PURPL-Purdue/Turbopump/README.md

#### Welcome to the TurboPump Repo

[TODO] Finish REAMDE.md
