PURPL-Purdue/Turbopump/MARLIN V2/MARLIN ECU/Hardware/README.md

# Summary
This folder will be used to store everything MARLIN hardware related
### Here you will find:
- PCB files
- Some light documentation
