PURPL-Purdue/Turbopump/MARLIN V2/MARLIN ECU/Software/README.md

# Summary
This folder will be used to store everything MARLIN software related
### Here you will find:
- Milestone projects to spin up the software crew
- Codebase for the actual MARLIN ECU
