PURPL-Purdue/Turbopump/Pump Assembly/Pumps/CFD/LoxPumpReports/LoxPump2.htm

ANSYS Logo

Title

Pump Report

Date

2025/01/10 03:52:40

# Contents

1. Pictures
Figure 1 Iso View of Wireframe
Chart 1 Component 2 blade loading chart
Chart 2 Component 2 chart showing circumferentially averaged flow angle at the LE
Chart 3 Component 2 chart showing circumferentially averaged flow angle at the TE
Chart 4 Component 2 chart showing circumferentially averaged Cm at the TE
Chart 5 Component 3 blade loading chart
Chart 6 Component 3 chart showing circumferentially averaged flow angle at the LE
Chart 7 Component 3 chart showing circumferentially averaged flow angle at the TE
Chart 8 Component 3 chart showing circumferentially averaged Cm at the TE
Chart 9 Chart showing streamwise, area averaged Cm versus averaged normalized M.
1.1. Blade Loading Charts
2. Component Charts
3. Component Summary Data
4. Introduction
5. Meanline 1-D Charts
5.1. Overall Performance Results
6. Performance Results
6.1. Spanwise Charts
6.2. Stage 1 Plots
6.3. Stage 2 Plots
6.4. Stage 3 Plots
6.5. Stage Performance Results
7. Stage Plots
Table 1 Component 1 Summary Data Table
Table 2 Component 2 Summary Data Table
Table 3 Component 3 Summary Data Table
Table 4 Overall Performance Results Table
Table 5 Stage 1 Performance Results
Table 6 Stage 2 Performance Results
Table 7 Stage 3 Performance Results
Figure 2 Complete meridional view of the flow passage and blades
Figure 3 Stage 1 contours of circumferentially area-averaged Cm
Figure 4 Stage 1 contours of circumferentially area-averaged P
Figure 5 Stage 1 contours of P at 50% span
Figure 6 Stage 1 contours of Ptr at 50% span
Figure 7 Stage 1 meridional view of the flow passage and blades
Figure 8 Stage 1 velocity vectors at 50% span
Figure 9 Stage 2 contours of circumferentially area-averaged Cm
Figure 10 Stage 2 contours of circumferentially area-averaged P
Figure 11 Stage 2 contours of P at 50% span
Figure 12 Stage 2 contours of Ptr at 50% span
Figure 13 Stage 2 meridional view of the flow passage and blades
Figure 14 Stage 2 velocity vectors at 50% span
Figure 15 Stage 3 contours of circumferentially area-averaged Cm
Figure 16 Stage 3 contours of circumferentially area-averaged P
Figure 17 Stage 3 contours of P at 50% span
Figure 18 Stage 3 contours of Ptr at 50% span
Figure 19 Stage 3 meridional view of the flow passage and blades
Figure 20 Stage 3 velocity vectors at 50% span
8. Tabulated Results
Table 8 Performance Results
Table 9 Summary Data
9. Streamwise Charts
Chart 10 Streamwise Plot of Pt and Ps
Chart 11 Streamwise Plot of C
Chart 12 Streamwise Plot of W
Chart 13 Streamwise Plot of Alpha and Beta
Chart 14 Spanwise Plot of Alpha and Beta at LE
Chart 15 Spanwise Plot of Alpha and Beta at TE
10. Blade Geometry Plots
Figure 21 Isometric 3D View of the Blade, Hub and Shroud
Figure 22 Meridional View of the Blade, Hub and Shroud
11. Blade Mesh Plot
Figure 23 Mesh Elements at 50% Span
12. Blade to Blade Plots
Figure 24 Contour of Pt at 50% Span
Figure 25 Contour of Ptr at 50% Span
Figure 26 Contour of Ps at 50% Span
Figure 27 Contour of W at 50% Span
Figure 28 Velocity Vectors at 20% Span
Figure 29 Velocity Vectors at 50% Span
Figure 30 Velocity Vectors at 80% Span
13. Meridional Plots
Figure 31 Contour of Mass Averaged Pt on Meridional Surface
Figure 32 Contour of Mass Averaged Ptr on Meridional Surface
Figure 33 Contour of Mass Averaged W on Meridional Surface
Figure 34 Vector of Area Averaged Cm on Meridional Surface
14. Circumferential Plots
Figure 35 Contour of Pt at Blade LE
Figure 36 Contour of Ptr at Blade LE
Figure 37 Contour of W at Blade LE
Figure 38 Contour of Pt at Blade TE
Figure 39 Contour of Ptr at Blade TE
Figure 40 Contour of W at Blade TE
15. Streamline Plot
Figure 41 Velocity Streamlines at Blade TE

# 1. Pictures

Figure 1. Iso View of Wireframe

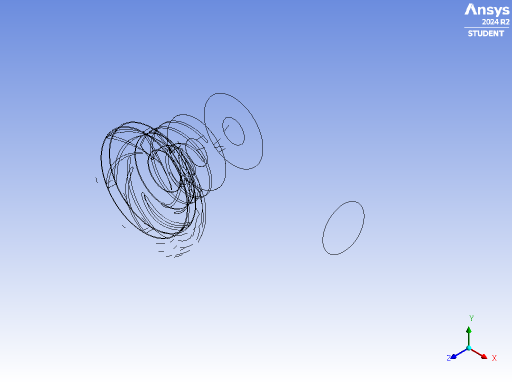
[picture p1: Pump Assembly/Pumps/CFD/LoxPumpReports/LoxPump2/Figure001.png]
Figure 1 - LoxPump2/Figure001.png


Chart 1. Component 2 blade loading chart

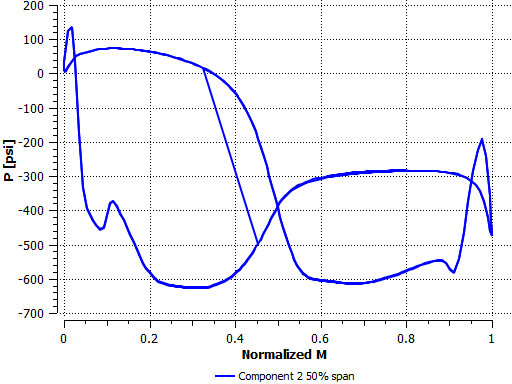
[picture p2: Pump Assembly/Pumps/CFD/LoxPumpReports/LoxPump2/Chart001.png]
Chart 1. LoxPump2/Chart001.png


Chart 2. Component 2 chart showing circumferentially averaged flow angle at the LE

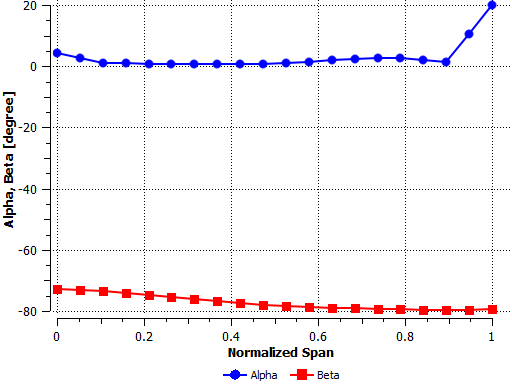
[picture p3: Pump Assembly/Pumps/CFD/LoxPumpReports/LoxPump2/Chart002.png]
Chart 2. LoxPump2/Chart002.png


Chart 3. Component 2 chart showing circumferentially averaged flow angle at the TE

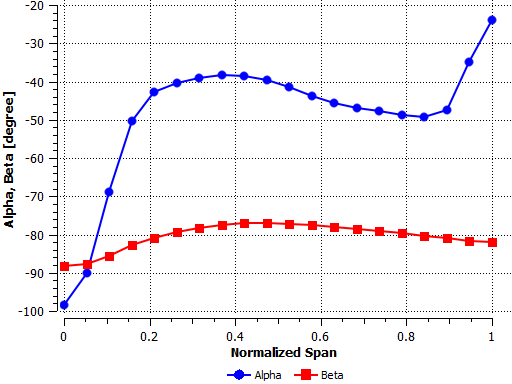
[picture p4: Pump Assembly/Pumps/CFD/LoxPumpReports/LoxPump2/Chart003.png]
Chart 3. LoxPump2/Chart003.png


Chart 4. Component 2 chart showing circumferentially averaged Cm at the TE

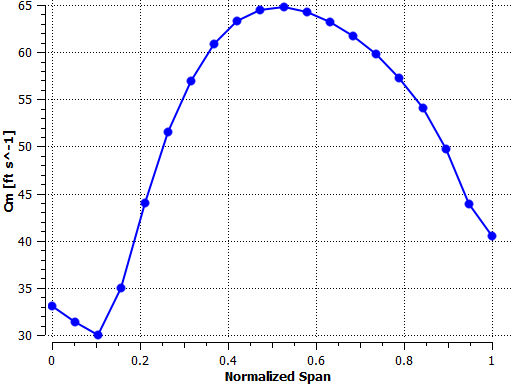
[picture p5: Pump Assembly/Pumps/CFD/LoxPumpReports/LoxPump2/Chart004.png]
Chart 4. LoxPump2/Chart004.png


Chart 5. Component 3 blade loading chart

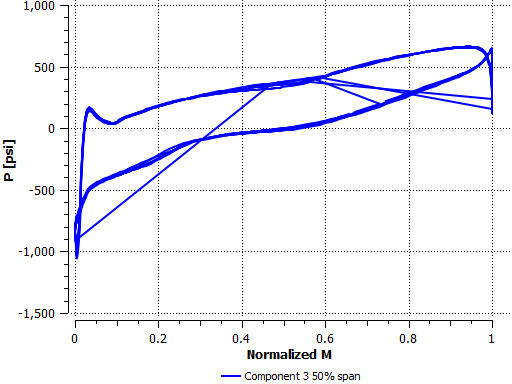
[picture p6: Pump Assembly/Pumps/CFD/LoxPumpReports/LoxPump2/Chart005.png]
Chart 5. LoxPump2/Chart005.png


Chart 6. Component 3 chart showing circumferentially averaged flow angle at the LE

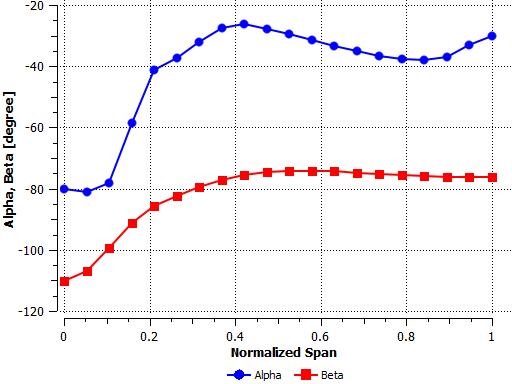
[picture p7: Pump Assembly/Pumps/CFD/LoxPumpReports/LoxPump2/Chart006.png]
Chart 6. LoxPump2/Chart006.png


Chart 7. Component 3 chart showing circumferentially averaged flow angle at the TE

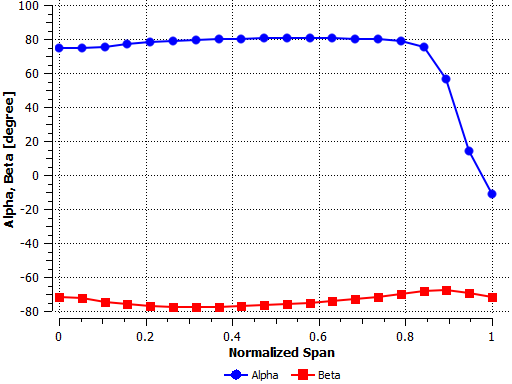
[picture p8: Pump Assembly/Pumps/CFD/LoxPumpReports/LoxPump2/Chart007.png]
Chart 7. LoxPump2/Chart007.png


Chart 8. Component 3 chart showing circumferentially averaged Cm at the TE

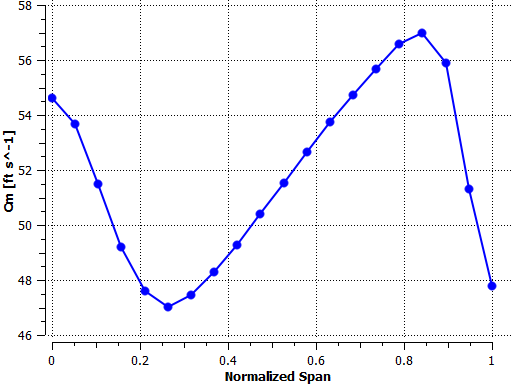
[picture p9: Pump Assembly/Pumps/CFD/LoxPumpReports/LoxPump2/Chart008.png]
Chart 8. LoxPump2/Chart008.png


Chart 9. Chart showing streamwise, area averaged Cm versus averaged normalized M.

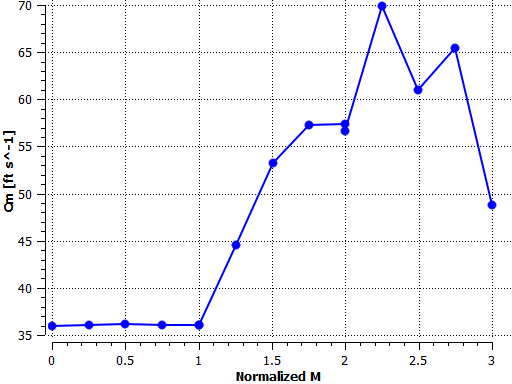
[picture p10: Pump Assembly/Pumps/CFD/LoxPumpReports/LoxPump2/Chart009.png]
Chart 9. LoxPump2/Chart009.png


## 1.1. Blade Loading Charts

The following charts show the blade loading for each component.

# 2. Component Charts

The following charts show blade loading and spanwise-averaged quantities for each component.

# 3. Component Summary Data

The table(s) below give a summary of the mass or area averaged solution variables and derived quantities computed at the inlet, leading edge (LE Cut), trailing edge (TE Cut) and outlet locations. The flow angles Alpha and Beta are relative to the meridional plane.

# 4. Introduction

This report summarizes the results of a CFD analysis performed for the pump geometry shown in Figure 1. In the following sections both quantitative and qualitative results are presented in the form of tables, charts and plots.

# 5. Meanline 1-D Charts

The following charts show streamwise mass or area averaged quantities from the inlet to the outlet of the full machine.

## 5.1. Overall Performance Results

The following table gives the overall performance for the machine.

# 6. Performance Results

The quantitative results are summarized in the following tables. The first table shows the overall performance. The next series of tables shows the performance results for each stage.

## 6.1. Spanwise Charts

The following charts show circumferentially averaged quantities along hub-to-shroud lines located at the leading and trailing edges of the blade.

## 6.2. Stage 1 Plots

## 6.3. Stage 2 Plots

## 6.4. Stage 3 Plots

## 6.5. Stage Performance Results

The following table(s) give a summary of the performance results for each stage.

# 7. Stage Plots

The following plots show, for each stage, a meridional view of the geometry, blade-to-blade contour and vector views, and circumferentially averaged meridional views.

Table 1. Component 1 Summary Data Table

Quantity | Inlet | Outlet | Out/In | Out-In | Units
Density | 71.2409 | 71.2409 | N/A | N/A | [lb ft^-3]
Pstatic | 40.0157 | 39.8570 | N/A | -0.1587 | [psi]
Ptotal | 49.9766 | 49.8830 | N/A | -0.0935 | [psi]
Head | 101.0180 | 100.8590 | N/A | -0.1586 | [foot]
Static Head | 80.8812 | 80.4489 | N/A | -0.4323 | [foot]
Cm | 35.9929 | 36.0295 | 1.0010 | 0.0366 | [ft s^-1]
Cu | -0.0033 | -0.0009 | 0.2902 | 0.0023 | [ft s^-1]
C | 35.9929 | 36.0522 | 1.0016 | 0.0593 | [ft s^-1]
Distortion Parameter | 1.0002 | 1.0099 | 1.0097 | N/A
Flow Angle | -0.0051 | -0.0036 | N/A | 0.0016 | [degree]

Table 2. Component 2 Summary Data Table

Quantity | Inlet | LE Cut | TE Cut | Outlet | TE/LE | TE-LE | Units
Density | 71.2409 | 71.2409 | 71.2409 | 71.2409 | N/A | N/A | [lb ft^-3]
Pstatic | 39.6156 | 34.3766 | -294.1310 | -305.3430 | N/A | -328.5070 | [psi]
Ptotal | 50.4130 | 50.9898 | -243.3580 | -258.1940 | N/A | -294.3480 | [psi]
Ptotal (rot) | 49.4896 | 46.0047 | -105.9780 | -147.9740 | N/A | -151.9830 | [psi]
Head | 94.5320 | 95.2258 | -471.1180 | -482.3020 | N/A | -566.3440 | [foot]
Static Head | 71.4926 | 41.7155 | -591.8800 | -612.8140 | N/A | -633.5960 | [foot]
U | 180.6370 | 181.0380 | 196.1130 | 196.3900 | 1.0833 | 15.0745 | [ft s^-1]
Cm | 36.0570 | 39.3024 | 53.2294 | 57.4638 | 1.3544 | 13.9271 | [ft s^-1]
Cu | 0.3094 | 1.5145 | -44.2286 | -32.6444 | -29.2037 | -45.7431 | [ft s^-1]
C | 37.0120 | 41.3574 | 77.1317 | 73.4371 | 1.8650 | 35.7742 | [ft s^-1]
Wu | -180.3270 | -179.5340 | -240.3460 | -229.0340 | 1.3387 | -60.8112 | [ft s^-1]
W | 184.0860 | 184.7190 | 246.5700 | 236.6010 | 1.3348 | 61.8512 | [ft s^-1]
Distortion Parameter | 1.0771 | 2.1808 | 1.2824 | 1.4076 | 0.5880 | N/A
Flow Angle: Alpha | 2.3408 | 2.9190 | -46.7442 | -55.9161 | N/A | -49.6631 | [degree]
Flow Angle: Beta | -78.1756 | -77.8463 | -80.0170 | -80.7738 | N/A | -2.1707 | [degree]

Table 3. Component 3 Summary Data Table

Quantity | Inlet | LE Cut | TE Cut | Outlet | TE/LE | TE-LE | Units
Density | 71.2409 | 71.2409 | 71.2409 | 71.2409 | N/A | N/A | [lb ft^-3]
Pstatic | -304.6510 | -318.3040 | 597.6710 | 605.9320 | N/A | 915.9740 | [psi]
Ptotal | -261.4950 | -238.3960 | 979.7860 | 944.6200 | N/A | 1218.1800 | [psi]
Ptotal (rot) | -150.0780 | -190.7110 | -192.4060 | -176.4960 | N/A | -1.6949 | [psi]
Head | -506.5990 | -533.4460 | 2014.9300 | 2012.3000 | N/A | 2548.3800 | [foot]
Static Head | -619.0860 | -644.7310 | 1234.7400 | 1257.2500 | N/A | 1879.4700 | [foot]
U | 196.3600 | 203.1260 | 357.3700 | 362.7190 | 1.7593 | 154.2440 | [ft s^-1]
Cm | 56.6264 | 71.5496 | 51.8658 | 48.0820 | 0.7249 | -19.6838 | [ft s^-1]
Cu | -32.7194 | -9.8216 | 213.3190 | 201.0110 | -21.7195 | 223.1410 | [ft s^-1]
C | 71.4008 | 93.4456 | 220.6500 | 207.1870 | 2.3613 | 127.2040 | [ft s^-1]
Wu | -229.0790 | -212.9500 | -144.0510 | -161.7080 | 0.6765 | 68.8991 | [ft s^-1]
W | 236.1440 | 228.2800 | 154.7320 | 170.0860 | 0.6778 | -73.5481 | [ft s^-1]
Distortion Parameter | 1.2857 | 1.6103 | 1.0626 | 1.0762 | 0.6599 | N/A
Flow Angle: Alpha | -54.7117 | -40.5014 | 71.6694 | 73.4349 | N/A | 112.1710 | [degree]
Flow Angle: Beta | -80.6104 | -80.7847 | -73.8555 | -75.4864 | N/A | 6.9292 | [degree]

Table 4. Overall Performance Results Table

Inlet Volume Flow Rate | 1.2896 | [foot^3 s^-1]
Reference Density | 71.2409 | [lb ft^-3]
Head Rise | 1911.2900 | [foot]
Input Power | 86.8459 | [HP]

Table 5. Stage 1 Performance Results

Inlet Volume Flow Rate | 1.2896 | [foot^3 s^-1]
Reference Density | 71.2409 | [lb ft^-3]
Head Loss | 0.1586 | [foot]
Loss Coefficient, Y1 | 0.0019
Loss Coefficient, Y2 | 0.0019
Loss Coefficient, Y3 | 0.0094
Loss Coefficient, Y4 | 0.0093
Diffuser Cp | -0.0159

Table 6. Stage 2 Performance Results

Rotation Speed | -50000.0000 | [rev min^-1]
Inlet Volume Flow Rate | 0.2149 | [foot^3 s^-1]
Reference Density | 71.2409 | [lb ft^-3]
Reference Diameter | 0.0375 | [foot]
Input Power | 9.7685 | [HP]
Capacity Coefficient | 0.7810
Head Coefficient | -0.4826
Power Coefficient | 0.2293
Total-to-Total Head | -576.8340 | [foot]
Total-to-Static Head | -707.3460 | [foot]
Total-to-Total Efficiency % | -177.7150
Total-to-Static Efficiency % | -204.8660
Diffuser Loss Coef., Y1 | -0.0610
Diffuser Loss Coef., Y2 | -0.0575
Diffuser Loss Coef., Y3 | 0.2922
Diffuser Loss Coef., Y4 | 0.3146
Diffuser Cp | -0.2208

Table 7. Stage 3 Performance Results

Rotation Speed | -50000.0000 | [rev min^-1]
Inlet Volume Flow Rate | 0.2150 | [foot^3 s^-1]
Reference Density | 71.2409 | [lb ft^-3]
Reference Diameter | 0.0683 | [foot]
Input Power | 77.0774 | [HP]
Capacity Coefficient | 0.1291
Head Coefficient | 0.6346
Power Coefficient | 0.0900
Total-to-Total Head | 2518.9000 | [foot]
Total-to-Static Head | 1763.8500 | [foot]
Total-to-Total Efficiency % | 88.0673
Total-to-Static Efficiency % | 63.3372
Diffuser Loss Coef., Y1 | 0.0359
Diffuser Loss Coef., Y2 | 0.0372
Diffuser Loss Coef., Y3 | 0.0920
Diffuser Loss Coef., Y4 | 0.1038
Diffuser Cp | 0.0216

Figure 2. Complete meridional view of the flow passage and blades

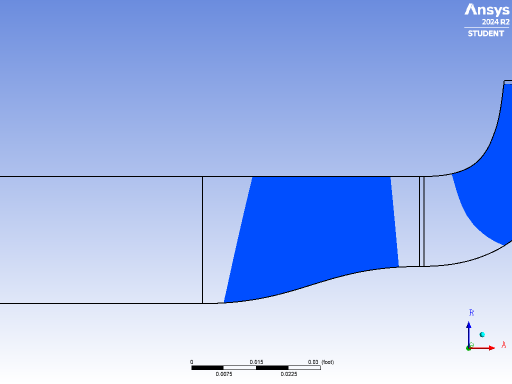
[picture p11: Pump Assembly/Pumps/CFD/LoxPumpReports/LoxPump2/Figure002.png]
Figure 2 - LoxPump2/Figure002.png


Figure 3. Stage 1 contours of circumferentially area-averaged Cm

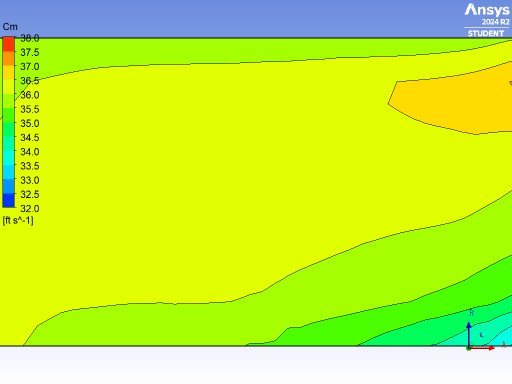
[picture p12: Pump Assembly/Pumps/CFD/LoxPumpReports/LoxPump2/Figure003.png]
Figure 3 - LoxPump2/Figure003.png


Figure 4. Stage 1 contours of circumferentially area-averaged P

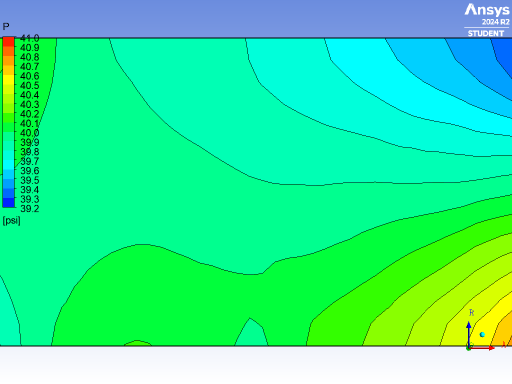
[picture p13: Pump Assembly/Pumps/CFD/LoxPumpReports/LoxPump2/Figure004.png]
Figure 4 - LoxPump2/Figure004.png


Figure 5. Stage 1 contours of P at 50% span

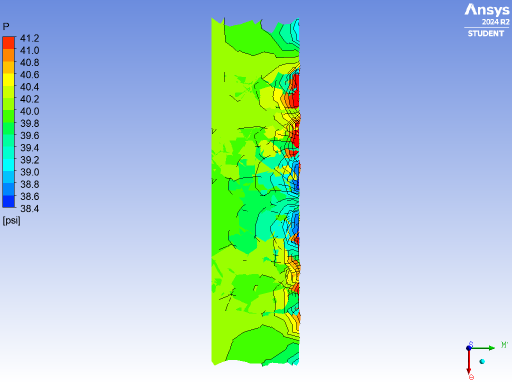
[picture p14: Pump Assembly/Pumps/CFD/LoxPumpReports/LoxPump2/Figure005.png]
Figure 5 - LoxPump2/Figure005.png


Figure 6. Stage 1 contours of Ptr at 50% span

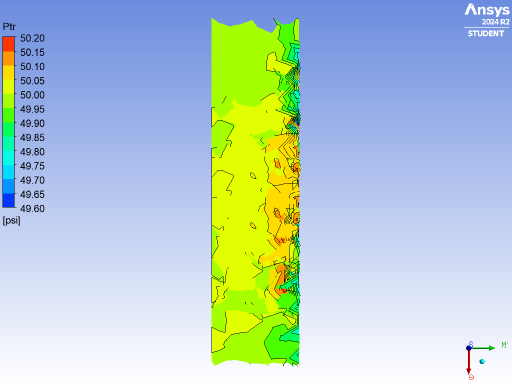
[picture p15: Pump Assembly/Pumps/CFD/LoxPumpReports/LoxPump2/Figure006.png]
Figure 6 - LoxPump2/Figure006.png


Figure 7. Stage 1 meridional view of the flow passage and blades

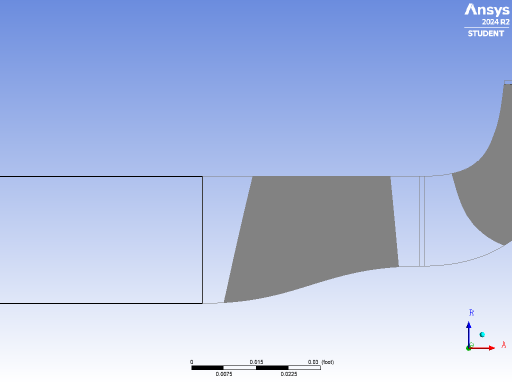
[picture p16: Pump Assembly/Pumps/CFD/LoxPumpReports/LoxPump2/Figure007.png]
Figure 7 - LoxPump2/Figure007.png


Figure 8. Stage 1 velocity vectors at 50% span

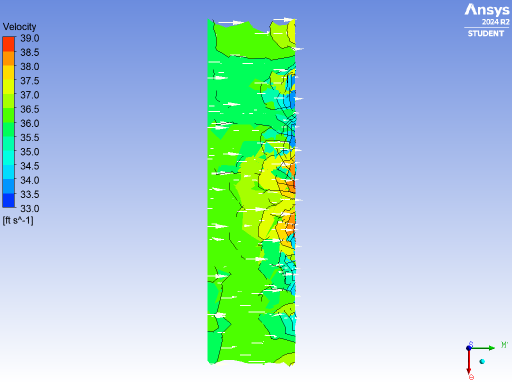
[picture p17: Pump Assembly/Pumps/CFD/LoxPumpReports/LoxPump2/Figure008.png]
Figure 8 - LoxPump2/Figure008.png


Figure 9. Stage 2 contours of circumferentially area-averaged Cm

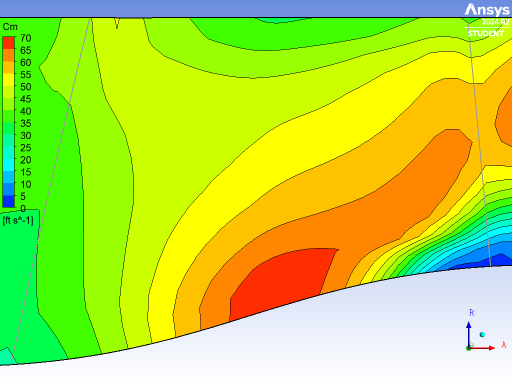
[picture p18: Pump Assembly/Pumps/CFD/LoxPumpReports/LoxPump2/Figure009.png]
Figure 9 - LoxPump2/Figure009.png


Figure 10. Stage 2 contours of circumferentially area-averaged P

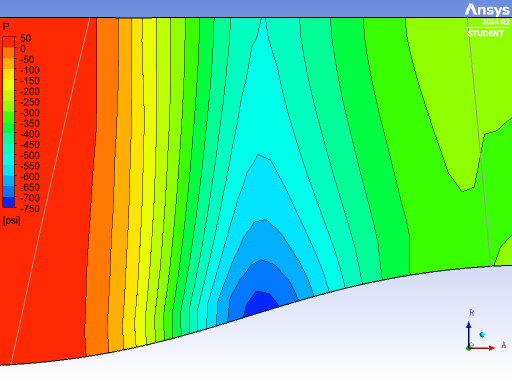
[picture p19: Pump Assembly/Pumps/CFD/LoxPumpReports/LoxPump2/Figure010.png]
Figure 10 - LoxPump2/Figure010.png


Figure 11. Stage 2 contours of P at 50% span

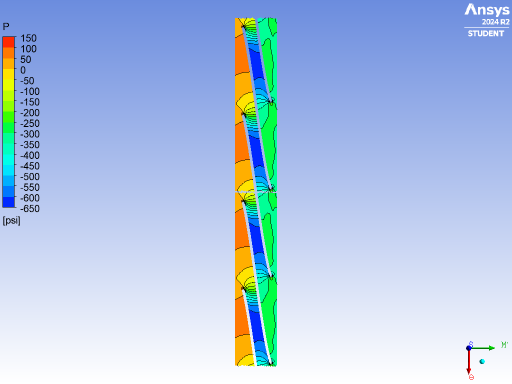
[picture p20: Pump Assembly/Pumps/CFD/LoxPumpReports/LoxPump2/Figure011.png]
Figure 11 - LoxPump2/Figure011.png


Figure 12. Stage 2 contours of Ptr at 50% span

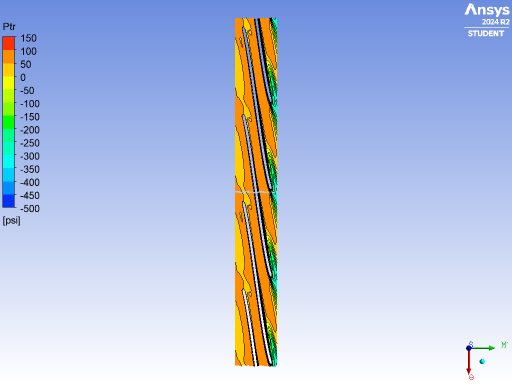
[picture p21: Pump Assembly/Pumps/CFD/LoxPumpReports/LoxPump2/Figure012.png]
Figure 12 - LoxPump2/Figure012.png


Figure 13. Stage 2 meridional view of the flow passage and blades

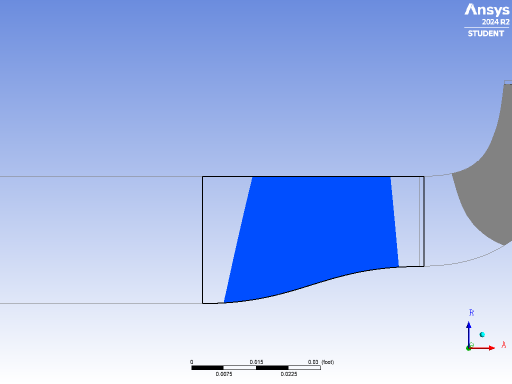
[picture p22: Pump Assembly/Pumps/CFD/LoxPumpReports/LoxPump2/Figure013.png]
Figure 13 - LoxPump2/Figure013.png


Figure 14. Stage 2 velocity vectors at 50% span

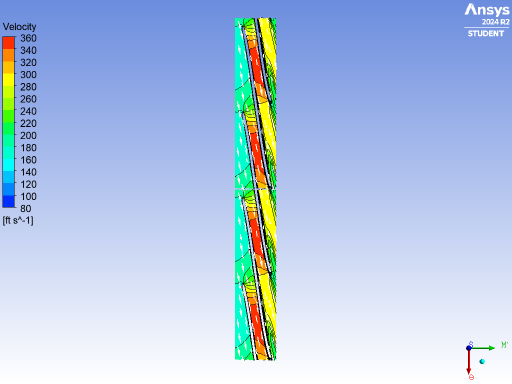
[picture p23: Pump Assembly/Pumps/CFD/LoxPumpReports/LoxPump2/Figure014.png]
Figure 14 - LoxPump2/Figure014.png


Figure 15. Stage 3 contours of circumferentially area-averaged Cm

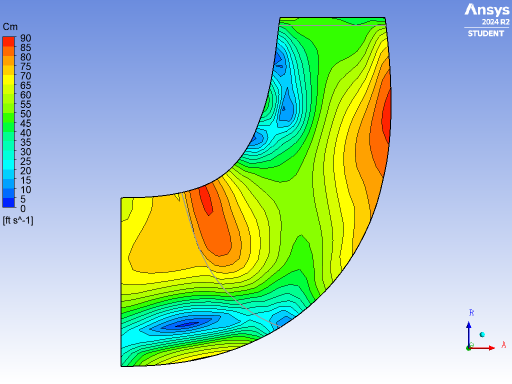
[picture p24: Pump Assembly/Pumps/CFD/LoxPumpReports/LoxPump2/Figure015.png]
Figure 15 - LoxPump2/Figure015.png


Figure 16. Stage 3 contours of circumferentially area-averaged P

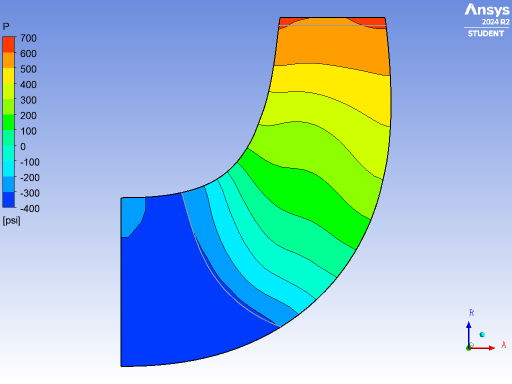
[picture p25: Pump Assembly/Pumps/CFD/LoxPumpReports/LoxPump2/Figure016.png]
Figure 16 - LoxPump2/Figure016.png


Figure 17. Stage 3 contours of P at 50% span

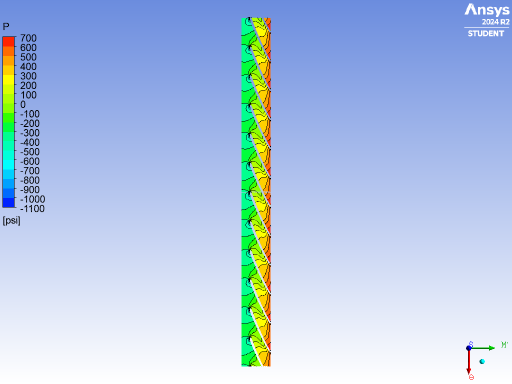
[picture p26: Pump Assembly/Pumps/CFD/LoxPumpReports/LoxPump2/Figure017.png]
Figure 17 - LoxPump2/Figure017.png


Figure 18. Stage 3 contours of Ptr at 50% span

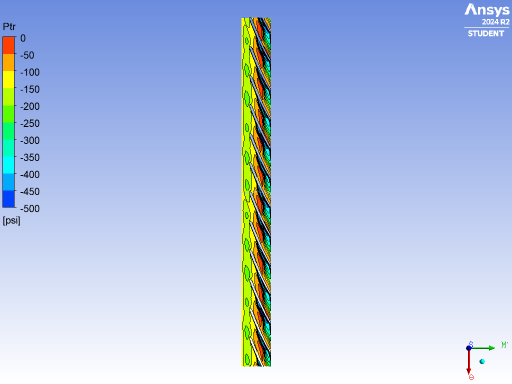
[picture p27: Pump Assembly/Pumps/CFD/LoxPumpReports/LoxPump2/Figure018.png]
Figure 18 - LoxPump2/Figure018.png


Figure 19. Stage 3 meridional view of the flow passage and blades

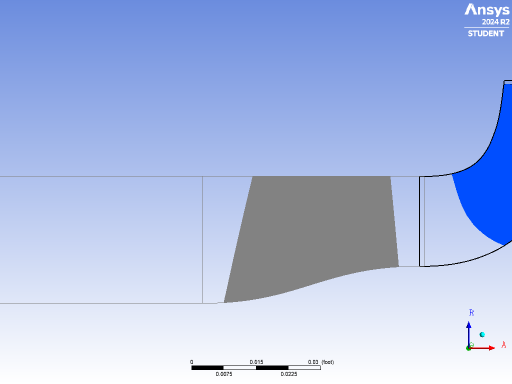
[picture p28: Pump Assembly/Pumps/CFD/LoxPumpReports/LoxPump2/Figure019.png]
Figure 19 - LoxPump2/Figure019.png


Figure 20. Stage 3 velocity vectors at 50% span

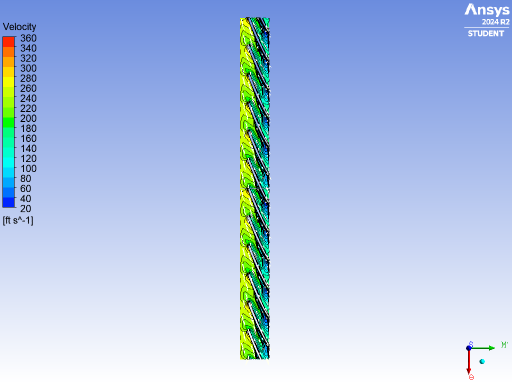
[picture p29: Pump Assembly/Pumps/CFD/LoxPumpReports/LoxPump2/Figure020.png]
Figure 20 - LoxPump2/Figure020.png


# 8. Tabulated Results

The first table below gives a summary of the performance results for the pump impeller. The second table lists the mass or area averaged solution variables and derived quantities computed at the inlet, leading edge (LE Cut), trailing edge (TE Cut) and outlet locations. The flow angles Alpha and Beta are relative to the meridional plane; a positive angle implies that the tangential velocity is the same direction as the machine rotation.

Table 8. Performance Results

Rotation Speed | -50000.0000 | [rev min^-1]
Reference Diameter | 0.0749 | [foot]
Volume Flow Rate | 0.2149 | [foot^3 s^-1]
Head (LE-TE) | -566.3440 | [foot]
Head (IN-OUT) | -576.8340 | [foot]
Flow Coefficient | 0.0976
Head Coefficient (IN-OUT) | -0.1206
Shaft Power | 9.7685 | [HP]
Power Coefficient | 0.0072
Total Efficiency (IN-OUT) % | -164.3370
Static Efficiency (IN-OUT) % | -201.5190

Table 9. Summary Data

Quantity | Inlet | LE Cut | TE Cut | Outlet | TE/LE | TE-LE | Units
Density | 71.2409 | 71.2409 | 71.2409 | 71.2409 | 1.0000 | 0.0000 | [lb ft^-3]
Pstatic | 39.6156 | 34.3766 | -294.1310 | -305.3430 | -8.5561 | -328.5070 | [psi]
Ptotal | 46.7677 | 47.1109 | -233.0750 | -238.6090 | -4.9474 | -280.1860 | [psi]
Ptotal (rot) | 49.7720 | 46.8205 | -53.0542 | -63.4897 | -1.1331 | -99.8746 | [psi]
U | 180.6370 | 181.0380 | 196.1130 | 196.3900 | 1.0833 | 15.0745 | [ft s^-1]
Cm | 36.0570 | 39.3024 | 53.2294 | 57.4638 | 1.3544 | 13.9271 | [ft s^-1]
Cu | -0.3094 | -1.5145 | 44.2286 | 32.6444 | -29.2037 | 45.7431 | [ft s^-1]
C | 37.0120 | 41.3574 | 77.1317 | 73.4371 | 1.8650 | 35.7742 | [ft s^-1]
Distortion Parameter | 1.0771 | 2.1808 | 1.2824 | 1.4076 | 0.5880 | -0.8984
Flow Angle: Alpha | 2.3408 | 2.9190 | -46.7442 | -55.9161 | -16.0139 | -49.6631 | [degree]
Wu | 180.3270 | 179.5340 | 240.3460 | 229.0340 | 1.3387 | 60.8112 | [ft s^-1]
W | 184.0860 | 184.7190 | 246.5700 | 236.6010 | 1.3348 | 61.8512 | [ft s^-1]
Flow Angle: Beta | -78.1756 | -77.8463 | -80.0170 | -80.7738 | 1.0279 | -2.1707 | [degree]

# 9. Streamwise Charts

Chart 10. Streamwise Plot of Pt and Ps

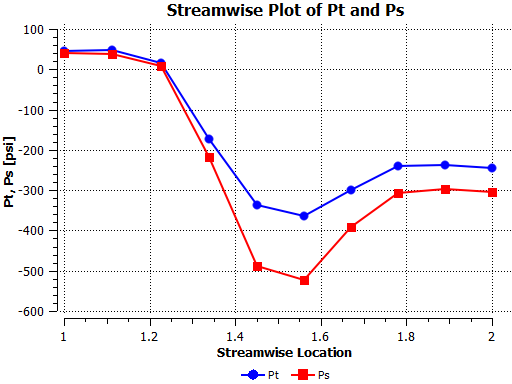
[picture p30: Pump Assembly/Pumps/CFD/LoxPumpReports/LoxPump2/Chart010.png]
Chart 10. LoxPump2/Chart010.png


Chart 11. Streamwise Plot of C

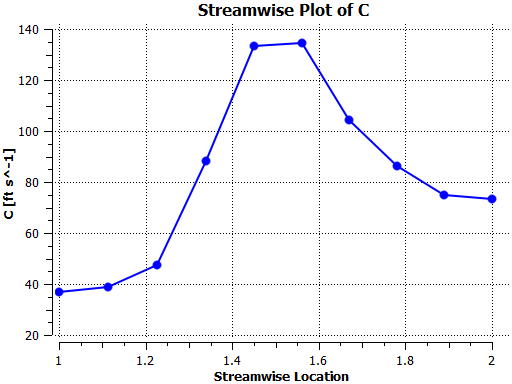
[picture p31: Pump Assembly/Pumps/CFD/LoxPumpReports/LoxPump2/Chart011.png]
Chart 11. LoxPump2/Chart011.png


Chart 12. Streamwise Plot of W

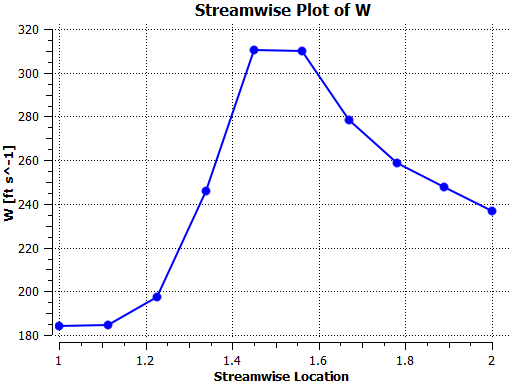
[picture p32: Pump Assembly/Pumps/CFD/LoxPumpReports/LoxPump2/Chart012.png]
Chart 12. LoxPump2/Chart012.png


Chart 13. Streamwise Plot of Alpha and Beta

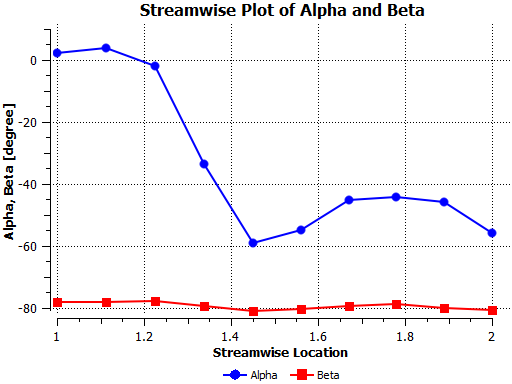
[picture p33: Pump Assembly/Pumps/CFD/LoxPumpReports/LoxPump2/Chart013.png]
Chart 13. LoxPump2/Chart013.png


Chart 14. Spanwise Plot of Alpha and Beta at LE

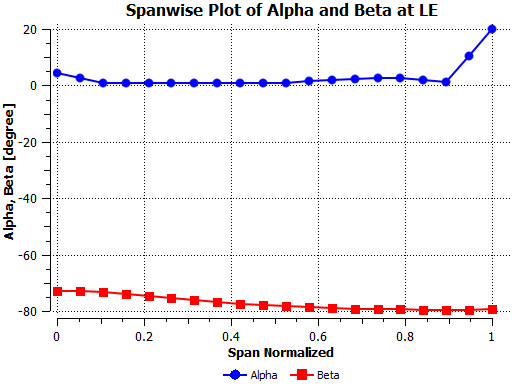
[picture p34: Pump Assembly/Pumps/CFD/LoxPumpReports/LoxPump2/Chart014.png]
Chart 14. LoxPump2/Chart014.png


Chart 15. Spanwise Plot of Alpha and Beta at TE

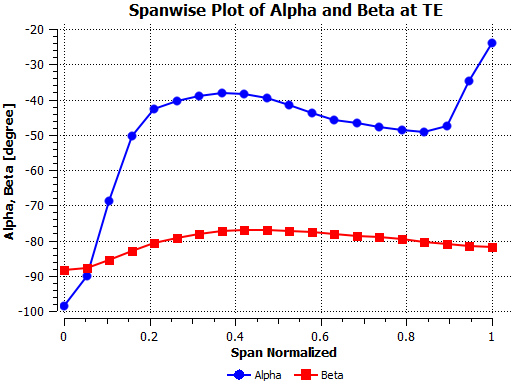
[picture p35: Pump Assembly/Pumps/CFD/LoxPumpReports/LoxPump2/Chart015.png]
Chart 15. LoxPump2/Chart015.png


# 10. Blade Geometry Plots

Figure 21. Isometric 3D View of the Blade, Hub and Shroud

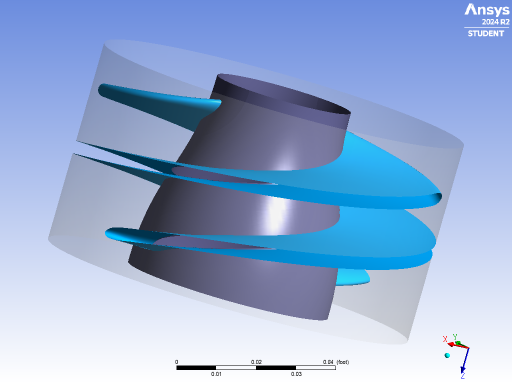
[picture p36: Pump Assembly/Pumps/CFD/LoxPumpReports/LoxPump2/Figure021.png]
Figure 21 - LoxPump2/Figure021.png


Figure 22. Meridional View of the Blade, Hub and Shroud

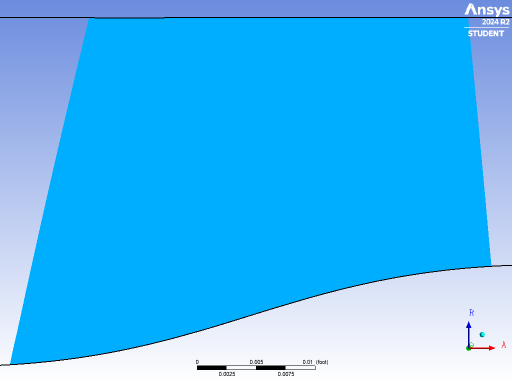
[picture p37: Pump Assembly/Pumps/CFD/LoxPumpReports/LoxPump2/Figure022.png]
Figure 22 - LoxPump2/Figure022.png


# 11. Blade Mesh Plot

Figure 23. Mesh Elements at 50% Span

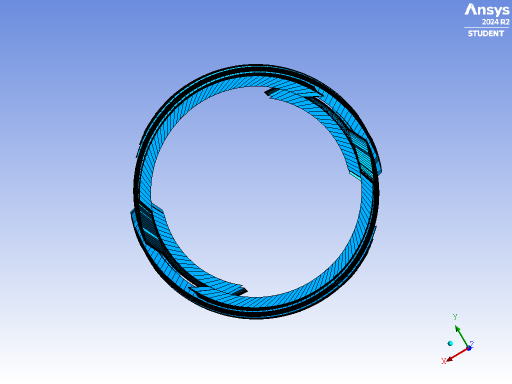
[picture p38: Pump Assembly/Pumps/CFD/LoxPumpReports/LoxPump2/Figure023.png]
Figure 23 - LoxPump2/Figure023.png


# 12. Blade to Blade Plots

Figure 24. Contour of Pt at 50% Span

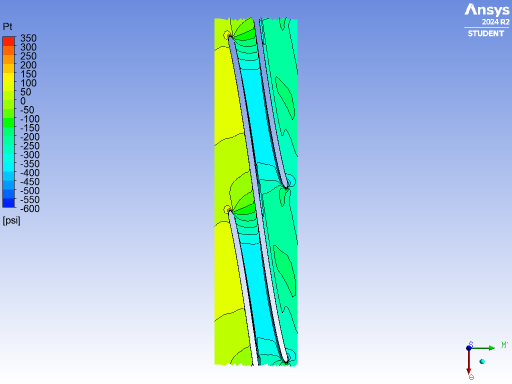
[picture p39: Pump Assembly/Pumps/CFD/LoxPumpReports/LoxPump2/Figure024.png]
Figure 24 - LoxPump2/Figure024.png


Figure 25. Contour of Ptr at 50% Span

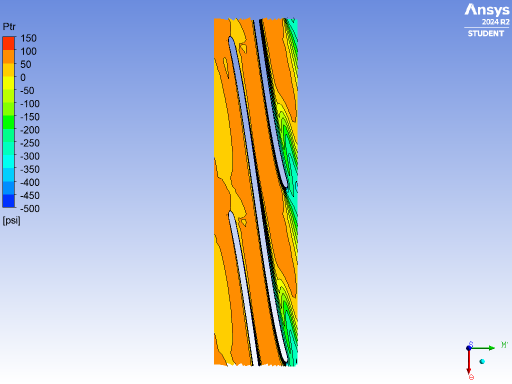
[picture p40: Pump Assembly/Pumps/CFD/LoxPumpReports/LoxPump2/Figure025.png]
Figure 25 - LoxPump2/Figure025.png


Figure 26. Contour of Ps at 50% Span

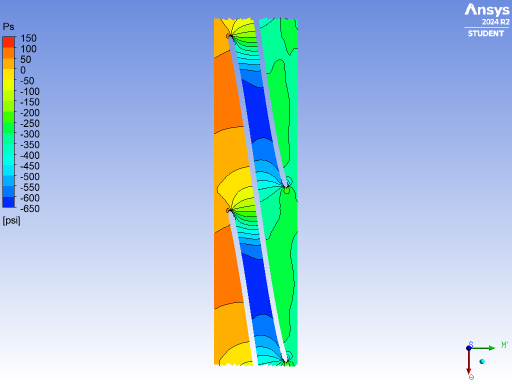
[picture p41: Pump Assembly/Pumps/CFD/LoxPumpReports/LoxPump2/Figure026.png]
Figure 26 - LoxPump2/Figure026.png


Figure 27. Contour of W at 50% Span

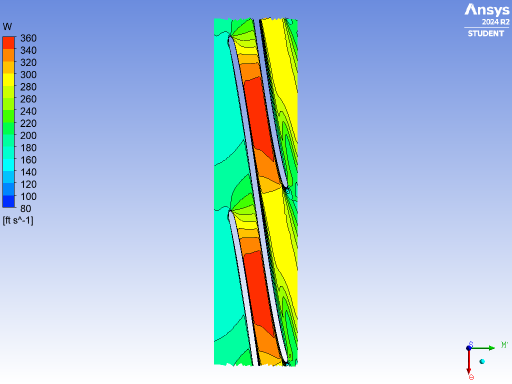
[picture p42: Pump Assembly/Pumps/CFD/LoxPumpReports/LoxPump2/Figure027.png]
Figure 27 - LoxPump2/Figure027.png


Figure 28. Velocity Vectors at 20% Span

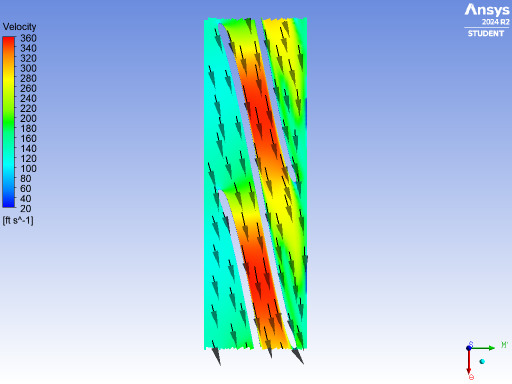
[picture p43: Pump Assembly/Pumps/CFD/LoxPumpReports/LoxPump2/Figure028.png]
Figure 28 - LoxPump2/Figure028.png


Figure 29. Velocity Vectors at 50% Span

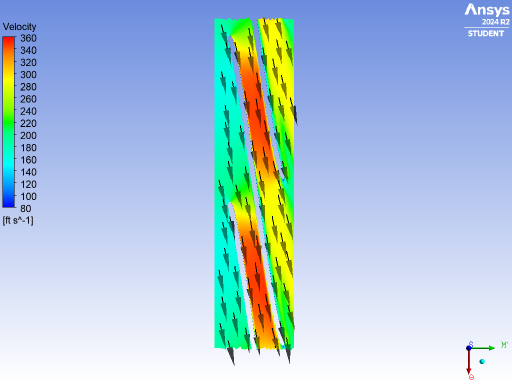
[picture p44: Pump Assembly/Pumps/CFD/LoxPumpReports/LoxPump2/Figure029.png]
Figure 29 - LoxPump2/Figure029.png


Figure 30. Velocity Vectors at 80% Span

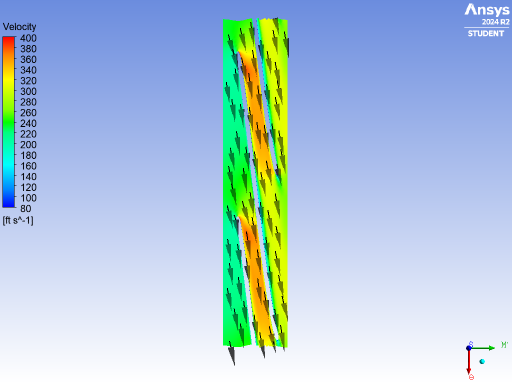
[picture p45: Pump Assembly/Pumps/CFD/LoxPumpReports/LoxPump2/Figure030.png]
Figure 30 - LoxPump2/Figure030.png


# 13. Meridional Plots

Figure 31. Contour of Mass Averaged Pt on Meridional Surface

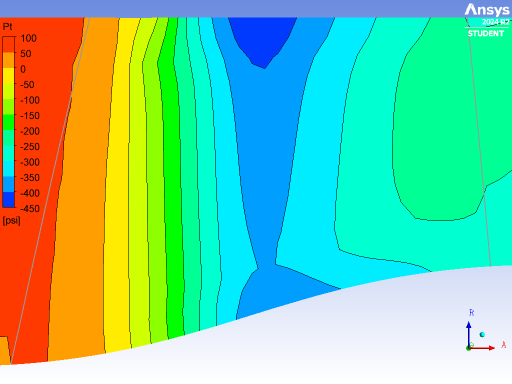
[picture p46: Pump Assembly/Pumps/CFD/LoxPumpReports/LoxPump2/Figure031.png]
Figure 31 - LoxPump2/Figure031.png


Figure 32. Contour of Mass Averaged Ptr on Meridional Surface

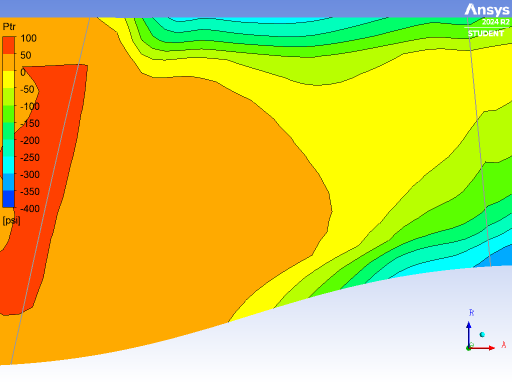
[picture p47: Pump Assembly/Pumps/CFD/LoxPumpReports/LoxPump2/Figure032.png]
Figure 32 - LoxPump2/Figure032.png


Figure 33. Contour of Mass Averaged W on Meridional Surface

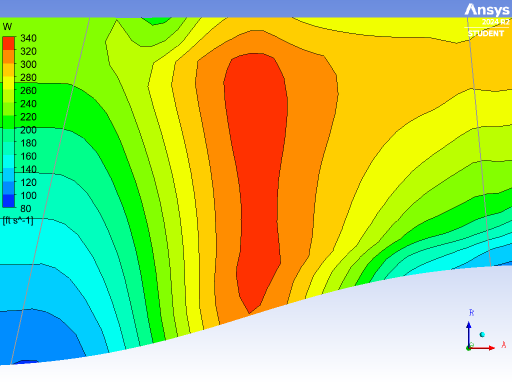
[picture p48: Pump Assembly/Pumps/CFD/LoxPumpReports/LoxPump2/Figure033.png]
Figure 33 - LoxPump2/Figure033.png


Figure 34. Vector of Area Averaged Cm on Meridional Surface

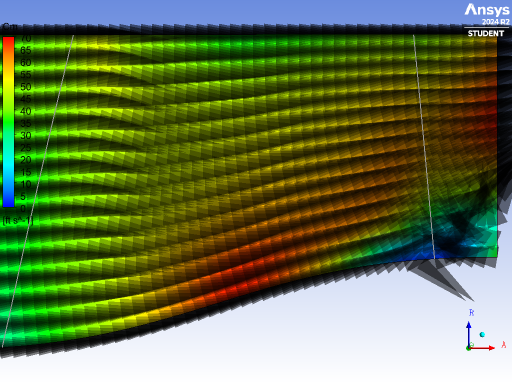
[picture p49: Pump Assembly/Pumps/CFD/LoxPumpReports/LoxPump2/Figure034.png]
Figure 34 - LoxPump2/Figure034.png


# 14. Circumferential Plots

Figure 35. Contour of Pt at Blade LE

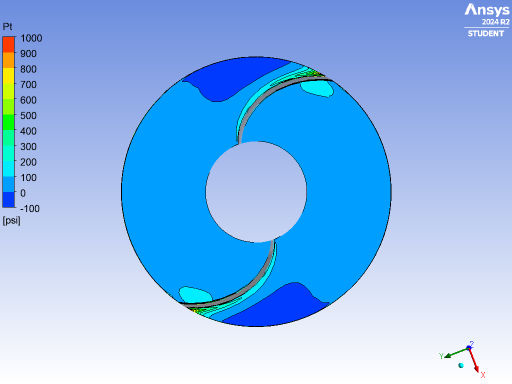
[picture p50: Pump Assembly/Pumps/CFD/LoxPumpReports/LoxPump2/Figure035.png]
Figure 35 - LoxPump2/Figure035.png


Figure 36. Contour of Ptr at Blade LE

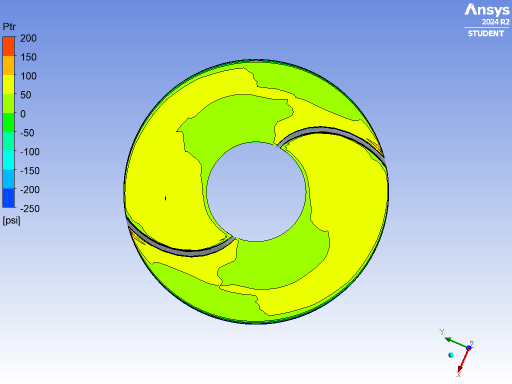
[picture p51: Pump Assembly/Pumps/CFD/LoxPumpReports/LoxPump2/Figure036.png]
Figure 36 - LoxPump2/Figure036.png


Figure 37. Contour of W at Blade LE

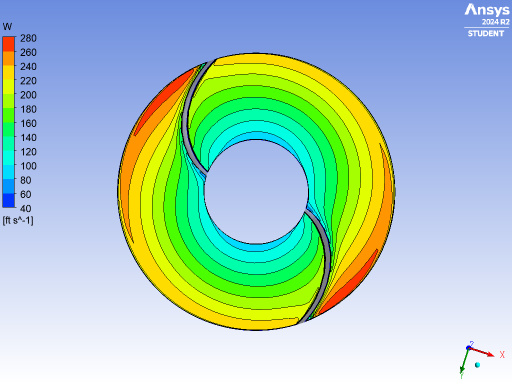
[picture p52: Pump Assembly/Pumps/CFD/LoxPumpReports/LoxPump2/Figure037.png]
Figure 37 - LoxPump2/Figure037.png


Figure 38. Contour of Pt at Blade TE

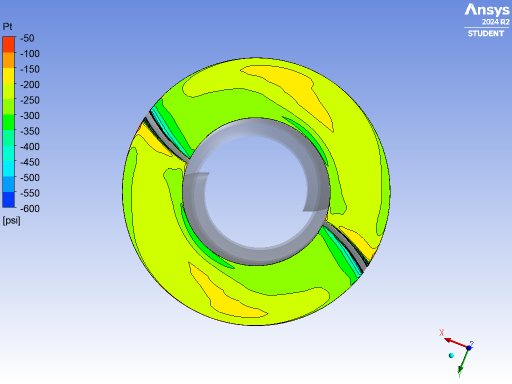
[picture p53: Pump Assembly/Pumps/CFD/LoxPumpReports/LoxPump2/Figure038.png]
Figure 38 - LoxPump2/Figure038.png


Figure 39. Contour of Ptr at Blade TE

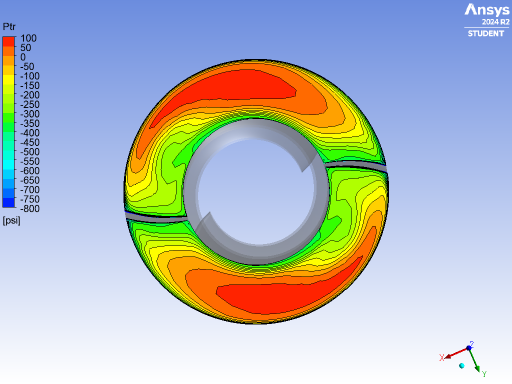
[picture p54: Pump Assembly/Pumps/CFD/LoxPumpReports/LoxPump2/Figure039.png]
Figure 39 - LoxPump2/Figure039.png


Figure 40. Contour of W at Blade TE

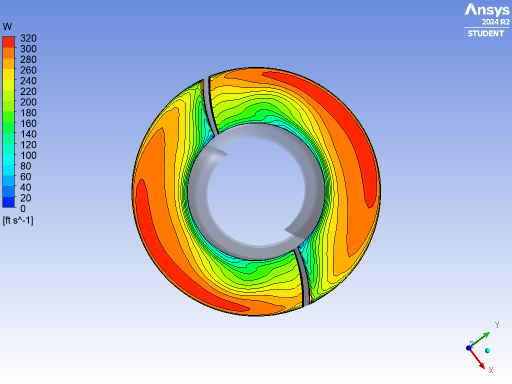
[picture p55: Pump Assembly/Pumps/CFD/LoxPumpReports/LoxPump2/Figure040.png]
Figure 40 - LoxPump2/Figure040.png


# 15. Streamline Plot

Figure 41. Velocity Streamlines at Blade TE

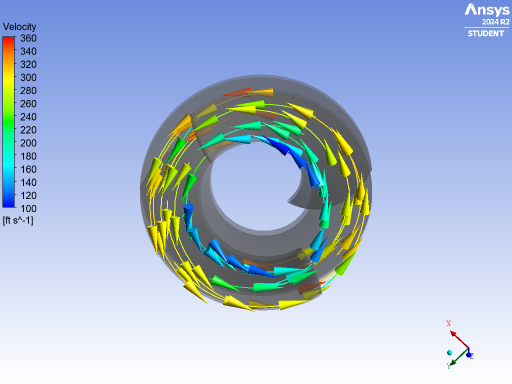
[picture p56: Pump Assembly/Pumps/CFD/LoxPumpReports/LoxPump2/Figure041.png]
Figure 41 - LoxPump2/Figure041.png
