PURPL-Purdue/Turbopump/Pump Assembly/Pumps/CFD/LoxPumpReports/LoxPump1.html

ANSYS Logo

Title

Pump Report

Date

2025/01/10 02:45:59

# Contents

1. Introduction
Figure 1 Complete meridional view of the flow passage and blades
2. Performance Results
2.1. Overall Performance Results
Table 1 Overall Performance Results Table
2.2. Stage Performance Results
Table 2 Stage 1 Performance Results
3. Component Summary Data
Table 3 Component 1 Summary Data Table
4. Meanline 1-D Charts
Chart 1 Chart showing streamwise, area averaged Cm versus averaged normalized M.
5. Stage Plots
5.1. Stage 1 Plots
Figure 2 Stage 1 meridional view of the flow passage and blades
Figure 3 Stage 1 contours of P at 50% span
Figure 4 Stage 1 velocity vectors at 50% span
Figure 5 Stage 1 contours of Ptr at 50% span
Figure 6 Stage 1 contours of circumferentially area-averaged P
Figure 7 Stage 1 contours of circumferentially area-averaged Cm
6. Component Charts
6.1. Blade Loading Charts
6.2. Spanwise Charts
Table 4 Stage 2 Performance Results
Table 5 Stage 3 Performance Results
Table 6 Component 2 Summary Data Table
Table 7 Component 3 Summary Data Table
6.3. Stage 2 Plots
Figure 8 Stage 2 meridional view of the flow passage and blades
Figure 9 Stage 2 contours of P at 50% span
Figure 10 Stage 2 velocity vectors at 50% span
Figure 11 Stage 2 contours of Ptr at 50% span
Figure 12 Stage 2 contours of circumferentially area-averaged P
Figure 13 Stage 2 contours of circumferentially area-averaged Cm
6.4. Stage 3 Plots
Figure 14 Stage 3 meridional view of the flow passage and blades
Figure 15 Stage 3 contours of P at 50% span
Figure 16 Stage 3 velocity vectors at 50% span
Figure 17 Stage 3 contours of Ptr at 50% span
Figure 18 Stage 3 contours of circumferentially area-averaged P
Figure 19 Stage 3 contours of circumferentially area-averaged Cm
Chart 2 Component 2 blade loading chart
Chart 3 Component 3 blade loading chart
Chart 4 Component 2 chart showing circumferentially averaged flow angle at the LE
Chart 5 Component 2 chart showing circumferentially averaged flow angle at the TE
Chart 6 Component 2 chart showing circumferentially averaged Cm at the TE
Chart 7 Component 3 chart showing circumferentially averaged flow angle at the LE
Chart 8 Component 3 chart showing circumferentially averaged flow angle at the TE
Chart 9 Component 3 chart showing circumferentially averaged Cm at the TE

# 1. Introduction

This report summarizes the results of a CFD analysis performed for the pump geometry shown in Figure 1. In the following sections both quantitative and qualitative results are presented in the form of tables, charts and plots.

Figure 1. Complete meridional view of the flow passage and blades

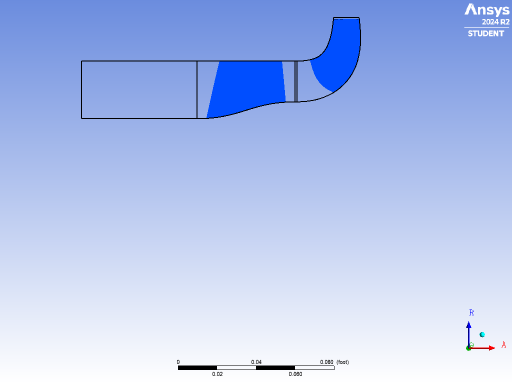
[picture p57: Pump Assembly/Pumps/CFD/LoxPumpReports/LoxPump1/Figure001.png]
Figure 1 - LoxPump1/Figure001.png


# 2. Performance Results

The quantitative results are summarized in the following tables. The first table shows the overall performance. The next series of tables shows the performance results for each stage.

## 2.1. Overall Performance Results

The following table gives the overall performance for the machine.

Table 1. Overall Performance Results Table

Inlet Volume Flow Rate | 1.2896 | [foot^3 s^-1]
Reference Density | 71.2409 | [lb ft^-3]
Head Rise | 1880.7100 | [foot]
Input Power | 477.9080 | [HP]

## 2.2. Stage Performance Results

The following table(s) give a summary of the performance results for each stage.

Table 2. Stage 1 Performance Results

Inlet Volume Flow Rate | 1.2896 | [foot^3 s^-1]
Reference Density | 71.2409 | [lb ft^-3]
Head Loss | -0.0849 | [foot]
Loss Coefficient, Y1 | 0.0002
Loss Coefficient, Y2 | 0.0002
Loss Coefficient, Y3 | 0.0012
Loss Coefficient, Y4 | 0.0012
Diffuser Cp | -0.0103

# 3. Component Summary Data

The table(s) below give a summary of the mass or area averaged solution variables and derived quantities computed at the inlet, leading edge (LE Cut), trailing edge (TE Cut) and outlet locations. The flow angles Alpha and Beta are relative to the meridional plane.

Table 3. Component 1 Summary Data Table

Quantity | Inlet | Outlet | Out/In | Out-In | Units
Density | 71.2409 | 71.2409 | N/A | N/A | [lb ft^-3]
Pstatic | 40.0096 | 39.9067 | N/A | -0.1030 | [psi]
Ptotal | 49.9822 | 49.9704 | N/A | -0.0118 | [psi]
Head | 101.0290 | 101.1140 | N/A | 0.0849 | [foot]
Static Head | 80.8570 | 80.4538 | N/A | -0.4031 | [foot]
Cm | 36.0090 | 35.9635 | 0.9987 | -0.0454 | [ft s^-1]
Cu | -0.0048 | 0.2846 | -59.0558 | 0.2894 | [ft s^-1]
C | 36.0090 | 36.0459 | 1.0010 | 0.0369 | [ft s^-1]
Distortion Parameter | 1.0011 | 1.0226 | 1.0215 | N/A
Flow Angle | -0.0077 | 0.4947 | N/A | 0.5024 | [degree]

# 4. Meanline 1-D Charts

The following charts show streamwise mass or area averaged quantities from the inlet to the outlet of the full machine.

Chart 1. Chart showing streamwise, area averaged Cm versus averaged normalized M.

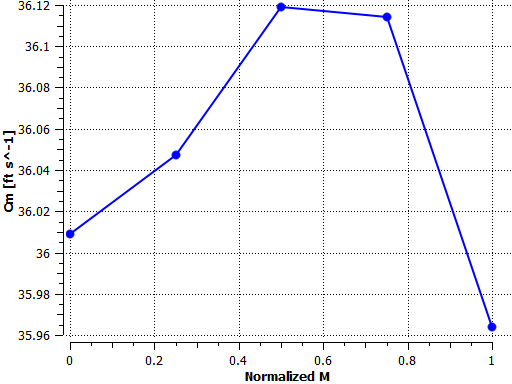
[picture p58: Pump Assembly/Pumps/CFD/LoxPumpReports/LoxPump1/Chart001.png]
Chart 1. LoxPump1/Chart001.png


# 5. Stage Plots

The following plots show, for each stage, a meridional view of the geometry, blade-to-blade contour and vector views, and circumferentially averaged meridional views.

## 5.1. Stage 1 Plots

Figure 2. Stage 1 meridional view of the flow passage and blades

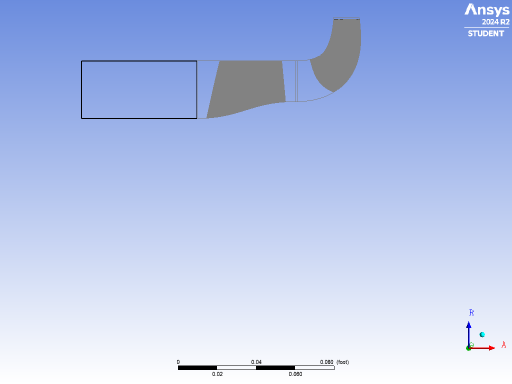
[picture p59: Pump Assembly/Pumps/CFD/LoxPumpReports/LoxPump1/Figure002.png]
Figure 2 - LoxPump1/Figure002.png


Figure 3. Stage 1 contours of P at 50% span

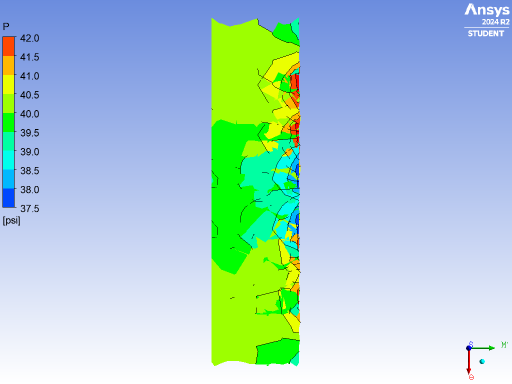
[picture p60: Pump Assembly/Pumps/CFD/LoxPumpReports/LoxPump1/Figure003.png]
Figure 3 - LoxPump1/Figure003.png


Figure 4. Stage 1 velocity vectors at 50% span

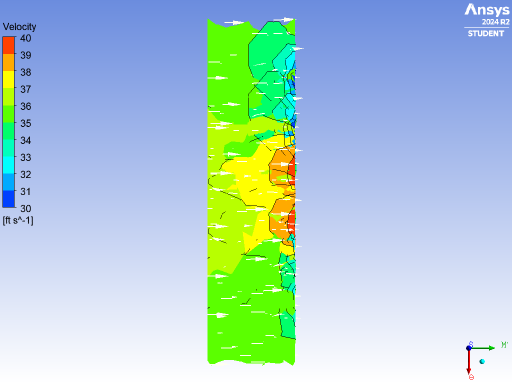
[picture p61: Pump Assembly/Pumps/CFD/LoxPumpReports/LoxPump1/Figure004.png]
Figure 4 - LoxPump1/Figure004.png


Figure 5. Stage 1 contours of Ptr at 50% span

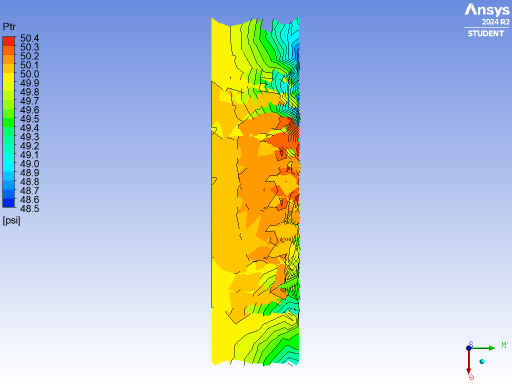
[picture p62: Pump Assembly/Pumps/CFD/LoxPumpReports/LoxPump1/Figure005.png]
Figure 5 - LoxPump1/Figure005.png


Figure 6. Stage 1 contours of circumferentially area-averaged P

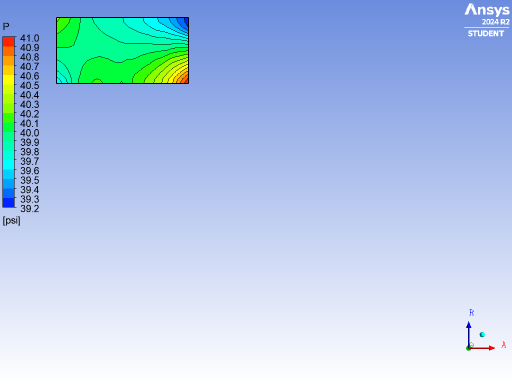
[picture p63: Pump Assembly/Pumps/CFD/LoxPumpReports/LoxPump1/Figure006.png]
Figure 6 - LoxPump1/Figure006.png


Figure 7. Stage 1 contours of circumferentially area-averaged Cm

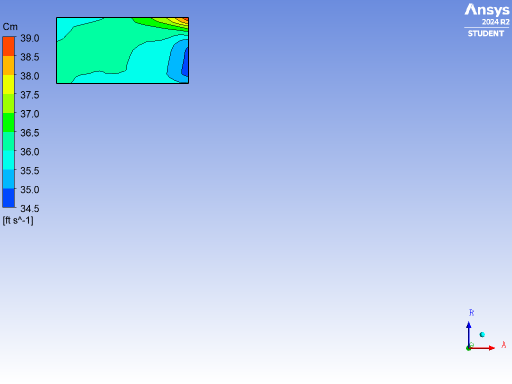
[picture p64: Pump Assembly/Pumps/CFD/LoxPumpReports/LoxPump1/Figure007.png]
Figure 7 - LoxPump1/Figure007.png


# 6. Component Charts

The following charts show blade loading and spanwise-averaged quantities for each component.

## 6.1. Blade Loading Charts

The following charts show the blade loading for each component.

## 6.2. Spanwise Charts

The following charts show circumferentially averaged quantities along hub-to-shroud lines located at the leading and trailing edges of the blade.

Table 4. Stage 2 Performance Results

Rotation Speed | -50000.0000 | [rev min^-1]
Inlet Volume Flow Rate | 0.4297 | [foot^3 s^-1]
Reference Density | 71.2409 | [lb ft^-3]
Reference Diameter | 0.0375 | [foot]
Input Power | 20.8174 | [HP]
Capacity Coefficient | 1.5619
Head Coefficient | -0.5056
Power Coefficient | 0.4887
Total-to-Total Head | -604.3290 | [foot]
Total-to-Static Head | -719.0760 | [foot]
Total-to-Total Efficiency % | -170.4830
Total-to-Static Efficiency % | -195.8870
Diffuser Loss Coef., Y1 | -0.0452
Diffuser Loss Coef., Y2 | -0.0433
Diffuser Loss Coef., Y3 | 0.2056
Diffuser Loss Coef., Y4 | 0.2439
Diffuser Cp | -0.0487

Table 5. Stage 3 Performance Results

Rotation Speed | -50000.0000 | [rev min^-1]
Inlet Volume Flow Rate | 1.2897 | [foot^3 s^-1]
Reference Density | 71.2409 | [lb ft^-3]
Reference Diameter | 0.0683 | [foot]
Input Power | 457.0900 | [HP]
Capacity Coefficient | 0.7747
Head Coefficient | 0.6327
Power Coefficient | 0.5340
Total-to-Total Head | 2511.4800 | [foot]
Total-to-Static Head | 1796.0500 | [foot]
Total-to-Total Efficiency % | 89.8978
Total-to-Static Efficiency % | 64.9859
Diffuser Loss Coef., Y1 | 0.0407
Diffuser Loss Coef., Y2 | 0.0425
Diffuser Loss Coef., Y3 | 0.1036
Diffuser Loss Coef., Y4 | 0.1198
Diffuser Cp | 0.0313

Table 6. Component 2 Summary Data Table

Quantity | Inlet | LE Cut | TE Cut | Outlet | TE/LE | TE-LE | Units
Density | 71.2409 | 71.2409 | 71.2409 | 71.2409 | N/A | N/A | [lb ft^-3]
Pstatic | 39.6879 | 34.3957 | -309.2450 | -311.9590 | N/A | -343.6410 | [psi]
Ptotal | 50.4997 | 51.0846 | -253.4860 | -264.9520 | N/A | -304.5710 | [psi]
Ptotal (rot) | 48.7947 | 45.2610 | -87.7003 | -101.5750 | N/A | -132.9610 | [psi]
Head | 94.7679 | 95.4442 | -497.5770 | -509.5610 | N/A | -593.0210 | [foot]
Static Head | 71.7545 | 41.2790 | -622.1060 | -624.3080 | N/A | -663.3850 | [foot]
U | 180.6370 | 181.0380 | 196.1130 | 196.3900 | 1.0833 | 15.0745 | [ft s^-1]
Cm | 36.0826 | 39.3344 | 52.8375 | 49.0085 | 1.3433 | 13.5031 | [ft s^-1]
Cu | 0.5766 | 1.8102 | -54.7371 | -52.9845 | -30.2373 | -56.5473 | [ft s^-1]
C | 37.0585 | 41.4251 | 82.0168 | 74.3881 | 1.9799 | 40.5917 | [ft s^-1]
Wu | -180.0600 | -179.2390 | -250.8540 | -249.3740 | 1.3996 | -71.6154 | [ft s^-1]
W | 183.8360 | 184.4580 | 256.8240 | 254.5200 | 1.3923 | 72.3663 | [ft s^-1]
Distortion Parameter | 1.0731 | 2.1977 | 1.1917 | 1.3015 | 0.5423 | N/A
Flow Angle: Alpha | 2.7178 | 3.3462 | -49.5203 | -49.3260 | N/A | -52.8666 | [degree]
Flow Angle: Beta | -78.1347 | -77.8030 | -80.0155 | -80.2410 | N/A | -2.2125 | [degree]

Table 7. Component 3 Summary Data Table

Quantity | Inlet | LE Cut | TE Cut | Outlet | TE/LE | TE-LE | Units
Density | 71.2409 | 71.2409 | 71.2409 | 71.2409 | N/A | N/A | [lb ft^-3]
Pstatic | -311.3720 | -332.3840 | 601.4960 | 613.7040 | N/A | 933.8800 | [psi]
Ptotal | -265.9730 | -250.7980 | 991.3050 | 950.9220 | N/A | 1242.1000 | [psi]
Ptotal (rot) | -96.2071 | -166.4850 | -198.0370 | -174.0500 | N/A | -31.5526 | [psi]
Head | -529.7430 | -561.5590 | 2003.9900 | 1981.7400 | N/A | 2565.5500 | [foot]
Static Head | -637.2460 | -653.6060 | 1242.7600 | 1266.3000 | N/A | 1896.3700 | [foot]
U | 196.3600 | 203.1260 | 357.3700 | 362.7190 | 1.7593 | 154.2440 | [ft s^-1]
Cm | 46.9026 | 71.4984 | 46.5902 | 41.9581 | 0.6516 | -24.9082 | [ft s^-1]
Cu | -55.2567 | -22.5826 | 216.4400 | 201.7020 | -9.5844 | 239.0220 | [ft s^-1]
C | 73.9724 | 93.3935 | 222.9730 | 207.0870 | 2.3875 | 129.5800 | [ft s^-1]
Wu | -251.6160 | -225.7110 | -140.9300 | -161.0170 | 0.6244 | 84.7803 | [ft s^-1]
W | 256.2220 | 240.3920 | 149.8450 | 167.8370 | 0.6233 | -90.5475 | [ft s^-1]
Distortion Parameter | 1.2204 | 1.7226 | 1.0589 | 1.0635 | 0.6147 | N/A
Flow Angle: Alpha | -50.4783 | -48.3633 | 58.0888 | 68.3286 | N/A | 106.4520 | [degree]
Flow Angle: Beta | -80.1855 | -81.8109 | -74.0030 | -75.8806 | N/A | 7.8079 | [degree]

## 6.3. Stage 2 Plots

Figure 8. Stage 2 meridional view of the flow passage and blades

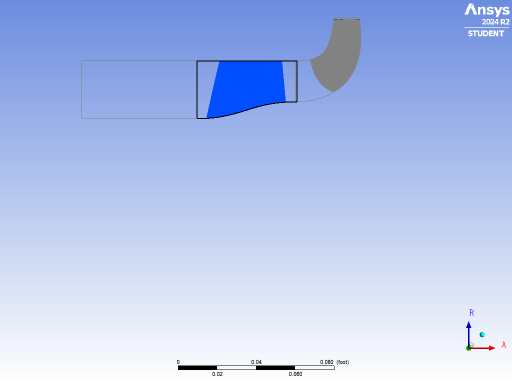
[picture p65: Pump Assembly/Pumps/CFD/LoxPumpReports/LoxPump1/Figure008.png]
Figure 8 - LoxPump1/Figure008.png


Figure 9. Stage 2 contours of P at 50% span

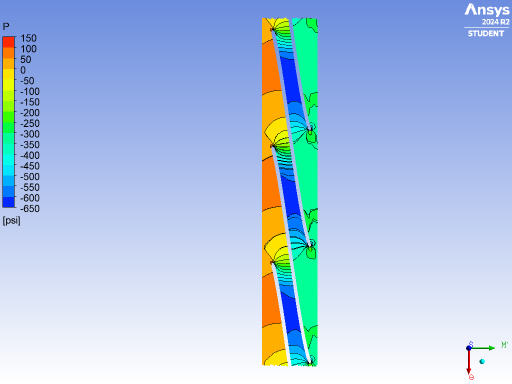
[picture p66: Pump Assembly/Pumps/CFD/LoxPumpReports/LoxPump1/Figure009.png]
Figure 9 - LoxPump1/Figure009.png


Figure 10. Stage 2 velocity vectors at 50% span

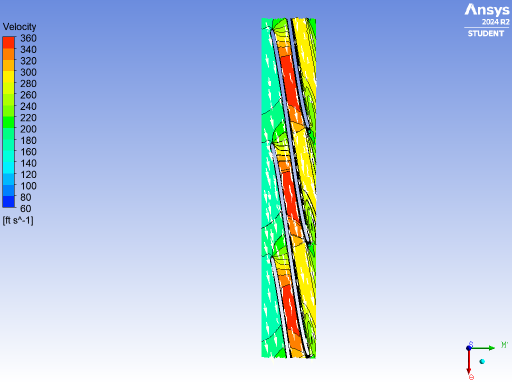
[picture p67: Pump Assembly/Pumps/CFD/LoxPumpReports/LoxPump1/Figure010.png]
Figure 10 - LoxPump1/Figure010.png


Figure 11. Stage 2 contours of Ptr at 50% span

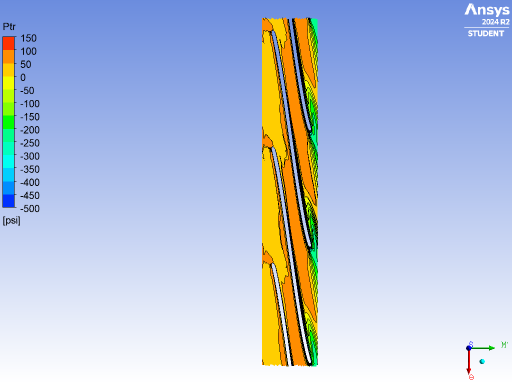
[picture p68: Pump Assembly/Pumps/CFD/LoxPumpReports/LoxPump1/Figure011.png]
Figure 11 - LoxPump1/Figure011.png


Figure 12. Stage 2 contours of circumferentially area-averaged P

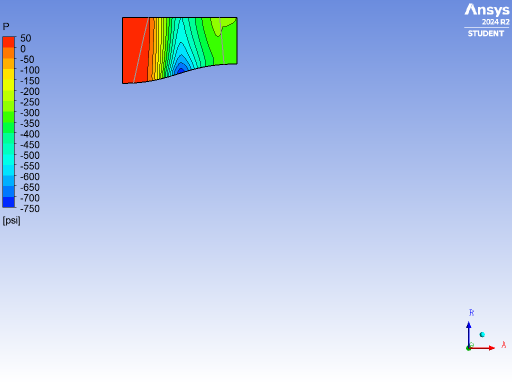
[picture p69: Pump Assembly/Pumps/CFD/LoxPumpReports/LoxPump1/Figure012.png]
Figure 12 - LoxPump1/Figure012.png


Figure 13. Stage 2 contours of circumferentially area-averaged Cm

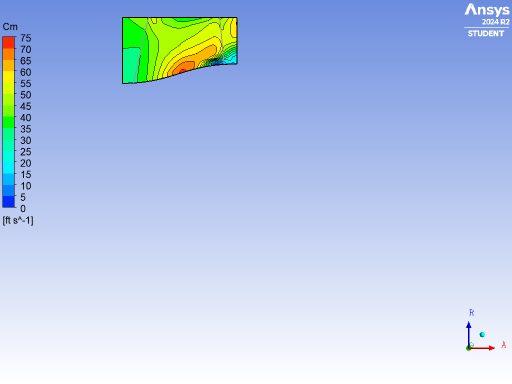
[picture p70: Pump Assembly/Pumps/CFD/LoxPumpReports/LoxPump1/Figure013.png]
Figure 13 - LoxPump1/Figure013.png


## 6.4. Stage 3 Plots

Figure 14. Stage 3 meridional view of the flow passage and blades

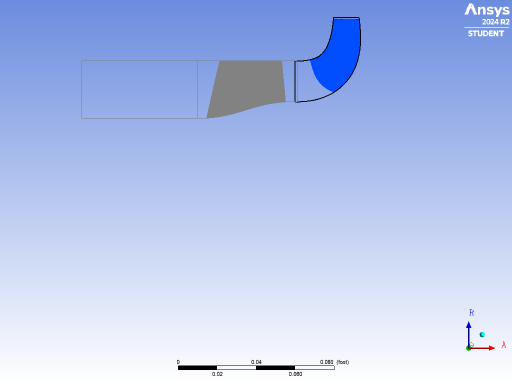
[picture p71: Pump Assembly/Pumps/CFD/LoxPumpReports/LoxPump1/Figure014.png]
Figure 14 - LoxPump1/Figure014.png


Figure 15. Stage 3 contours of P at 50% span

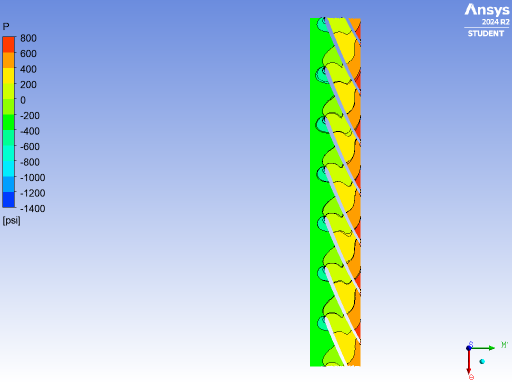
[picture p72: Pump Assembly/Pumps/CFD/LoxPumpReports/LoxPump1/Figure015.png]
Figure 15 - LoxPump1/Figure015.png


Figure 16. Stage 3 velocity vectors at 50% span

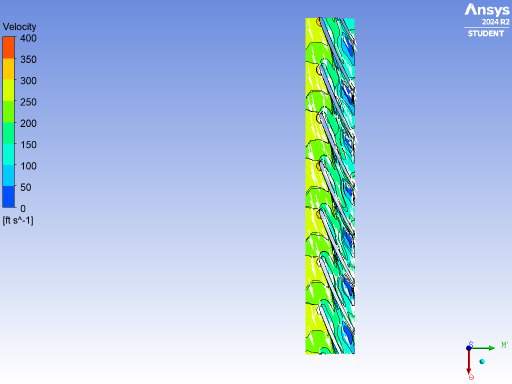
[picture p73: Pump Assembly/Pumps/CFD/LoxPumpReports/LoxPump1/Figure016.png]
Figure 16 - LoxPump1/Figure016.png


Figure 17. Stage 3 contours of Ptr at 50% span

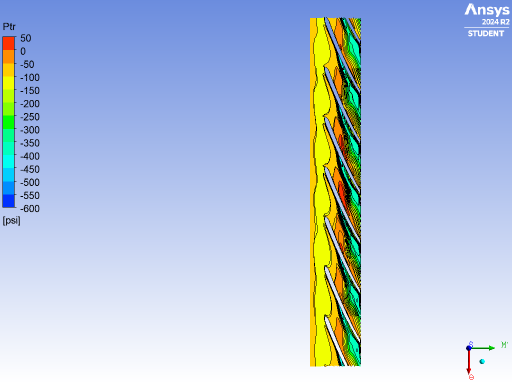
[picture p74: Pump Assembly/Pumps/CFD/LoxPumpReports/LoxPump1/Figure017.png]
Figure 17 - LoxPump1/Figure017.png


Figure 18. Stage 3 contours of circumferentially area-averaged P

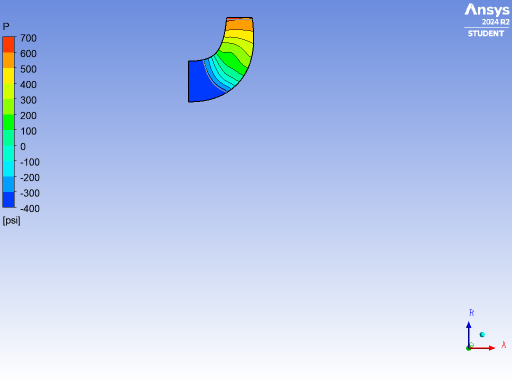
[picture p75: Pump Assembly/Pumps/CFD/LoxPumpReports/LoxPump1/Figure018.png]
Figure 18 - LoxPump1/Figure018.png


Figure 19. Stage 3 contours of circumferentially area-averaged Cm

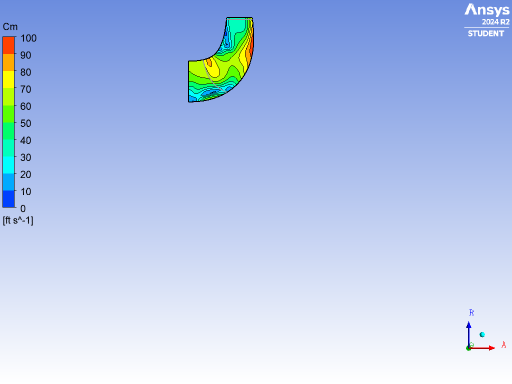
[picture p76: Pump Assembly/Pumps/CFD/LoxPumpReports/LoxPump1/Figure019.png]
Figure 19 - LoxPump1/Figure019.png


Chart 2. Component 2 blade loading chart

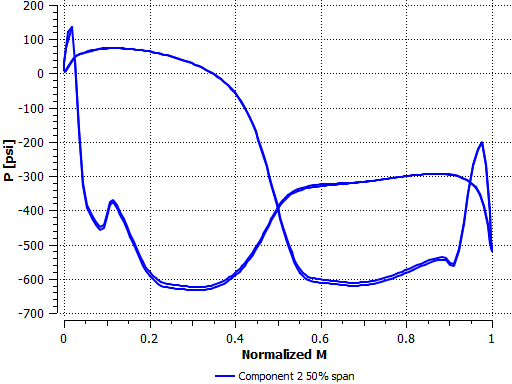
[picture p77: Pump Assembly/Pumps/CFD/LoxPumpReports/LoxPump1/Chart002.png]
Chart 2. LoxPump1/Chart002.png


Chart 3. Component 3 blade loading chart

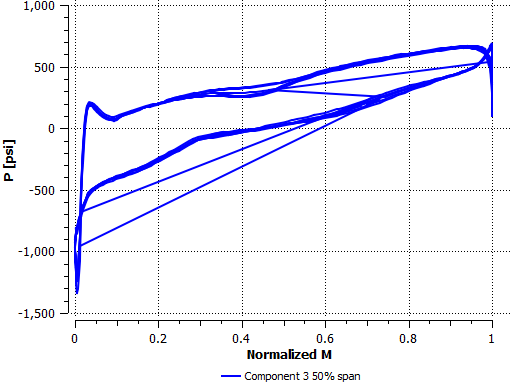
[picture p78: Pump Assembly/Pumps/CFD/LoxPumpReports/LoxPump1/Chart003.png]
Chart 3. LoxPump1/Chart003.png


Chart 4. Component 2 chart showing circumferentially averaged flow angle at the LE

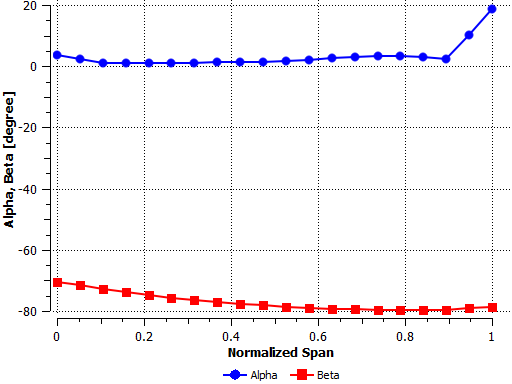
[picture p79: Pump Assembly/Pumps/CFD/LoxPumpReports/LoxPump1/Chart004.png]
Chart 4. LoxPump1/Chart004.png


Chart 5. Component 2 chart showing circumferentially averaged flow angle at the TE

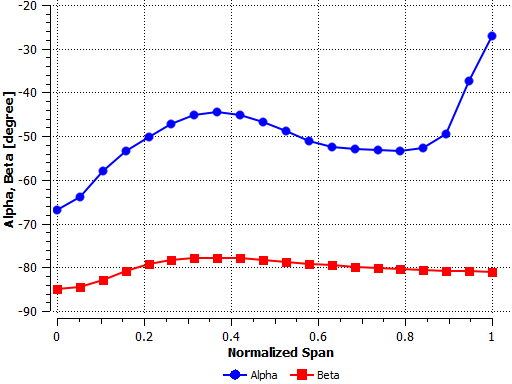
[picture p80: Pump Assembly/Pumps/CFD/LoxPumpReports/LoxPump1/Chart005.png]
Chart 5. LoxPump1/Chart005.png


Chart 6. Component 2 chart showing circumferentially averaged Cm at the TE

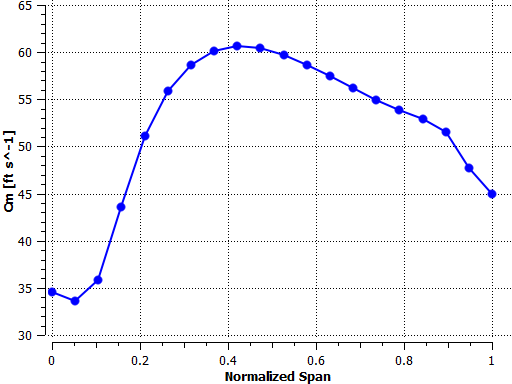
[picture p81: Pump Assembly/Pumps/CFD/LoxPumpReports/LoxPump1/Chart006.png]
Chart 6. LoxPump1/Chart006.png


Chart 7. Component 3 chart showing circumferentially averaged flow angle at the LE

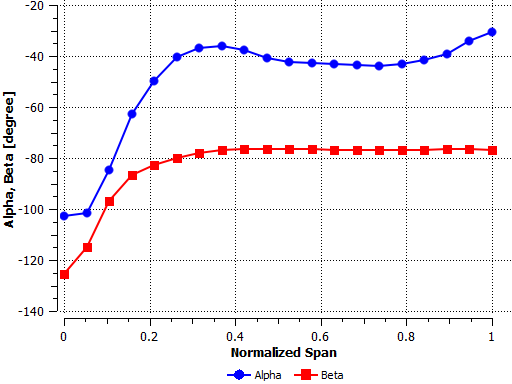
[picture p82: Pump Assembly/Pumps/CFD/LoxPumpReports/LoxPump1/Chart007.png]
Chart 7. LoxPump1/Chart007.png


Chart 8. Component 3 chart showing circumferentially averaged flow angle at the TE

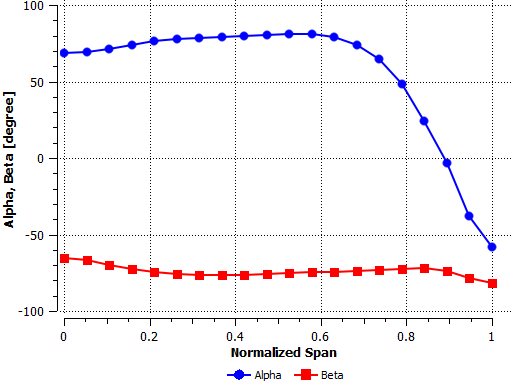
[picture p83: Pump Assembly/Pumps/CFD/LoxPumpReports/LoxPump1/Chart008.png]
Chart 8. LoxPump1/Chart008.png


Chart 9. Component 3 chart showing circumferentially averaged Cm at the TE

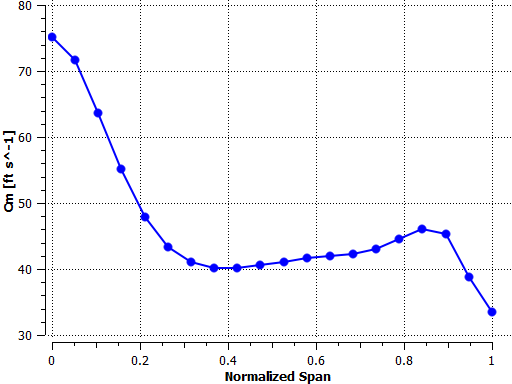
[picture p84: Pump Assembly/Pumps/CFD/LoxPumpReports/LoxPump1/Chart009.png]
Chart 9. LoxPump1/Chart009.png
