PURPL-Purdue/Turbopump/MARLIN V2/Tenkara/4 - Subteams/TCA/Development/Archive_(5k Dev)/5k_torch/Research/Injector References - Google Docs.pdf

# Injector References

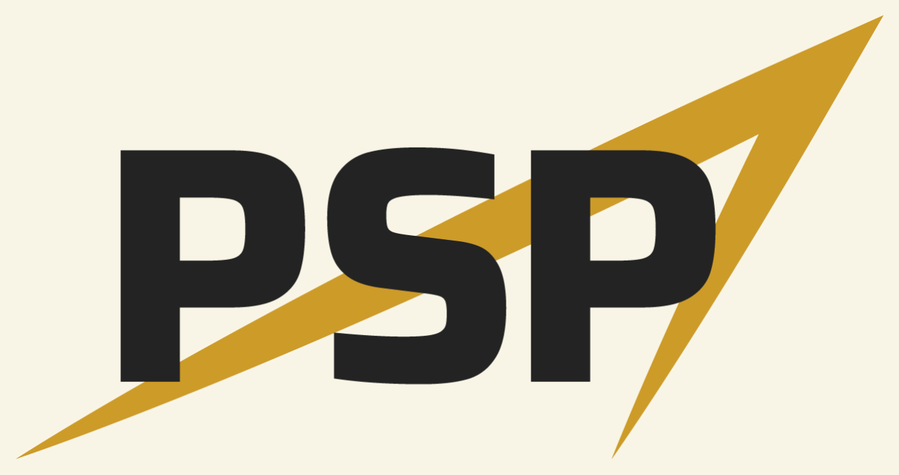
[picture p85: figure]

This reference list is an all-inclusive vacation to rocket injector design, theory, and implementation. While the sources compiled for your entertainment present a wealth of knowledge, it is worth noting that more resources out there exist. Make sure to use other verified documentation to get smart (https://en.wikipedia.org/wiki/Get_Smart) and inspire innovation! Of course, the resources we provide are a great way to start o.

## Color Codes:

🚀 Magenta - starting material, recommended for new members and anyone wanting to learn the basics
🚀 Blue - more technical and specific material

## Table of Contents:

■ General Injector
■ Pintle Injectors
■ Coaxial Swirl Injectors
■ Industry Leaders
■ Additional Media

Check out how we use this knowledge at PSP Liquids! Click any of the icons below to see our dedicated and brilliant team in action and to learn more about our other subteams!

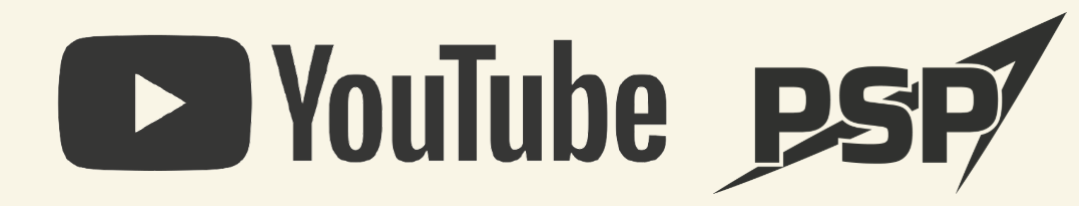
[picture p86: figure]

Injector Team

# General Injector

1. NASA SP-8089: Liquid Rocket Engine Injectors (http://wiki.purdueseds.space/doku.php?id=liquids:reference:sp8089) – 9-18, Injection element selection and types – 18-25, Orifice diameter and diameter ratio – 25-28, Impingement angle
– 28-29, Impingement distance
– 29-33, Element distribution
– 33-36, Combustion instability
– 36-45, Orifice geometry
– 45-56, Manifolds and upstream geometry – 58-63, Injector assembly, pt. 1
– 63-72, Injector face
– 76-86, Injector flow system geometry
– 90-98, Injector assembly, pt. 2

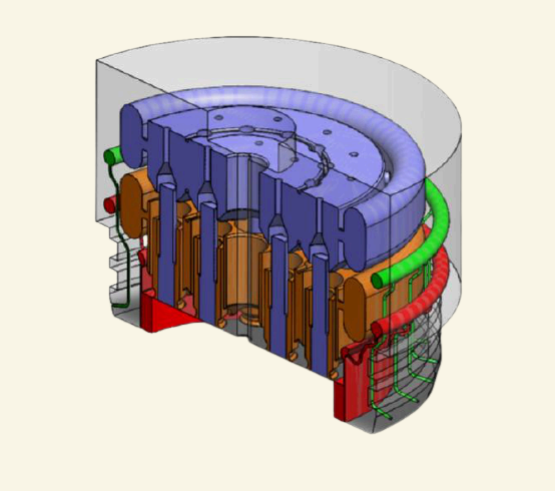
[picture p87: figure]

2. Design and Dynamics of Jet and Swirl Injectors (https://arc.aiaa.org/doi/10.2514/5.9781600866760.0019.0103) - Bazarov and Yang: – An amazing text, consume whole
3. Rocket Propulsion Elements 7th Ed. (http://wiki.purdueseds.space/doku.php?id=liquids:reference:sutton) - Sutton and Biblarz:
– 268-270, Thrust chambers
– 271-281, Injectors
– 296-300, Aerospikes
– 96, Variable thrust, pt. 1
– 323-324, Variable thrust, pt. 2
– 334-335, Sample thrust chamber injector design
– 348-360, Combustion instability
4. Rocket Propulsion (http://wiki.purdueseds.space/doku.php?id=liquids:reference:heister) - Heister, Anderson, Pourpoint, and Cassady: – 282-285, Basic elements of a LRE
– 309-326, LRE injectors
– 327-329, LRE combustor and injector design and analysis – 479-525, Combustion instability

1

Injector Team

### 5. NASA SP-125: Modern Engineering for Design of Liquid Propellant Rocket

Engines (http://wiki.purdueseds.space/doku.php?id=liquids:reference:sp125) - Huzel and Huang:
– 121-131, Injector design
– 143-150, Combustion instability
– 151-175, Pressurized-gas feed systems
6. Liquid Atomization (http://wiki.purdueseds.space/doku.php?id=liquids:reference:bayvel) - Bayvel and Orzechowski: – 160-171, Jet atomizers
– 172-188, Swirl atomizers
– 189-193, Jet-swirl atomizers
– 237-251, Design of jet atomizers
– 252-272, Design of a swirl atomizer
– 273-279, Design of a jet-swirl atomizer
7. Handbook of Atomization and Sprays (http://wiki.purdueseds.space/doku.php?id=liquids:reference:atom) - Ashgriz:
– 214-477, Atomization and spray models
– 478-773, Atomizers and spray generators
8. A Historical Systems Study of Liquid Rocket Engine Throttling Capabilities (https://drive.google.com/drive/u/0/folders/1VzibY_PvJgXsWaETt1eVD1VsRFvyWIQX)
- Betts and Frederick:
– An amazing throttling paper, consume whole
9. Liquid-Propellant Rocket Engine Throttling: A Comprehensive Review (https://arc.aiaa.org/doi/10.2514/1.49791) -Casiano, Hulka, and Yang:
– An amazing throttling paper, consume whole
10. Fluid Flow and Heat Transfer in a Liquid Rocket Fuel Injector (https://arc.aiaa.org/doi/10.2514/6.2005-4127) - Tully, Omar, Chung, and Carroll:
– A thorough and captivating paper on injector heat transfer, consume whole

2

Injector Team

# Pintle Injectors

1. TRW Pintle Engine Heritage and Performance Characteristics (http://wiki.purdueseds.space/doku.php?id=liquids:reference:trw) - Dressler and Bauer:
– An amazing text, consume whole
2. Handbook of Atomization and Sprays (http://wiki.purdueseds.space/doku.php?id=liquids:reference:atom) - Ashgriz and Heister:
– 647-655, Chapter 28, Pintle injectors
– 649-651, Pintle heritage
– 651-653, Design methodology
3. Design Procedure of a Movable Pintle Injector for Liquid Rocket Engines (https://arc.aiaa.org/doi/full/10.2514/1.B36301) -Son, Radhakrishnan, Koo, Kwon, and Kim:
– An amazing paper, consume whole
4. Spray Characteristics of a Pintle Injector Based on Annular Orifice Area (https://www.sciencedirect.com/science/article/pii/S0094576519313852) -Lee, Kim, Koo, and Yoon:
– An amazing text, consume whole

5.

3

Injector Team

# Coaxial Swirl Injectors

### 1. Effects of LOX Post Recess on the Combustion Characteristics for Bi-Swirl

Coaxial Injector (https://arc.aiaa.org/doi/pdf/10.2514/6.2005-4445) - Kim, Han, Seo, Moon, Kim, and Seol:
– An amazing text, consume whole

### 2. Minimizing Hydraulic Losses in Additively-Manufactured Swirl Coaxial

Rocket Injectors via Analysis-Driven Design Method (https://escholarship.org/uc/item/7n51c078) - Morrow:
– An amazing text, consume whole

### 3. An Extensive Study on the Discharge Coefficients of Open-Type Swirl

Injectors (https://www.dl.begellhouse.com/download/article/51734897698f4039/AAS2710(1)-19293.pdf) - Ahn and Choi:
– 835-837, Introduction material
– 837, Open-type swirl injectors
– 839-841, Comparing empirical and past equations
– Else, an amazing text, consume whole

### 4. Combustion Stability Characteristics of Coax-Swirl- Injectors for

Oxygen/Kerosene (https://arc.aiaa.org/doi/pdf/10.2514/6.2007-5563) - Martin and Mäding:
– 5-6, Measurements and data treatment
– 6-7, Chamber and feed system acoustics

4

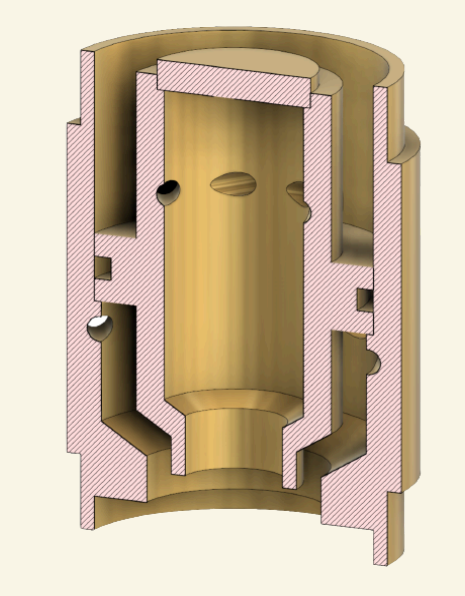
[picture p88: figure]

Injector Team

# Industry Leaders

Copenhagen Suborbitals | The world’s only crewed ametuer spaceflight program. This Denmark-based program is entirely crowdfunded and known for their wonderful coaxial swirl injectors.
Launcher Space | Launcher develops wildly ecient rockets and transport vehicles to aid satellites into orbit. This company excellently documents engine tests on their YouTube.
Relativity Space | Relativity is known for their 3D printed rocket components, advertising fewer components and fast manufacturing. They’re also building an autonomous rocket factory.

We only briefly discussed three organizations leading injector design and engine testing, but don’t worry, there are many more out there! Check out PSP’s company list! (http://wiki.purdueseds.space/doku.php?id=liquids:learning_resources:company_list)

5

# Additional Media

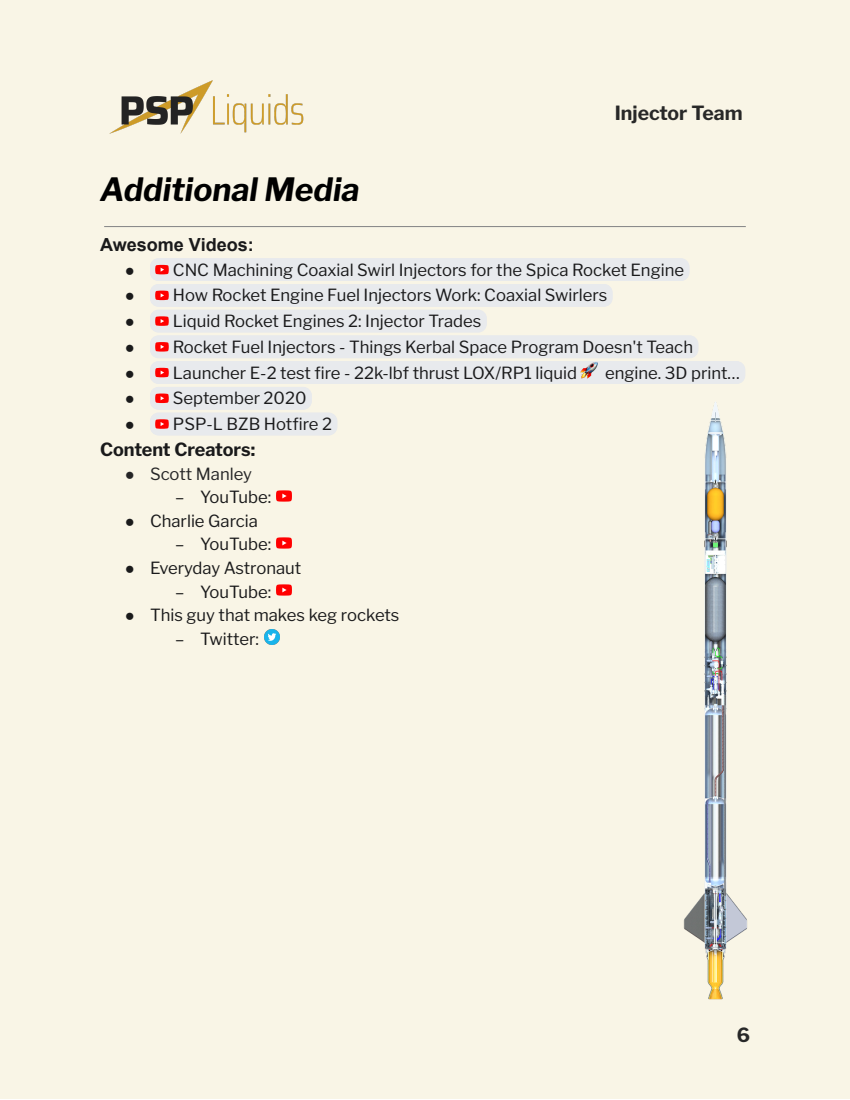
[picture p89: page 7]
Injector Team

Awesome Videos:
● CNC Machining Coaxial Swirl Injectors for the Spica Rocket Engine (https://www.youtube.com/watch?v=8EDnxmK67d0)
● How Rocket Engine Fuel Injectors Work: Coaxial Swirlers (https://www.youtube.com/watch?v=0qvbyl7KuNw)
● Liquid Rocket Engines 2: Injector Trades (https://www.youtube.com/watch?v=pE0q4vrhkMU&t=316s)
● Rocket Fuel Injectors - Things Kerbal Space Program Doesn't Teach (https://www.youtube.com/watch?v=aa4ATJGRqA0)
● Launcher E-2 test fire - 22k-lbf thrust LOX/RP1 liquid 🚀 engine. 3D print… (https://www.youtube.com/watch?v=hQKA3WZ02Fw)
● September 2020 (https://www.youtube.com/watch?v=z9XqjuFzt_4)
● PSP-L BZB Hotfire 2 (https://www.youtube.com/watch?v=tM8SZoWBhgA)
Content Creators:
● Scott Manley
– YouTube:
● Charlie Garcia
● Everyday Astronaut
● This guy that makes keg rockets
– Twitter:
