PURPL-Purdue/Turbopump/MARLIN V2/Tenkara/4 - Subteams/Pumps/Code/dsundy/npsh_vs_shaft_speed.png

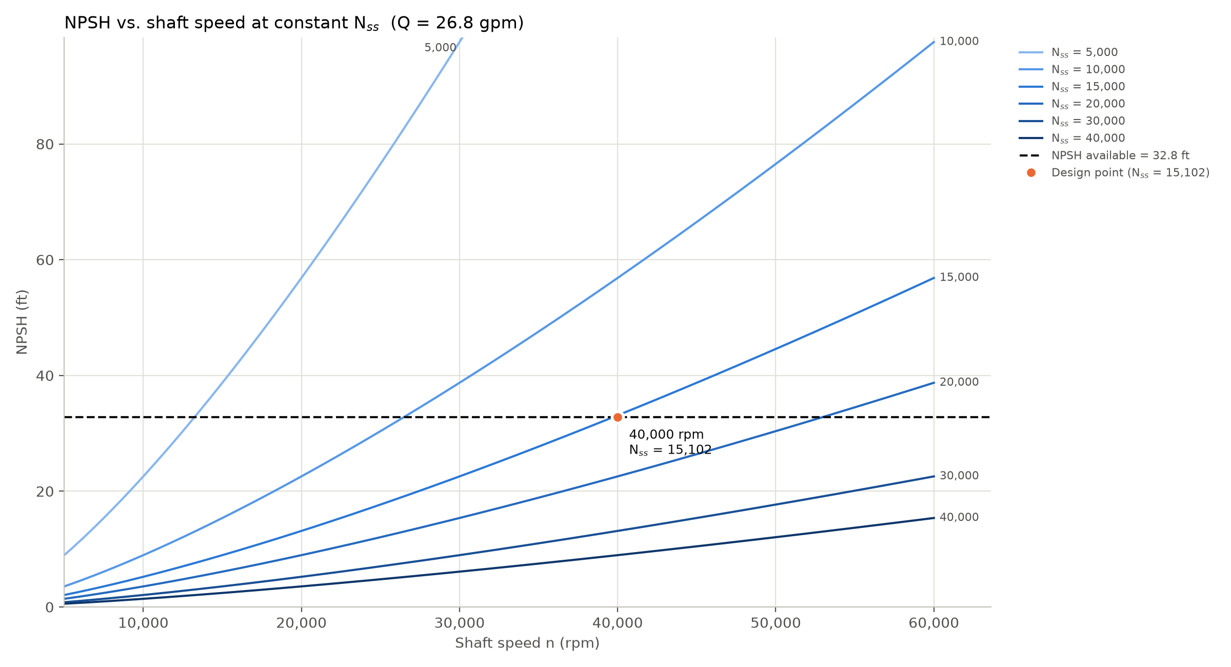
MARLIN V2/Tenkara/4 - Subteams/Pumps/Code/dsundy/npsh_vs_shaft_speed.png
