PURPL-Purdue/Turbopump/MARLIN V2/Tenkara/4 - Subteams/Pumps/Code/dsundy/npsh_vs_tip_diameter.png

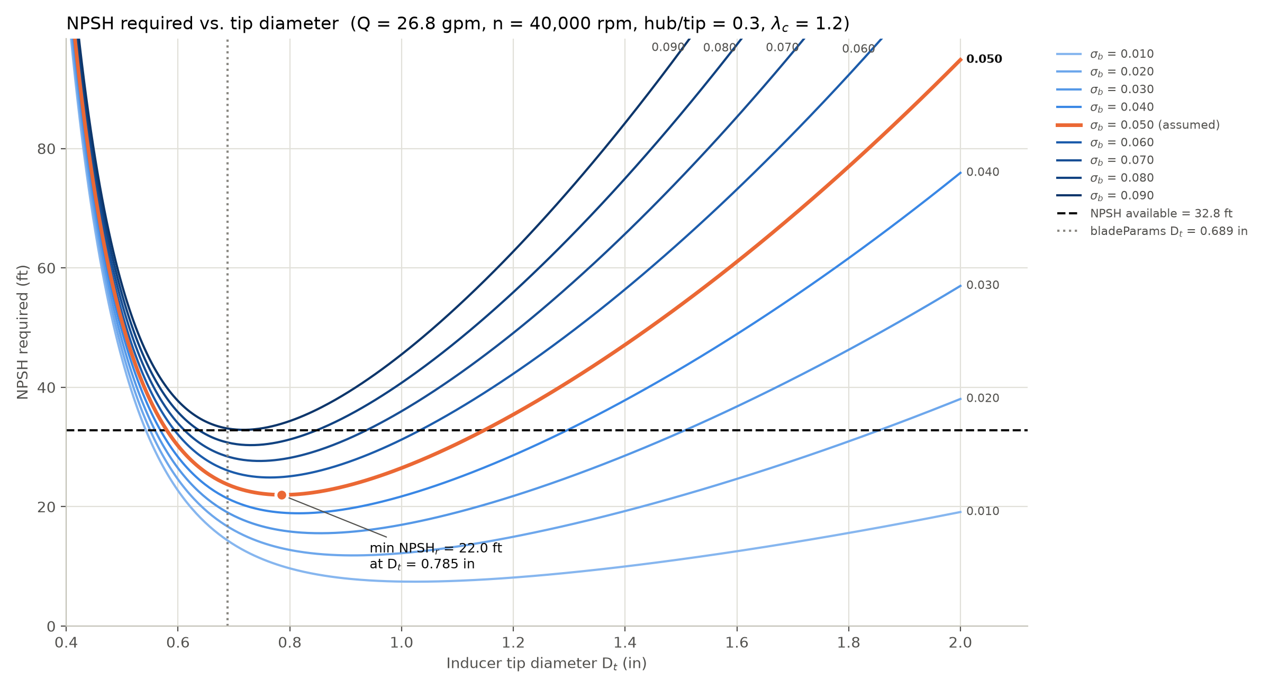
MARLIN V2/Tenkara/4 - Subteams/Pumps/Code/dsundy/npsh_vs_tip_diameter.png
