PURPL-Purdue/Turbopump/MARLIN V2/Tenkara/4 - Subteams/TCA/Development/flange/analysis_figures/5_16x14.png

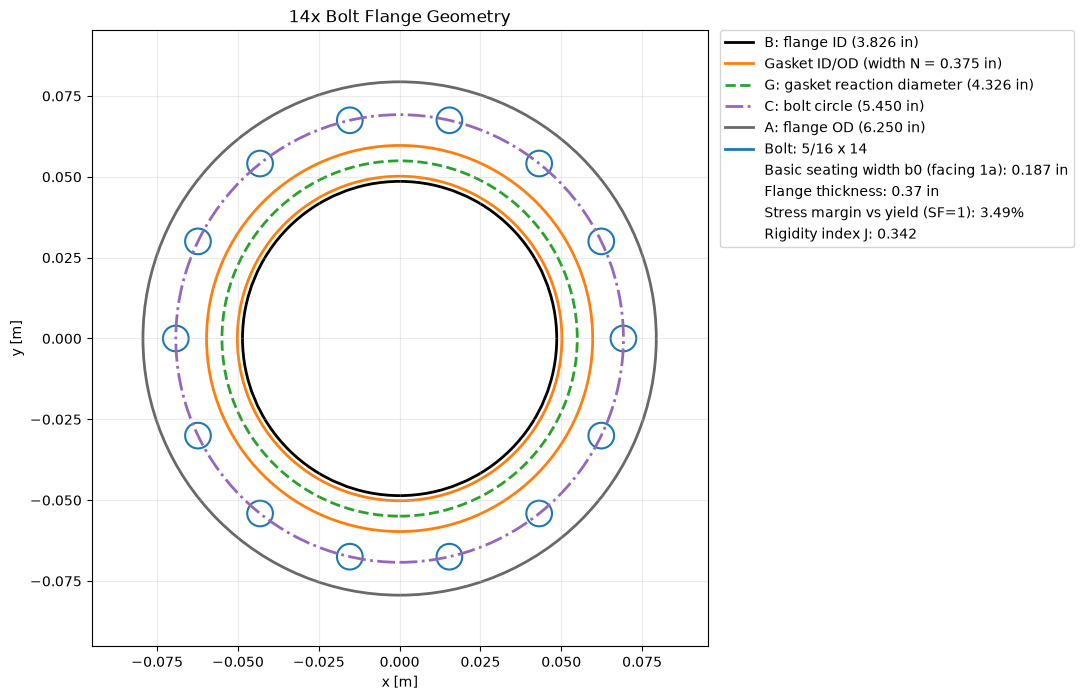
MARLIN V2/Tenkara/4 - Subteams/TCA/Development/flange/analysis_figures/5_16x14.png
