PURPL-Purdue/Turbopump/MARLIN V2/Tenkara/4 - Subteams/TCA/Development/flange/figures/3_8x10.png

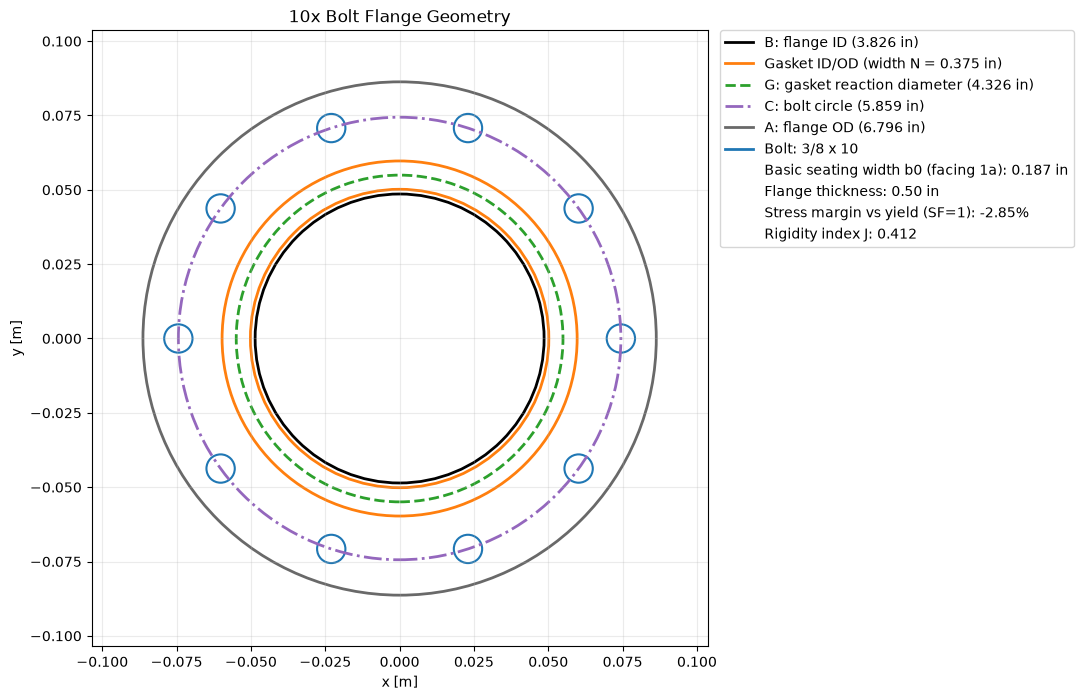
MARLIN V2/Tenkara/4 - Subteams/TCA/Development/flange/figures/3_8x10.png
