PURPL-Purdue/Turbopump/MARLIN V2/Tenkara/4 - Subteams/TCA/Development/flange/figures/#4x83.png

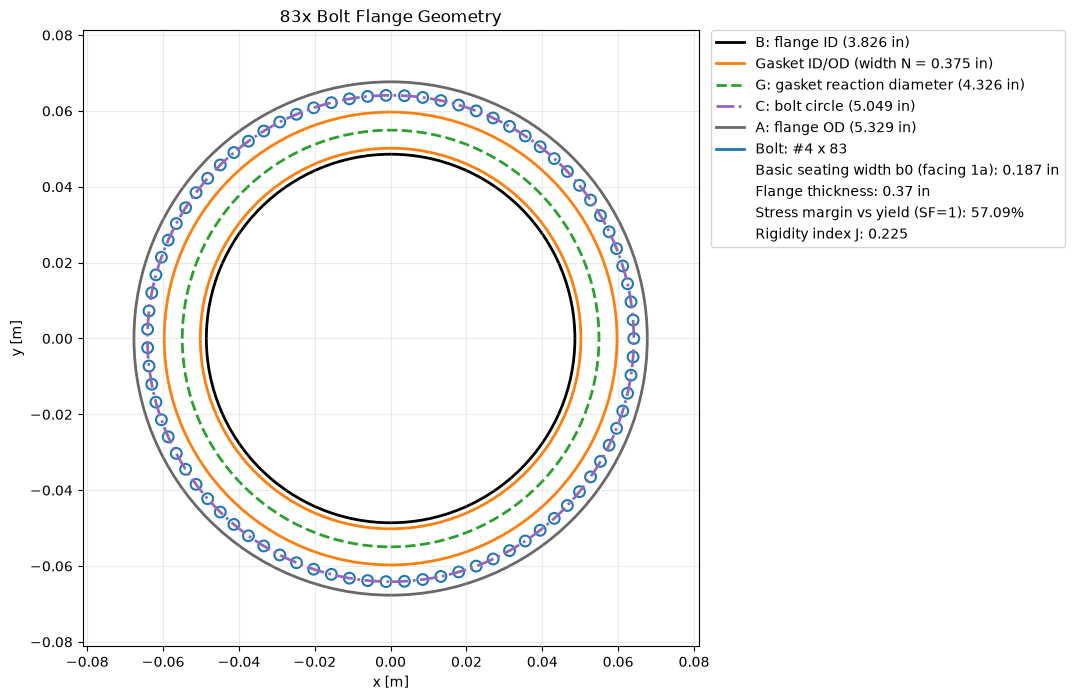
MARLIN V2/Tenkara/4 - Subteams/TCA/Development/flange/figures/#4x83.png
