PURPL-Purdue/Turbopump/MARLIN V2/Tenkara/4 - Subteams/TCA/Development/flange/figures/#10x28.png

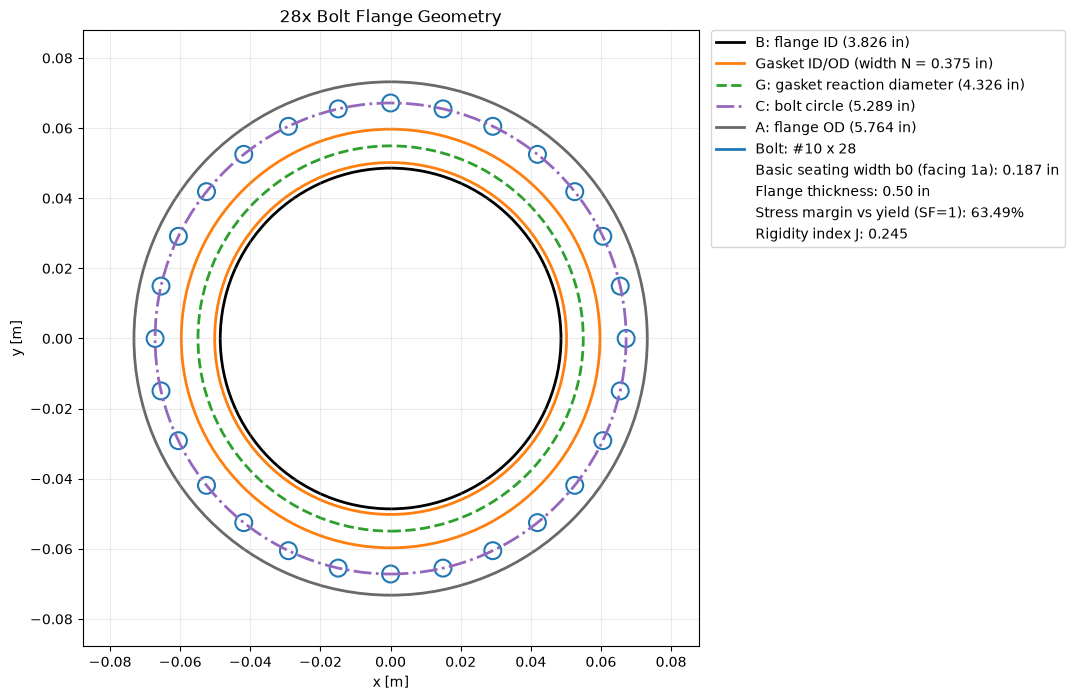
MARLIN V2/Tenkara/4 - Subteams/TCA/Development/flange/figures/#10x28.png
