PURPL-Purdue/Turbopump/MARLIN V2/Tenkara/4 - Subteams/TCA/Development/Heatsink CDR Files/Carbon Steel/Photos/Carbon Steel 4s.png

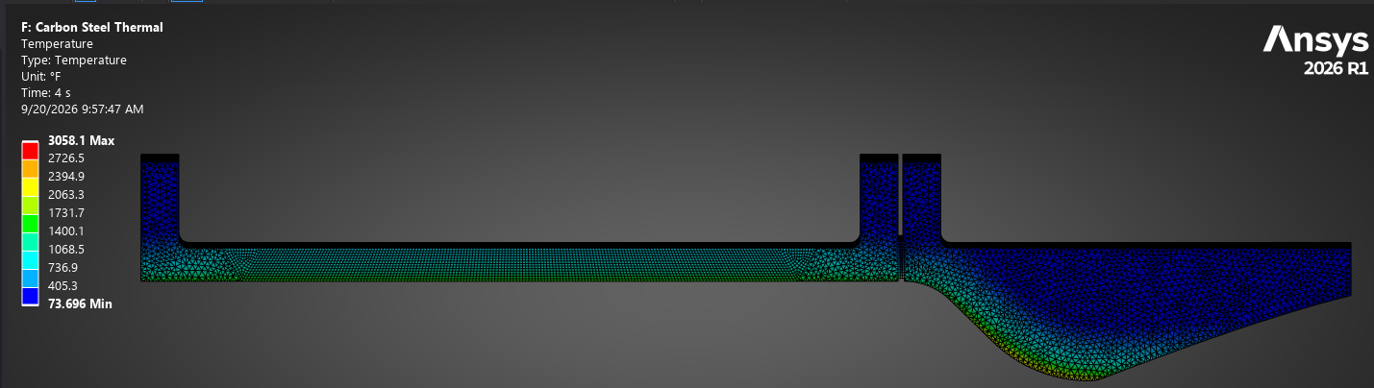
MARLIN V2/Tenkara/4 - Subteams/TCA/Development/Heatsink CDR Files/Carbon Steel/Photos/Carbon Steel 4s.png
