PURPL-Purdue/Turbopump/MARLIN V2/Tenkara/4 - Subteams/TCA/Development/Heatsink CDR Files/chamber_avg_temp.png

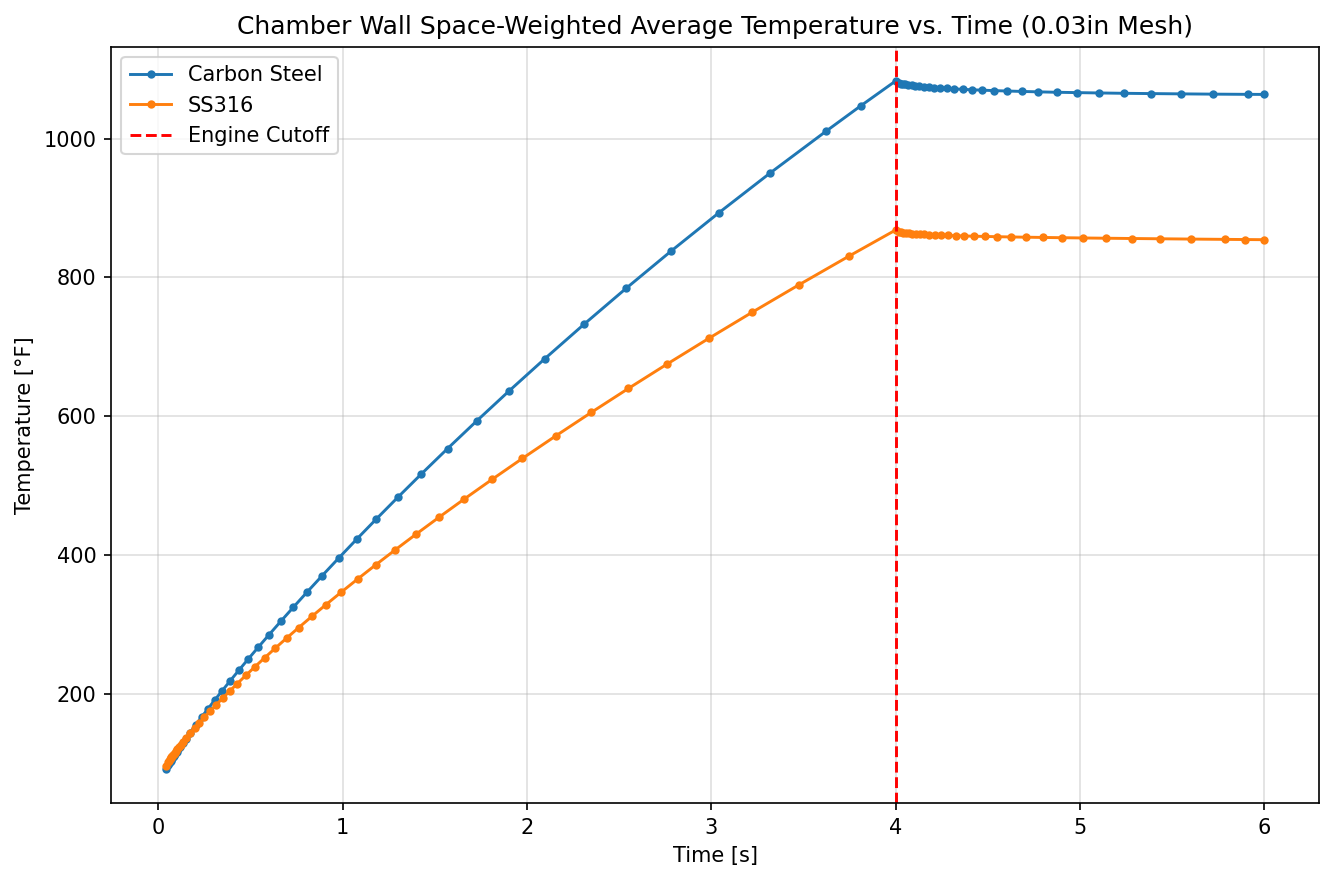
MARLIN V2/Tenkara/4 - Subteams/TCA/Development/Heatsink CDR Files/chamber_avg_temp.png
