PURPL-Purdue/Turbopump/MARLIN V2/Tenkara/4 - Subteams/TCA/Development/Heatsink CDR Files/Convection BC.png

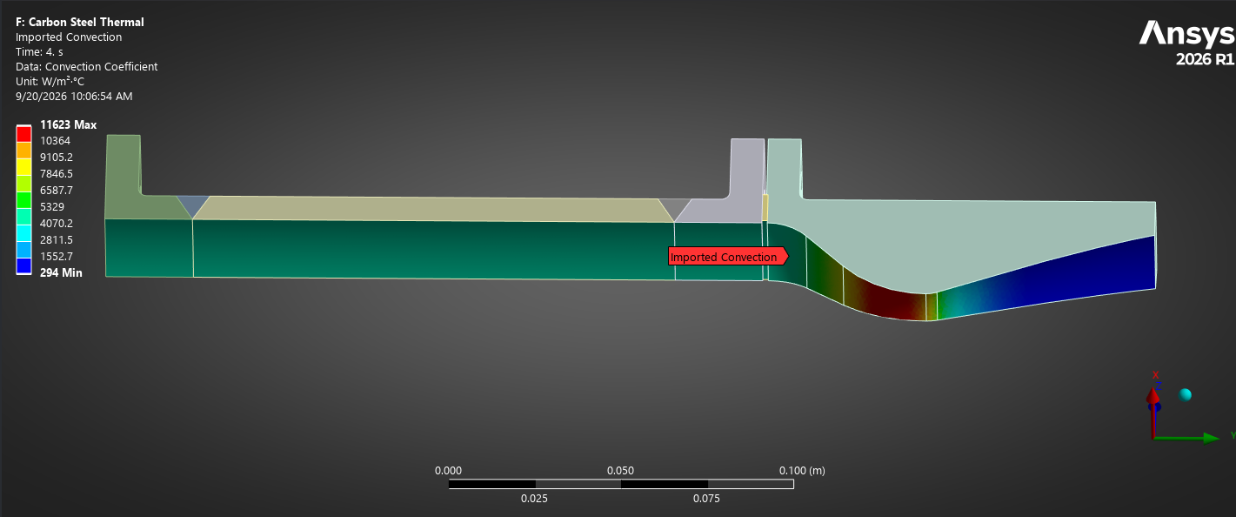
MARLIN V2/Tenkara/4 - Subteams/TCA/Development/Heatsink CDR Files/Convection BC.png
