PURPL-Purdue/Turbopump/MARLIN V2/Tenkara/4 - Subteams/TCA/Development/Heatsink CDR Files/SS/Photos/SS Chamber Only.png

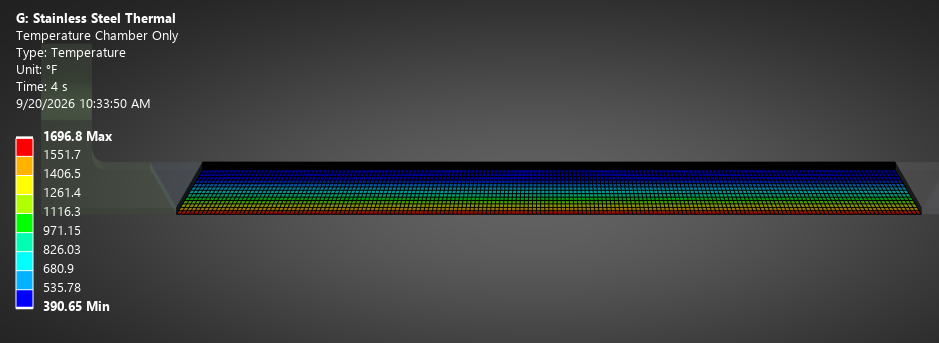
MARLIN V2/Tenkara/4 - Subteams/TCA/Development/Heatsink CDR Files/SS/Photos/SS Chamber Only.png
