PURPL-Purdue/Turbopump/MARLIN V2/Tenkara/4 - Subteams/TCA/Development/Heatsink CDR Files/SS/Photos/SS Closeup 4s.png

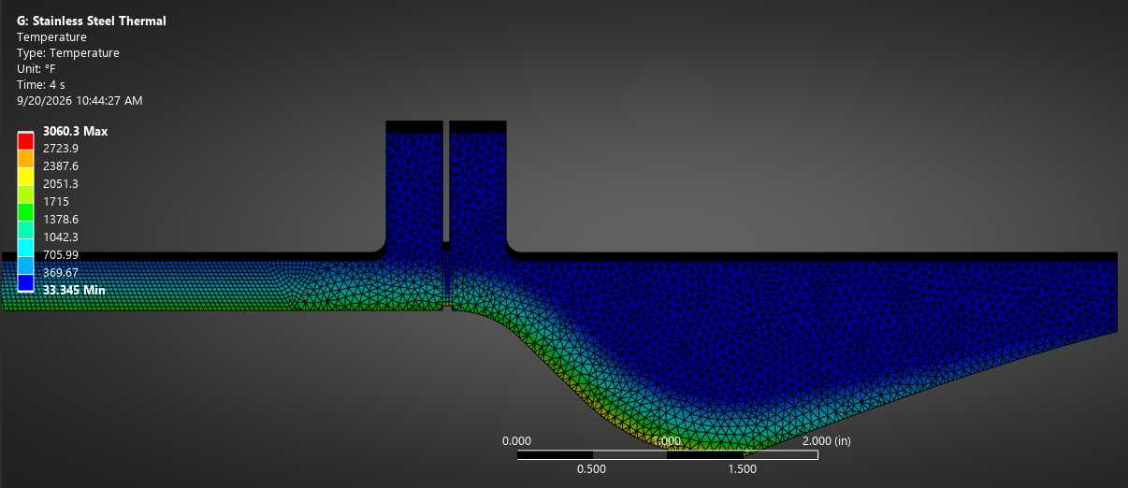
MARLIN V2/Tenkara/4 - Subteams/TCA/Development/Heatsink CDR Files/SS/Photos/SS Closeup 4s.png
