PURPL-Purdue/Turbopump/MARLIN V2/Tenkara/4 - Subteams/TCA/Development/Injector_codes/average_eccentric_design.png

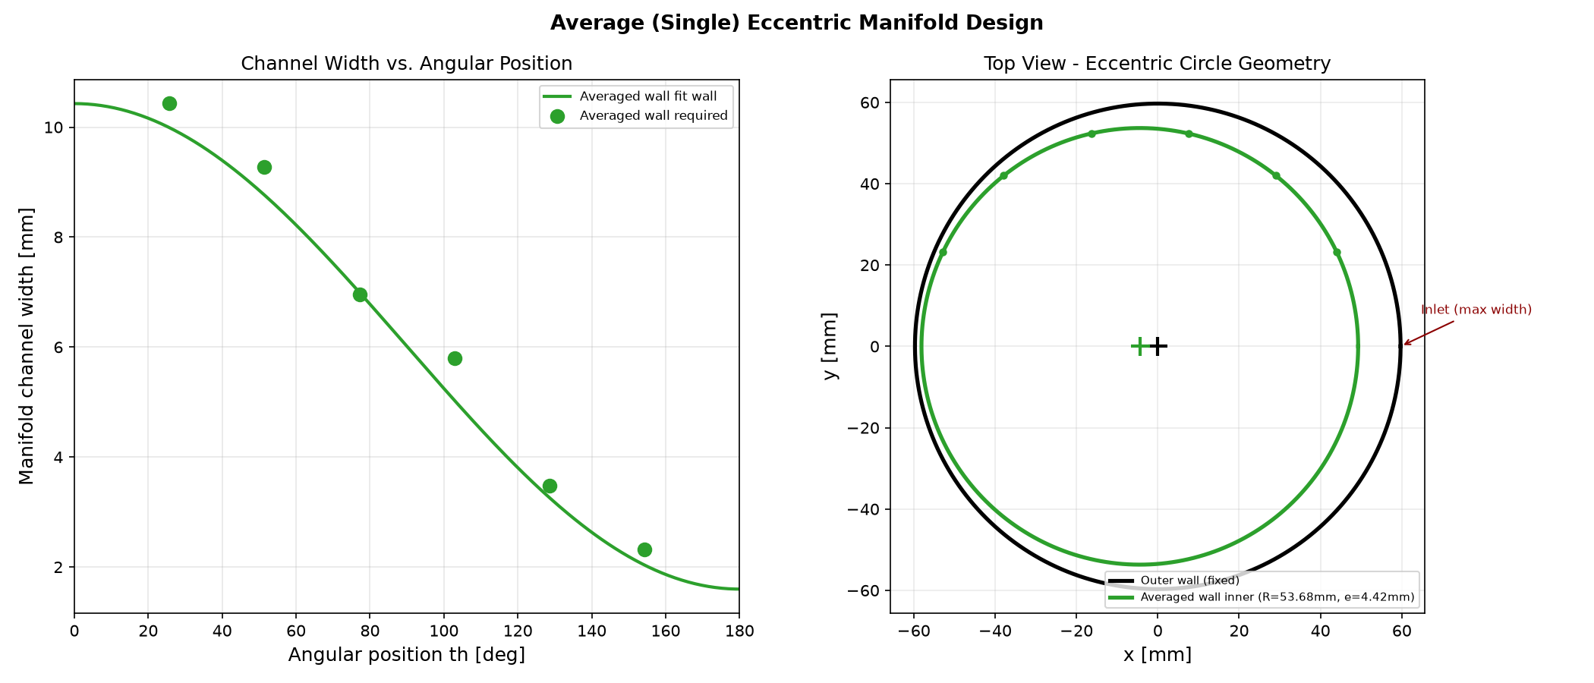
MARLIN V2/Tenkara/4 - Subteams/TCA/Development/Injector_codes/average_eccentric_design.png
