PURPL-Purdue/Turbopump/MARLIN V2/Tenkara/4 - Subteams/TCA/Development/Injector_codes/Eccentric.png

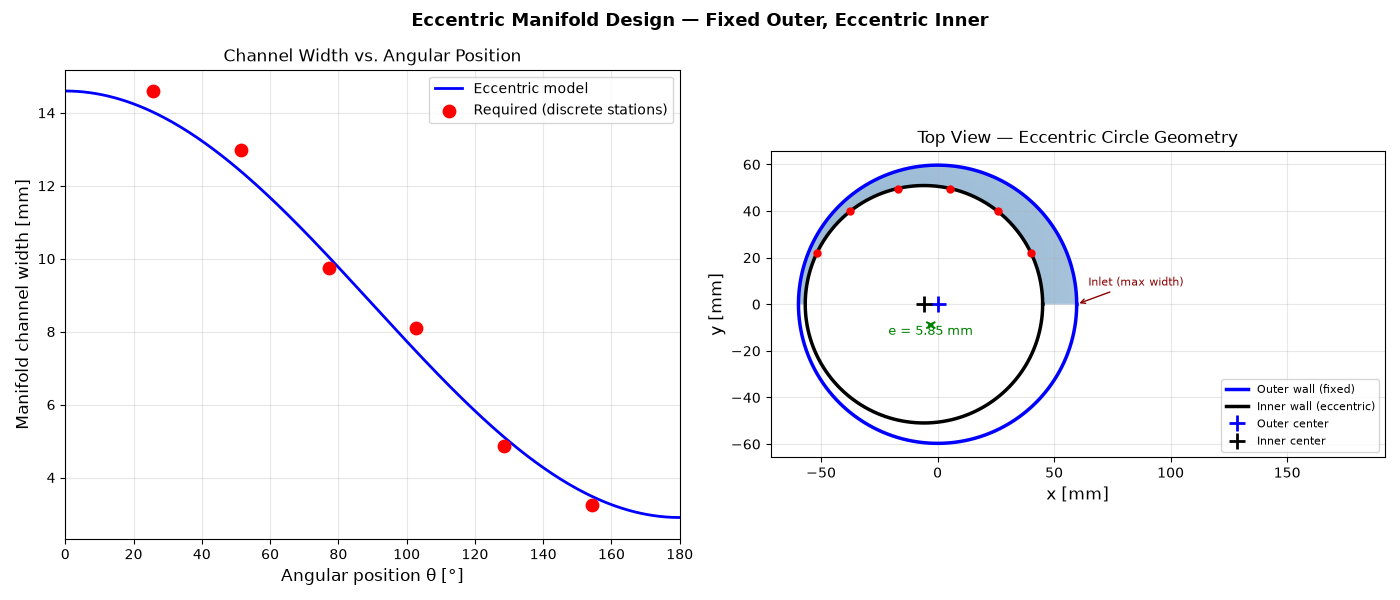
MARLIN V2/Tenkara/4 - Subteams/TCA/Development/Injector_codes/Eccentric.png
