PURPL-Purdue/Turbopump/MARLIN V2/Tenkara/4 - Subteams/TCA/isp_thrust_vs_OF.png

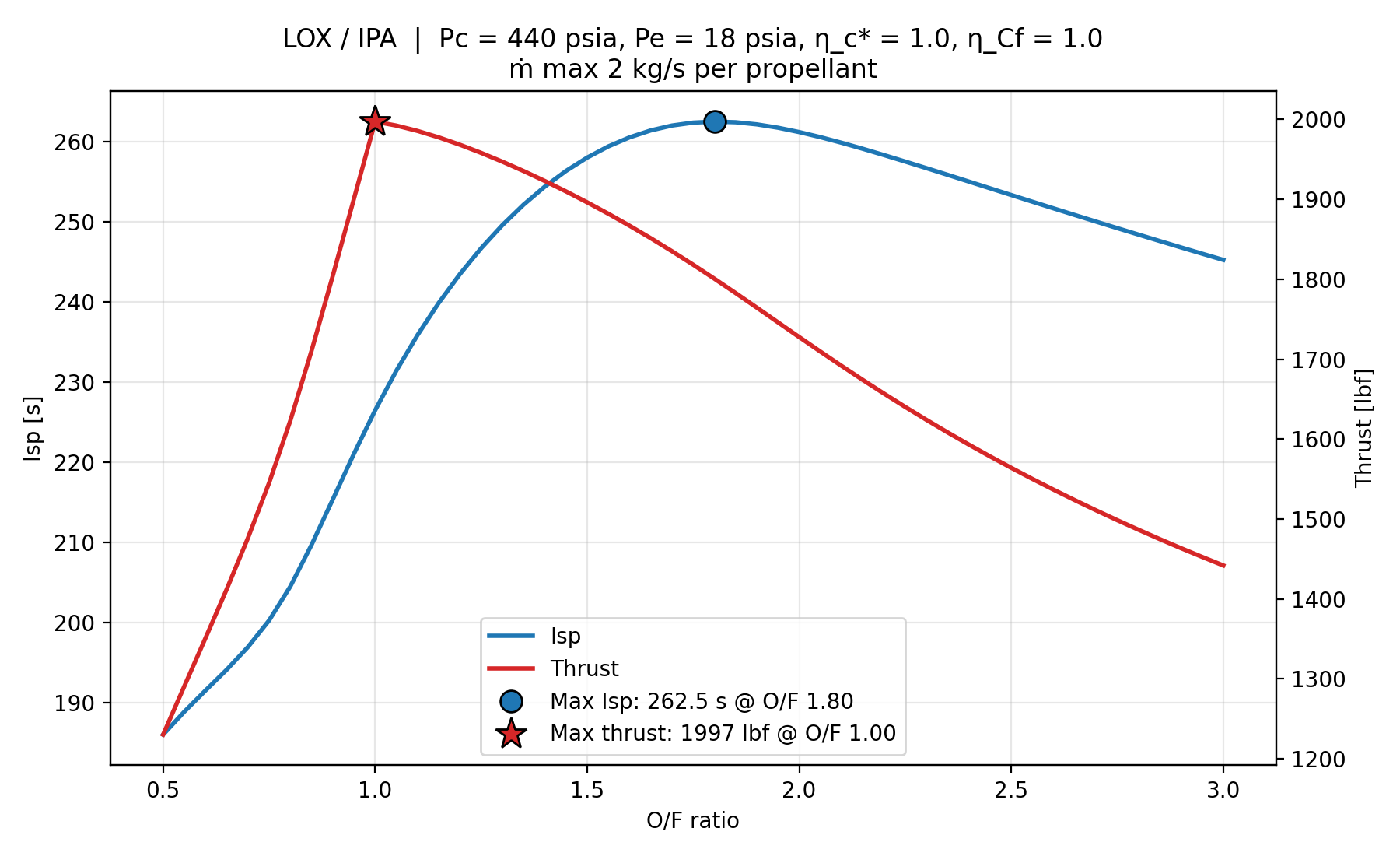
MARLIN V2/Tenkara/4 - Subteams/TCA/isp_thrust_vs_OF.png
