PURPL-Purdue/Turbopump/MARLIN V2/Tenkara/4 - Subteams/TCA/Outputs/ansys_input2_hg_vs_x.png

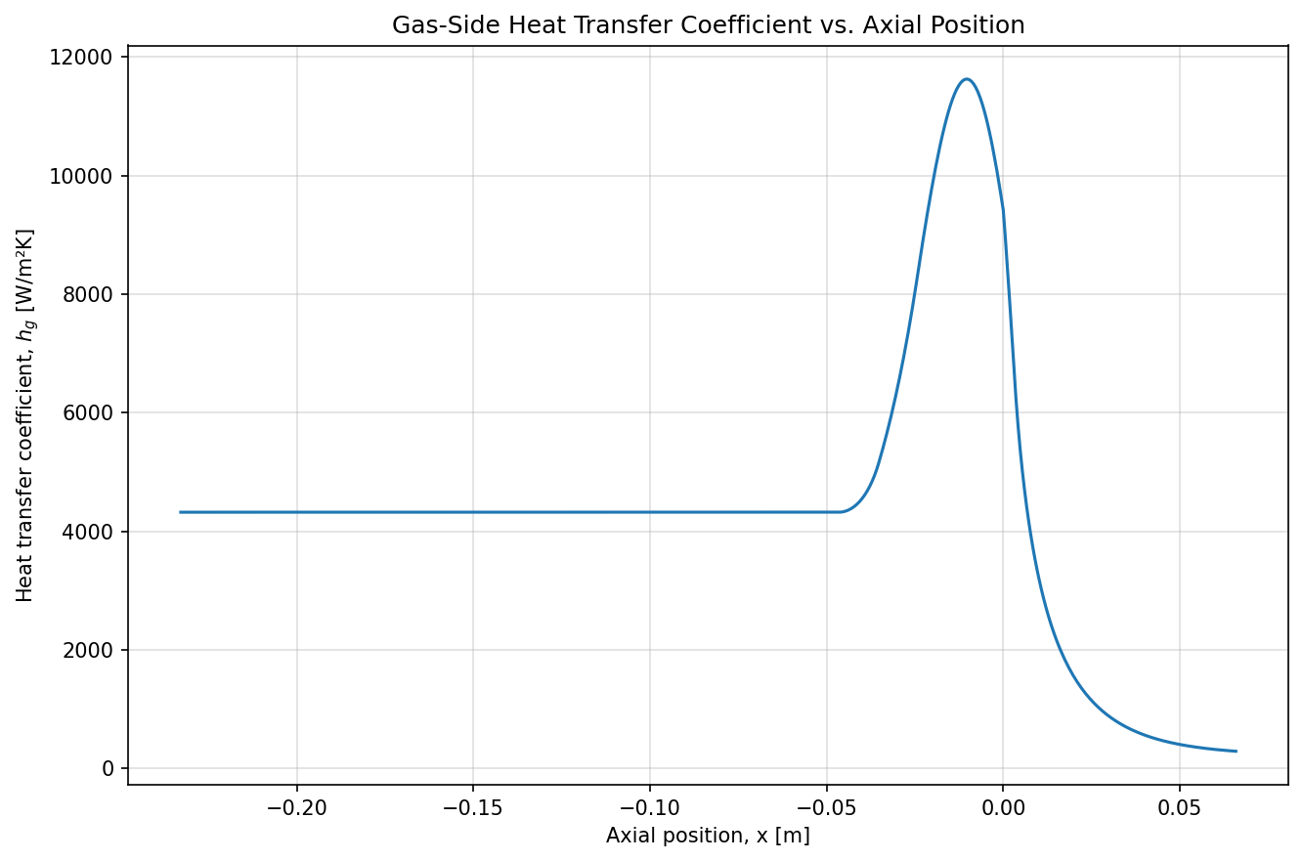
MARLIN V2/Tenkara/4 - Subteams/TCA/Outputs/ansys_input2_hg_vs_x.png
