PURPL-Purdue/Turbopump/MARLIN V1/Fall 2025/IPS Casing Subassembly/Single section Layrinth Test setup/Required Materials.docx

Size -222 oring, .139” cs 1.484” id

https://www.mcmaster.com/90128A247/ ¼ 20 x 1” hex screws
