PURPL-Purdue/Turbopump/MARLIN V2/Tenkara/4 - Subteams/TCA/Development/Archive_(5k Dev)/5k_torch/Torch Design/Torch BOM.xlsx

Part Number | Part | Price | Count | Notes
90696A159 (https://www.mcmaster.com/90696A159) | 18-8 Stainless Steel Socket Head Screw 2-64 Thread, 5/8" Long | 6.37 | 4 | pack of 50 70k psi tensile
5267T83 (https://www.mcmaster.com/5267T83) | Chemical-Resistant Viton® Fluoroelastomer O-Ring, Brown, 3/32 Fractional Width, Dash Number 117 | 21.18 | 2 | pack of 50 0-400degF
5267T78 (https://www.mcmaster.com/5267T78) | Chemical-Resistant Viton® Fluoroelastomer O-Ring, Brown, 3/32 Fractional Width, Dash Number 113 | 16.16 | 1 | pack of 50 0-400degF
2822T18 (https://www.mcmaster.com/2822T18) | Threaded Flow Control Orifice with 303 Stainless Steel Body, Plug with Hex Head, 1/8 NPT Male 0.063" | 18.83 | 1 | 1x For Use With: Air, Argon, Carbon Dioxide, Helium, Neon, Nitrogen, Oil, Water, Xenon Max. Pressure: 4,000 psi @ 70° F Temperature Range: 35° to 200° F
2822T18 (https://www.mcmaster.com/2822T18) | Threaded Flow Control Orifice with 303 Stainless Steel Body, Plug with Hex Head, 1/8 NPT Male 0.047" | 18.83 | 1 | 1x For Use With: Air, Argon, Carbon Dioxide, Helium, Neon, Nitrogen, Oil, Water, Xenon Max. Pressure: 4,000 psi @ 70° F Temperature Range: 35° to 200° F
Total |  | 81.37
