PURPL-Purdue/Turbopump/MARLIN V2/Tenkara/4 - Subteams/TCA/Development/Heatsink CDR Files/mesh_material_comparison.png

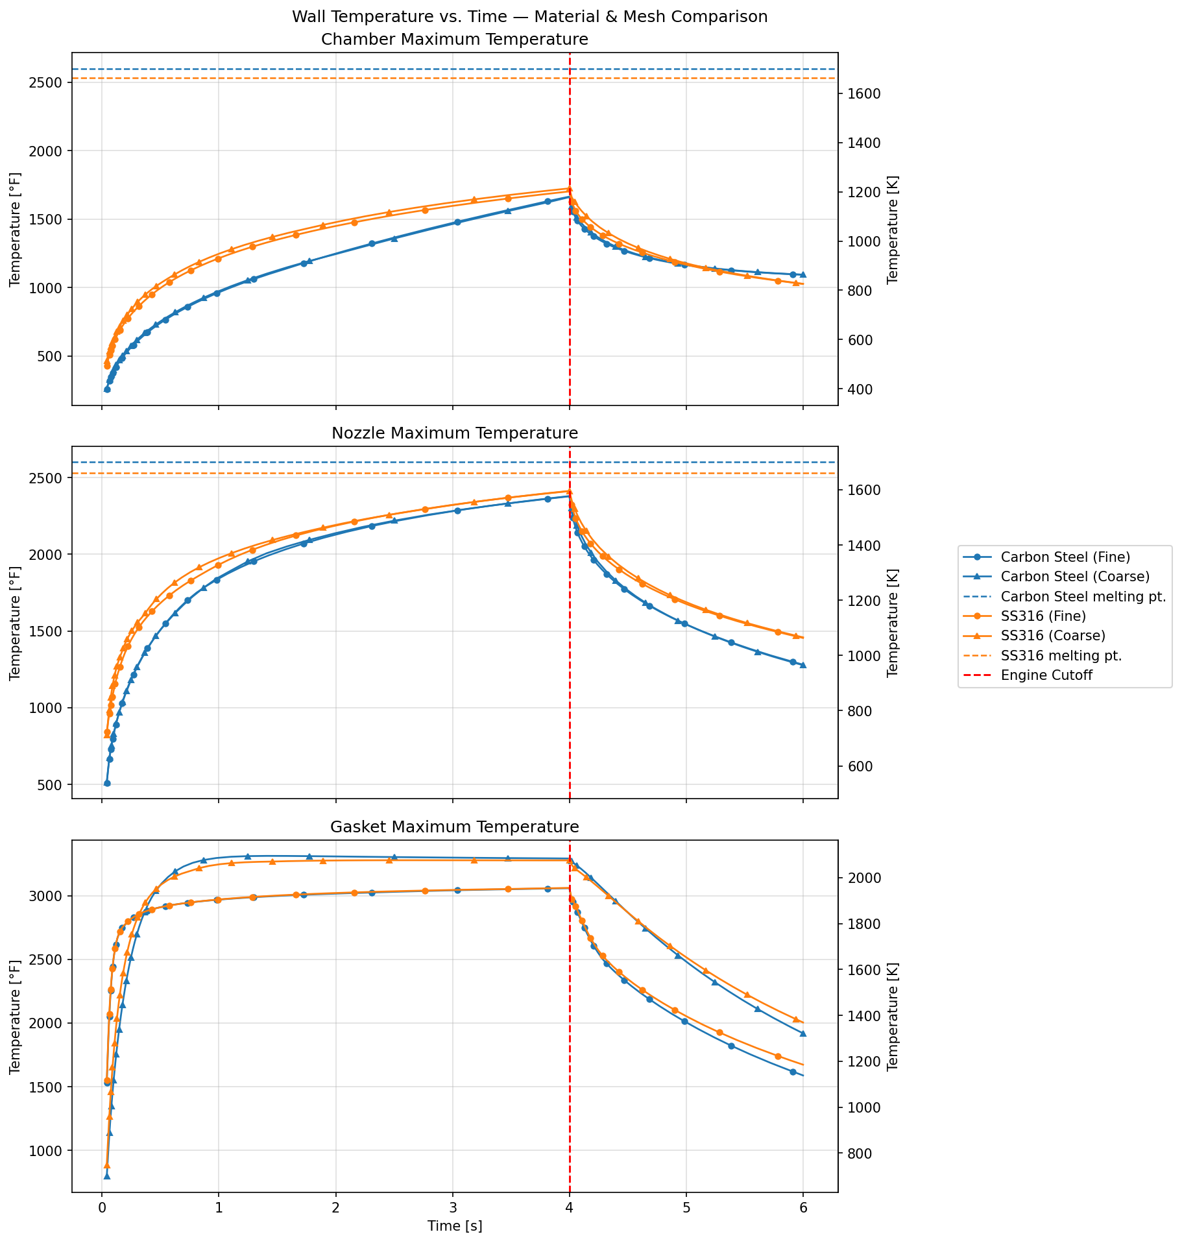
MARLIN V2/Tenkara/4 - Subteams/TCA/Development/Heatsink CDR Files/mesh_material_comparison.png
