PURPL-Purdue/Turbopump/Test Stand Assembly/Electric motor test stand/CAD/TestStandCAD.SLDASM

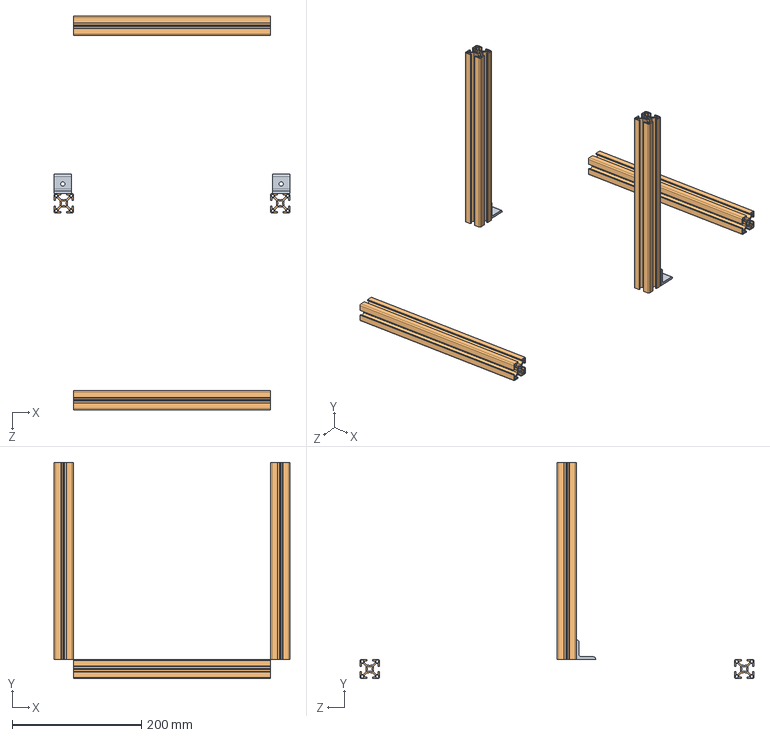
[picture p110: CAD file, 2024-11-20]
Test Stand Assembly/Electric motor test stand/CAD/TestStandCAD.SLDASM
364.8 x 334.8 x 609.6 mm
3030 X 12in x 4
8020-30-4302-BLACK x 2
