PURPL-Purdue/Turbopump/Turbine Assembly/Rotor And Stator/CAD/TRBP_FullPowerRotor.stp

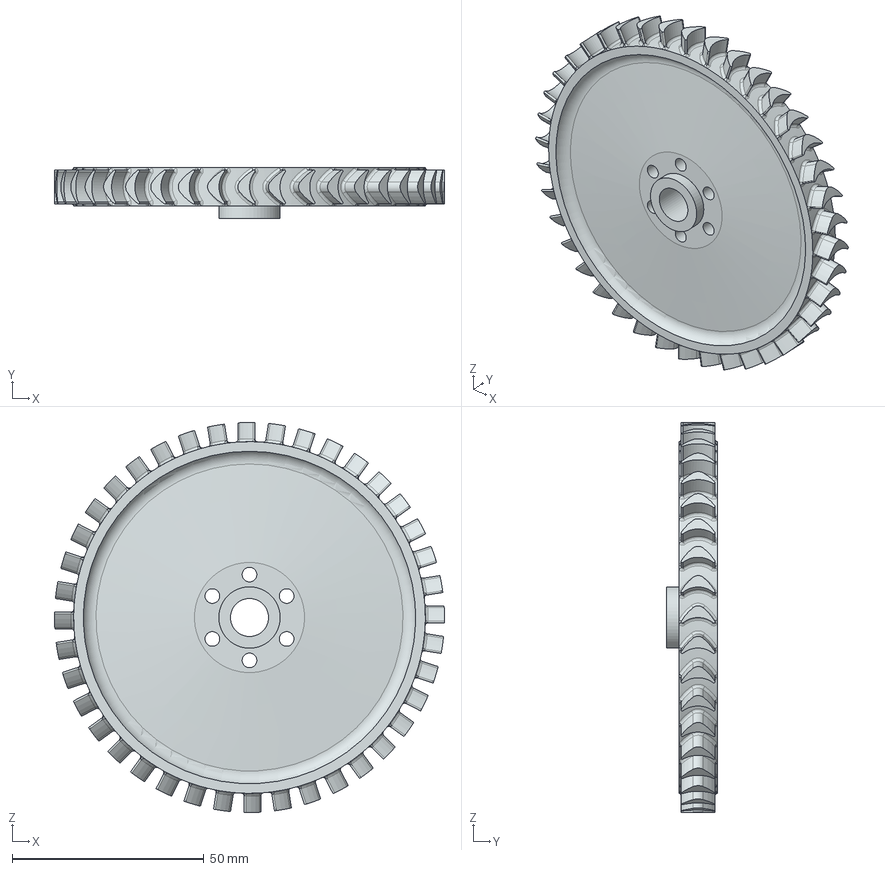
[picture p111: CAD file, 2025-02-01]
Turbine Assembly/Rotor And Stator/CAD/TRBP_FullPowerRotor.stp
101.6 x 13.2 x 101.6 mm
