PURPL-Purdue/Turbopump/Pump Assembly/Seal Testing/Test_assembly.SLDASM

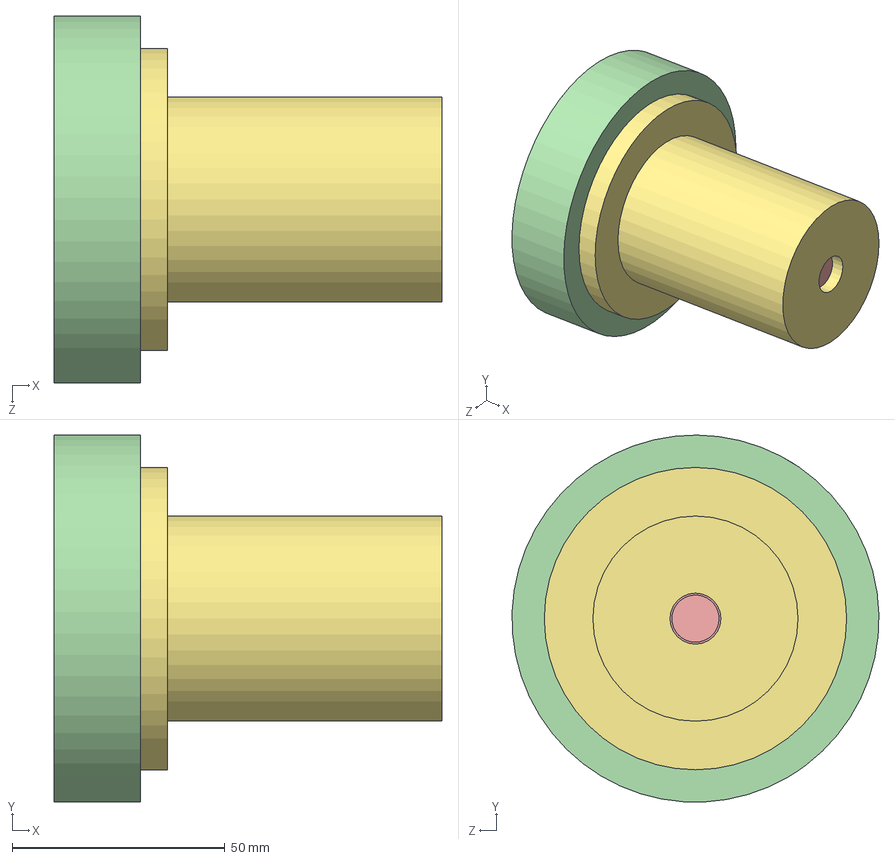
[picture p112: CAD file, 2024-11-20]
Pump Assembly/Seal Testing/Test_assembly.SLDASM
91.3 x 86.3 x 86.3 mm
IPS_Casing_test
Seal_insert_test
Seal_test_shaft
Test_Casing_Inlet
7201_cd_hcp4a_01
7201_cd_hcp4a_02
7201_cd_hcp4a_03
