PURPL-Purdue/Turbopump/Shaft Assembly/SolidWorks/7003 Bearing/7003_cd_hcp4a.SLDASM

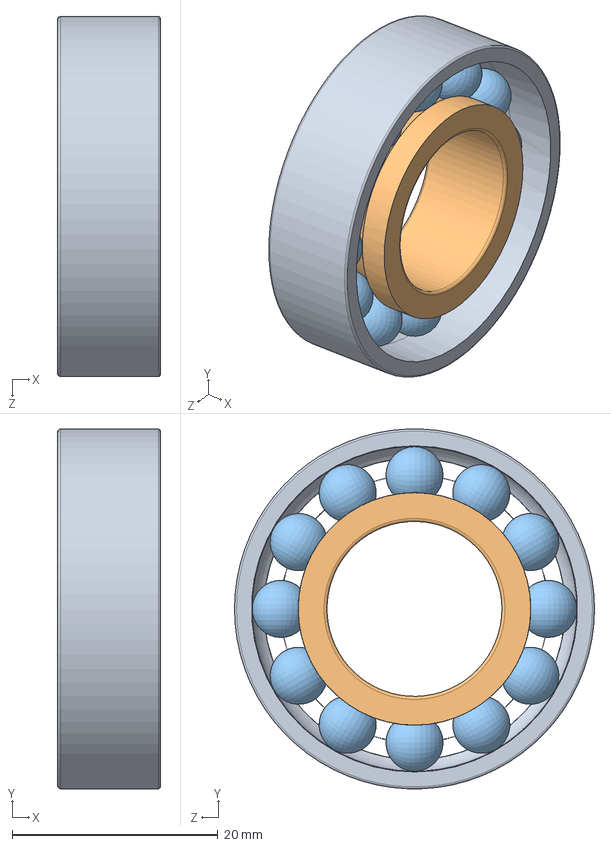
[picture p113: CAD file, 2024-11-20]
Shaft Assembly/SolidWorks/7003 Bearing/7003_cd_hcp4a.SLDASM
10.0 x 35.0 x 35.0 mm
7003_cd_hcp4a_01
7003_cd_hcp4a_02
7003_cd_hcp4a_03
