PURPL-Purdue/Turbopump/Shaft Assembly/SolidWorks/7201 Bearing/7201_cd_hcp4a.SLDASM

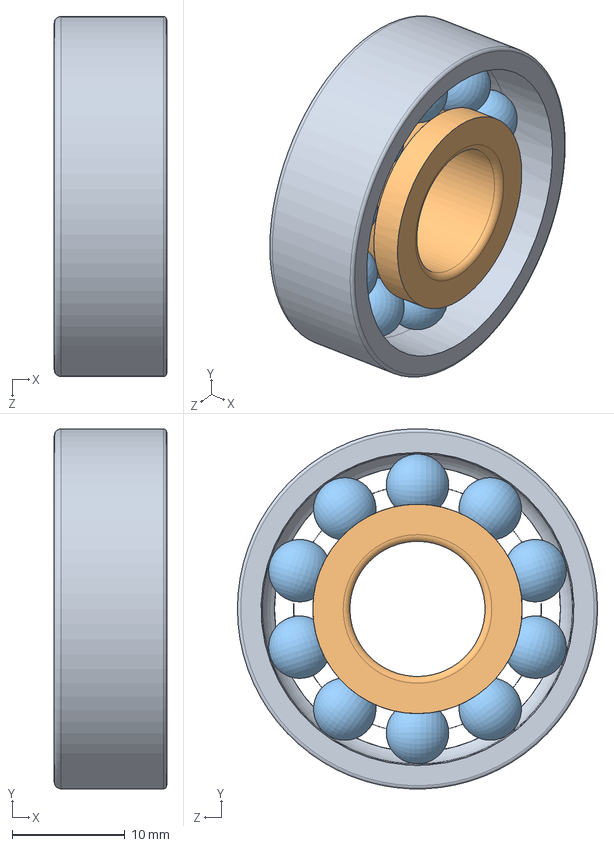
[picture p114: CAD file, 2024-11-20]
Shaft Assembly/SolidWorks/7201 Bearing/7201_cd_hcp4a.SLDASM
10.0 x 32.0 x 32.0 mm
7201_cd_hcp4a_01
7201_cd_hcp4a_02
7201_cd_hcp4a_03
