PURPL-Purdue/Turbopump/Pump Assembly/Seal Testing/1st try bad/SealTestAssembly2.SLDASM

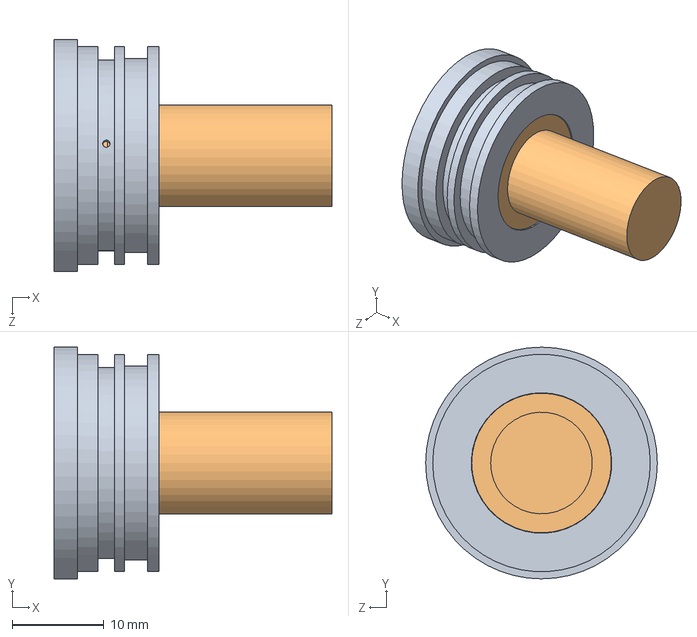
[picture p115: CAD file, 2024-11-20]
Pump Assembly/Seal Testing/1st try bad/SealTestAssembly2.SLDASM
30.4 x 25.3 x 25.3 mm
seal_on_shaft
outside insert
