PURPL-Purdue/Turbopump/Full Assembly/Gas Generator Subassembly/Grafoil gasket.SLDPRT

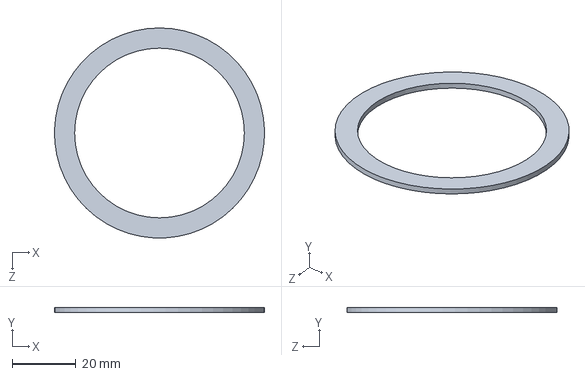
[picture p116: CAD file, 2025-02-01]
Full Assembly/Gas Generator Subassembly/Grafoil gasket.SLDPRT
66.0 x 1.59 x 66.0 mm
