PURPL-Purdue/Turbopump/MARLIN V2/Tenkara/4 - Subteams/Pumps/Code/Impeller/LOX_impeller.step

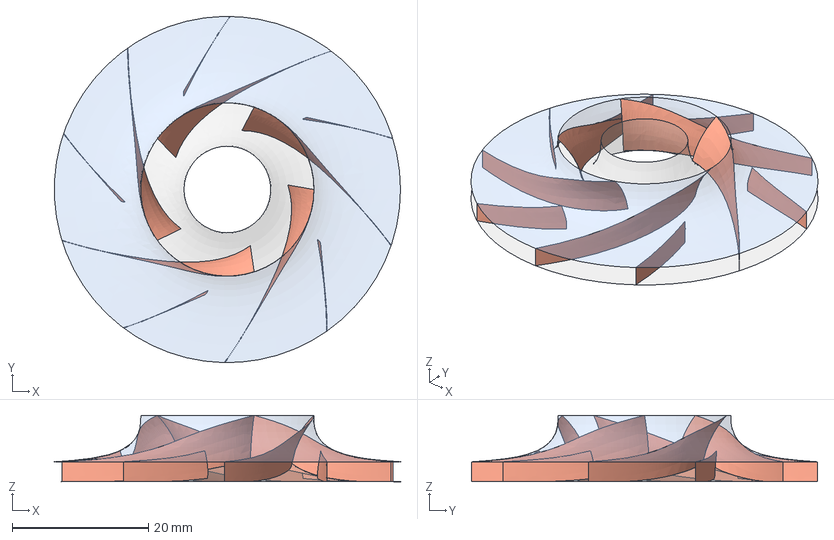
[picture p117: CAD file, 2026-11-06]
MARLIN V2/Tenkara/4 - Subteams/Pumps/Code/Impeller/LOX_impeller.step
50.8 x 50.8 x 9.75 mm
hub
shroud
blades
splitters
