PURPL-Purdue/Turbopump/MARLIN V2/Tenkara/4 - Subteams/Pumps/Outputs/IPA_impeller.step

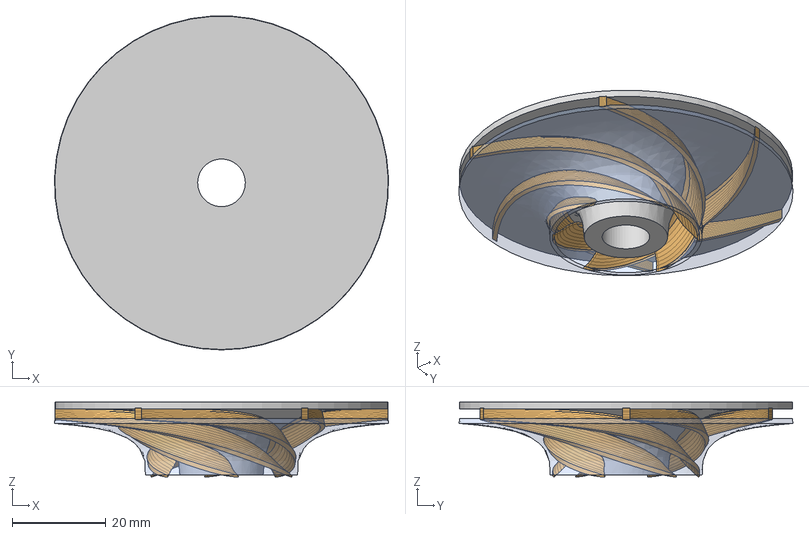
[picture p118: CAD file, 2026-10-27]
MARLIN V2/Tenkara/4 - Subteams/Pumps/Outputs/IPA_impeller.step
71.3 x 71.2 x 16.0 mm
Hub
Blade 1
Blade 2
Blade 3
Blade 4
Blade 5
Blade 6
Shroud
