PURPL-Purdue/Turbopump/MARLIN V2/Tenkara/4 - Subteams/TCA/Development/Sizing_script/CSV_DXF_OUTPUTS/nozzle_contour2600-600psi.dxf

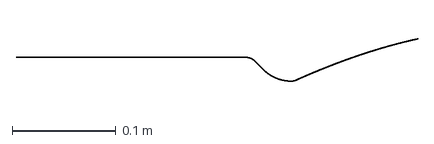
[picture p119: CAD file, 2026-08-16]
MARLIN V2/Tenkara/4 - Subteams/TCA/Development/Sizing_script/CSV_DXF_OUTPUTS/nozzle_contour2600-600psi.dxf
0.387 x 0.0408 m
