PURPL-Purdue/Turbopump/MARLIN V2/Tenkara/4 - Subteams/TCA/Outputs/contour.dxf

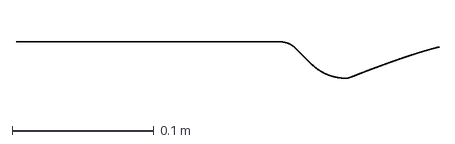
[picture p120: CAD file, 2026-09-23]
MARLIN V2/Tenkara/4 - Subteams/TCA/Outputs/contour.dxf
0.299 x 0.0257 m
