PURPL-Purdue/Turbopump/Pump Assembly/3d Printing files/Kero_Test_Case_Female1.STEP

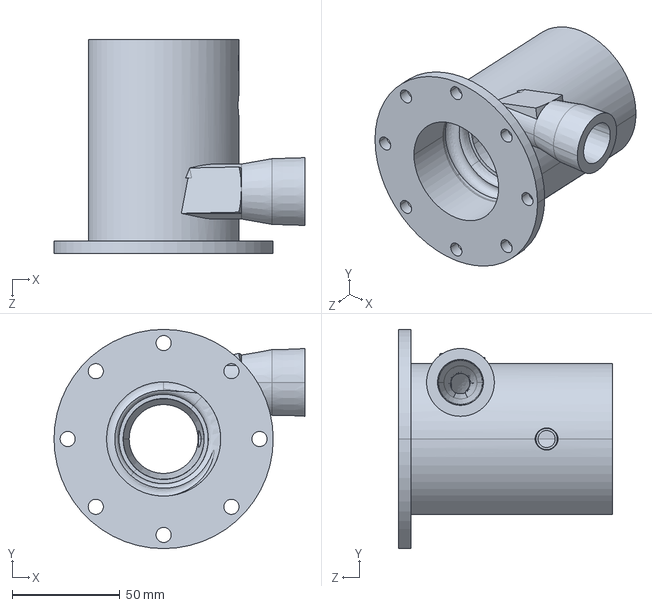
[picture p121: CAD file, 2024-10-20]
Pump Assembly/3d Printing files/Kero_Test_Case_Female1.STEP
116.3 x 101.6 x 99.1 mm
