PURPL-Purdue/Turbopump/Pump Assembly/Integration and Casings/Kero_Outlet_Volute.SLDPRT

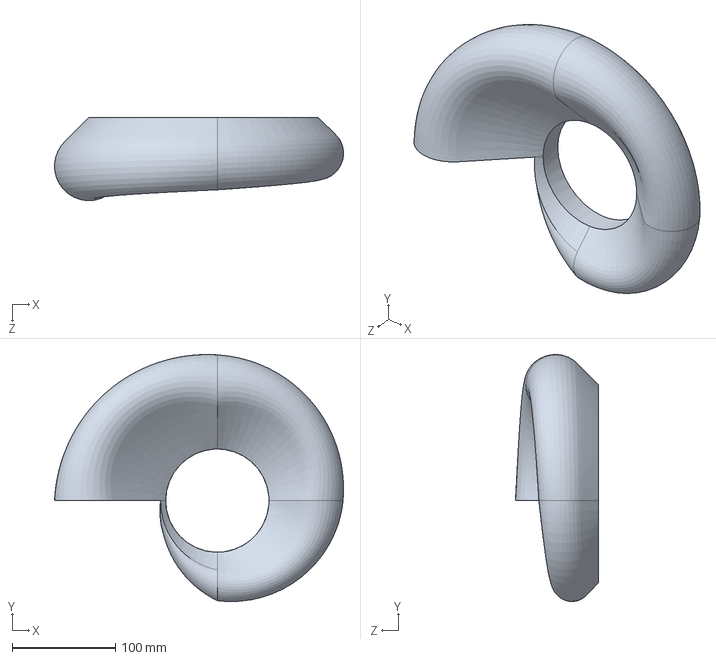
[picture p122: CAD file, 2024-12-19]
Pump Assembly/Integration and Casings/Kero_Outlet_Volute.SLDPRT
280.0 x 239.4 x 80.6 mm
