PURPL-Purdue/Turbopump/Pump Assembly/IPS assembly/NX_copy/Pumps_2_.25inchAN_fitting.STEP

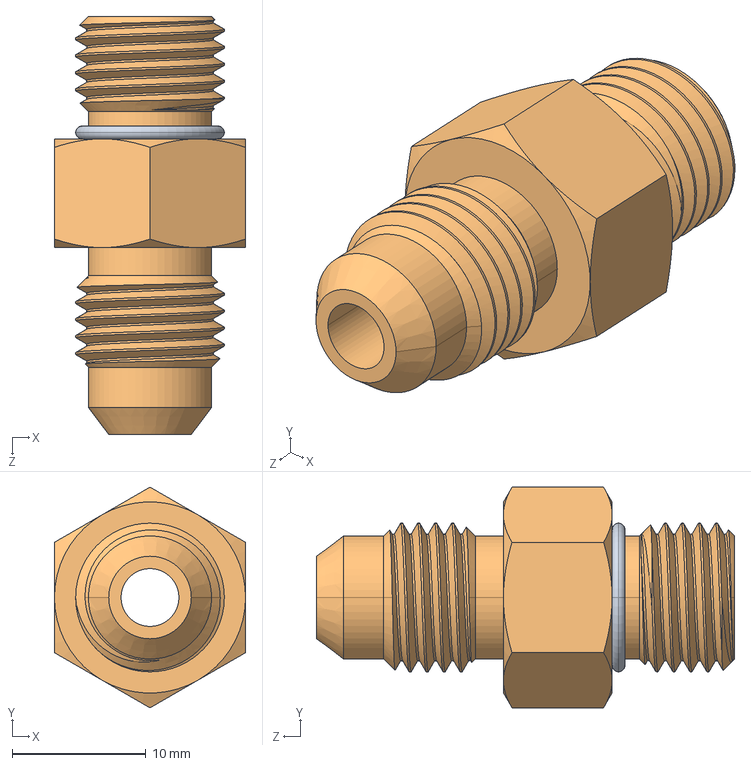
[picture p123: CAD file, 2025-01-30]
Pump Assembly/IPS assembly/NX_copy/Pumps_2_.25inchAN_fitting.STEP
14.3 x 16.5 x 31.2 mm
