PURPL-Purdue/Turbopump/Pump Assembly/Pumps/CADs/kero_postPDR_combined_pump.SLDPRT

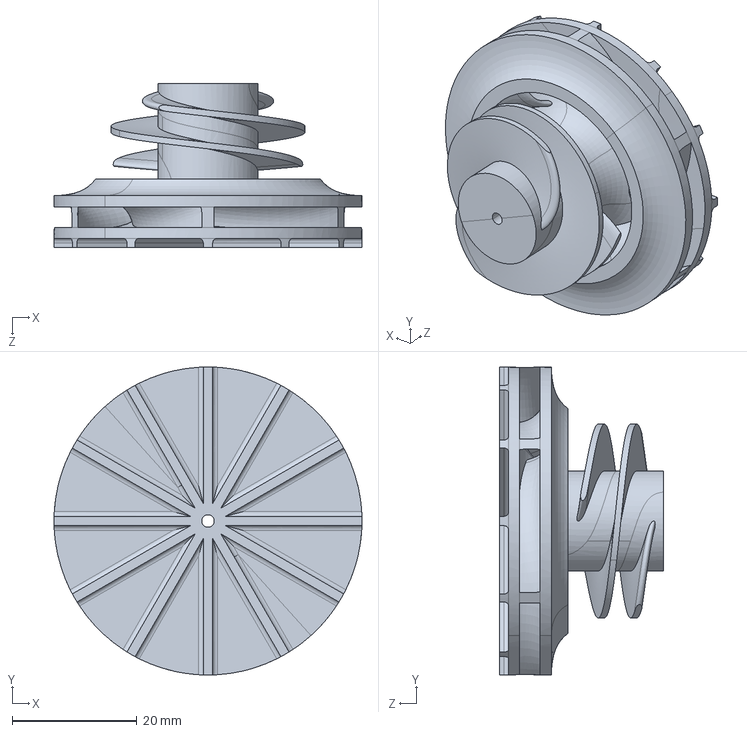
[picture p124: CAD file, 2024-12-05]
Pump Assembly/Pumps/CADs/kero_postPDR_combined_pump.SLDPRT
49.3 x 49.3 x 26.3 mm
