PURPL-Purdue/Turbopump/Pump Assembly/Pumps/Exports/LOX_PDR_impeller_integrated.STEP

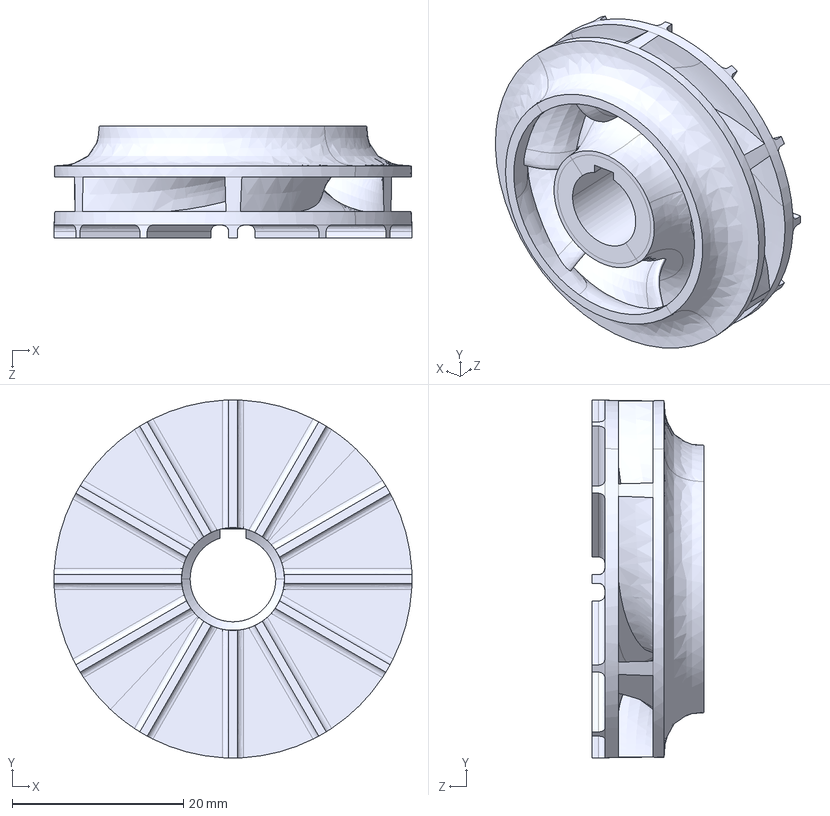
[picture p125: CAD file, 2024-11-10]
Pump Assembly/Pumps/Exports/LOX_PDR_impeller_integrated.STEP
41.8 x 41.8 x 13.1 mm
