PURPL-Purdue/Turbopump/Pump Assembly/Seal Testing/Test_Casing_Inlet.SLDPRT

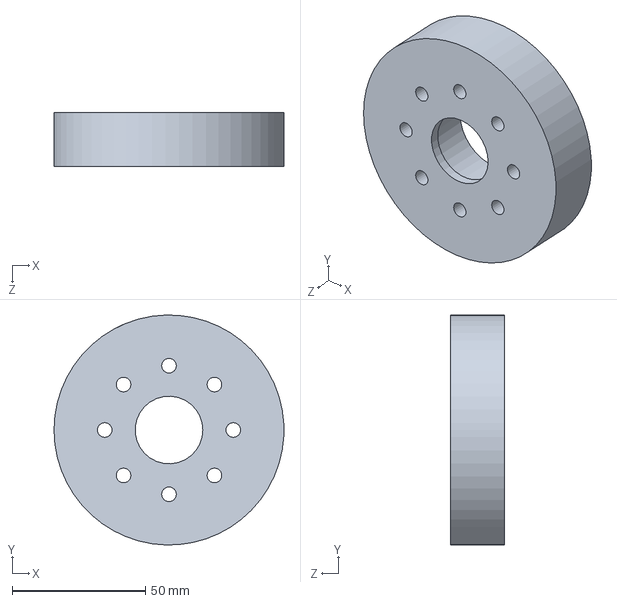
[picture p126: CAD file, 2025-01-18]
Pump Assembly/Seal Testing/Test_Casing_Inlet.SLDPRT
86.4 x 86.3 x 20.3 mm
