PURPL-Purdue/Turbopump/Shaft Assembly/SolidWorks/7003 Bearing/7003_cd_hcp4a_03.SLDPRT

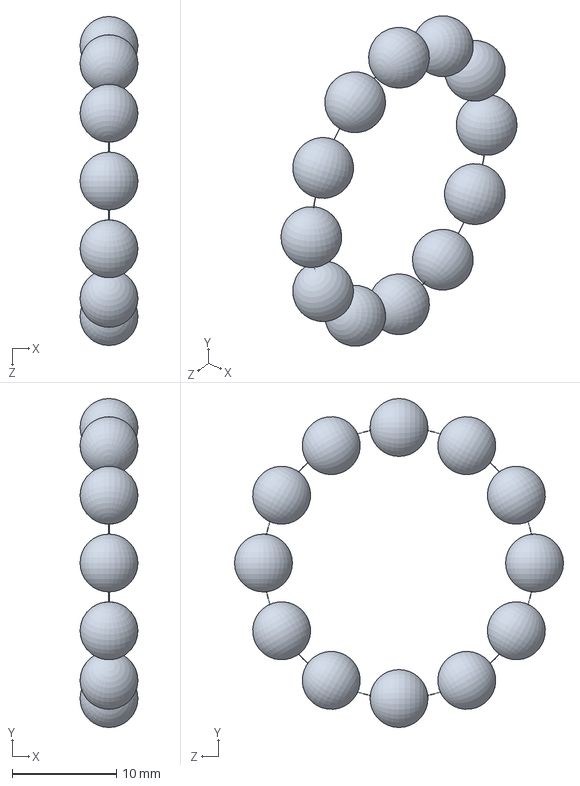
[picture p127: CAD file, 2024-11-20]
Shaft Assembly/SolidWorks/7003 Bearing/7003_cd_hcp4a_03.SLDPRT
5.56 x 31.6 x 31.6 mm
