PURPL-Purdue/Turbopump/Shaft Assembly/SolidWorks/7201 Bearing/7201_cd_hcp4a_03.SLDPRT

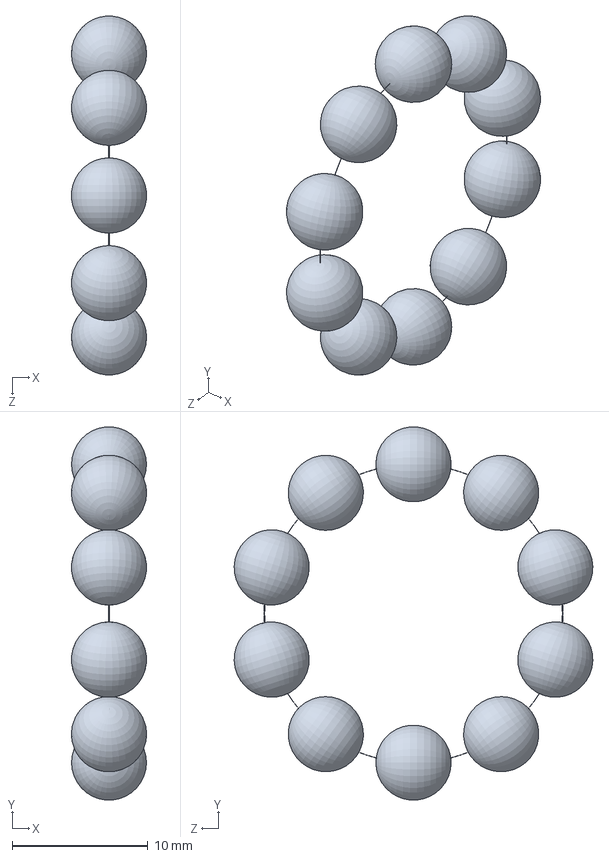
[picture p128: CAD file, 2024-11-20]
Shaft Assembly/SolidWorks/7201 Bearing/7201_cd_hcp4a_03.SLDPRT
5.53 x 27.5 x 26.5 mm
