PURPL-Purdue/Turbopump/Shaft Assembly/SolidWorks/PDR_Shaft.SLDPRT

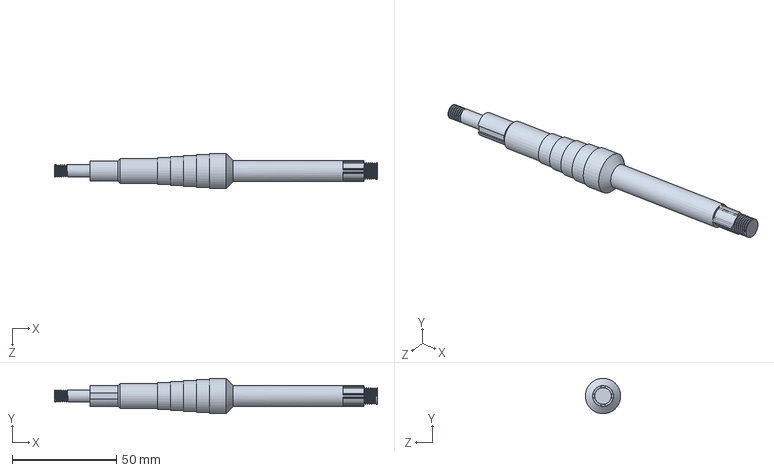
[picture p129: CAD file, 2025-01-27]
Shaft Assembly/SolidWorks/PDR_Shaft.SLDPRT
155.2 x 17.0 x 17.0 mm
