PURPL-Purdue/Turbopump/Turbine Assembly/Gas Generator/CAD/Chamber/GasGeneratorChamberV6.SLDPRT

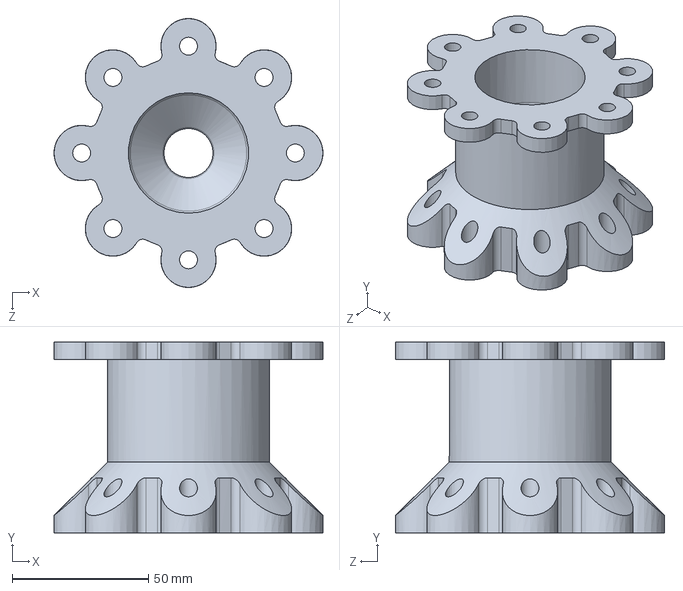
[picture p130: CAD file, 2024-10-20]
Turbine Assembly/Gas Generator/CAD/Chamber/GasGeneratorChamberV6.SLDPRT
98.8 x 70.0 x 98.8 mm
