PURPL-Purdue/Turbopump/Turbine Assembly/Gas Generator/CAD/Chamber/Torch Mount/GasGenerator Torch to Chamber Mount.SLDPRT

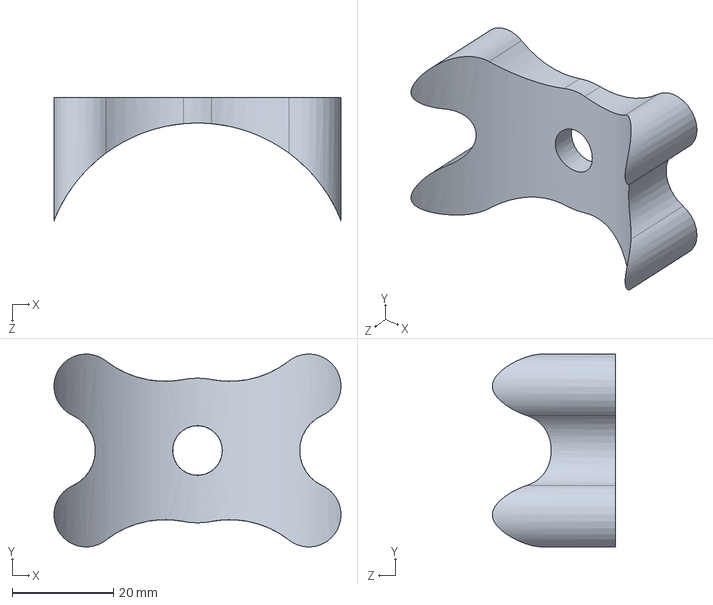
[picture p131: CAD file, 2024-11-10]
Turbine Assembly/Gas Generator/CAD/Chamber/Torch Mount/GasGenerator Torch to Chamber Mount.SLDPRT
56.7 x 38.1 x 24.4 mm
