PURPL-Purdue/Turbopump/Turbine Assembly/Gas Generator/CAD/Injector/GasGenerator_Injector_Test.SLDPRT

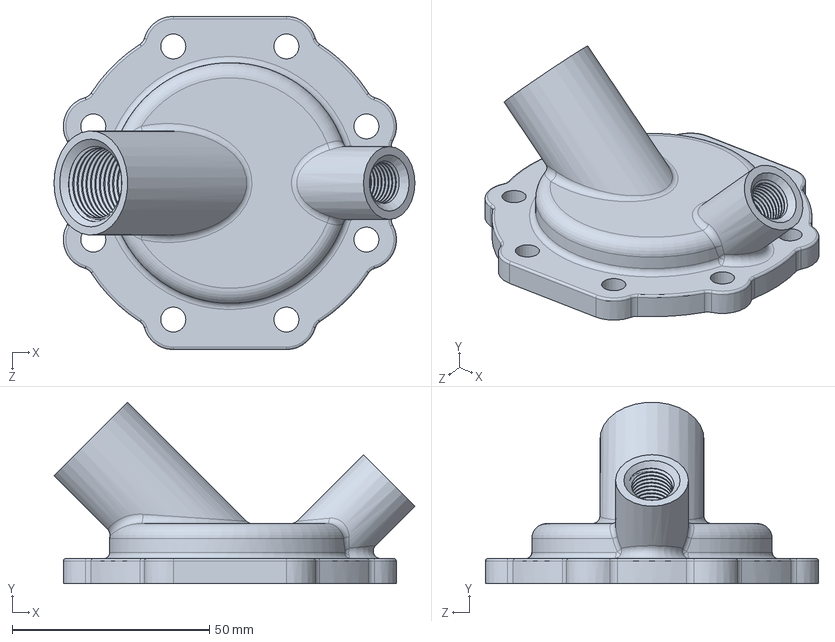
[picture p132: CAD file, 2025-01-27]
Turbine Assembly/Gas Generator/CAD/Injector/GasGenerator_Injector_Test.SLDPRT
91.5 x 45.9 x 84.5 mm
