PURPL-Purdue/Turbopump/Turbine Assembly/Gas Generator/CAD/Test nozzle/Test nozzle 10-17.SLDPRT

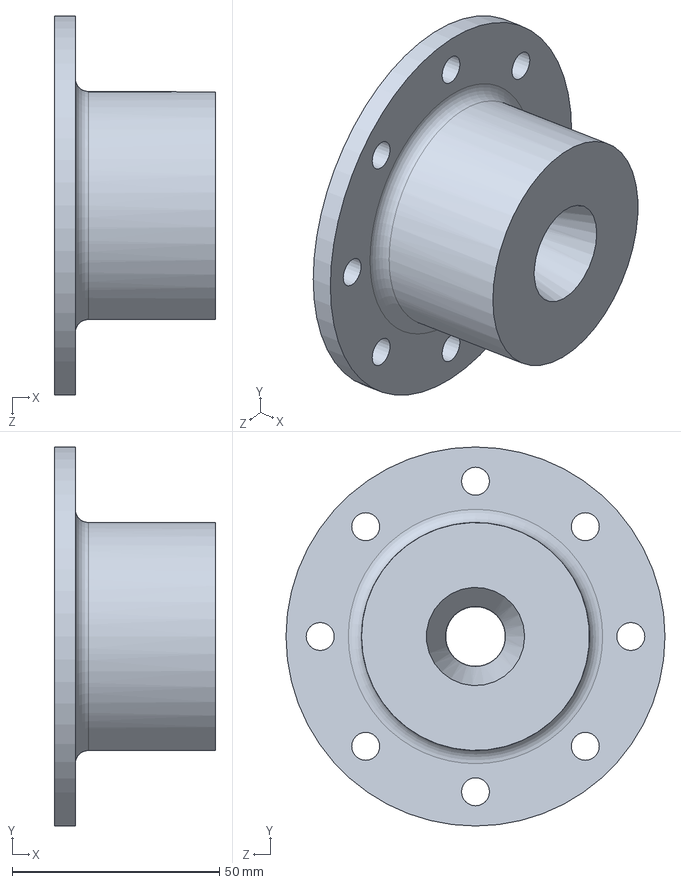
[picture p133: CAD file, 2025-02-15]
Turbine Assembly/Gas Generator/CAD/Test nozzle/Test nozzle 10-17.SLDPRT
39.0 x 91.4 x 91.4 mm
