PURPL-Purdue/Turbopump/MARLIN V2/Tenkara/4 - Subteams/Pumps/Code/Impeller/IPA_impeller.step

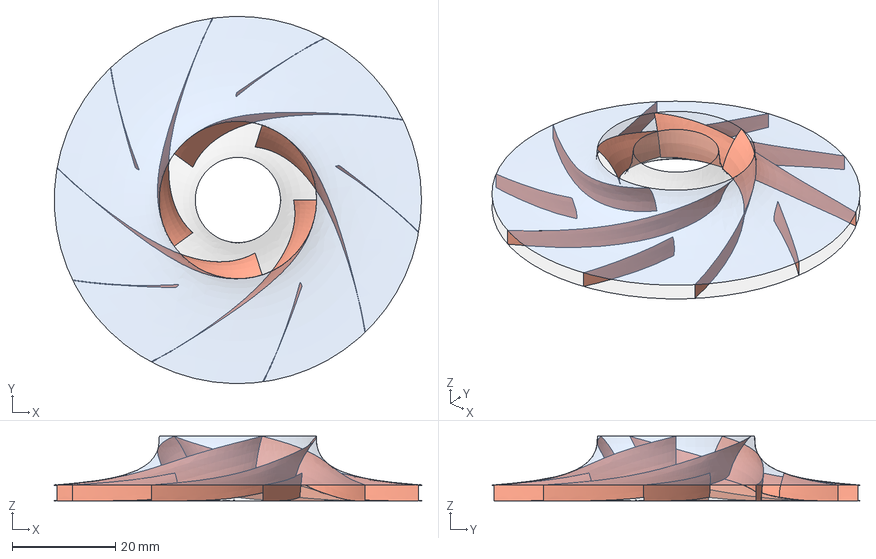
[picture p134: CAD file, 2026-11-06]
MARLIN V2/Tenkara/4 - Subteams/Pumps/Code/Impeller/IPA_impeller.step
71.1 x 71.1 x 12.5 mm
hub
shroud
blades
splitters
