PURPL-Purdue/Turbopump/MARLIN V2/Tenkara/4 - Subteams/TCA/Development/Sizing_script/CSV_DXF_OUTPUTS/nozzle_contour4k.dxf

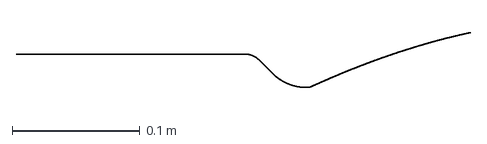
[picture p135: CAD file, 2026-06-07]
MARLIN V2/Tenkara/4 - Subteams/TCA/Development/Sizing_script/CSV_DXF_OUTPUTS/nozzle_contour4k.dxf
0.356 x 0.0431 m
