PURPL-Purdue/Turbopump/Pump Assembly/3d Printing files/Test1_Seal_Casing.STEP

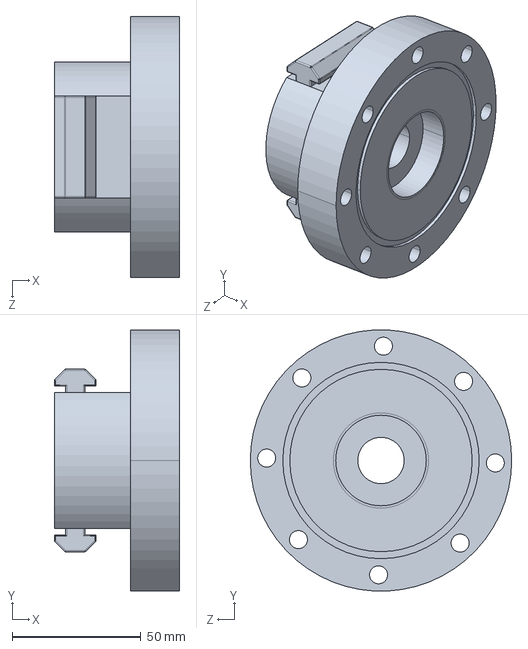
[picture p136: CAD file, 2024-10-20]
Pump Assembly/3d Printing files/Test1_Seal_Casing.STEP
48.8 x 101.5 x 101.6 mm
