PURPL-Purdue/Turbopump/Pump Assembly/IPS assembly/Static_Testing_Rig/Seal_Test_insert.SLDPRT

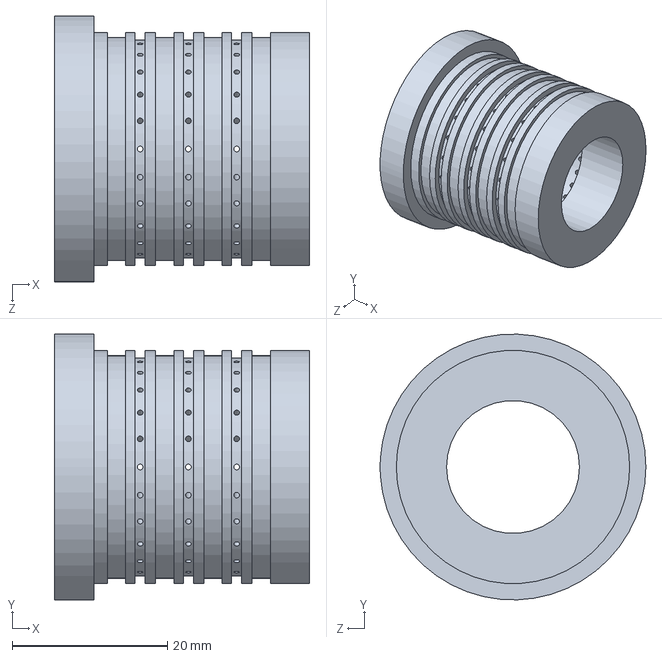
[picture p137: CAD file, 2025-01-21]
Pump Assembly/IPS assembly/Static_Testing_Rig/Seal_Test_insert.SLDPRT
32.9 x 34.3 x 34.3 mm
