PURPL-Purdue/Turbopump/Pump Assembly/Pumps/CADs/lox_postPDR_combined_pump.SLDPRT

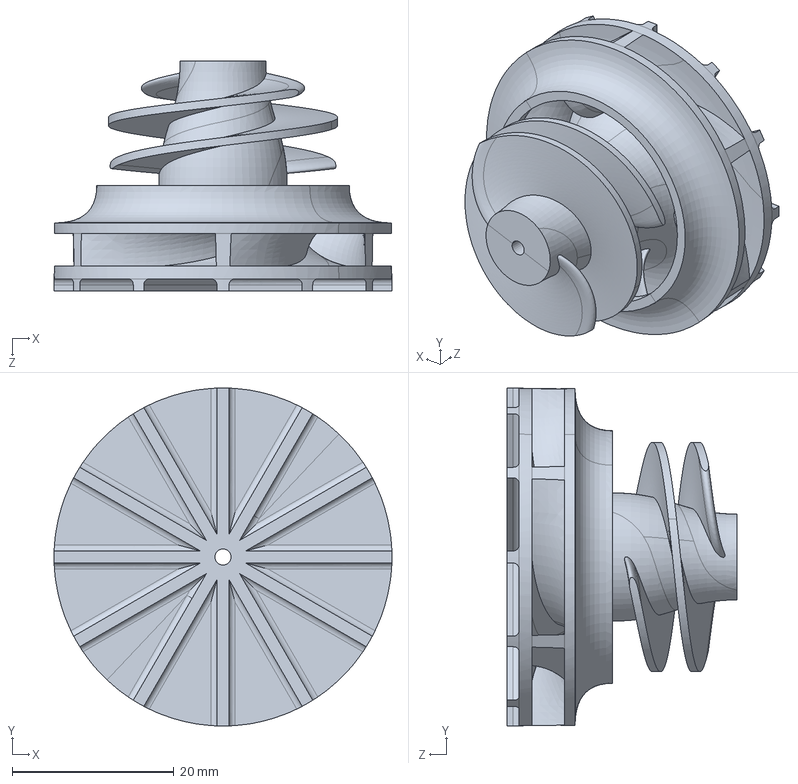
[picture p138: CAD file, 2024-12-05]
Pump Assembly/Pumps/CADs/lox_postPDR_combined_pump.SLDPRT
41.8 x 41.8 x 28.4 mm
