PURPL-Purdue/Turbopump/Pump Assembly/Pumps/Exports/LOX_PDR_inducer_integrated.STEP

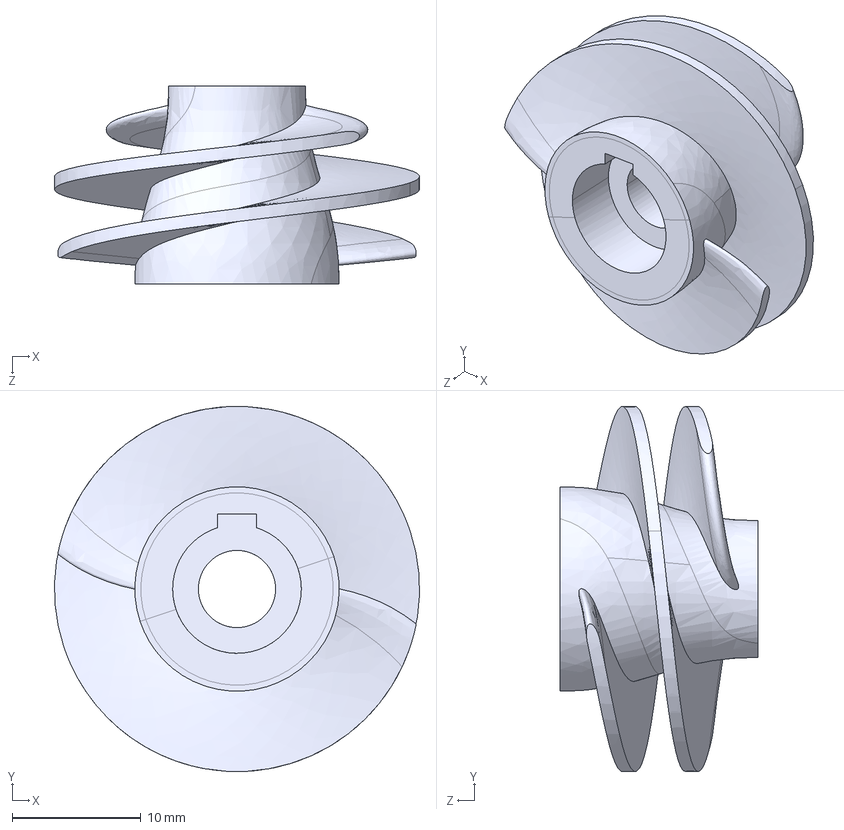
[picture p139: CAD file, 2024-11-10]
Pump Assembly/Pumps/Exports/LOX_PDR_inducer_integrated.STEP
28.4 x 28.4 x 15.4 mm
