PURPL-Purdue/Turbopump/Pump Assembly/Seal Testing/1st try bad/seal_test_shaft.SLDPRT

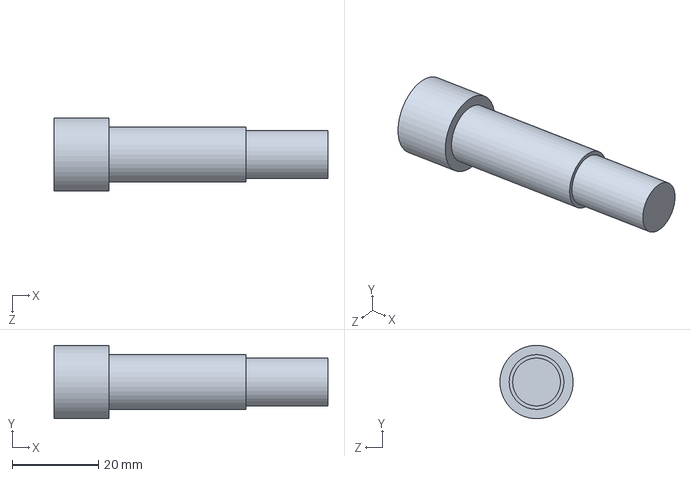
[picture p140: CAD file, 2024-11-20]
Pump Assembly/Seal Testing/1st try bad/seal_test_shaft.SLDPRT
63.5 x 17.0 x 17.0 mm
