PURPL-Purdue/Turbopump/Shaft Assembly/SolidWorks/7003 Bearing/7003_cd_hcp4a_01.SLDPRT

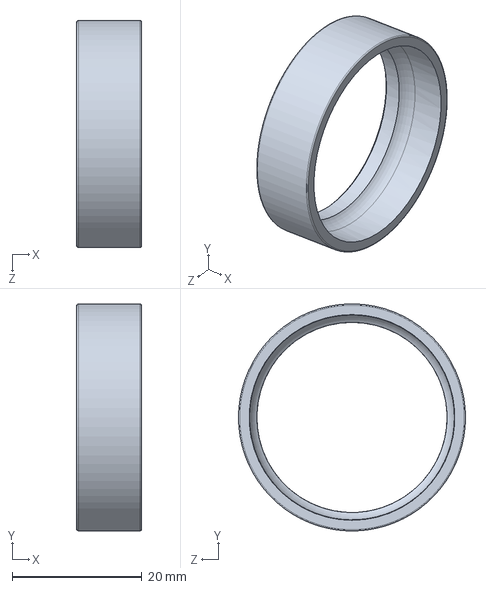
[picture p141: CAD file, 2024-11-20]
Shaft Assembly/SolidWorks/7003 Bearing/7003_cd_hcp4a_01.SLDPRT
10.0 x 35.0 x 35.0 mm
