PURPL-Purdue/Turbopump/Shaft Assembly/SolidWorks/7201 Bearing/7201_cd_hcp4a_01.SLDPRT

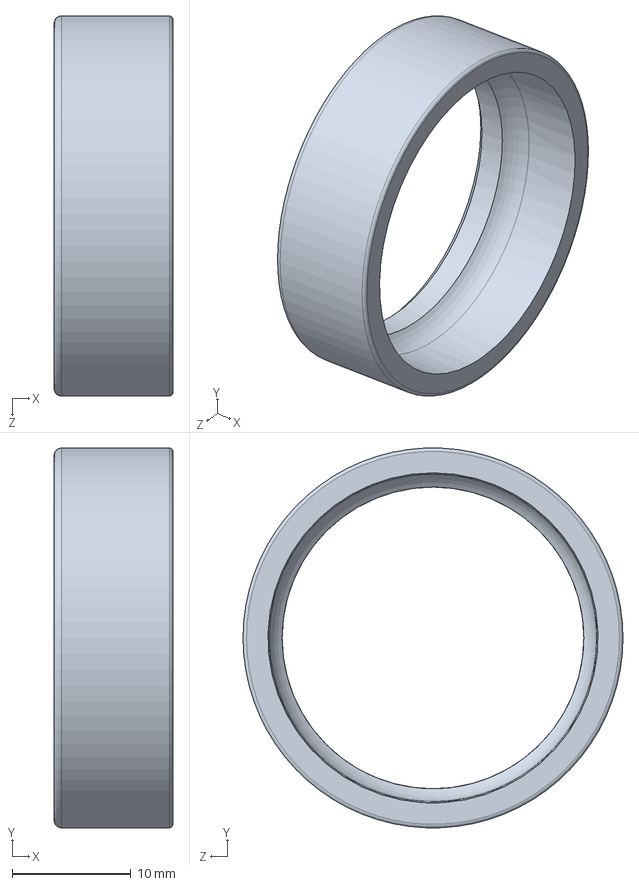
[picture p142: CAD file, 2024-11-20]
Shaft Assembly/SolidWorks/7201 Bearing/7201_cd_hcp4a_01.SLDPRT
10.0 x 32.0 x 32.0 mm
