PURPL-Purdue/Turbopump/Shaft Assembly/SolidWorks/PDR_Shaft_Sleeve.SLDPRT

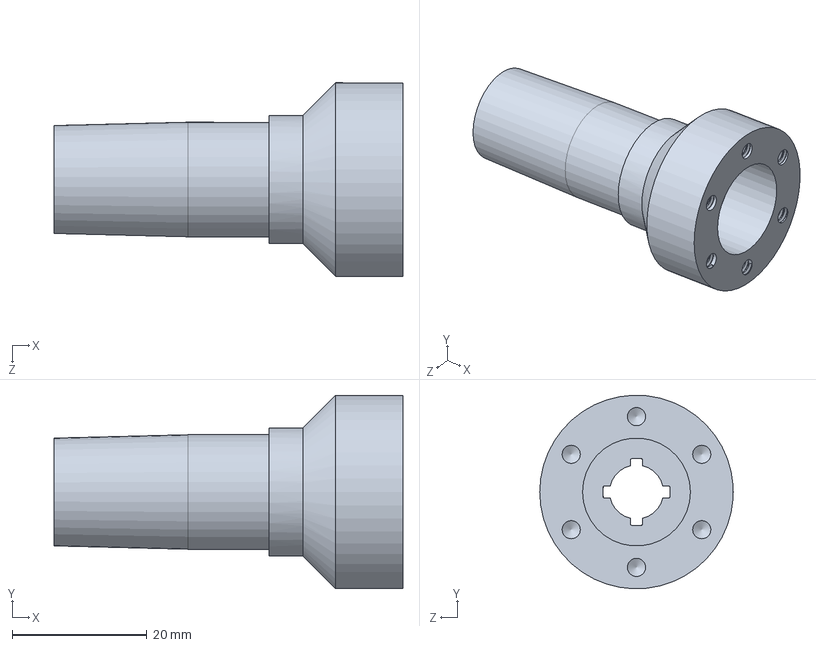
[picture p143: CAD file, 2024-11-20]
Shaft Assembly/SolidWorks/PDR_Shaft_Sleeve.SLDPRT
51.8 x 28.7 x 28.7 mm
