PURPL-Purdue/Turbopump/TCA/Countour Exports/combined_curve.dxf

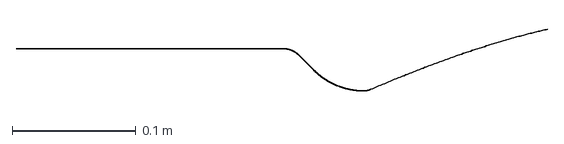
[picture p144: CAD file, 2025-11-19]
TCA/Countour Exports/combined_curve.dxf
0.429 x 0.0497 m
