PURPL-Purdue/Turbopump/Test Stand Assembly/Electric motor test stand/CAD/8020-30-4302-BLACK.sldprt

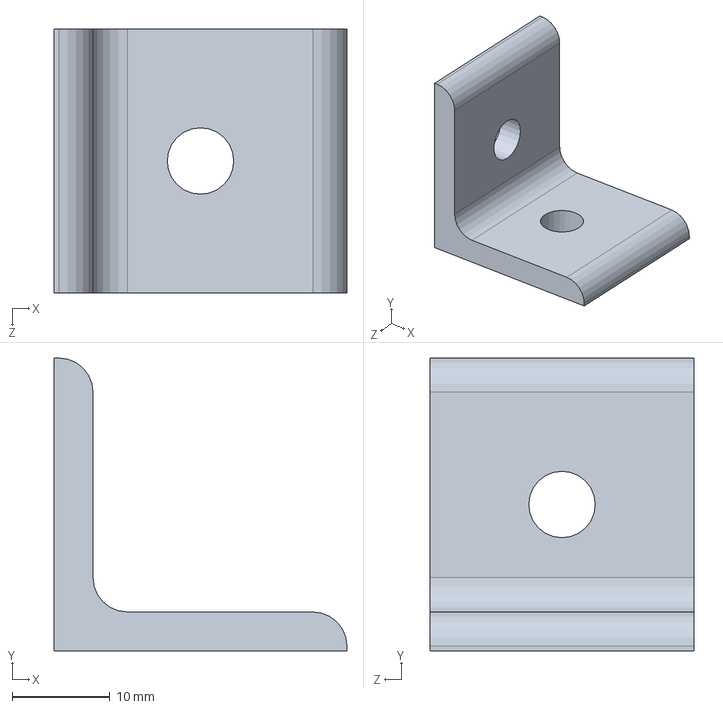
[picture p145: CAD file, 2024-11-17]
Test Stand Assembly/Electric motor test stand/CAD/8020-30-4302-BLACK.sldprt
30.0 x 30.0 x 27.0 mm
