PURPL-Purdue/Turbopump/Turbine Assembly/Gas Generator/CAD/Test nozzle/Test Nozzle v1.0.SLDPRT

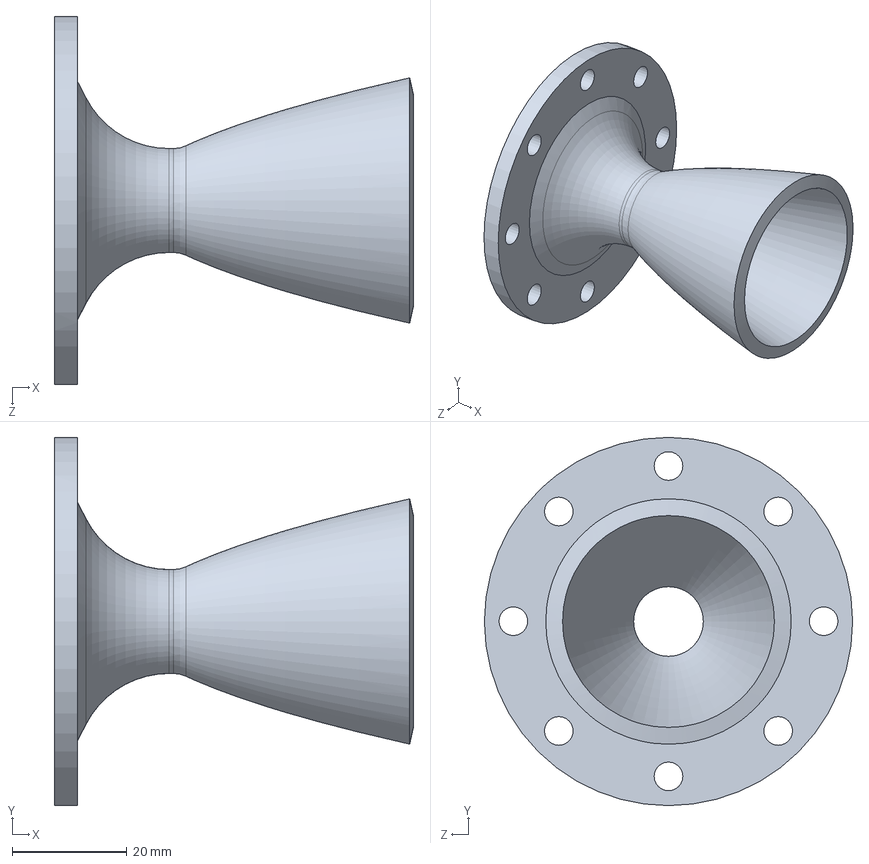
[picture p146: CAD file, 2024-10-20]
Turbine Assembly/Gas Generator/CAD/Test nozzle/Test Nozzle v1.0.SLDPRT
62.6 x 64.2 x 64.2 mm
