PURPL-Purdue/Turbopump/Turbine Assembly/Rotor And Stator/CAD/TRBP_X0_Stator.SLDPRT

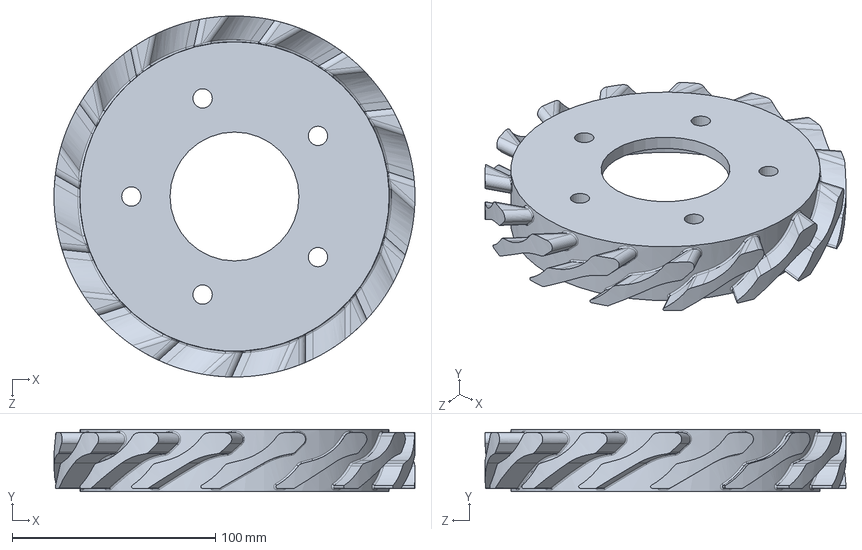
[picture p147: CAD file, 2024-12-31]
Turbine Assembly/Rotor And Stator/CAD/TRBP_X0_Stator.SLDPRT
177.8 x 30.6 x 177.8 mm
