PURPL-Purdue/Turbopump/Pump Assembly/3d Printing files/Kero_Test_Case_Male1.STEP

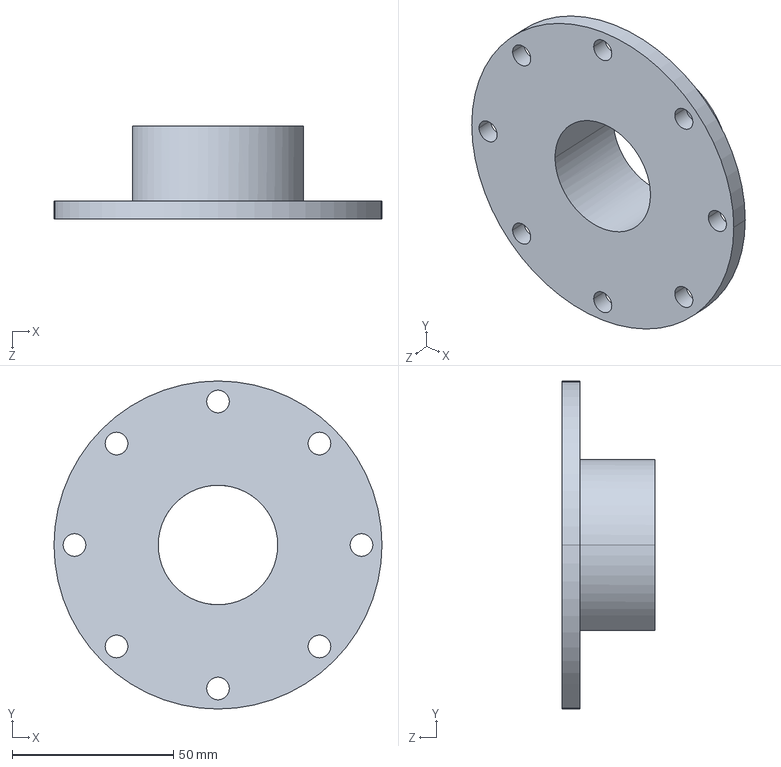
[picture p148: CAD file, 2024-10-20]
Pump Assembly/3d Printing files/Kero_Test_Case_Male1.STEP
101.6 x 101.6 x 28.9 mm
