PURPL-Purdue/Turbopump/Pump Assembly/Integration and Casings/COTS parts/8020-30-3030 X 300.SLDPRT

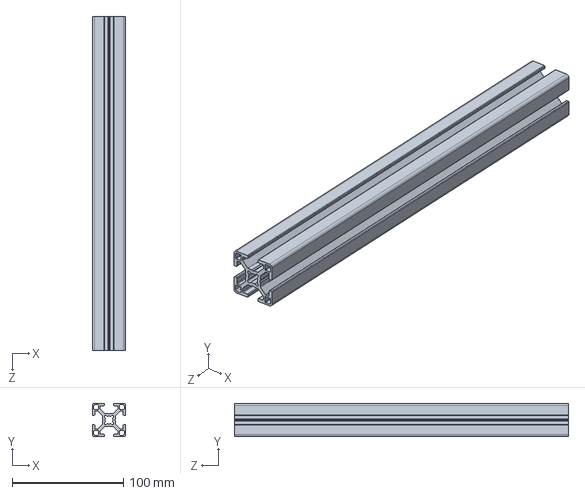
[picture p149: CAD file, 2024-10-20]
Pump Assembly/Integration and Casings/COTS parts/8020-30-3030 X 300.SLDPRT
30.0 x 30.0 x 300.0 mm
