PURPL-Purdue/Turbopump/Pump Assembly/Integration and Casings/Kero_Test_Case_Male1.SLDPRT

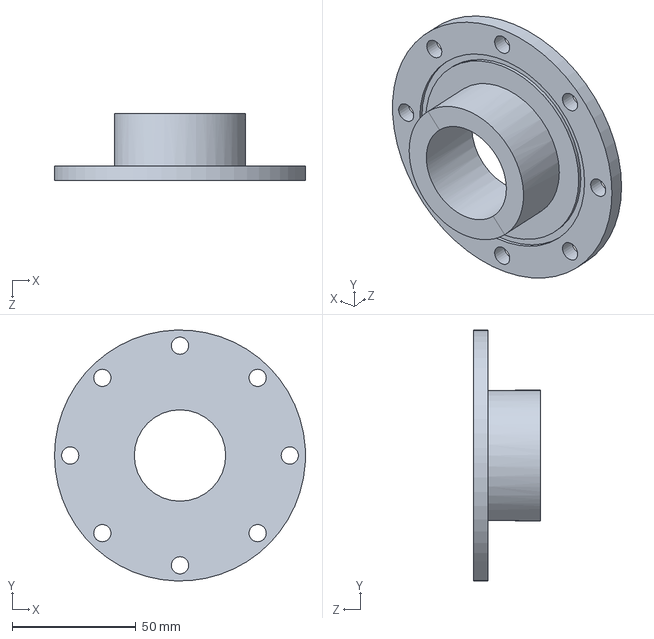
[picture p150: CAD file, 2024-11-20]
Pump Assembly/Integration and Casings/Kero_Test_Case_Male1.SLDPRT
101.6 x 101.6 x 26.9 mm
