PURPL-Purdue/Turbopump/Pump Assembly/IPS assembly/cfd_sketch2.SLDPRT

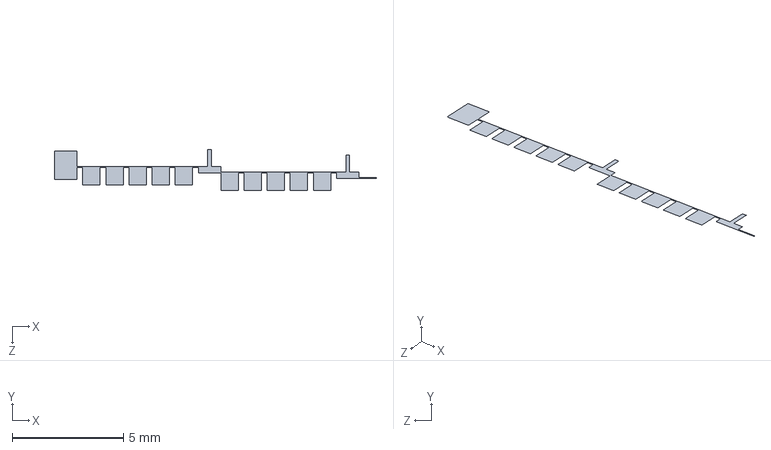
[picture p151: CAD file, 2025-01-10]
Pump Assembly/IPS assembly/cfd_sketch2.SLDPRT
14.5 x 0 x 1.85 mm
