PURPL-Purdue/Turbopump/Pump Assembly/Pumps/CADs/lox_postPDR_impeller_material.stp

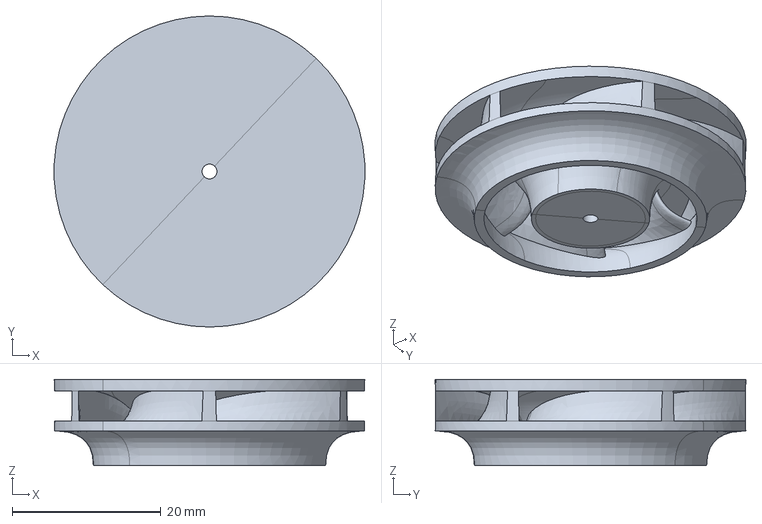
[picture p152: CAD file, 2024-12-01]
Pump Assembly/Pumps/CADs/lox_postPDR_impeller_material.stp
41.7 x 41.8 x 11.6 mm
