PURPL-Purdue/Turbopump/Pump Assembly/Seal Testing/1st try bad/outside insert.SLDPRT

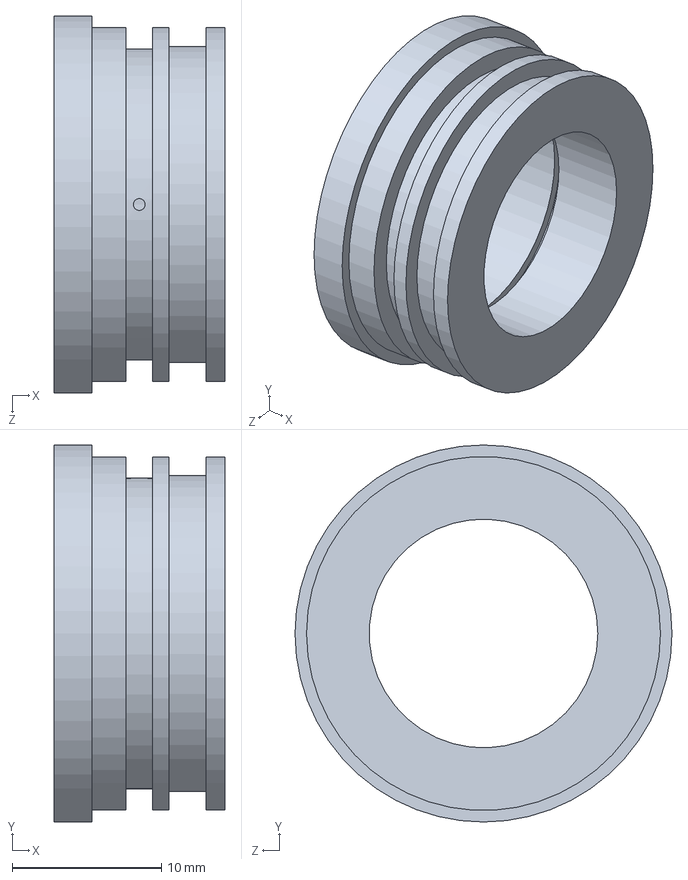
[picture p153: CAD file, 2024-11-20]
Pump Assembly/Seal Testing/1st try bad/outside insert.SLDPRT
11.5 x 25.3 x 25.3 mm
