PURPL-Purdue/Turbopump/Pump Assembly/Seal Testing/IPS_Casing_test.SLDPRT

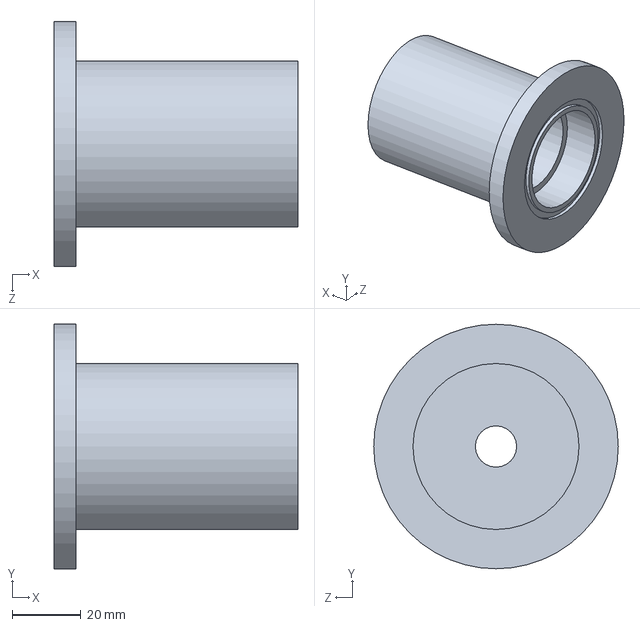
[picture p154: CAD file, 2024-11-20]
Pump Assembly/Seal Testing/IPS_Casing_test.SLDPRT
71.0 x 71.1 x 71.1 mm
