PURPL-Purdue/Turbopump/Shaft Assembly/SolidWorks/7003 Bearing/7003_cd_hcp4a_02.SLDPRT

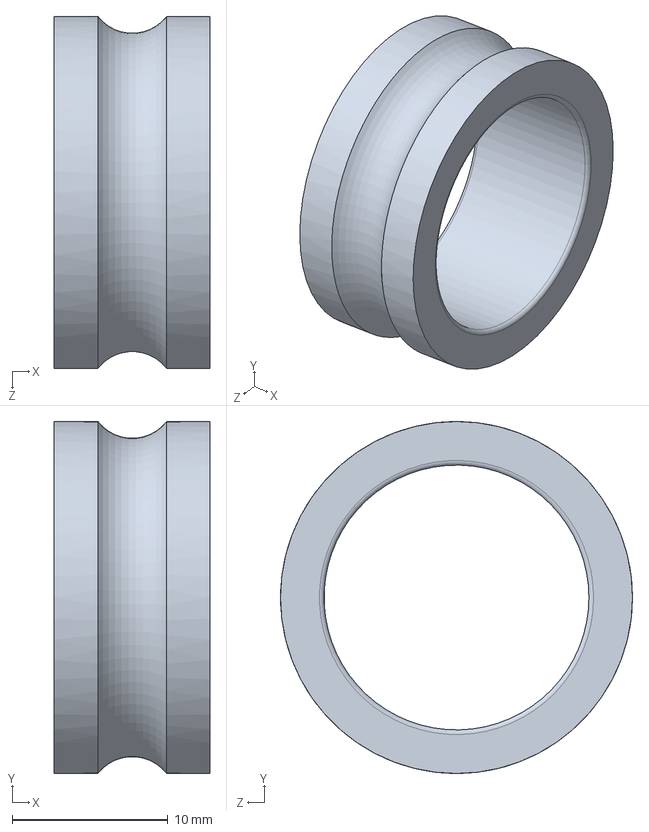
[picture p155: CAD file, 2024-11-20]
Shaft Assembly/SolidWorks/7003 Bearing/7003_cd_hcp4a_02.SLDPRT
10.0 x 22.6 x 22.6 mm
