PURPL-Purdue/Turbopump/Shaft Assembly/SolidWorks/7201 Bearing/7201_cd_hcp4a_02.SLDPRT

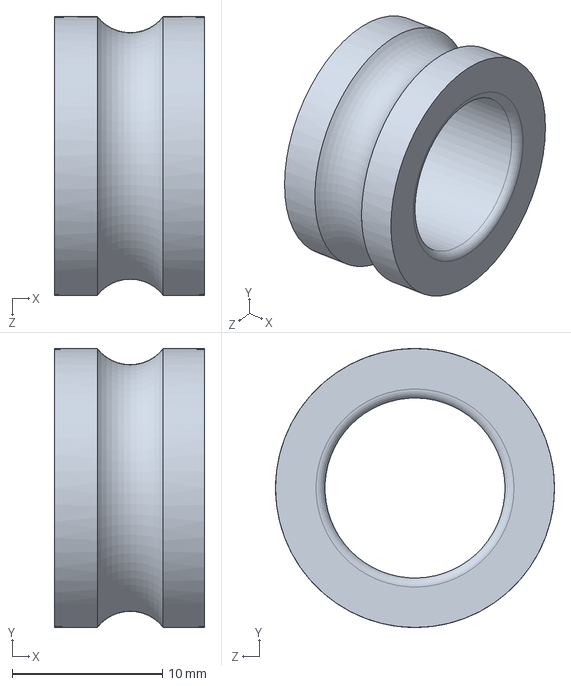
[picture p156: CAD file, 2024-11-20]
Shaft Assembly/SolidWorks/7201 Bearing/7201_cd_hcp4a_02.SLDPRT
10.0 x 18.6 x 18.6 mm
