PURPL-Purdue/Turbopump/Test Stand Assembly/Electric motor test stand/CAD/8020-1515 X 12.SLDPRT

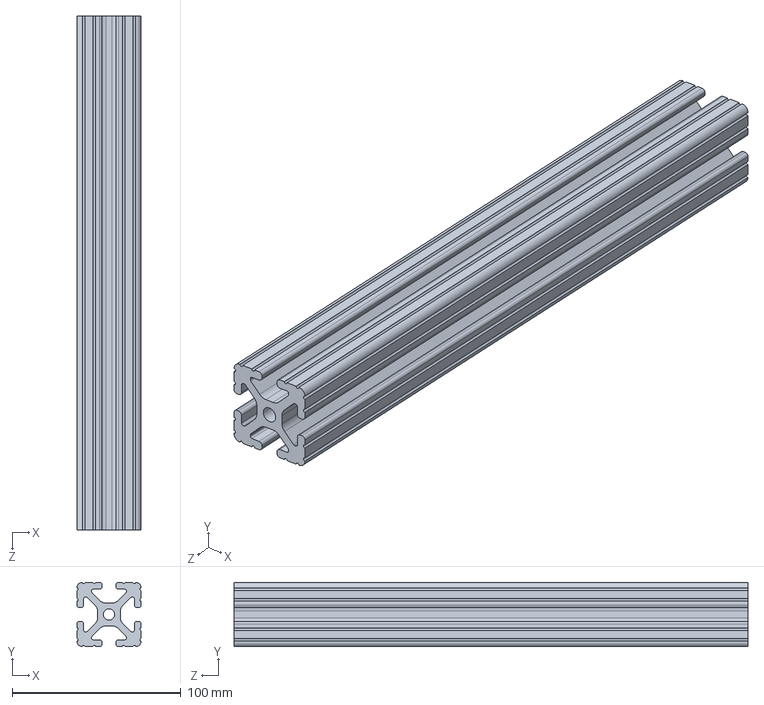
[picture p157: CAD file, 2024-10-20]
Test Stand Assembly/Electric motor test stand/CAD/8020-1515 X 12.SLDPRT
38.1 x 38.1 x 304.8 mm
