PURPL-Purdue/Turbopump/Turbine Assembly/Rotor And Stator/CAD/TRBP_X0_TurbineShroud.SLDPRT

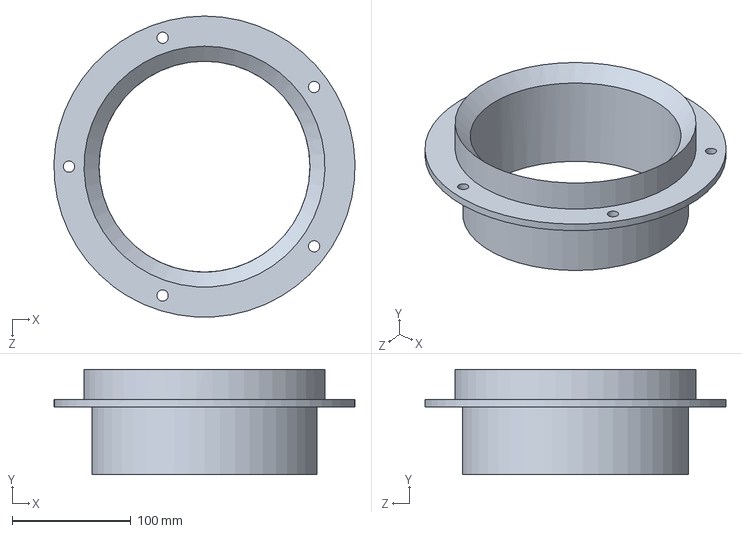
[picture p158: CAD file, 2024-12-31]
Turbine Assembly/Rotor And Stator/CAD/TRBP_X0_TurbineShroud.SLDPRT
253.9 x 88.9 x 253.8 mm
