PURPL-Purdue/Turbopump/Pump Assembly/Integration and Casings/Kero_Test_Case_Female1.SLDPRT

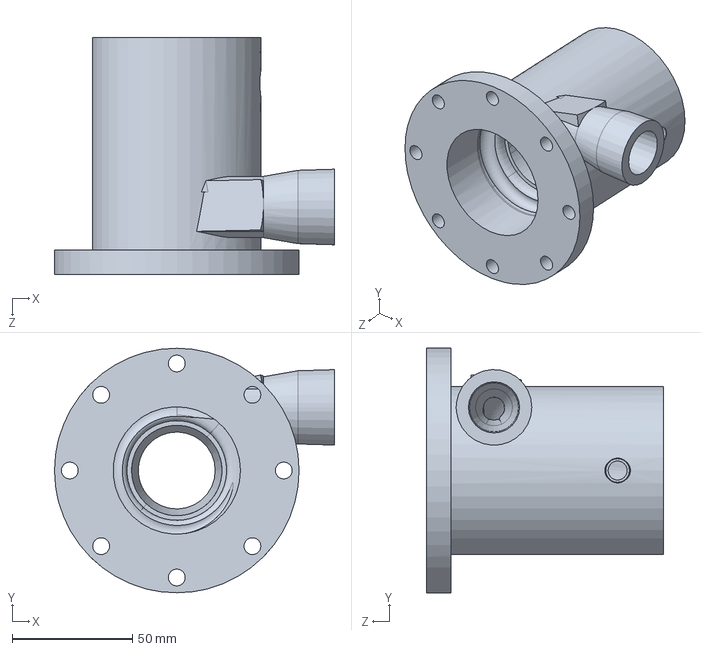
[picture p159: CAD file, 2024-11-20]
Pump Assembly/Integration and Casings/Kero_Test_Case_Female1.SLDPRT
116.3 x 101.6 x 98.4 mm
