PURPL-Purdue/Turbopump/Pump Assembly/IPS assembly/shaft_seal_section.SLDPRT

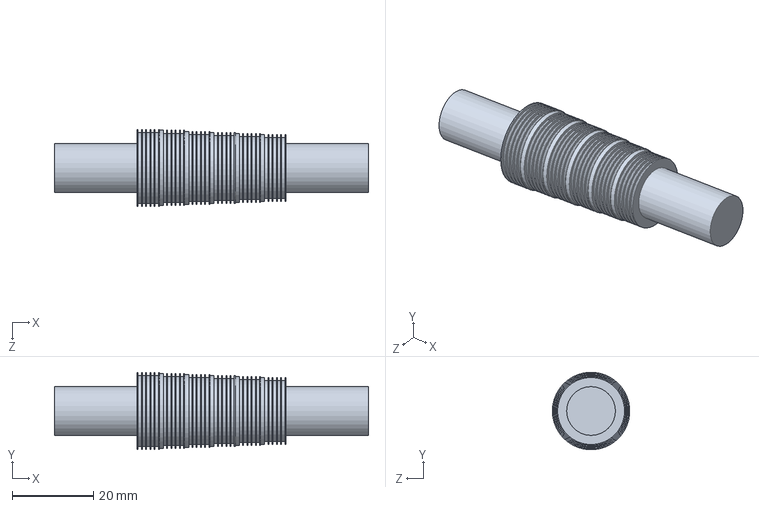
[picture p160: CAD file, 2024-12-31]
Pump Assembly/IPS assembly/shaft_seal_section.SLDPRT
77.2 x 19.0 x 19.0 mm
