PURPL-Purdue/Turbopump/Pump Assembly/Pumps/CADs/kero_postPDR_impeller_material.stp

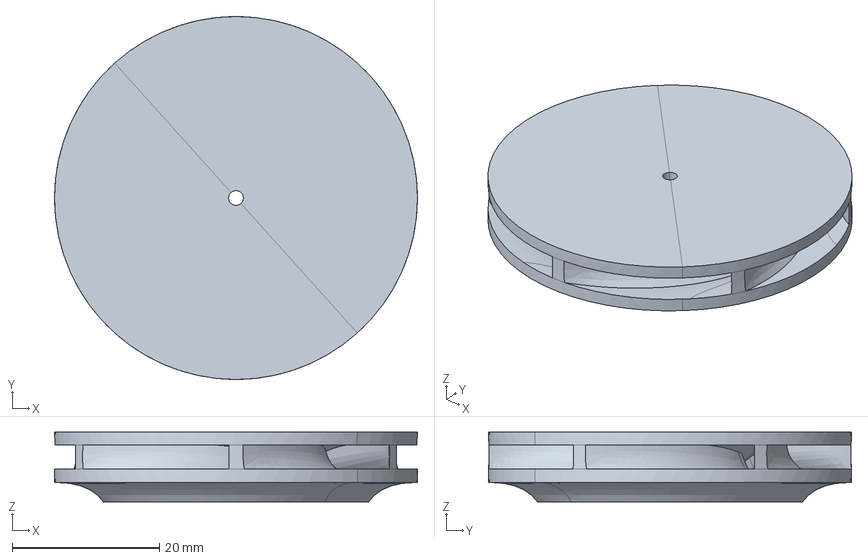
[picture p161: CAD file, 2024-12-01]
Pump Assembly/Pumps/CADs/kero_postPDR_impeller_material.stp
49.3 x 49.3 x 9.51 mm
