PURPL-Purdue/Turbopump/Pump Assembly/Pumps/Exports/kerosene_PDR_impeller_unintegrated_print.STEP

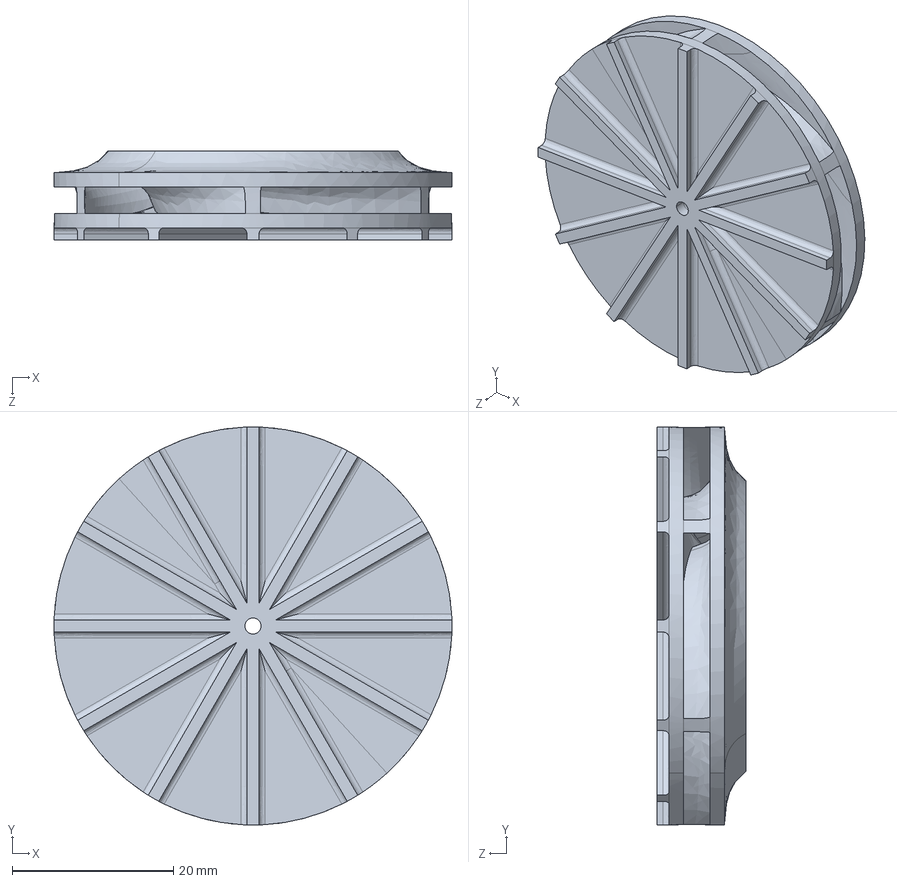
[picture p162: CAD file, 2024-11-10]
Pump Assembly/Pumps/Exports/kerosene_PDR_impeller_unintegrated_print.STEP
49.3 x 49.3 x 11.0 mm
