PURPL-Purdue/Turbopump/Pump Assembly/Seal Testing/1st try bad/seal_on_shaft.SLDPRT

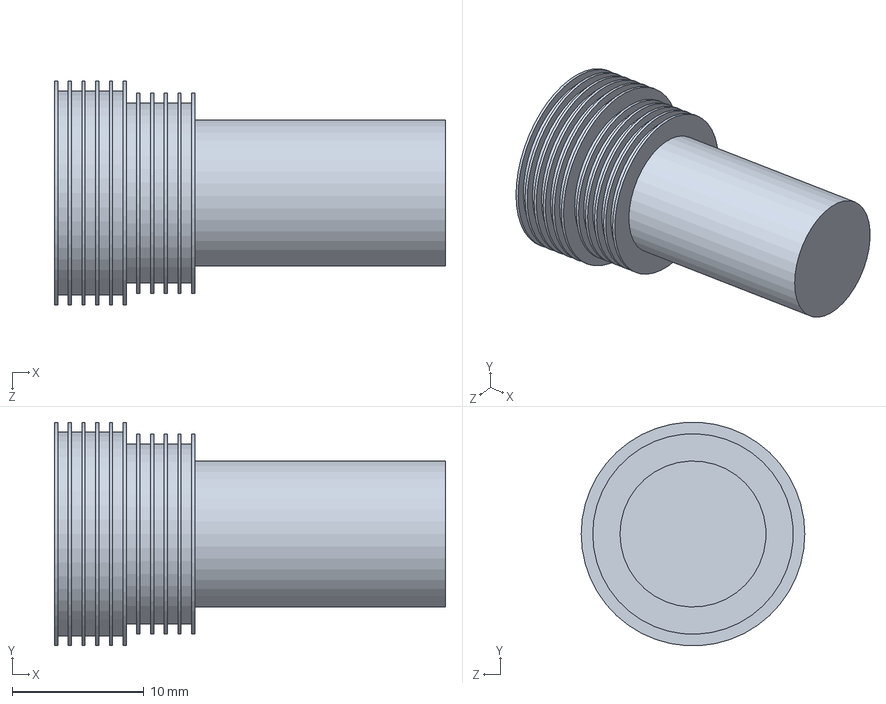
[picture p163: CAD file, 2024-11-20]
Pump Assembly/Seal Testing/1st try bad/seal_on_shaft.SLDPRT
29.7 x 17.0 x 17.0 mm
