PURPL-Purdue/Turbopump/Pump Assembly/Seal Testing/Seal_insert_test.SLDPRT

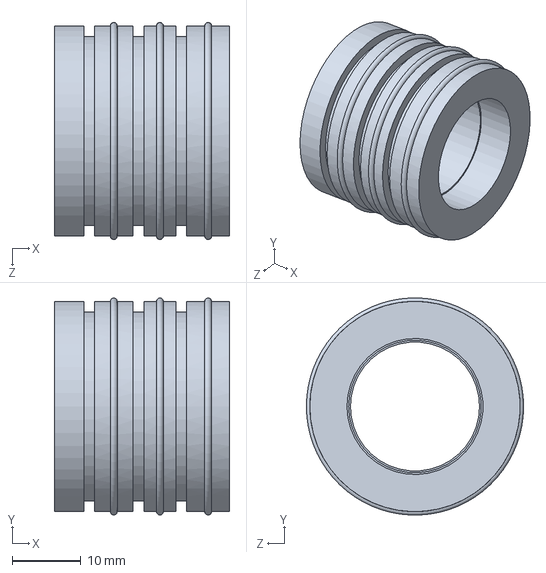
[picture p164: CAD file, 2024-11-20]
Pump Assembly/Seal Testing/Seal_insert_test.SLDPRT
25.4 x 31.5 x 31.5 mm
