PURPL-Purdue/Turbopump/Turbine Assembly/Rotor And Stator/CAD/manifoldprototype.SLDPRT

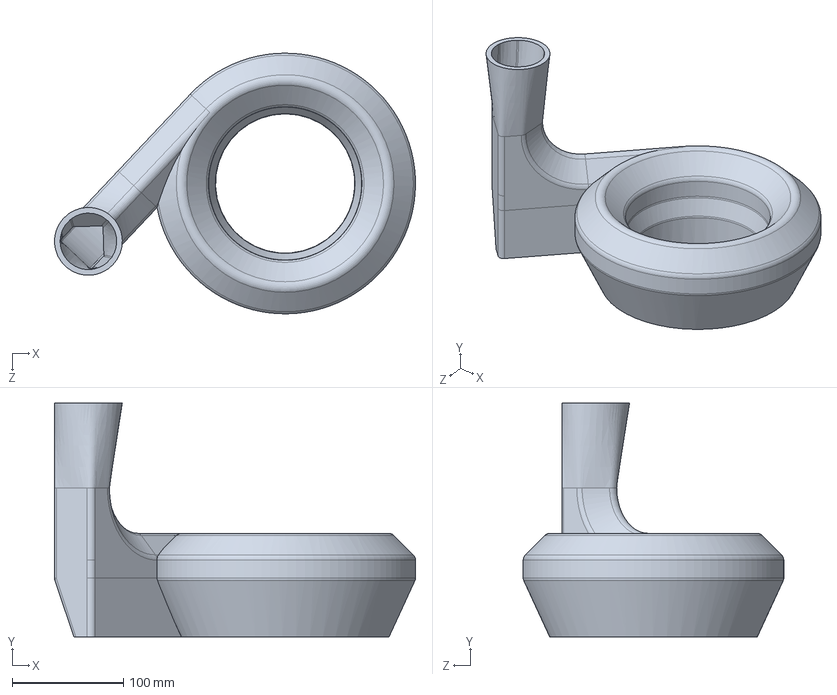
[picture p165: CAD file, 2024-11-20]
Turbine Assembly/Rotor And Stator/CAD/manifoldprototype.SLDPRT
324.6 x 210.3 x 234.4 mm
