PURPL-Purdue/Turbopump/Pump Assembly/Integration and Casings/COTS parts/-040 O-Ring.SLDPRT

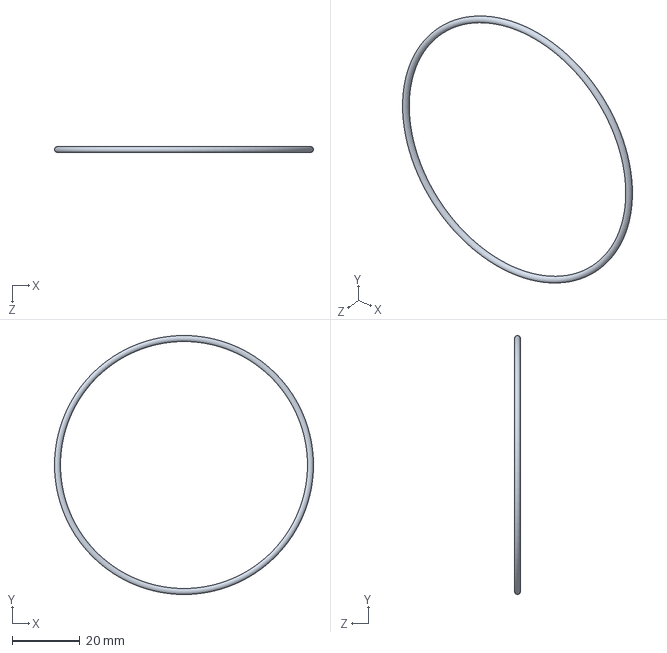
[picture p166: CAD file, 2024-10-20]
Pump Assembly/Integration and Casings/COTS parts/-040 O-Ring.SLDPRT
76.3 x 76.3 x 1.78 mm
