PURPL-Purdue/Turbopump/Pump Assembly/Integration and Casings/Kero_Test_Case.SLDPRT

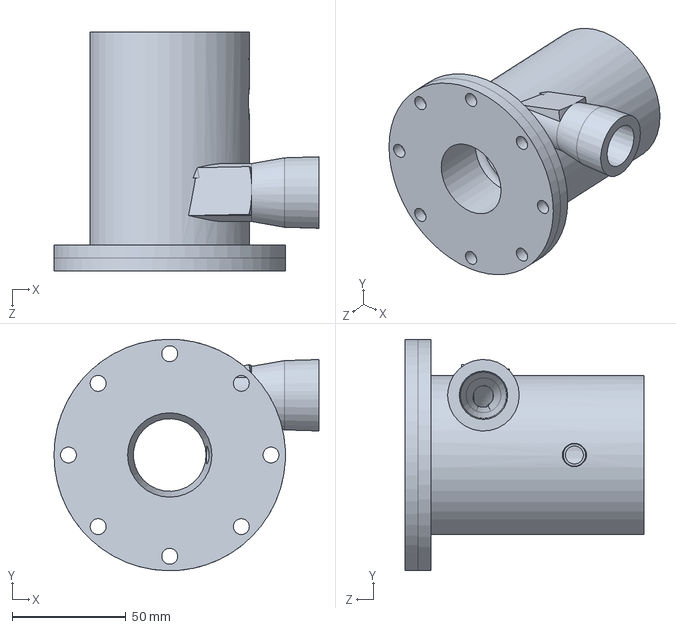
[picture p167: CAD file, 2024-10-20]
Pump Assembly/Integration and Casings/Kero_Test_Case.SLDPRT
116.3 x 101.6 x 104.8 mm
