PURPL-Purdue/Turbopump/Pump Assembly/IPS assembly/Seal_insert.SLDPRT

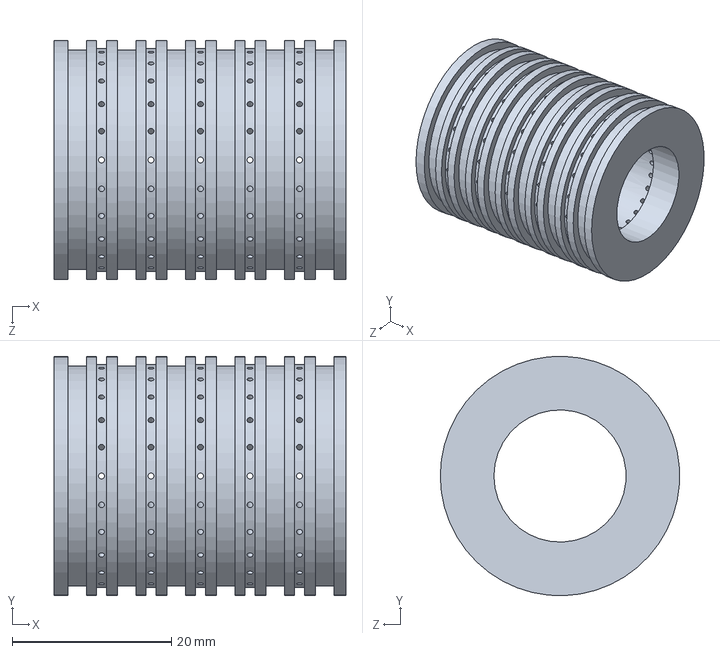
[picture p168: CAD file, 2024-12-31]
Pump Assembly/IPS assembly/Seal_insert.SLDPRT
36.7 x 30.1 x 30.1 mm
