PURPL-Purdue/Turbopump/Pump Assembly/Pumps/CADs/lox_postPDR_inducer_material.stp

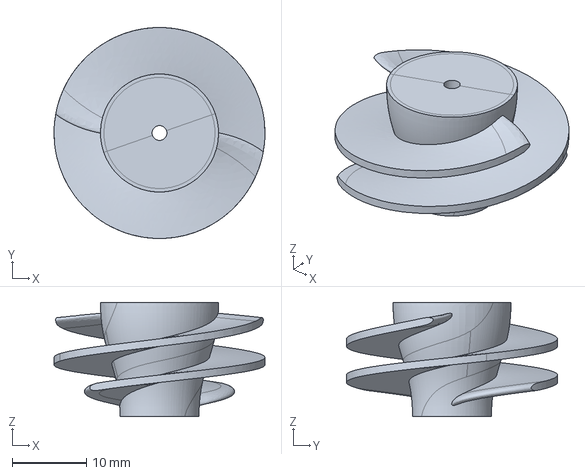
[picture p169: CAD file, 2024-12-01]
Pump Assembly/Pumps/CADs/lox_postPDR_inducer_material.stp
28.4 x 28.4 x 15.4 mm
