PURPL-Purdue/Turbopump/Pump Assembly/Pumps/Exports/kerosene_PDR_inducer_unintegrated_print.STEP

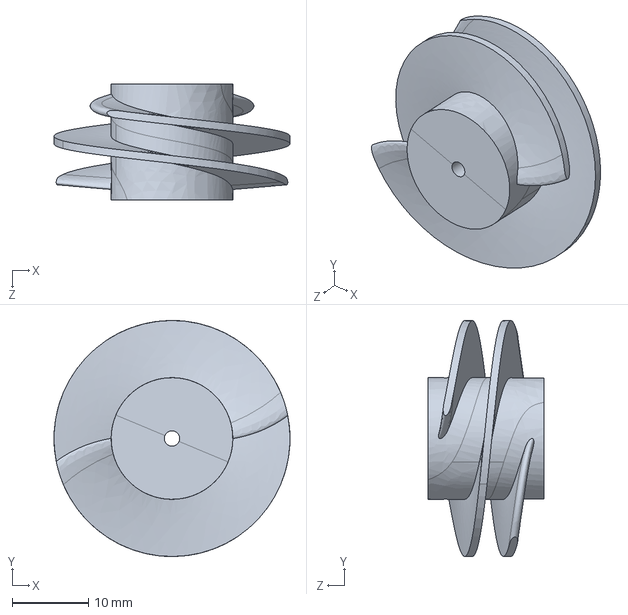
[picture p170: CAD file, 2024-11-10]
Pump Assembly/Pumps/Exports/kerosene_PDR_inducer_unintegrated_print.STEP
31.0 x 31.0 x 15.3 mm
