PURPL-Purdue/Turbopump/Pump Assembly/Seal Testing/Seal_test_shaft.SLDPRT

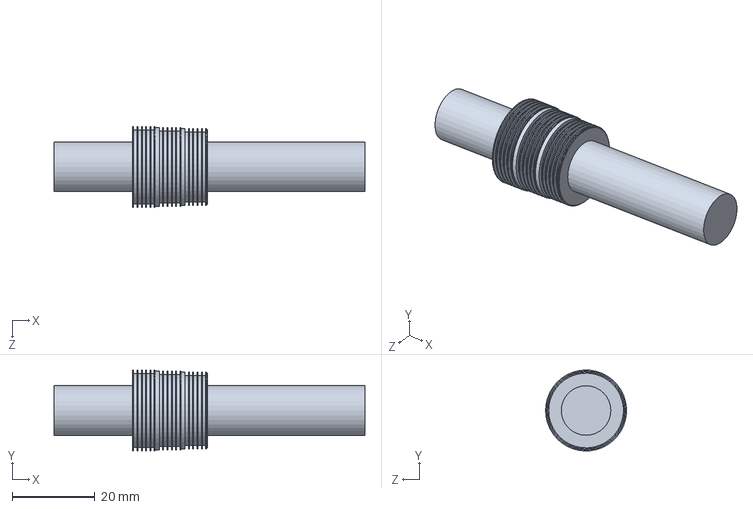
[picture p171: CAD file, 2024-11-20]
Pump Assembly/Seal Testing/Seal_test_shaft.SLDPRT
75.3 x 19.6 x 19.6 mm
