PURPL-Purdue/Turbopump/Test Stand Assembly/Electric motor test stand/CAD/ME1917 Mounting Plate.STEP

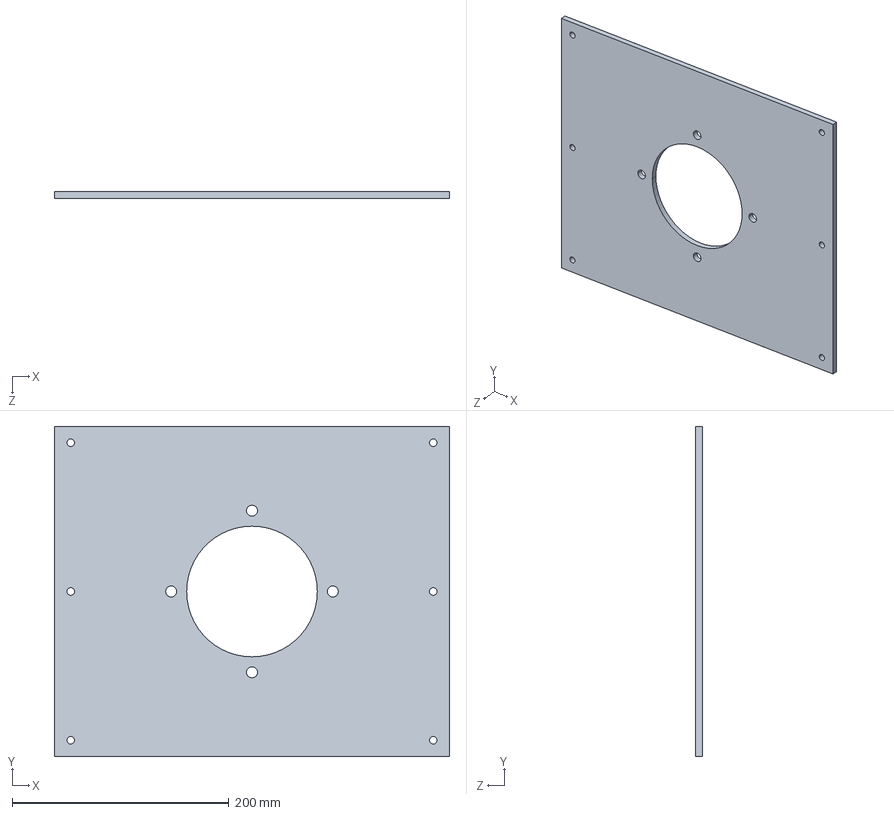
[picture p172: CAD file, 2024-10-20]
Test Stand Assembly/Electric motor test stand/CAD/ME1917 Mounting Plate.STEP
364.8 x 304.8 x 6.35 mm
