PURPL-Purdue/Turbopump/Turbine Assembly/Rotor And Stator/CAD/TRBP_X0_TurbineLabySeal.SLDPRT

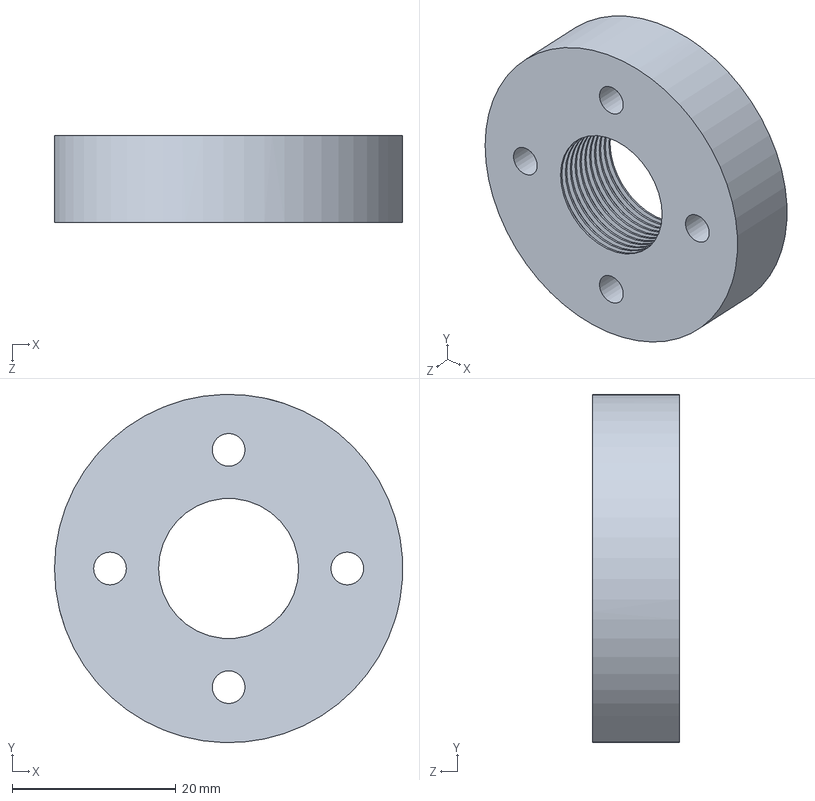
[picture p173: CAD file, 2024-11-20]
Turbine Assembly/Rotor And Stator/CAD/TRBP_X0_TurbineLabySeal.SLDPRT
42.5 x 42.5 x 10.7 mm
