PURPL-Purdue/Turbopump/Pump Assembly/Integration and Casings/casing_mk3.SLDPRT

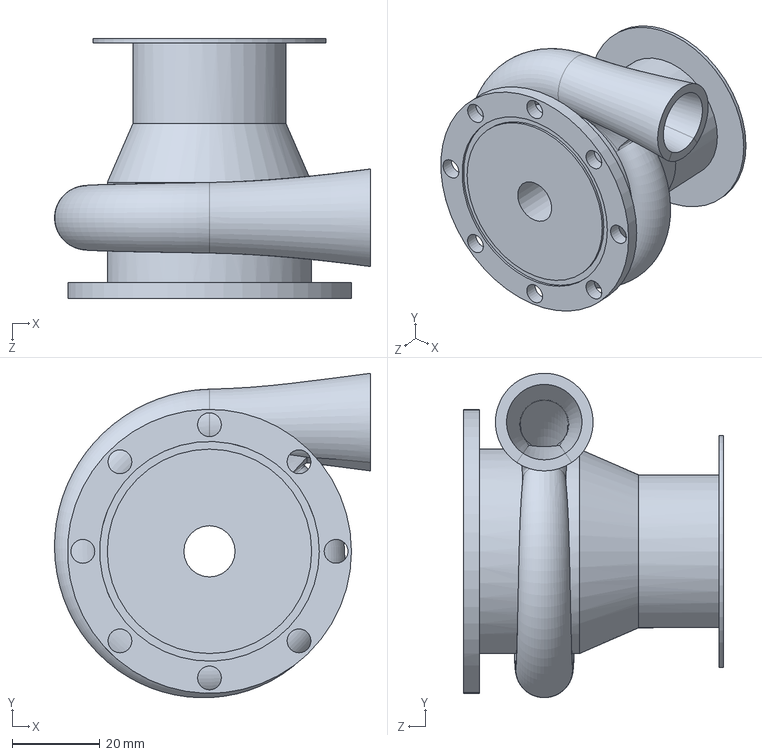
[picture p174: CAD file, 2024-10-05]
Pump Assembly/Integration and Casings/casing_mk3.SLDPRT
72.1 x 74.0 x 59.3 mm
