PURPL-Purdue/Turbopump/Pump Assembly/Integration and Casings/COTS parts/1-8in MPT Nipple.SLDPRT

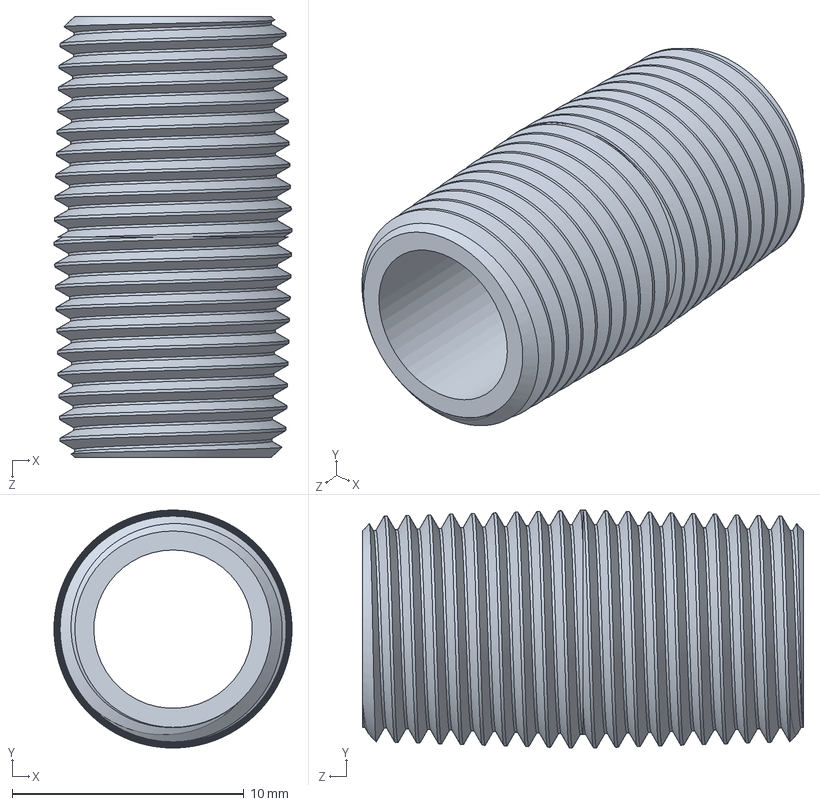
[picture p175: CAD file, 2024-10-20]
Pump Assembly/Integration and Casings/COTS parts/1-8in MPT Nipple.SLDPRT
10.3 x 10.3 x 19.1 mm
