PURPL-Purdue/Turbopump/Pump Assembly/IPS assembly/IPS_Casing2.SLDPRT

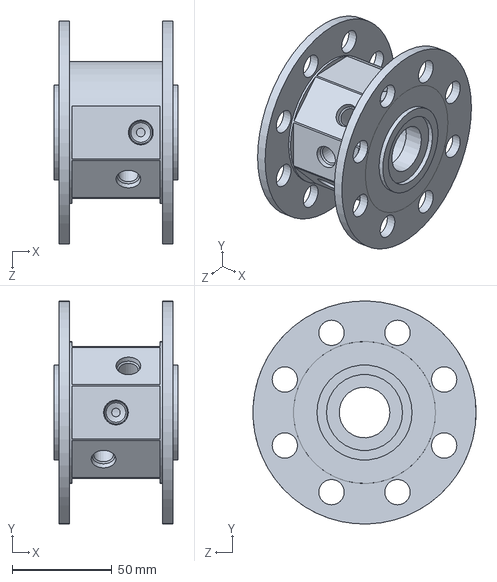
[picture p176: CAD file, 2024-12-22]
Pump Assembly/IPS assembly/IPS_Casing2.SLDPRT
61.9 x 111.7 x 111.8 mm
