PURPL-Purdue/Turbopump/Pump Assembly/Pumps/Exports/kerosene_PDR_inducer_integrated.STEP

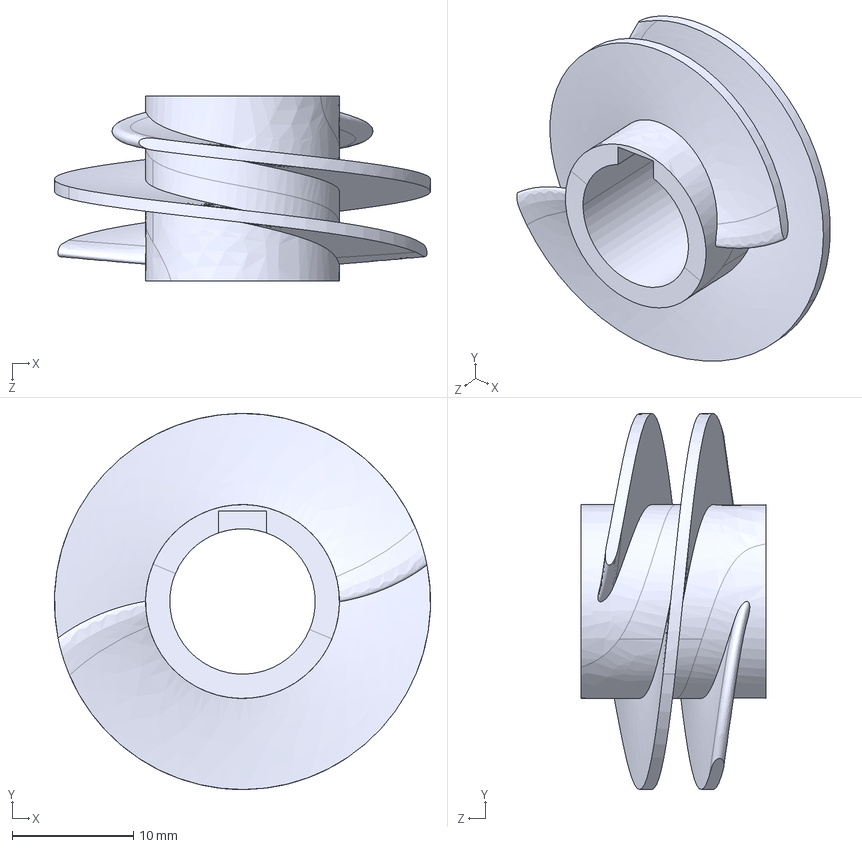
[picture p177: CAD file, 2024-11-10]
Pump Assembly/Pumps/Exports/kerosene_PDR_inducer_integrated.STEP
31.0 x 31.0 x 15.3 mm
