PURPL-Purdue/Turbopump/Pump Assembly/Seal Testing/1st try bad/31thou5toothSeal.SLDPRT

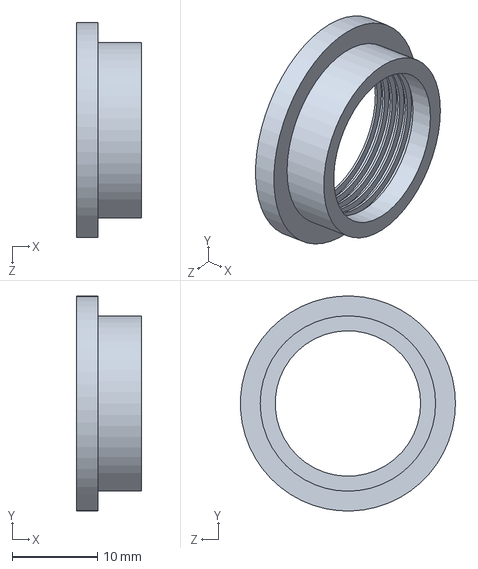
[picture p178: CAD file, 2024-11-20]
Pump Assembly/Seal Testing/1st try bad/31thou5toothSeal.SLDPRT
7.62 x 25.3 x 25.3 mm
