PURPL-Purdue/Turbopump/Shaft Assembly/SolidWorks/3x3x14_Machine Key.SLDPRT

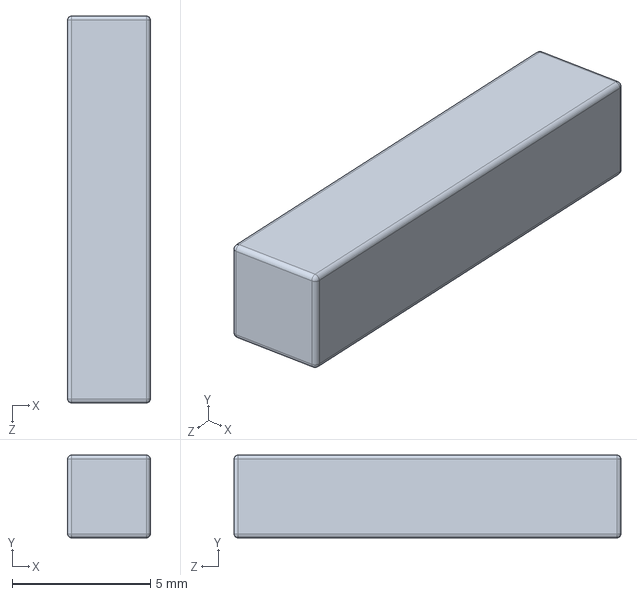
[picture p179: CAD file, 2024-11-17]
Shaft Assembly/SolidWorks/3x3x14_Machine Key.SLDPRT
3.00 x 3.00 x 14.0 mm
