PURPL-Purdue/Turbopump/Test Stand Assembly/Electric motor test stand/CAD/8020-30-3030 X 3000.sldprt

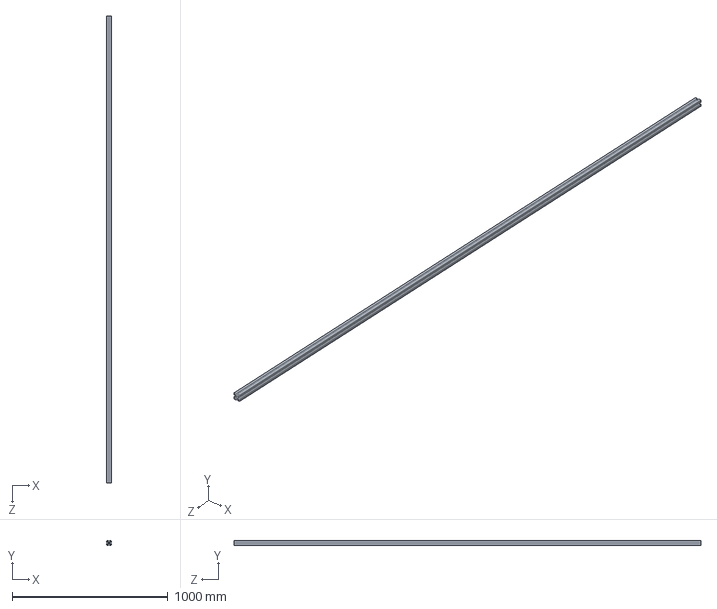
[picture p180: CAD file, 2024-10-20]
Test Stand Assembly/Electric motor test stand/CAD/8020-30-3030 X 3000.sldprt
30.0 x 30.0 x 3000.0 mm
