PURPL-Purdue/Turbopump/Turbine Assembly/Rotor And Stator/CAD/TRBP_X0_TestTurbineHub.SLDPRT

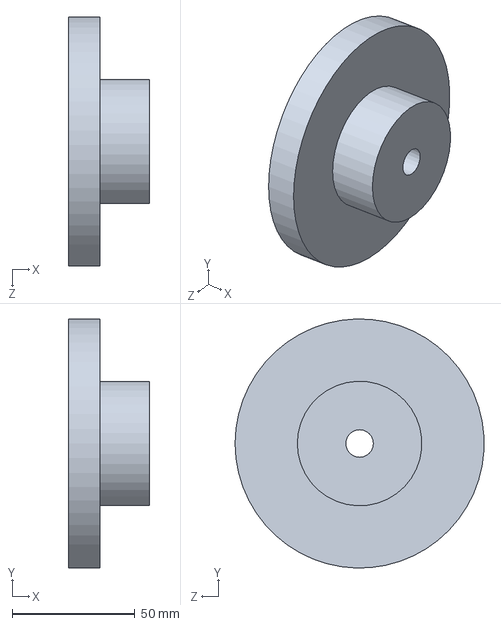
[picture p181: CAD file, 2024-11-17]
Turbine Assembly/Rotor And Stator/CAD/TRBP_X0_TestTurbineHub.SLDPRT
32.9 x 101.6 x 101.5 mm
