PURPL-Purdue/Turbopump/Pump Assembly/Integration and Casings/COTS parts/0.5 in MPT Steel Pipe Nipple.SLDPRT

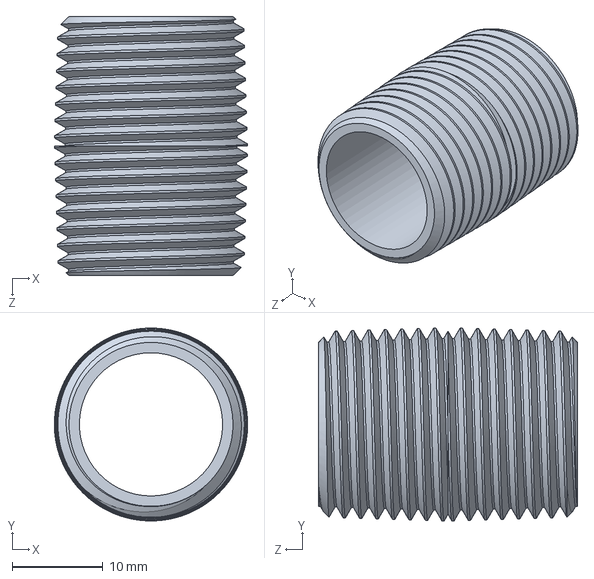
[picture p182: CAD file, 2024-10-20]
Pump Assembly/Integration and Casings/COTS parts/0.5 in MPT Steel Pipe Nipple.SLDPRT
21.3 x 21.3 x 28.6 mm
