PURPL-Purdue/Turbopump/Pump Assembly/Integration and Casings/Test1_Shaft_Seal.SLDPRT

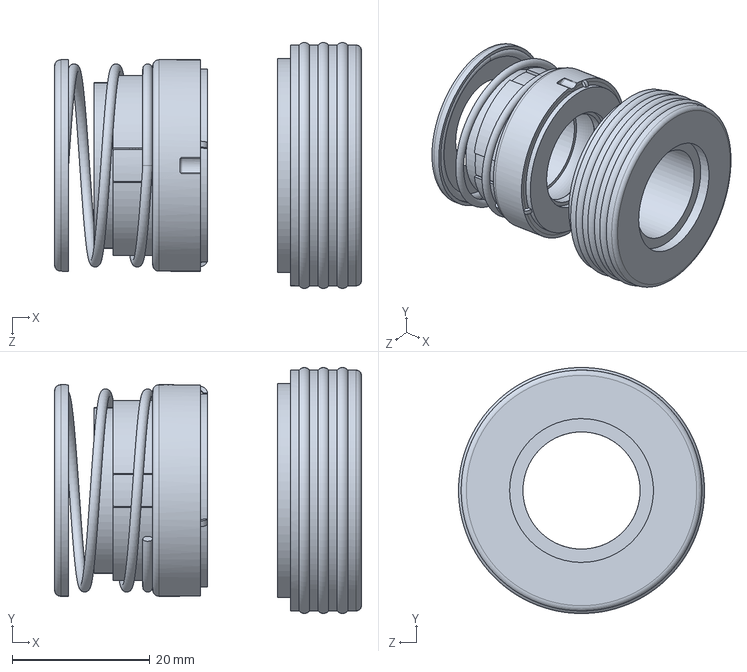
[picture p183: CAD file, 2024-10-05]
Pump Assembly/Integration and Casings/Test1_Shaft_Seal.SLDPRT
44.5 x 35.7 x 35.7 mm
