PURPL-Purdue/Turbopump/Pump Assembly/IPS assembly/IPS_Casing.SLDPRT

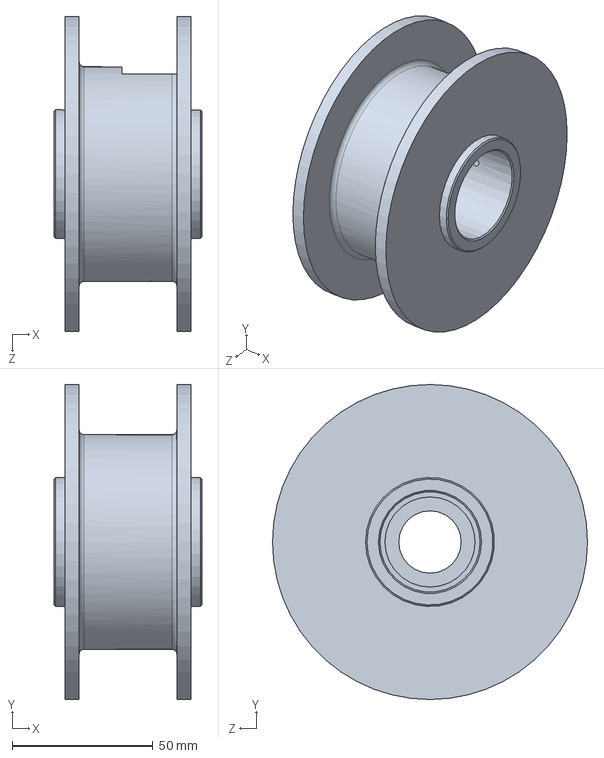
[picture p184: CAD file, 2024-12-22]
Pump Assembly/IPS assembly/IPS_Casing.SLDPRT
52.4 x 111.8 x 111.8 mm
