PURPL-Purdue/Turbopump/Pump Assembly/Pumps/CADs/LOX_PDR_shaft_integrated.SLDPRT

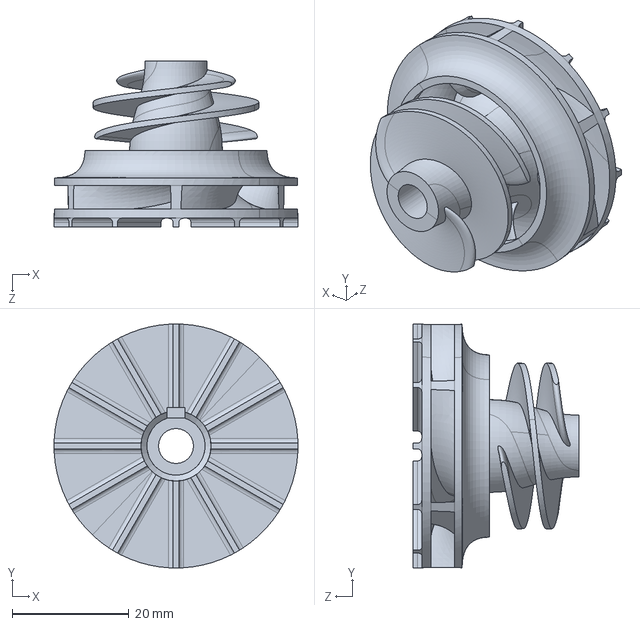
[picture p185: CAD file, 2024-11-20]
Pump Assembly/Pumps/CADs/LOX_PDR_shaft_integrated.SLDPRT
41.8 x 41.8 x 28.4 mm
