PURPL-Purdue/Turbopump/Pump Assembly/Seal Testing/1st try bad/Testing_Casing.SLDPRT

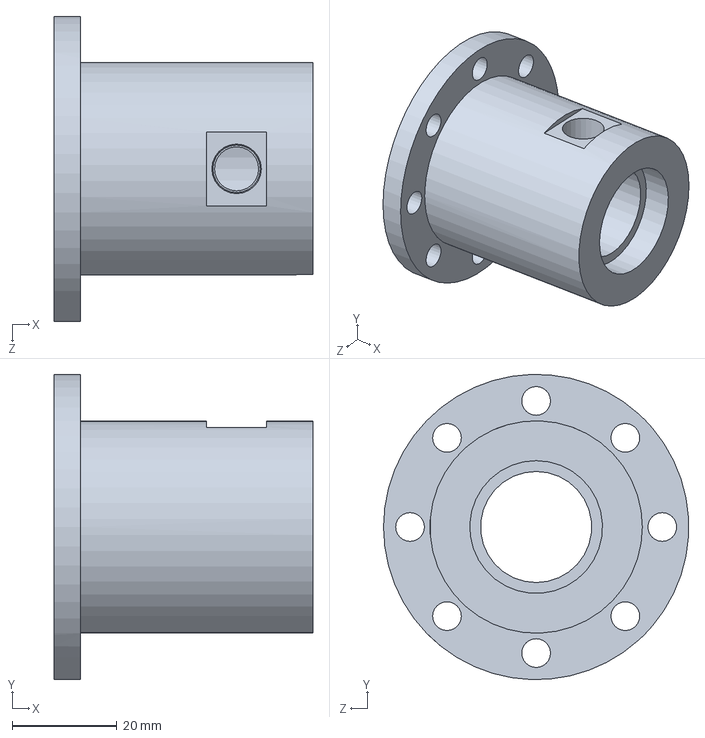
[picture p186: CAD file, 2024-11-20]
Pump Assembly/Seal Testing/1st try bad/Testing_Casing.SLDPRT
49.5 x 58.4 x 58.4 mm
