PURPL-Purdue/Turbopump/Shaft Assembly/SolidWorks/Test1_Shaft.SLDPRT

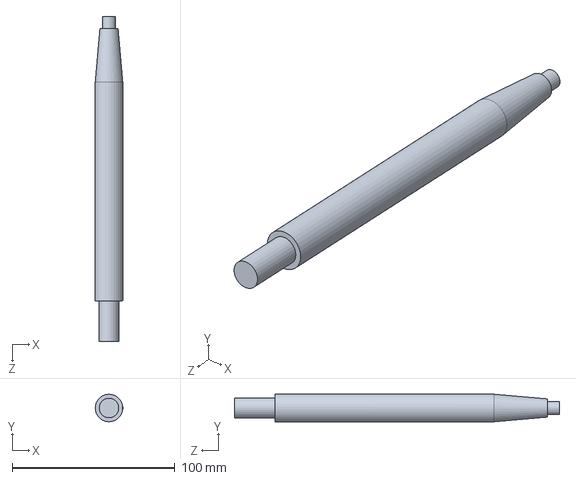
[picture p187: CAD file, 2024-11-10]
Shaft Assembly/SolidWorks/Test1_Shaft.SLDPRT
17.0 x 17.0 x 200.0 mm
