PURPL-Purdue/Turbopump/Test Stand Assembly/Electric motor test stand/CAD/3030 X 24in.SLDPRT

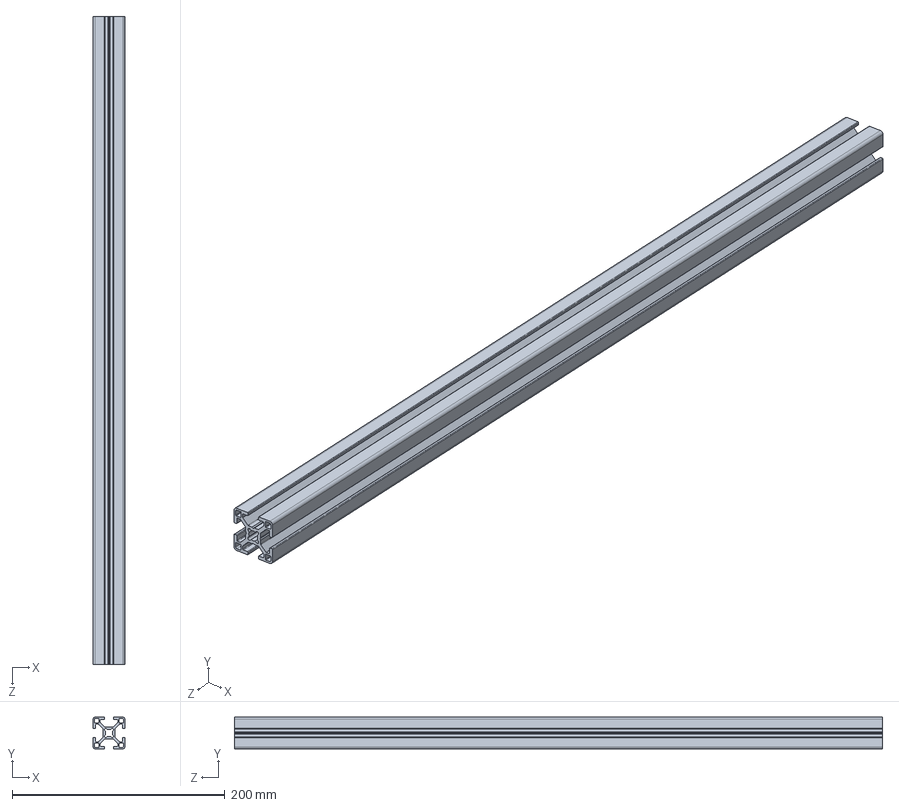
[picture p188: CAD file, 2024-10-20]
Test Stand Assembly/Electric motor test stand/CAD/3030 X 24in.SLDPRT
30.0 x 30.0 x 609.6 mm
