PURPL-Purdue/Turbopump/Turbine Assembly/Rotor And Stator/CAD/TRBP_X0_ColdGasNozzleMount.SLDPRT

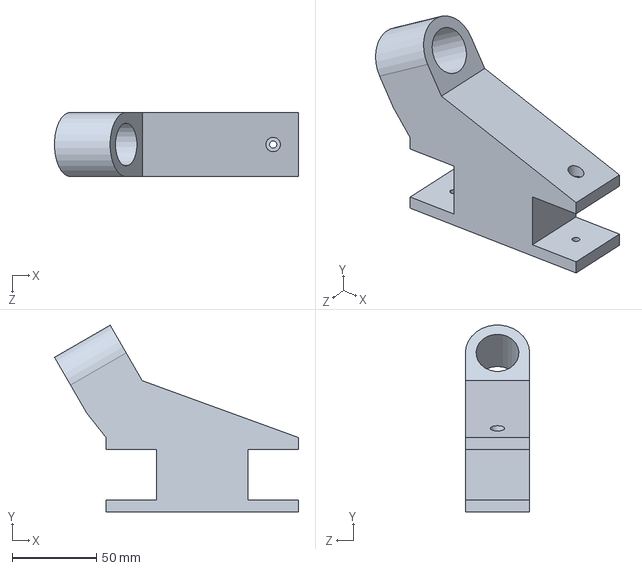
[picture p189: CAD file, 2024-11-03]
Turbine Assembly/Rotor And Stator/CAD/TRBP_X0_ColdGasNozzleMount.SLDPRT
144.5 x 110.6 x 38.1 mm
