PURPL-Purdue/Turbopump/Pump Assembly/Integration and Casings/COTS parts/10series_8020.SLDPRT

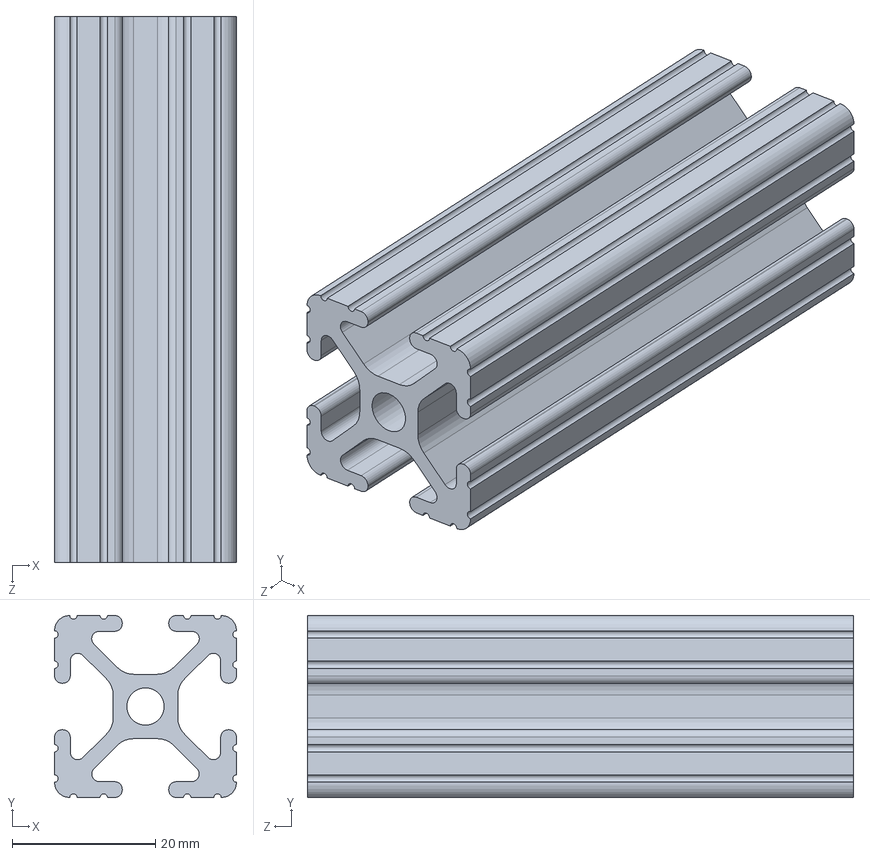
[picture p190: CAD file, 2024-10-13]
Pump Assembly/Integration and Casings/COTS parts/10series_8020.SLDPRT
25.4 x 25.4 x 76.2 mm
