PURPL-Purdue/Turbopump/Pump Assembly/Pumps/Exports/kerosene_PDR_impeller_integrated.STEP

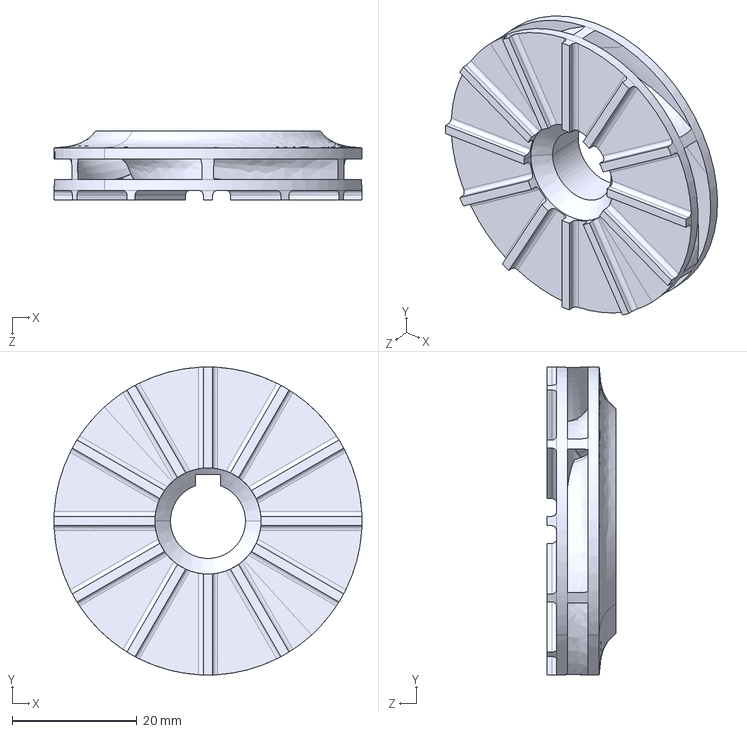
[picture p191: CAD file, 2024-11-10]
Pump Assembly/Pumps/Exports/kerosene_PDR_impeller_integrated.STEP
49.3 x 49.3 x 11.0 mm
