PURPL-Purdue/Turbopump/Pump Assembly/Seal Testing/1st try bad/Test_Casing_Inlet.SLDPRT

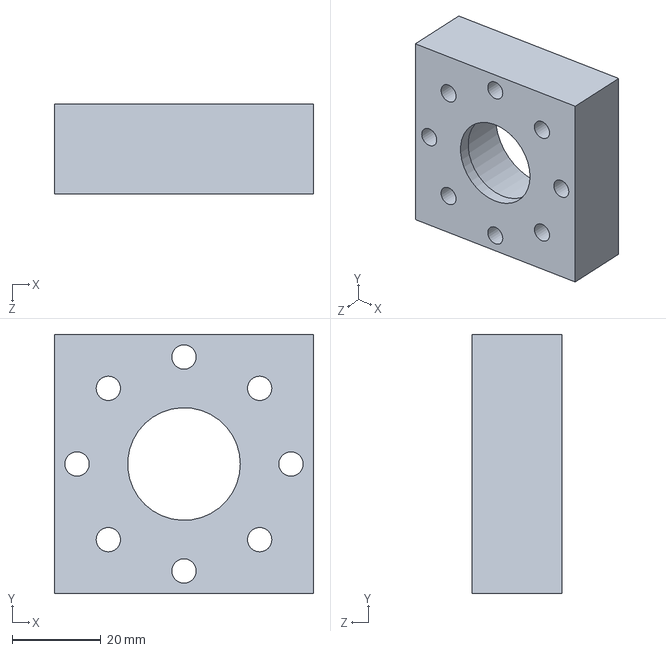
[picture p192: CAD file, 2024-11-20]
Pump Assembly/Seal Testing/1st try bad/Test_Casing_Inlet.SLDPRT
58.4 x 58.4 x 20.3 mm
