PURPL-Purdue/Turbopump/Test Stand Assembly/Electric motor test stand/CAD/me1117.SLDPRT

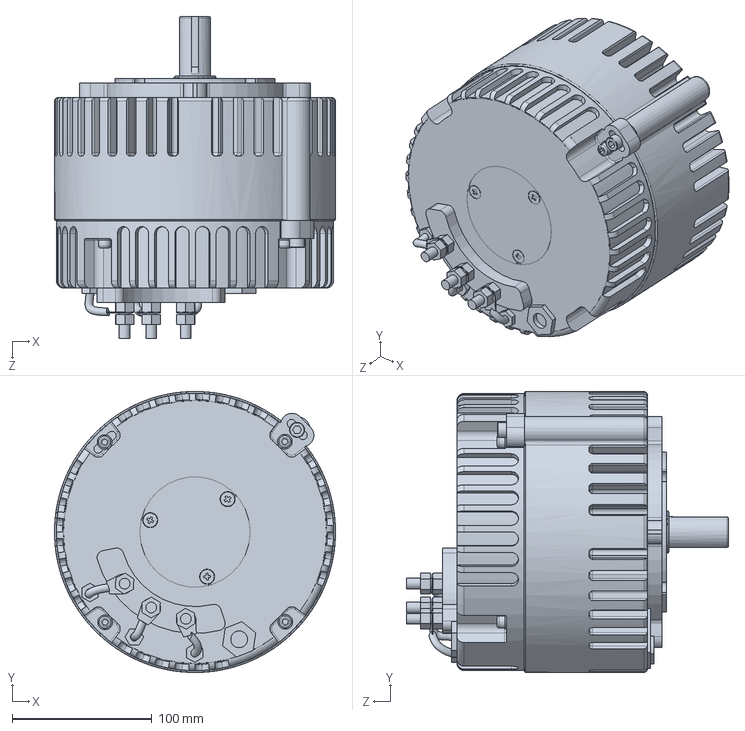
[picture p193: CAD file, 2024-10-20]
Test Stand Assembly/Electric motor test stand/CAD/me1117.SLDPRT
201.0 x 201.0 x 230.2 mm
