PURPL-Purdue/Turbopump/Turbine Assembly/Rotor And Stator/CAD/TRBP_X0_TestStandShield_Side.SLDPRT

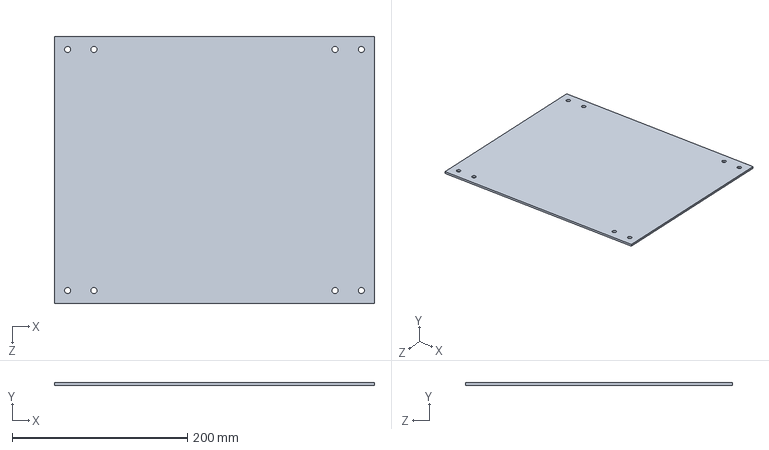
[picture p194: CAD file, 2024-11-03]
Turbine Assembly/Rotor And Stator/CAD/TRBP_X0_TestStandShield_Side.SLDPRT
364.8 x 3.17 x 304.8 mm
