PURPL-Purdue/Turbopump/Pump Assembly/IPS assembly/cfd_sketch.SLDPRT

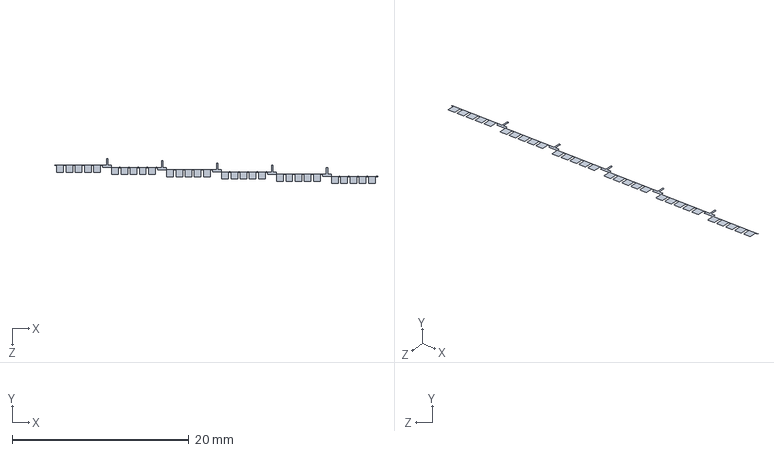
[picture p195: CAD file, 2024-12-20]
Pump Assembly/IPS assembly/cfd_sketch.SLDPRT
36.6 x 0 x 2.87 mm
