PURPL-Purdue/Turbopump/Turbine Assembly/Rotor And Stator/CAD/TRBP_X0_TestStandBearingBlock.SLDPRT

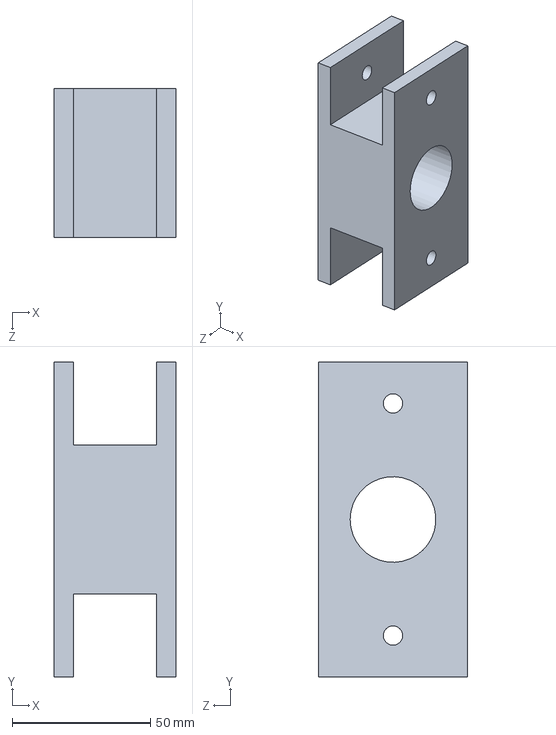
[picture p196: CAD file, 2024-11-03]
Turbine Assembly/Rotor And Stator/CAD/TRBP_X0_TestStandBearingBlock.SLDPRT
44.0 x 114.0 x 54.0 mm
