PURPL-Purdue/Turbopump/Pump Assembly/IPS assembly/AN-4 fitting.SLDPRT

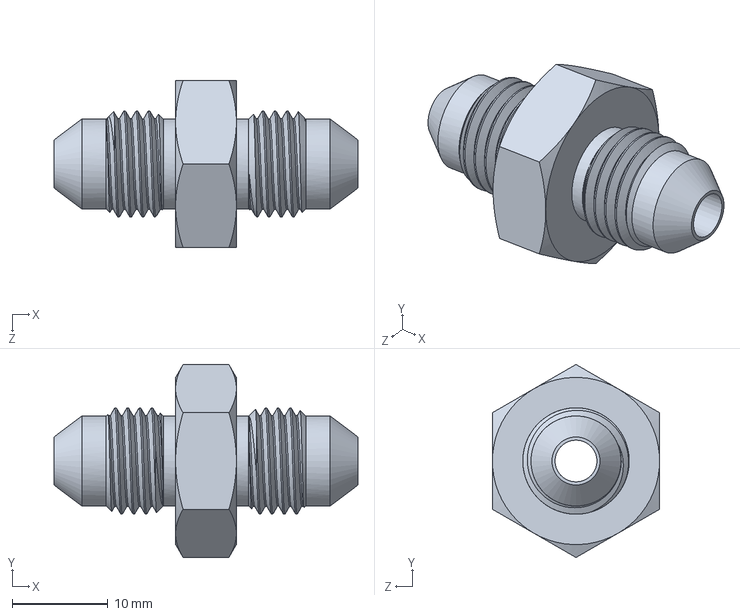
[picture p197: CAD file, 2024-12-18]
Pump Assembly/IPS assembly/AN-4 fitting.SLDPRT
31.8 x 20.2 x 17.5 mm
