PURPL-Purdue/Turbopump/Pump Assembly/Pumps/CADs/Kerosene_PDR_outlet_volute_material.stp

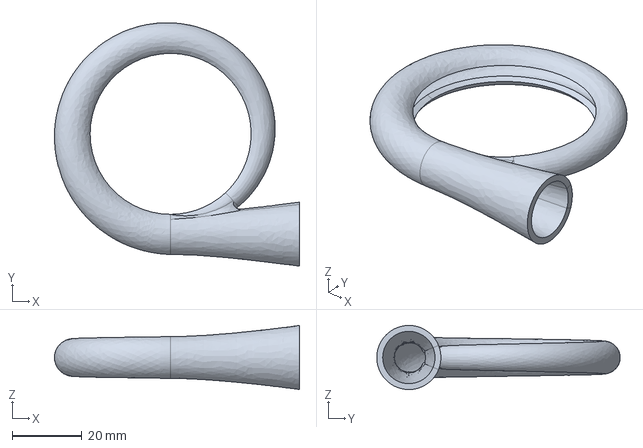
[picture p198: CAD file, 2024-11-10]
Pump Assembly/Pumps/CADs/Kerosene_PDR_outlet_volute_material.stp
70.3 x 69.8 x 18.4 mm
