PURPL-Purdue/Turbopump/Pump Assembly/Seal Testing/1st try bad/Lip_seal.SLDPRT

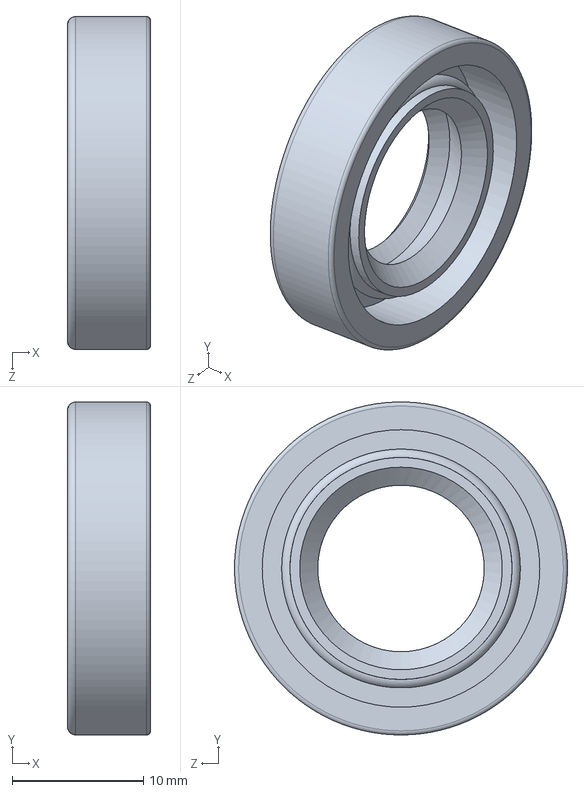
[picture p199: CAD file, 2024-11-10]
Pump Assembly/Seal Testing/1st try bad/Lip_seal.SLDPRT
6.35 x 25.4 x 25.4 mm
