PURPL-Purdue/Turbopump/Pump Assembly/IPS assembly/AN_fitting_inlet.SLDPRT

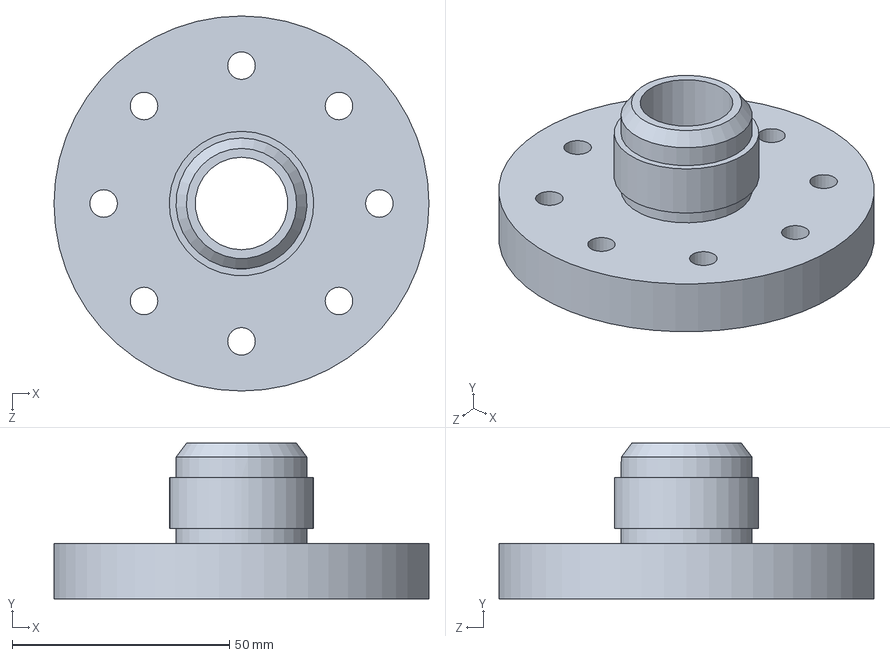
[picture p200: CAD file, 2024-11-21]
Pump Assembly/IPS assembly/AN_fitting_inlet.SLDPRT
86.4 x 35.8 x 86.4 mm
