PURPL-Purdue/Turbopump/Pump Assembly/Seal Testing/1st try bad/-019 O-Ring.SLDPRT

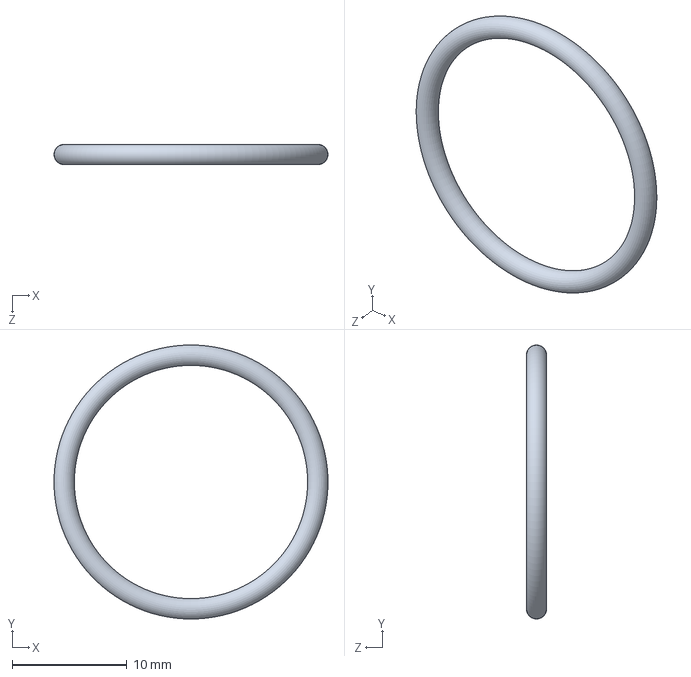
[picture p201: CAD file, 2024-11-10]
Pump Assembly/Seal Testing/1st try bad/-019 O-Ring.SLDPRT
23.9 x 23.9 x 1.77 mm
