PURPL-Purdue/Turbopump/Turbine Assembly/Rotor And Stator/CAD/TRBP_X0_ColdGasNozzle.SLDPRT

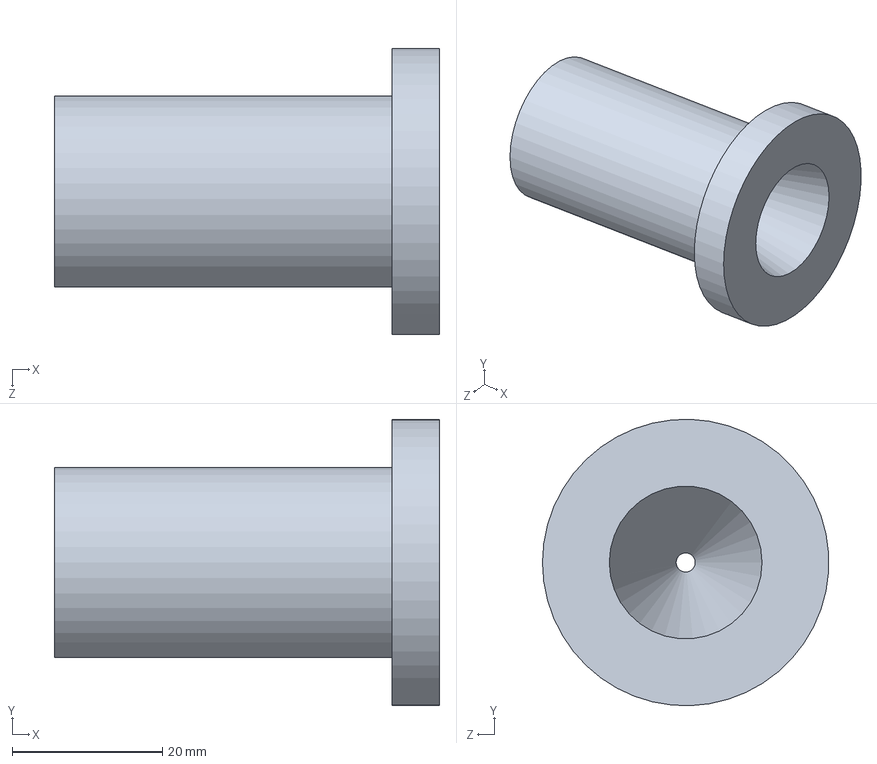
[picture p202: CAD file, 2024-10-20]
Turbine Assembly/Rotor And Stator/CAD/TRBP_X0_ColdGasNozzle.SLDPRT
51.2 x 38.1 x 38.1 mm
