PURPL-Purdue/Turbopump/Pump Assembly/Pumps/CADs/lox_PDR_outlet_volute_material.stp

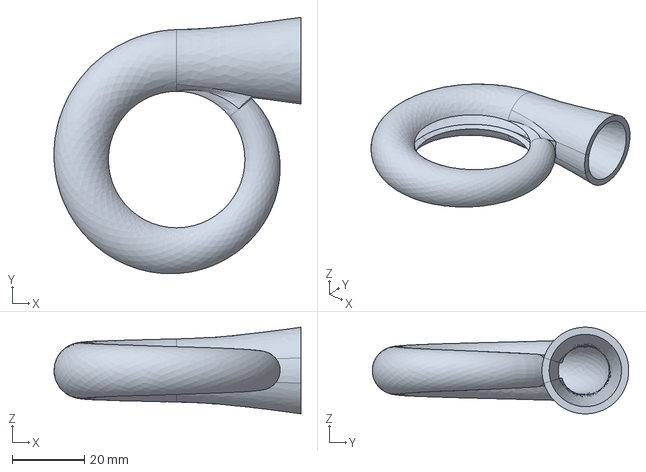
[picture p203: CAD file, 2024-11-10]
Pump Assembly/Pumps/CADs/lox_PDR_outlet_volute_material.stp
68.5 x 71.2 x 24.1 mm
