PURPL-Purdue/Turbopump/Pump Assembly/Pumps/CADs/lox_PDR_outlet_volute_flow.stp

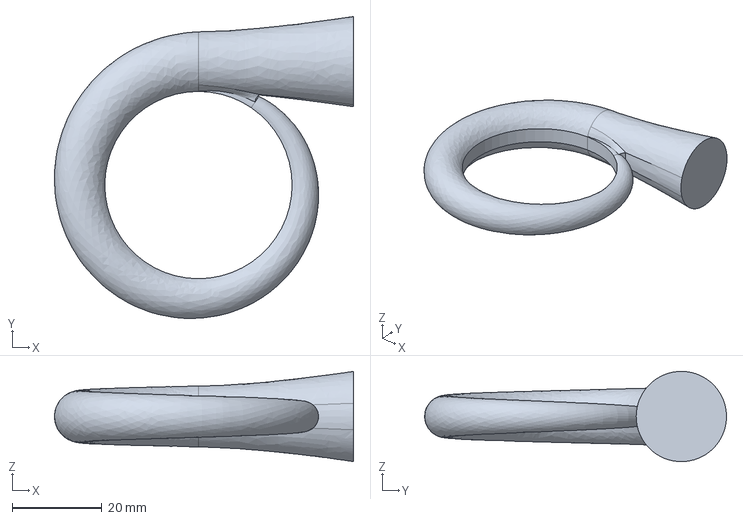
[picture p204: CAD file, 2024-11-10]
Pump Assembly/Pumps/CADs/lox_PDR_outlet_volute_flow.stp
66.5 x 67.2 x 20.1 mm
