PURPL-Purdue/Turbopump/Pump Assembly/Pumps/CADs/Kerosene_PDR_inducer_flow.stp

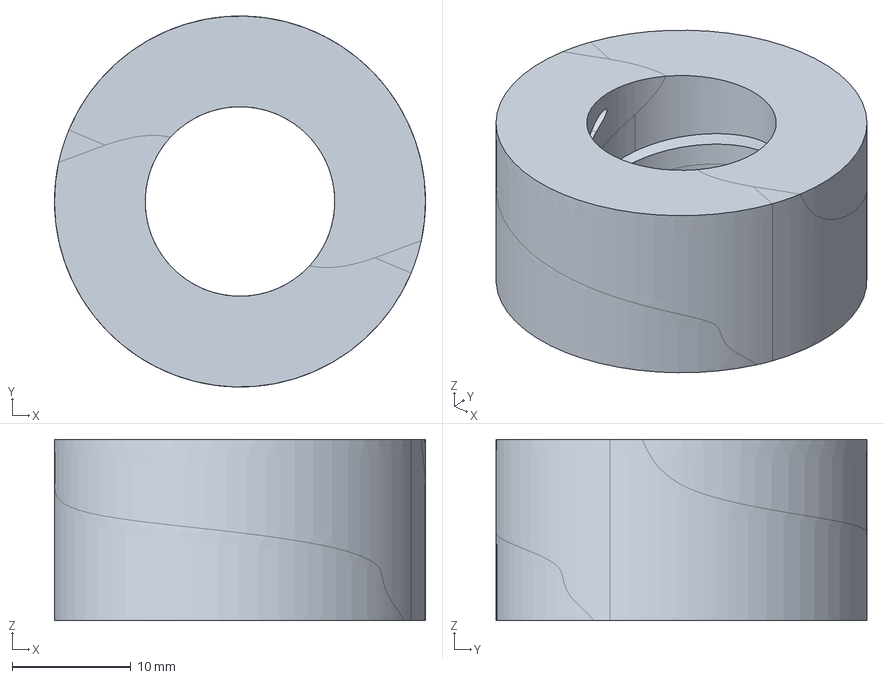
[picture p205: CAD file, 2024-11-10]
Pump Assembly/Pumps/CADs/Kerosene_PDR_inducer_flow.stp
31.3 x 31.3 x 15.3 mm
