PURPL-Purdue/Turbopump/Pump Assembly/Pumps/CADs/lox_PDR_impeller_flow.stp

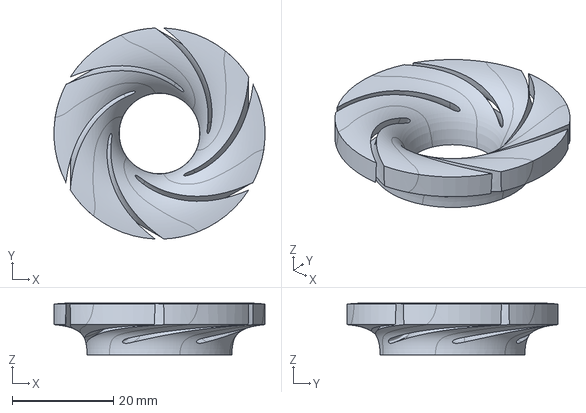
[picture p206: CAD file, 2024-11-10]
Pump Assembly/Pumps/CADs/lox_PDR_impeller_flow.stp
41.6 x 41.6 x 10.2 mm
