PURPL-Purdue/Turbopump/Pump Assembly/Pumps/CADs/Kerosene_PDR_impeller_flow.stp

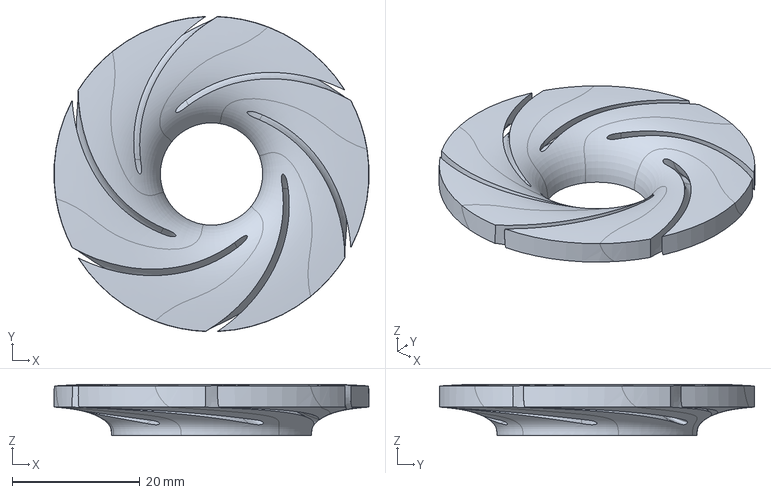
[picture p207: CAD file, 2024-11-10]
Pump Assembly/Pumps/CADs/Kerosene_PDR_impeller_flow.stp
49.3 x 49.3 x 8.00 mm
