PURPL-Purdue/Turbopump/Pump Assembly/Pumps/CADs/lox_PDR_inducer_flow.stp

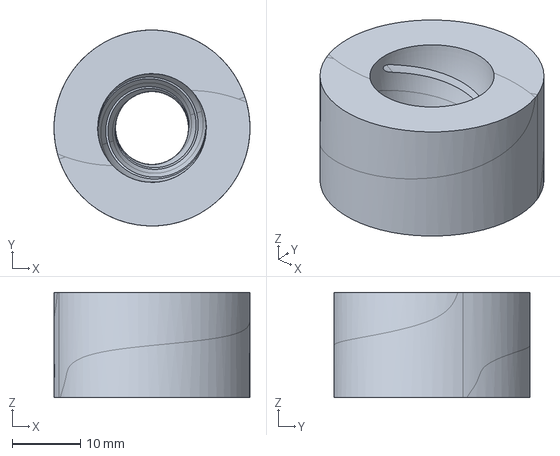
[picture p208: CAD file, 2024-11-10]
Pump Assembly/Pumps/CADs/lox_PDR_inducer_flow.stp
28.6 x 28.6 x 15.4 mm
