PURPL-Purdue/Turbopump/Pump Assembly/Pumps/CADs/Kerosene_PDR_outlet_volute_flow.stp

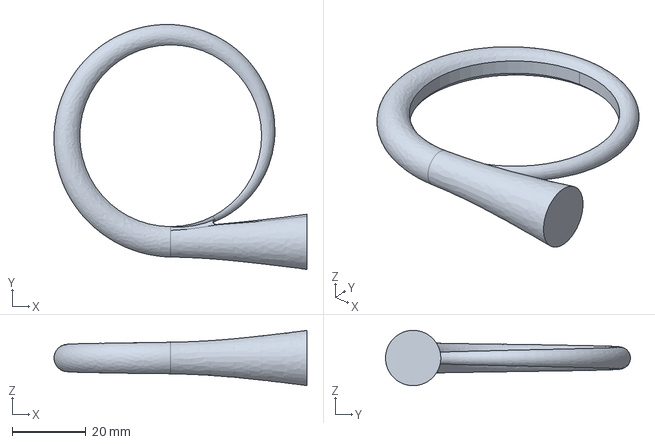
[picture p209: CAD file, 2024-11-10]
Pump Assembly/Pumps/CADs/Kerosene_PDR_outlet_volute_flow.stp
68.6 x 66.4 x 15.0 mm
