PURPL-Purdue/Turbopump/Pump Assembly/Pumps/CADs/kerosene-combined_pump.STEP

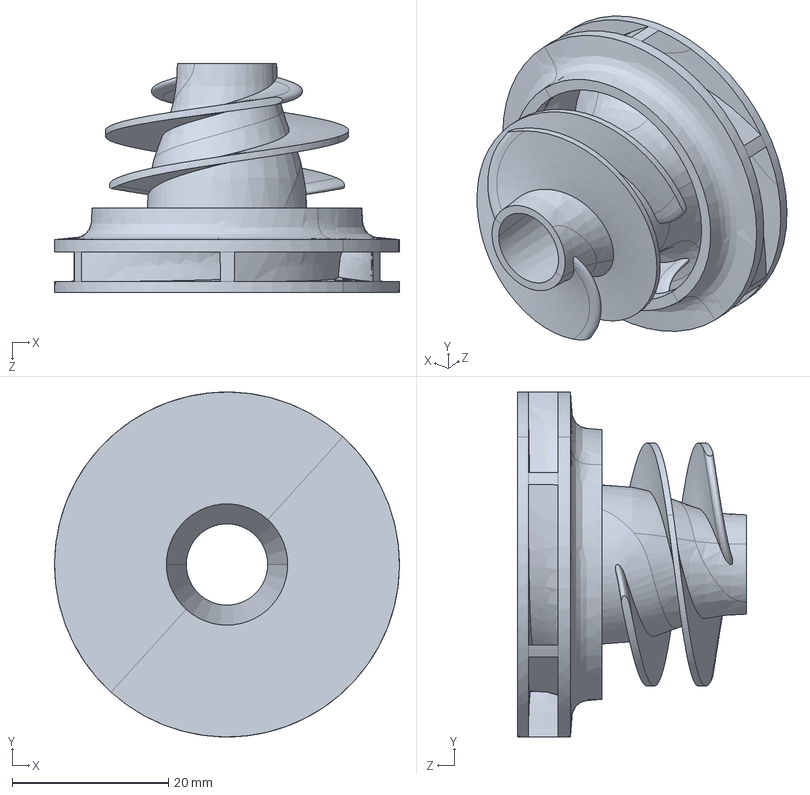
[picture p210: CAD file, 2024-10-20]
Pump Assembly/Pumps/CADs/kerosene-combined_pump.STEP
44.1 x 44.1 x 29.2 mm
