PURPL-Purdue/Turbopump/Pump Assembly/Pumps/CADs/Kero_Test1_impeller.stp

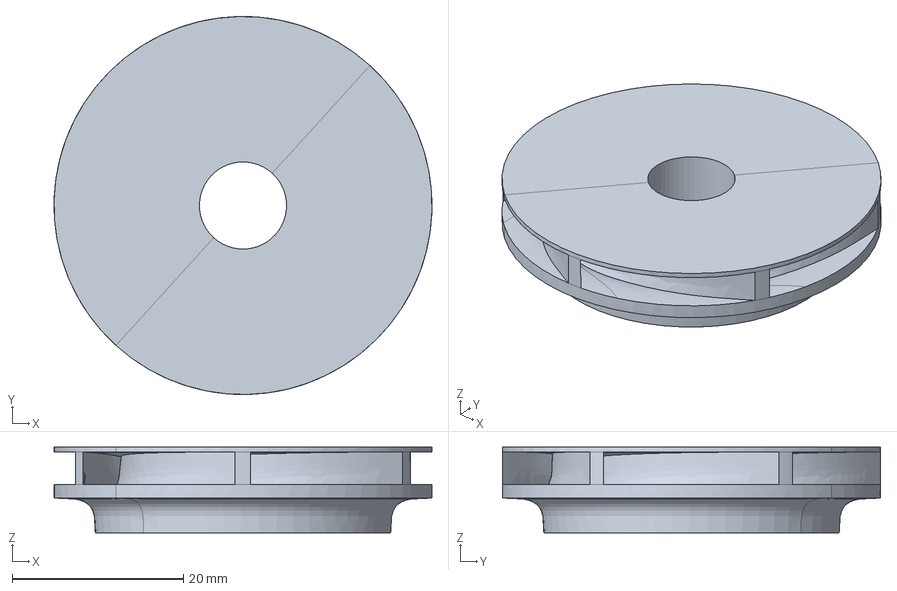
[picture p211: CAD file, 2024-10-20]
Pump Assembly/Pumps/CADs/Kero_Test1_impeller.stp
44.1 x 44.1 x 9.98 mm
