PURPL-Purdue/Turbopump/Pump Assembly/Pumps/CADs/Kerosene_Test_Stand_impeller_thick_base.stp

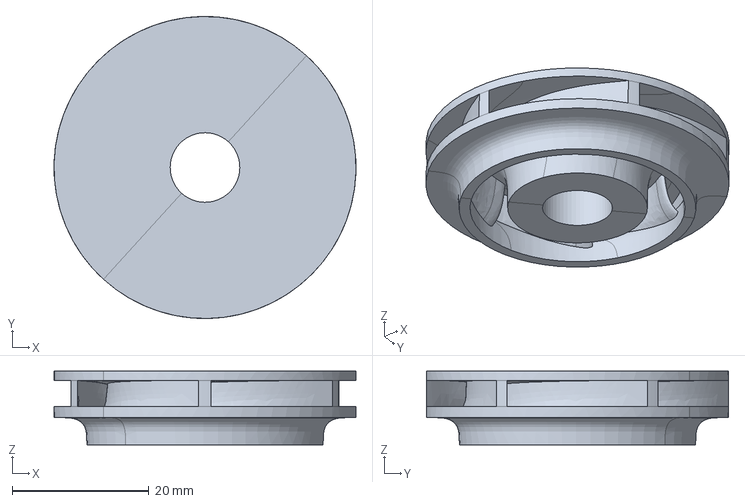
[picture p212: CAD file, 2024-10-20]
Pump Assembly/Pumps/CADs/Kerosene_Test_Stand_impeller_thick_base.stp
44.1 x 44.1 x 10.8 mm
