PURPL-Purdue/Turbopump/Pump Assembly/Pumps/CADs/Kero_Test1_inducer_thickblades.stp

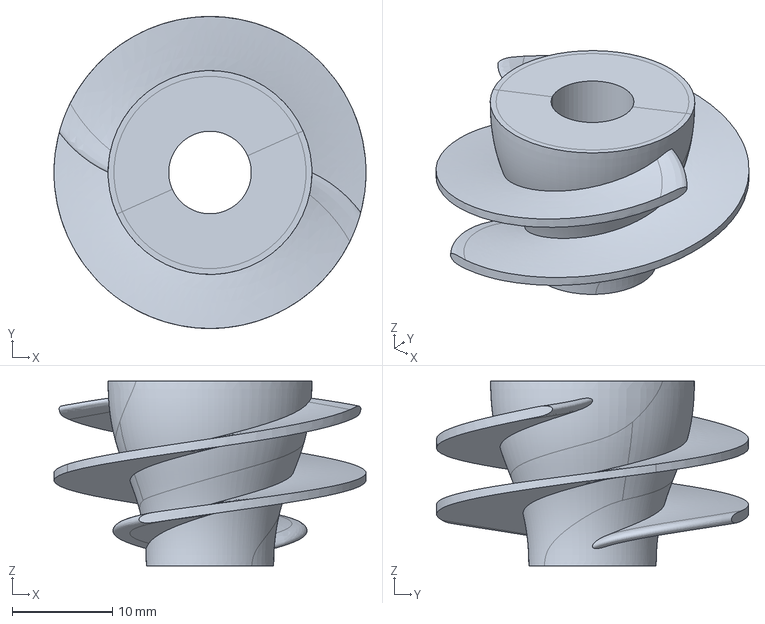
[picture p213: CAD file, 2024-10-20]
Pump Assembly/Pumps/CADs/Kero_Test1_inducer_thickblades.stp
31.1 x 31.1 x 18.4 mm
