PURPL-Purdue/Turbopump/Pump Assembly/Pumps/CADs/Kerosene_Test_Stand_Inducer_Positive.SLDPRT

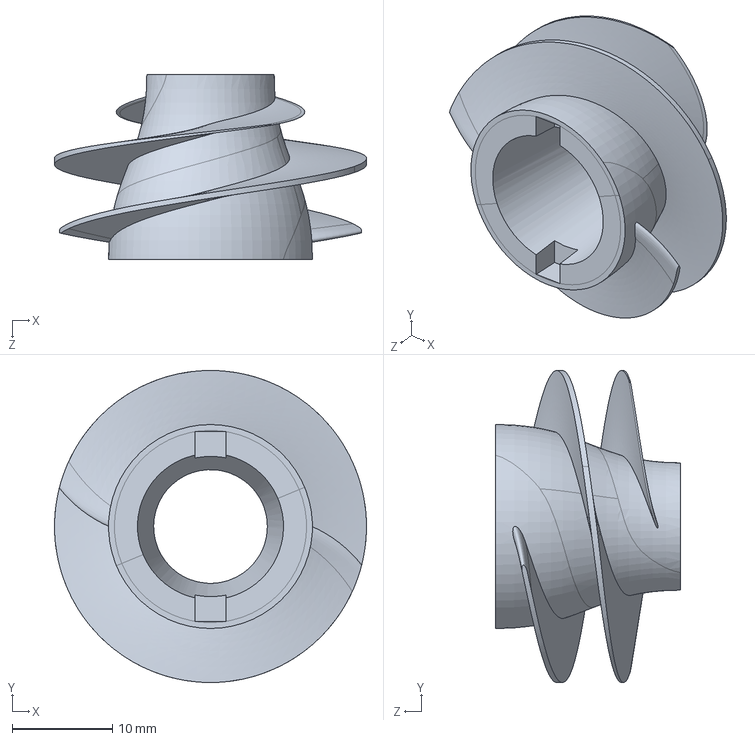
[picture p214: CAD file, 2024-10-14]
Pump Assembly/Pumps/CADs/Kerosene_Test_Stand_Inducer_Positive.SLDPRT
31.1 x 31.1 x 18.4 mm
