PURPL-Purdue/Turbopump/Pump Assembly/Pumps/CADs/Kerosene_Test_Stand_Impeller_Positive.stp.SLDPRT

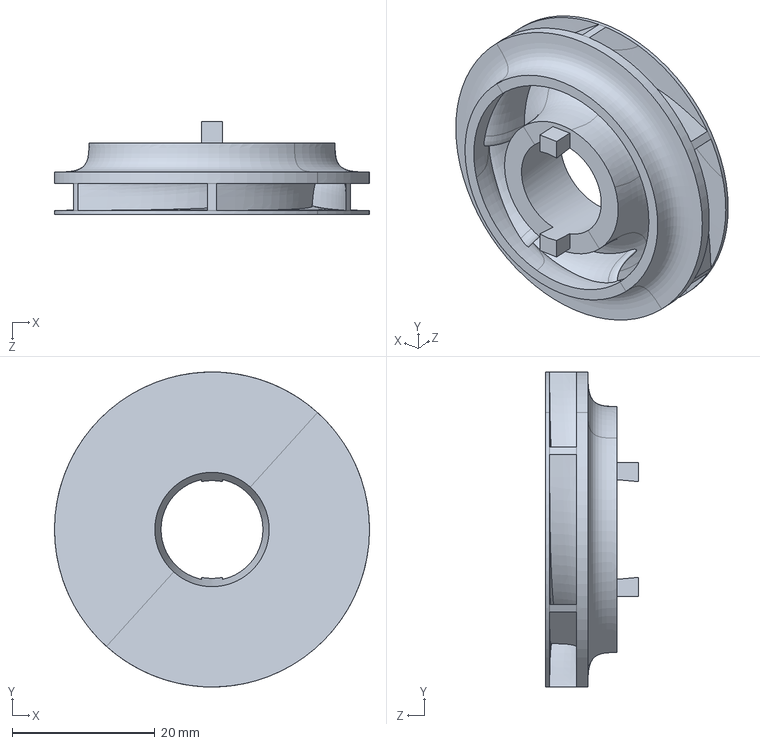
[picture p215: CAD file, 2024-10-14]
Pump Assembly/Pumps/CADs/Kerosene_Test_Stand_Impeller_Positive.stp.SLDPRT
44.1 x 44.1 x 13.0 mm
