PURPL-Purdue/Turbopump/Pump Assembly/Pumps/CADs/Kerosene_Test_Stand_Inducer_Negative.stp

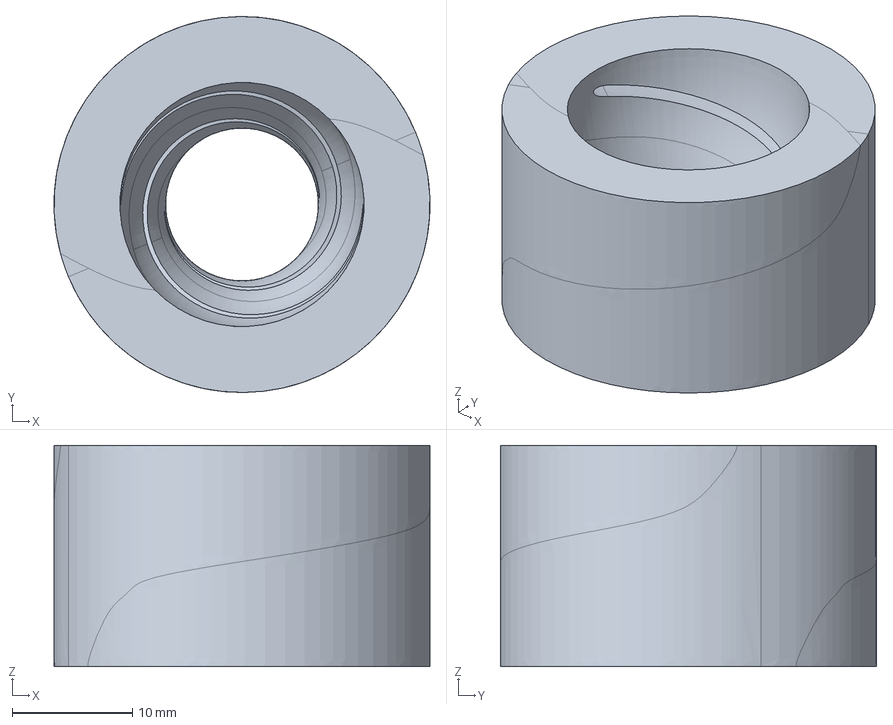
[picture p216: CAD file, 2024-10-13]
Pump Assembly/Pumps/CADs/Kerosene_Test_Stand_Inducer_Negative.stp
31.3 x 31.3 x 18.4 mm
