PURPL-Purdue/Turbopump/Pump Assembly/Pumps/CADs/lox_pump_prototype.SLDPRT

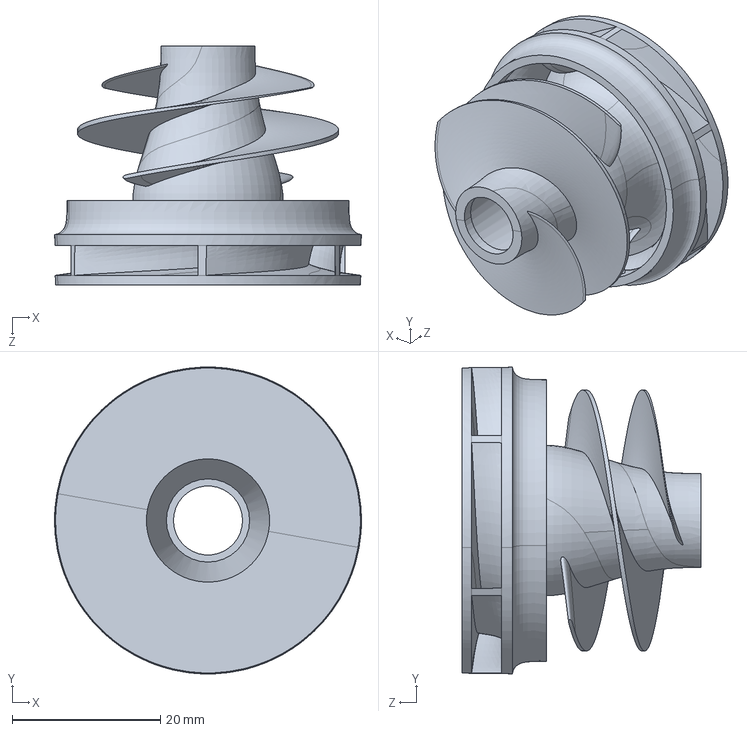
[picture p217: CAD file, 2024-10-13]
Pump Assembly/Pumps/CADs/lox_pump_prototype.SLDPRT
41.5 x 41.5 x 32.3 mm
