PURPL-Purdue/Turbopump/Pump Assembly/Pumps/CADs/kersone_pump_prototype.SLDPRT

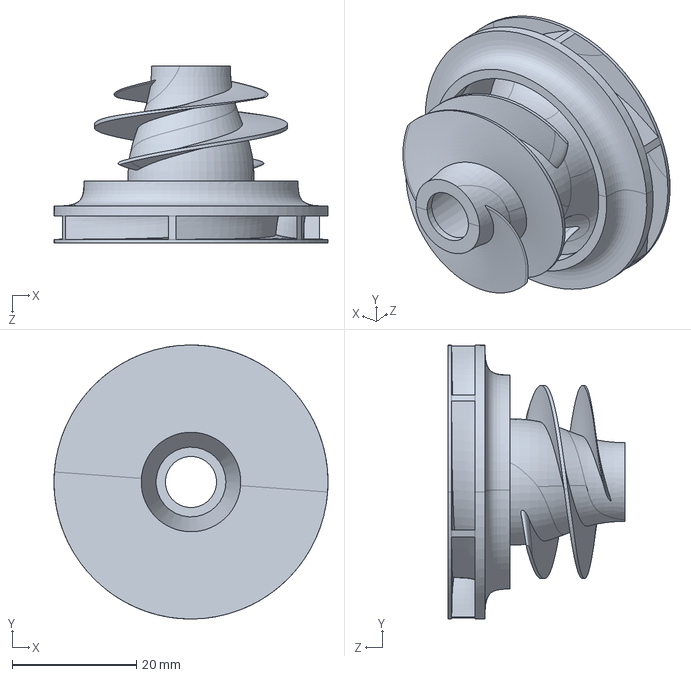
[picture p218: CAD file, 2024-10-13]
Pump Assembly/Pumps/CADs/kersone_pump_prototype.SLDPRT
44.1 x 44.1 x 28.4 mm
