PURPL-Purdue/Turbopump/Pump Assembly/IPS assembly/IPS_assembly.SLDASM

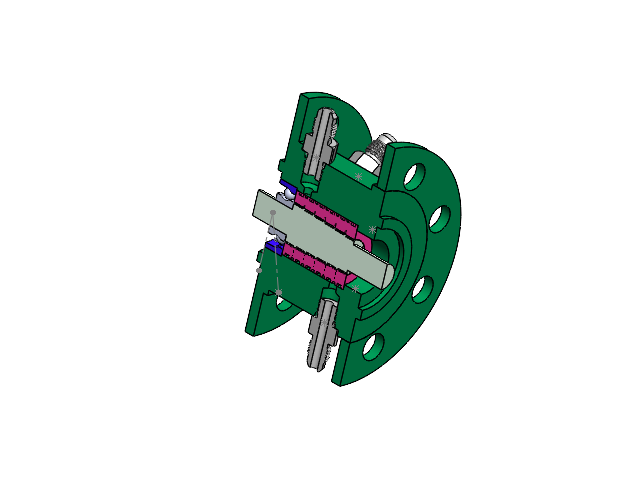
[picture p219: CAD file, 2025-01-29]
Pump Assembly/IPS assembly/IPS_assembly.SLDASM
shaft_seal_section
7201_cd_hcp4a_01
7201_cd_hcp4a_02
7201_cd_hcp4a_03
Seal_insert
IPS_Casing2
orb to -4an fitting x 5
