PURPL-Purdue/Turbopump/Pump Assembly/Low_RPM_Test_Casing_Assembly.SLDASM

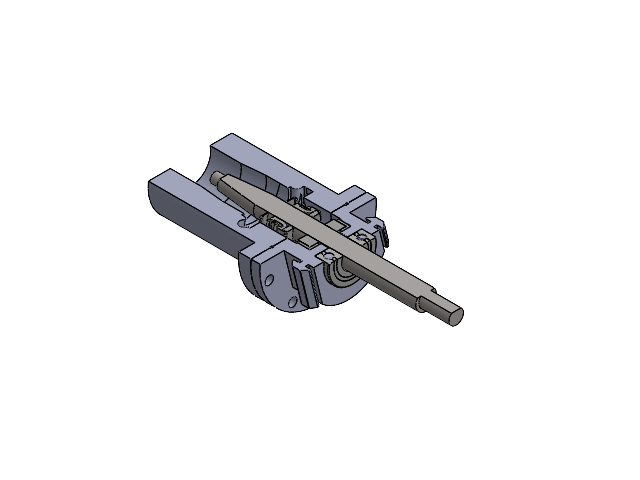
[picture p220: CAD file, 2024-10-14]
Pump Assembly/Low_RPM_Test_Casing_Assembly.SLDASM
Kerosene_Casing_Test_Stand
Test1_Shaft
Test1_Shaft_Seal
6661K44_Ball Bearing
Test1_Seal_Casing
