PURPL-Purdue/Turbopump/Shaft Assembly/Integrated Assembly.SLDASM

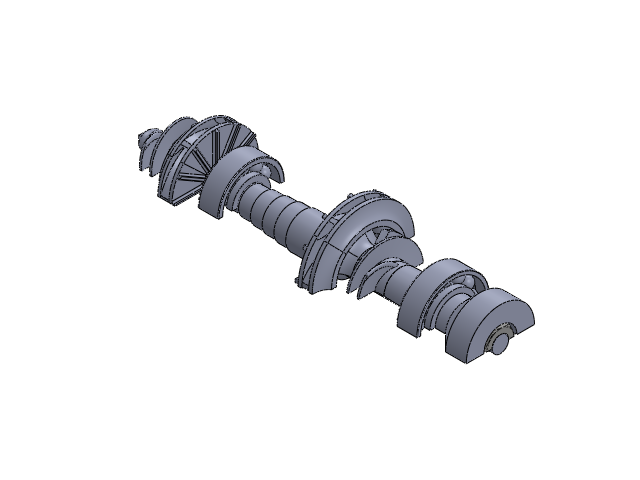
[picture p221: CAD file, 2024-11-17]
Shaft Assembly/Integrated Assembly.SLDASM
PDR_Shaft_Mockup
3x3x14_Machine Key
LOX_PDR_shaft_integrated
kerosene_PDR_shaft_integrated
PDR_Shaft_Sleeve
91423A120_Fine-Thread Medium-Strength Steel Hex Nut
Pump End Piece
7201_cd_hcp4a_01
7201_cd_hcp4a_02
7201_cd_hcp4a_03
7003_cd_hcp4a_01
7003_cd_hcp4a_02
7003_cd_hcp4a_03
