PURPL-Purdue/Turbopump/Turbine Assembly/Gas Generator/CAD/Assemblies/GasGenAssembly 1.SLDASM

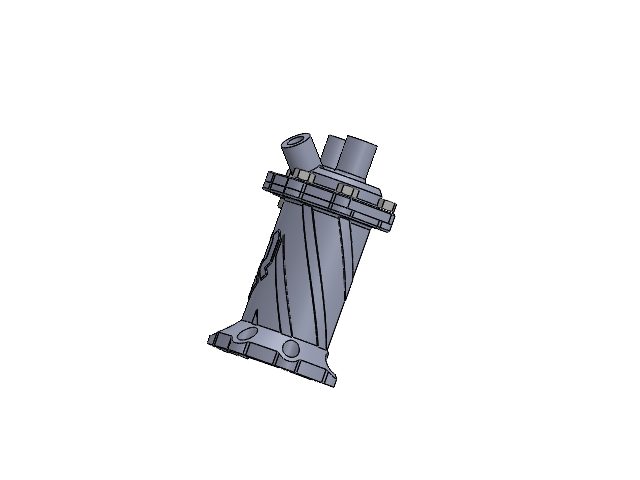
[picture p222: CAD file, 2025-02-15]
Turbine Assembly/Gas Generator/CAD/Assemblies/GasGenAssembly 1.SLDASM
GasGeneratorChamberV7 10-27
Grafoil gasket 10-27
GasGenerator_Injector_V10
92423A536_High-Strength A286 Stainless Steel Socket Head Screw x 2
94804A029_Super-Corrosion-Resistant 316 Stainless Steel Hex Nut x 7
