PURPL-Purdue/Turbopump/Pump Assembly/IPS assembly/Static_Testing_Rig/Static_test_assembly.SLDASM

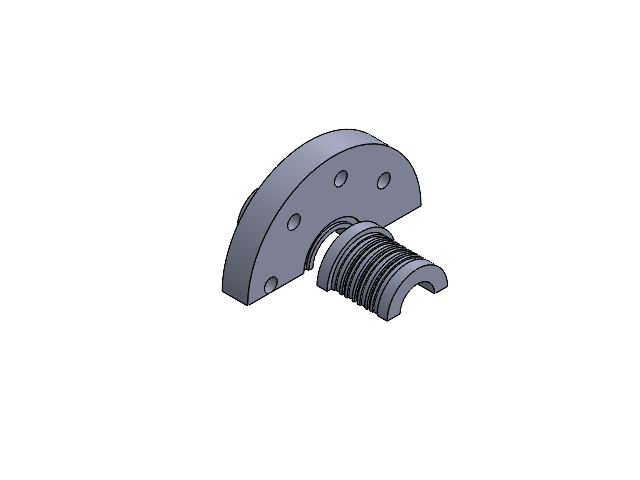
[picture p223: CAD file, 2025-01-21]
Pump Assembly/IPS assembly/Static_Testing_Rig/Static_test_assembly.SLDASM
shaft_seal_section
Seal_Test_insert
AN_fitting_inlet
