PURPL-Purdue/Turbopump/Pump Assembly/Seal Testing/1st try bad/SealTestAssembly.SLDASM

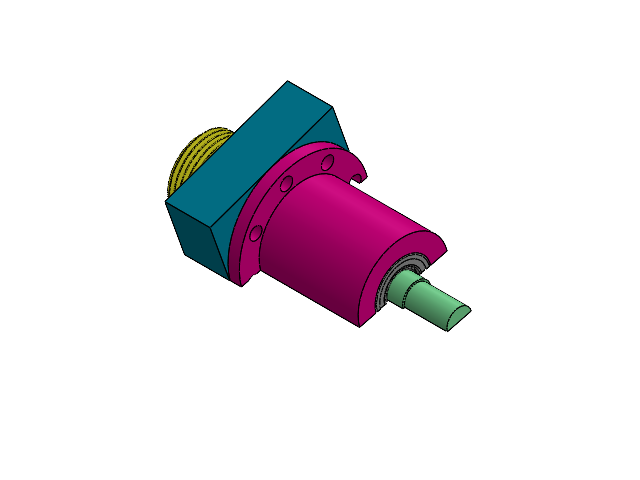
[picture p224: CAD file, 2024-11-20]
Pump Assembly/Seal Testing/1st try bad/SealTestAssembly.SLDASM
31thou5toothSeal
seal_test_shaft
Testing_Casing
-019 O-Ring
Lip_seal
Test_Casing_Inlet
4830K221_Standard-Wall 304 304L Stainless Steel Pipe Nipple
