PURPL-Purdue/Turbopump/(list of files, cad)

Other CAD files:
Pump Assembly/IPS assembly/Static_Testing_Rig/shaft_seal_section.SLDPRT
TCA/Countour Exports/nozzle_contour.dxf
TCA/TCA Sizing Code Files/TCA\Countour Exports\nozzle_contour.dxf
Pump Assembly/Integration and Casings/Test1_Seal_Casing.SLDPRT
Pump Assembly/IPS assembly/Half_casing.SLDPRT
Pump Assembly/Pumps/Exports/LOX_PDR_impeller_unintegrated_print.STEP
Pump Assembly/IPS assembly/Static_Testing_Rig/StaticSealTestCasing.SLDPRT
Test Stand Assembly/Electric motor test stand/CAD/3030 X 12in.SLDPRT
Pump Assembly/Pumps/CADs/kero_postPDR_inducer_material.stp
Pump Assembly/Pumps/Exports/LOX_PDR_inducer_unintegrated_print.STEP
Pump Assembly/IPS assembly/orb to -4an fitting.SLDPRT
Pump Assembly/Pumps/CADs/kerosene_PDR_shaft_integrated.SLDPRT
Pump Assembly/Pumps/CADs/kerosene_PDR_solid_part.SLDPRT
Pump Assembly/Pumps/CADs/kerosene_PDR_inducer_material.stp
Pump Assembly/Pumps/CADs/LOX_PDR_solidpart.SLDPRT
Pump Assembly/Pumps/CADs/lox_PDR_inducer_material.stp
Pump Assembly/Pumps/CADs/lox_PDR_impeller_material.stp
Pump Assembly/Pumps/CADs/kerosene_PDR_impeller_material.stp
Pump Assembly/Pumps/CADs/Kerosene_Test_Stand_Combined.SLDPRT
Pump Assembly/Pumps/CADs/Kerosene_Test_Stand_inducer_thick_blades.stp
Full Assembly/Full Assembly/FullAssembly_RevA.prt
Full Assembly/Full Assembly/FullAssembly_RevB.prt
Full Assembly/Full Assembly/FullAssembly_RevC_20250303.prt
Full Assembly/Full Assembly/FullAssembly_RevD_20250307.prt
Full Assembly/Full Assembly/FullAssembly_RevE_20250309.prt
Full Assembly/Full Assembly/FullAssembly_RevF_20250309.prt
Full Assembly/Full Assembly/FullAssembly_RevG_20250417.prt
Full Assembly/Gas Generator Subassembly/92423A536_High-Strength A286 Stainless Steel Socket Head Screw.SLDPRT
Full Assembly/Gas Generator Subassembly/94804A029_Super-Corrosion-Resistant 316 Stainless Steel Hex Nut.SLDPRT
Full Assembly/Gas Generator Subassembly/TRBP_GasGenerator_Injector.prt
Full Assembly/IPS Casing Subassembly/Pumps_IPScasing_2-17-2025.prt
Full Assembly/IPS Casing Subassembly/Pumps_IPScasing_2-18-2025.prt
Full Assembly/IPS Casing Subassembly/Pumps_IPScasing_2-21-2025.prt
Full Assembly/IPS Casing Subassembly/Pumps_IPScasing_2-22-2025.prt
Full Assembly/IPS Casing Subassembly/Pumps_IPScasing_2-25-2025.prt
Full Assembly/IPS Casing Subassembly/Pumps_IPScasing_3-10-2025.prt
Full Assembly/IPS Casing Subassembly/Pumps_IPScasing_3-4-2025.prt
Full Assembly/IPS Casing Subassembly/Pumps_IPScasing_3-5-2025.prt
Full Assembly/IPS Casing Subassembly/Pumps_IPScasing_4-12-2025 - Copy.prt
Full Assembly/IPS Casing Subassembly/Pumps_IPScasing_4-8-2025.prt
Full Assembly/LOX Casing Subassembly/Pumps_LOXcasing_3-8-2025.prt
Full Assembly/LOX Casing Subassembly/lox_casing.prt
Full Assembly/RP1 Casing Subassembly/kero_casing_2_24_2025 (1).prt
Full Assembly/RP1 Casing Subassembly/kero_casing_3_8_2025.prt
Full Assembly/RP1 Casing Subassembly/kero_casing_3_9_2025.prt
Full Assembly/Turbine Subassembly/TBRP_ShroudV2.prt
Full Assembly/Turbine Subassembly/TBRP_StatorAssembly.prt
Full Assembly/Turbine Subassembly/TRBP_TurbineStatorV2.prt
Full Assembly/Turbine Subassembly/Turbine_stator_2-27-2025.prt
MARLIN V1/Archive/Full Assembly/5000lbf_engine_temp_3_7_2025.prt
MARLIN V1/Archive/Full Assembly/Full Assembly/2447K29_Easy-Adapt Clevis Rod End_step.prt
MARLIN V1/Archive/Full Assembly/Full Assembly/6071K31_Clevis Rod End_step.prt
MARLIN V1/Archive/Full Assembly/Full Assembly/90152A150_Stainless Steel Wire-Lockable Socket Head Screws.prt
MARLIN V1/Archive/Full Assembly/Full Assembly/90152A233_Stainless Steel Wire-Lockable Socket Head Screws.prt
MARLIN V1/Archive/Full Assembly/Full Assembly/90152A234_Stainless Steel Wire-Lockable Socket Head Screws.prt
MARLIN V1/Archive/Full Assembly/Full Assembly/91841A011_18-8 Stainless Steel Hex Nut_sldprt.prt
MARLIN V1/Archive/Full Assembly/Full Assembly/92141A222_18-8 Stainless Steel Washer.prt
MARLIN V1/Archive/Full Assembly/Full Assembly/FullAssembly_RevA.prt
MARLIN V1/Archive/Full Assembly/Full Assembly/FullAssembly_RevB.prt
MARLIN V1/Archive/Full Assembly/Full Assembly/FullAssembly_RevC_20250303.prt
MARLIN V1/Archive/Full Assembly/Full Assembly/FullAssembly_RevD_20250307.prt
MARLIN V1/Archive/Full Assembly/Full Assembly/FullAssembly_RevE_20250309.prt
MARLIN V1/Archive/Full Assembly/Full Assembly/FullAssembly_RevF_20250309.prt
MARLIN V1/Archive/Full Assembly/Full Assembly/FullAssembly_RevG_20250417.prt
MARLIN V1/Archive/Full Assembly/Full Assembly/FullAssembly_RevH_20250606.prt
MARLIN V1/Archive/Full Assembly/Full Assembly/lolLmao.prt
MARLIN V1/Archive/Full Assembly/Gas Generator Subassembly/TRBP_GasGenerator_ GrafoilGasket.prt
MARLIN V1/Archive/Full Assembly/Gas Generator Subassembly/TRBP_GasGenerator_Chamber.prt
MARLIN V1/Archive/Full Assembly/Gas Generator Subassembly/TRBP_GasGenerator_Chamber_AN.prt
MARLIN V1/Archive/Full Assembly/IPS Casing Subassembly/91251A245_Black-Oxide Alloy Steel Socket Head Screw.STEP
MARLIN V1/Archive/Full Assembly/IPS Casing Subassembly/91251A245_Black-Oxide Alloy Steel Socket Head Screw_step.prt
MARLIN V1/Archive/Full Assembly/IPS Casing Subassembly/An_-4_nut.STEP
MARLIN V1/Archive/Full Assembly/IPS Casing Subassembly/An_-4_nut_step.prt
MARLIN V1/Archive/Full Assembly/IPS Casing Subassembly/Fuel_O-ring.STEP
MARLIN V1/Archive/Full Assembly/IPS Casing Subassembly/Fuel_O-ring_step.prt
MARLIN V1/Archive/Full Assembly/IPS Casing Subassembly/IPS_subassembly.prt
MARLIN V1/Archive/Full Assembly/IPS Casing Subassembly/Lox_o-ring.STEP
MARLIN V1/Archive/Full Assembly/IPS Casing Subassembly/Lox_o-ring_step.prt
MARLIN V1/Archive/Full Assembly/IPS Casing Subassembly/Pumps_Clocking_Assembly_4-19-2025.prt
MARLIN V1/Archive/Full Assembly/IPS Casing Subassembly/Pumps_FuelSidePressureCap_3-11-2025.prt
MARLIN V1/Archive/Full Assembly/IPS Casing Subassembly/Pumps_IPS_-4_fitting.prt
MARLIN V1/Archive/Full Assembly/IPS Casing Subassembly/Pumps_IPSassembly_2-17-2025.prt
MARLIN V1/Archive/Full Assembly/IPS Casing Subassembly/Pumps_IPScasing_2-17-2025.prt
MARLIN V1/Archive/Full Assembly/IPS Casing Subassembly/Pumps_IPScasing_2-18-2025.prt
MARLIN V1/Archive/Full Assembly/IPS Casing Subassembly/Pumps_IPScasing_2-21-2025.prt
MARLIN V1/Archive/Full Assembly/IPS Casing Subassembly/Pumps_IPScasing_2-22-2025.prt
MARLIN V1/Archive/Full Assembly/IPS Casing Subassembly/Pumps_IPScasing_2-25-2025.prt
MARLIN V1/Archive/Full Assembly/IPS Casing Subassembly/Pumps_IPScasing_3-10-2025.prt
MARLIN V1/Archive/Full Assembly/IPS Casing Subassembly/Pumps_IPScasing_3-4-2025.prt
MARLIN V1/Archive/Full Assembly/IPS Casing Subassembly/Pumps_IPScasing_3-5-2025.prt
MARLIN V1/Archive/Full Assembly/IPS Casing Subassembly/Pumps_IPScasing_4-12-2025 - Copy.prt
MARLIN V1/Archive/Full Assembly/IPS Casing Subassembly/Pumps_IPScasing_4-12-2025.prt
MARLIN V1/Archive/Full Assembly/IPS Casing Subassembly/Pumps_IPScasing_4-19-2025.prt
MARLIN V1/Archive/Full Assembly/IPS Casing Subassembly/Pumps_IPScasing_4-8-2025.prt
MARLIN V1/Archive/Full Assembly/IPS Casing Subassembly/Pumps_LabyIPSsection_1-29-2025.prt
MARLIN V1/Archive/Full Assembly/IPS Casing Subassembly/Pumps_LoxSidePressureCap_3-11-2025.prt
MARLIN V1/Archive/Full Assembly/IPS Casing Subassembly/Pumps_O-ringCap_3-31-2025.prt
MARLIN V1/Archive/Full Assembly/IPS Casing Subassembly/Pumps_SealInsert_2-2-2025.prt
MARLIN V1/Archive/Full Assembly/IPS Casing Subassembly/Pumps_SealTestAssembly_3-11-2025.prt
MARLIN V1/Archive/Full Assembly/IPS Casing Subassembly/Stainless Steel Socket Head Screw 10-32.STEP
MARLIN V1/Archive/Full Assembly/IPS Casing Subassembly/Stainless Steel Socket Head Screw 10-32_step.prt
MARLIN V1/Archive/Full Assembly/IPS Casing Subassembly/orb_fitting_feature.prt
MARLIN V1/Archive/Full Assembly/LOX Casing Subassembly/Archive/Pumps_LOXcasing_2-27-2025.prt
MARLIN V1/Archive/Full Assembly/LOX Casing Subassembly/Archive/Pumps_LOXcasing_3-4-2025.prt
MARLIN V1/Archive/Full Assembly/LOX Casing Subassembly/LoxInlet.prt
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
