PURPL-Purdue/Turbopump/Pump Assembly/README.md

Pump Assembly doc
Naming Convention:    Caps with Underscores
