PURPL-Purdue/Turbopump/Turbine Assembly/README.md

# Official Turbopump Turbine Design Document

## Gas Generator
[Put design requirements here]

## Rotor & Stator
[Put desgn requirements here]

## How to load constants:
1. Run `main`
2. call `load('params.mat')` to load constants into your current workspace (in the code)
