PURPL-Purdue/Turbopump/MARLIN V1/Archive/Full Assembly/Seals Reference Subassembly/README.md

This folder contains a reference assembly that points to seals in the full assembly. It is driven, and does not drive. It's purpose is documentation
