PURPL-Purdue/Turbopump/MARLIN V1/Archive/Full Assembly/LOX Casing Subassembly/README.md

9/14/25

* LOX inlet and casing inner diameter mismatched (0.844 and 0.75 inches) - Charlie Z.
