PURPL-Purdue/Turbopump/Turbine Assembly/cgrotor.png

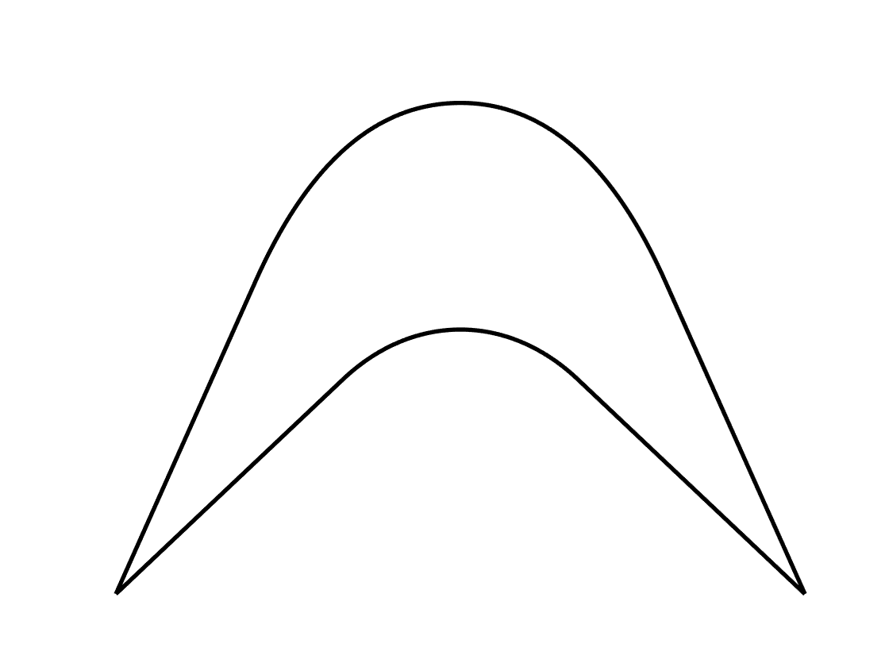
Turbine Assembly/cgrotor.png
