PURPL-Purdue/Turbopump/Turbine Assembly/Plots/example.png

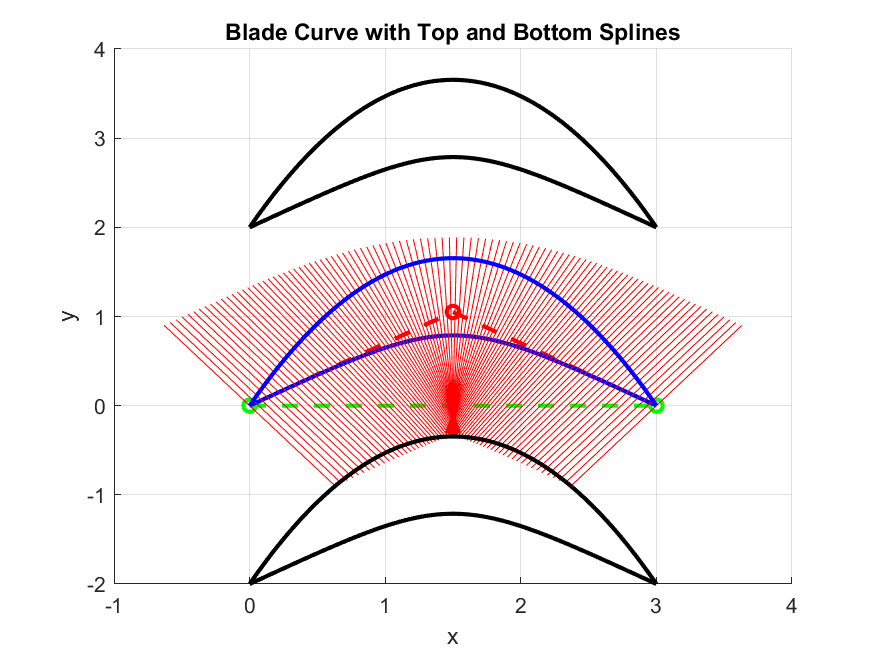
Turbine Assembly/Plots/example.png
