PURPL-Purdue/Turbopump/Turbine Assembly/Plots/rotor.png

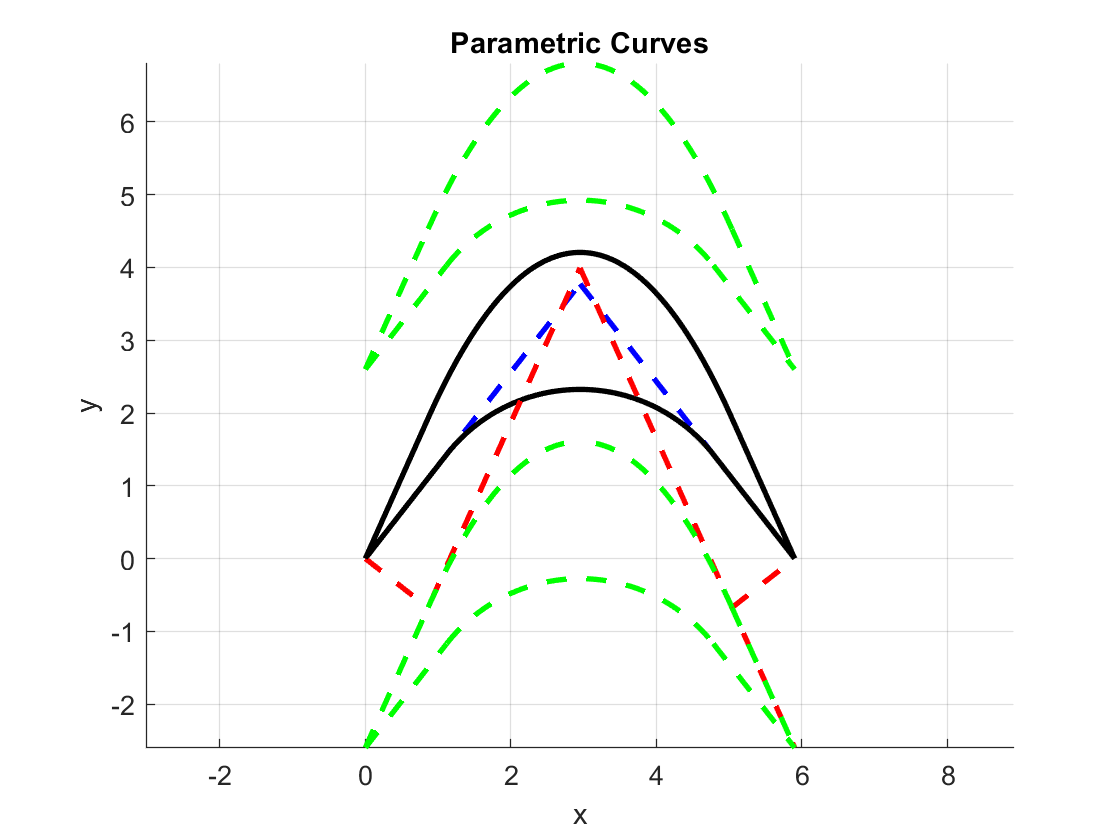
Turbine Assembly/Plots/rotor.png
