PURPL-Purdue/Turbopump/Turbine Assembly/Plots/rotorsvg.png

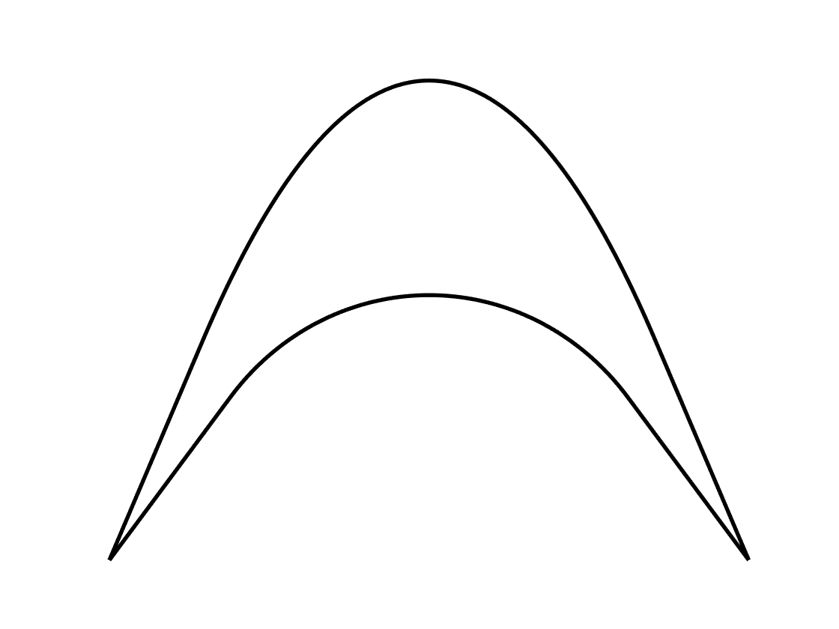
Turbine Assembly/Plots/rotorsvg.png
