PURPL-Purdue/Turbopump/Pump Assembly/Seal Testing/IPS test equations.txt

"bearing_radius"= 0.629921

"bearing_width"=0.393701

"kero_radius"=0.334in

"lox_radius"=0.23622in

"Cavity_width"=0.031in

"tooth_width"=0.01in

"cavity_depth"=0.031in

"seal_step"=0.01in

"purge_length"=0.04in

"insert_radius" = 0.6in

"recycle_groove width" = 0.06in

"recycle_groove_depth" = 0.06in

"N2_purge_width"= .06in

"N2_purge_depth"= .06in

"drain_width"= .06in

"drain_depth"= .06in

"radial_clearance"= .002in

"IPS_flange_width"= .4in

"IPS_flange_radius" = 1.7in

"IPS_LOX_male_radius"= .9in

"IPS_Kero_male_radius" = .9in

"IPS_radius"= 1.2in

"InsertLength"= 1in
