PURPL-Purdue/Turbopump/MARLIN V2/Tenkara/4 - Subteams/Gas Generator/Development/TestMatrix_Outputs.csv

P_fuel_psia | P_ox_psia | P_N2_purge_psia | P_torch_CH4_psia | P_torch_GOx_psia | P_c_psia | temp | OF_core | mdot_total_kg_s | mdot_torch | P_c_torch | OF_torch | insert_id | cooling_pct | OF_overall | mdot_fuel_kg_s | mdot_ox_kg_s | mdot_film_kg_s | stiff_fuel | stiff_ox | stiff_film | cstar_ms | warnings
532.1042000844202 | 439.3025315831469 | 800.0 | 648.953581916773 | 628.3407521894186 | 365.8629454007292 | 711.883938315511 | 0.35 | 0.317 | 0.00827712608597925 | 200.0 | 1.4 | 20% | 21.41449005762198 | 0.2558715305814925 | 0.18453041964247285 | 0.0645856468748655 | 0.06788393348266167 | 0.31242236888435815 | 0.16717314584497858 | 0.31242236888435815 | 779.8376598629178 | LOX stiff=0.17<0.2
527.5307882146639 | 513.689023058979 | 800.0 | 648.953581916773 | 628.3407521894186 | 386.91753204971354 | 792.2285297109354 | 0.5 | 0.317 | 0.00827712608597925 | 200.0 | 1.4 | 20% | 19.694795044527723 | 0.36553075797356066 | 0.16971166647256478 | 0.08485583323628239 | 0.062432500291152875 | 0.2665498570061311 | 0.246786451176922 | 0.2665498570061311 | 824.7155568681505
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
