PURPL-Purdue/Turbopump/MARLIN V2/Tenkara/4 - Subteams/Gas Generator/Development/GGIE_Refactored/MIE_Studies/IPA/Results/_vs_OF.csv

OF_torch | Energy (MJ) | Temperature (K) | mdot (kg/s)
1.0 | 42.306746883206564 | 1281.9755675757415 | 0.05612510071118237
1.1 | 44.597428077280775 | 1369.736332299565 | 0.053242317594365804
1.2000000000000002 | 46.68330342430326 | 1455.4036906863855 | 0.050863376312532405
1.3000000000000003 | 48.58793659900507 | 1539.050986497891 | 0.048869546553888664
1.4000000000000004 | 50.33146996259983 | 1620.7481693787352 | 0.047176655705602956
1.5000000000000004 | 51.931043333875266 | 1700.5570295205605 | 0.0457235263754767
1.6000000000000005 | 53.40114778393368 | 1778.5271605341843 | 0.04446478265204731
1.7000000000000006 | 54.75393542744006 | 1854.6928320676905 | 0.04336620575390637
1.8000000000000007 | 55.99950244192119 | 1929.0709702704019 | 0.042401634408182565
1.9000000000000008 | 57.14615827632235 | 2001.6604194090348 | 0.04155083213295013
2.000000000000001 | 58.200689522728 | 2072.442596500981 | 0.04079797763659162
2.100000000000001 | 59.16862227107699 | 2141.3835532598628 | 0.04013056817013578
2.200000000000001 | 60.05448204760197 | 2208.4373293672456 | 0.039538604757266144
2.300000000000001 | 60.86204602487918 | 2273.550332021796 | 0.03901397643798951
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
