PURPL-Purdue/Turbopump/MARLIN V2/Tenkara/4 - Subteams/Gas Generator/Development/GGIE_Refactored/MIE_Studies/Methane/Results/vs_OF.csv

OF_torch | Energy (MJ) | Temperature (K) | mdot (kg/s)
1.5 | 26.687897523861142 | 1882.7802257865096 | 0.04980498029059336
1.55 | 28.100221964028126 | 1980.981901934728 | 0.047301769070536626
1.6 | 29.446631492985553 | 2076.3836783448623 | 0.04513895623307217
1.6500000000000001 | 30.727095824034034 | 2168.885111565437 | 0.04325791860660054
1.7000000000000002 | 31.94127652062189 | 2258.3621453468604 | 0.04161355947421604
1.7500000000000002 | 33.08856926282474 | 2344.670427241776 | 0.040170676453715234
1.8000000000000003 | 34.168291307485795 | 2427.6581434000263 | 0.03890127832883679
1.8500000000000003 | 35.179899455535505 | 2507.1811401978866 | 0.03778266085874595
1.9000000000000004 | 36.1231786409975 | 2583.116440686412 | 0.03679604786121267
1.9500000000000004 | 36.99836624894005 | 2655.3717521445606 | 0.03592564604690779
2.0000000000000004 | 37.80619926047166 | 2723.8899277495225 | 0.03515799620627342
2.0500000000000007 | 38.54789112739739 | 2788.6486529316085 | 0.03448152859466223
2.1000000000000005 | 39.22505906148979 | 2849.6565897711407 | 0.03388625133972701
2.1500000000000004 | 39.839627806560806 | 2906.9476511202897 | 0.033363519775513266
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
