PURPL-Purdue/Turbopump/MARLIN V2/Tenkara/4 - Subteams/Gas Generator/Development/GGIE_Refactored/MIE_Studies/Methane_IPA/Results/vs_OF.csv

OF_torch | Energy (MJ) | Temperature (K) | mdot (kg/s)
1.0 | 16.47359082391703 | 1229.9811953135222 | 0.13164404606277327
1.1 | 17.259214131689614 | 1272.0017887286028 | 0.12565173203692728
1.2000000000000002 | 18.35778610778223 | 1336.3846327347446 | 0.11813244453935971
1.3000000000000003 | 20.525007832574772 | 1473.0234250253752 | 0.10565891944758223
1.4000000000000004 | 23.662996216949395 | 1678.16283601763 | 0.09164731842747985
1.5000000000000004 | 26.68351705127067 | 1882.467424896941 | 0.08127302503174862
1.6000000000000005 | 29.444849357338136 | 2076.234385757844 | 0.07365125638527165
1.7000000000000006 | 31.94235696315861 | 2258.400646726564 | 0.06789261518003416
1.8000000000000007 | 34.171643027559234 | 2427.851975794164 | 0.06346344387052177
1.9000000000000008 | 36.127758239365484 | 2583.40060679614 | 0.060027254801545096
2.000000000000001 | 37.8109445807606 | 2724.194884898637 | 0.05735509052441102
2.100000000000001 | 39.2291774191891 | 2849.92813910196 | 0.05528156061162294
2.200000000000001 | 40.396790036906715 | 2960.7814962313755 | 0.053683724554889685
2.300000000000001 | 41.33158607498851 | 3057.2492626165063 | 0.05246956033355213
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
