PURPL-Purdue/Turbopump/MARLIN V1/SystemsDesignSoftware/V1 pumps march 2026 test campaign/CFTurbo performance curves/README.txt

###############################
Performance prediction curves
###############################

Curves generated by Alejandro Diaz Contreras on 3/4/2026

NOTE:

First column is in [gal/min] (Q, volumetric flowrate) and the second column is in [ft] (H, head rise)

Sorry, this iteration of the pumps is a lil slop :( 
We'll get them in V2
