PURPL-Purdue/Turbopump/MARLIN V2/Tenkara/4 - Subteams/Gas Generator/Development/GGIE_Refactored/MIE_Studies/IPA/Results/reaction.png

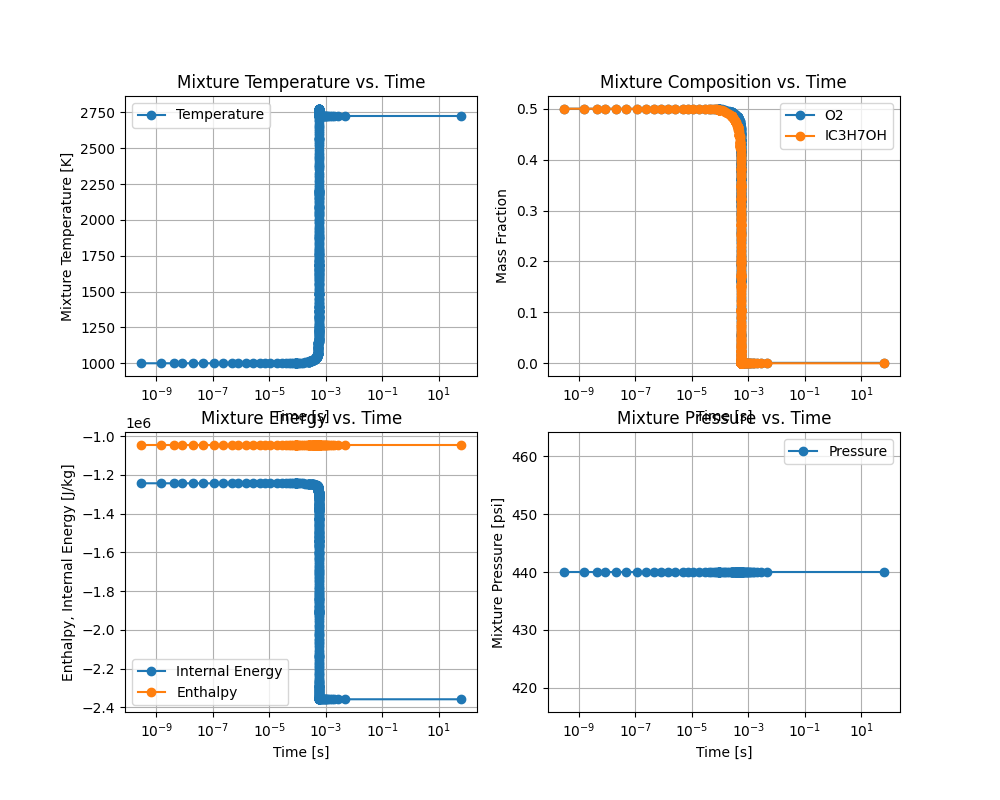
MARLIN V2/Tenkara/4 - Subteams/Gas Generator/Development/GGIE_Refactored/MIE_Studies/IPA/Results/reaction.png
