PURPL-Purdue/Turbopump/MARLIN V2/Tenkara/4 - Subteams/Gas Generator/Development/GGIE_Refactored/Results/vs_OF.png

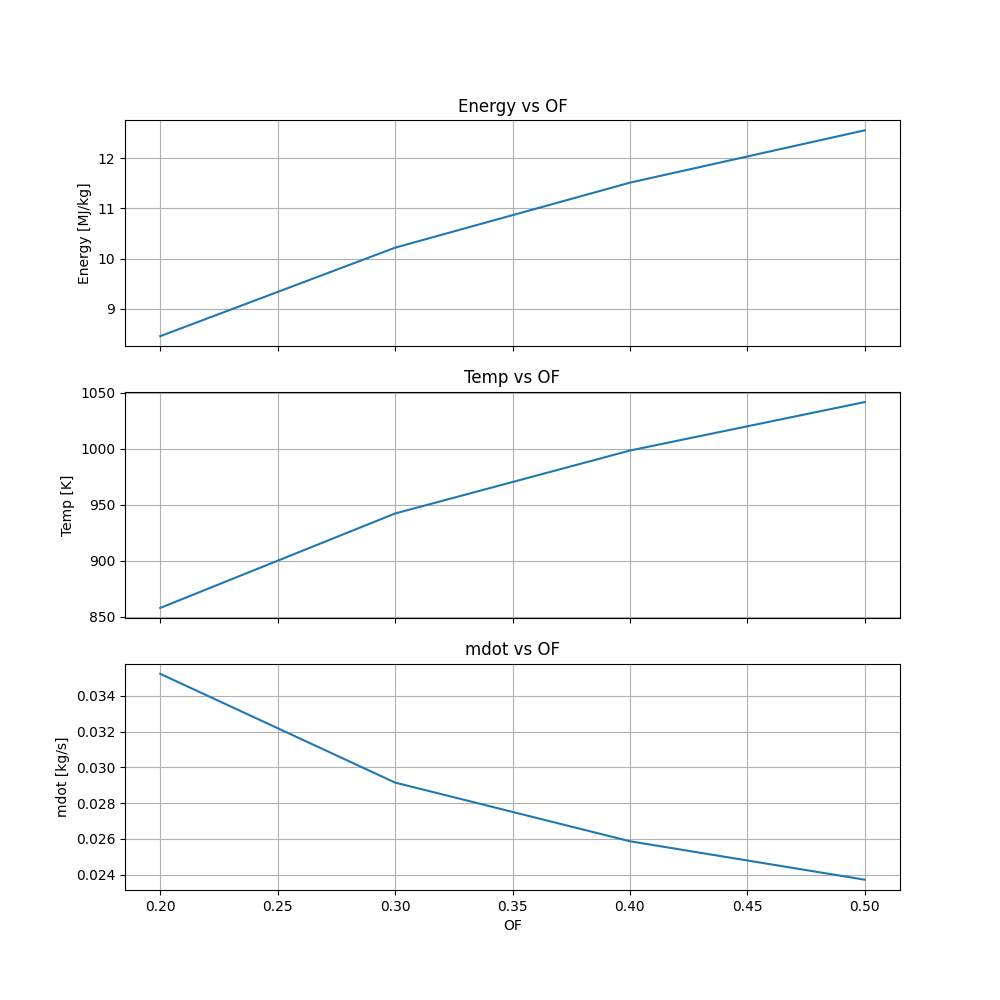
MARLIN V2/Tenkara/4 - Subteams/Gas Generator/Development/GGIE_Refactored/Results/vs_OF.png
