PURPL-Purdue/Turbopump/MARLIN V2/Tenkara/4 - Subteams/TCA/Development/MIE_Refactored/MIE_Refactored/MIE_Studies/Methane_Torch_IPA_Engine/Results/vs_OF.png

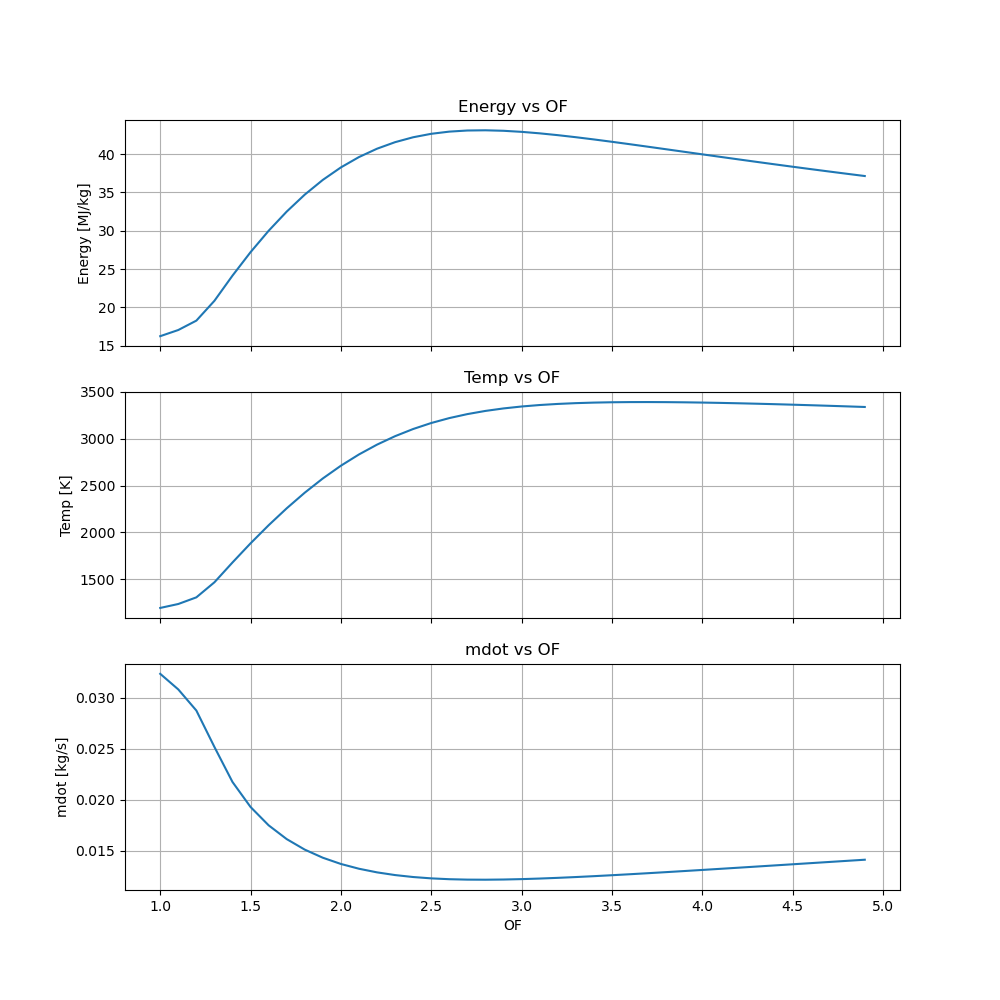
MARLIN V2/Tenkara/4 - Subteams/TCA/Development/MIE_Refactored/MIE_Refactored/MIE_Studies/Methane_Torch_IPA_Engine/Results/vs_OF.png
