PURPL-Purdue/Turbopump/MARLIN V2/Tenkara/4 - Subteams/Gas Generator/Development/GGIE_Refactored/CH4_grimech30.yaml

generator: ctml2yaml
cantera-version: 3.2.0
date: Tue, 08 Sep 2026 16:36:18 -0400
input-files: [C:\Users\igoto\Downloads\grimech30.xml]

phases:
- name: gas
  elements: [O, H, C, N, Ar]
  species: [H2, H, O, O2, OH, H2O, HO2, H2O2, C, CH, CH2, CH2(S), CH3, CH4, CO, 
      CO2, HCO, CH2O, CH2OH, CH3O, CH3OH, C2H, C2H2, C2H3, C2H4, C2H5, C2H6, 
      HCCO, CH2CO, HCCOH, N, NH, NH2, NH3, NNH, NO, NO2, N2O, HNO, CN, HCN, H2CN,
    HCNN, HCNO, HOCN, HNCO, NCO, N2, AR, C3H7, C3H8, CH2CHO, CH3CHO]
  thermo: ideal-gas
  transport: mixture-averaged
  kinetics: gas
  reactions: all
  state: {T: 300.0 K, P: 1.01325e+05 Pa}

species:
- name: H2
  composition: {H: 2.0}
  note: TPIS78
  thermo:
    model: NASA7
    temperature-ranges: [200.0, 1000.0, 3500.0]
    data:
    - [2.34433112, 7.98052075e-03, -1.9478151e-05, 2.01572094e-08, 
        -7.37611761e-12, -917.935173, 0.683010238]
    - [3.3372792, -4.94024731e-05, 4.99456778e-07, -1.79566394e-10, 
        2.00255376e-14, -950.158922, -3.20502331]
  transport:
    model: gas
    geometry: linear
    well-depth: 38.0
    diameter: 2.92
    dipole: 0.0
    polarizability: 0.79
    rotational-relaxation: 280.0
- name: H
  composition: {H: 1.0}
  note: L7/88
  thermo:
    model: NASA7
    temperature-ranges: [200.0, 1000.0, 3500.0]
    data:
    - [2.5, 7.05332819e-13, -1.99591964e-15, 2.30081632e-18, -9.27732332e-22, 
        2.54736599e+04, -0.446682853]
    - [2.50000001, -2.30842973e-11, 1.61561948e-14, -4.73515235e-18, 
        4.98197357e-22, 2.54736599e+04, -0.446682914]
  transport:
    model: gas
    geometry: atom
    well-depth: 145.0
    diameter: 2.05
    dipole: 0.0
    polarizability: 0.0
    rotational-relaxation: 0.0
- name: O
  composition: {O: 1.0}
  note: L1/90
  thermo:
    model: NASA7
    temperature-ranges: [200.0, 1000.0, 3500.0]
    data:
    - [3.1682671, -3.27931884e-03, 6.64306396e-06, -6.12806624e-09, 
        2.11265971e-12, 2.91222592e+04, 2.05193346]
    - [2.56942078, -8.59741137e-05, 4.19484589e-08, -1.00177799e-11, 
        1.22833691e-15, 2.92175791e+04, 4.78433864]
  transport:
    model: gas
    geometry: atom
    well-depth: 80.0
    diameter: 2.75
    dipole: 0.0
    polarizability: 0.0
    rotational-relaxation: 0.0
- name: O2
  composition: {O: 2.0}
  note: TPIS89
  thermo:
    model: NASA7
    temperature-ranges: [200.0, 1000.0, 3500.0]
    data:
    - [3.78245636, -2.99673416e-03, 9.84730201e-06, -9.68129509e-09, 
        3.24372837e-12, -1063.94356, 3.65767573]
    - [3.28253784, 1.48308754e-03, -7.57966669e-07, 2.09470555e-10, 
        -2.16717794e-14, -1088.45772, 5.45323129]
  transport:
    model: gas
    geometry: linear
    well-depth: 107.4
    diameter: 3.458
    dipole: 0.0
    polarizability: 1.6
    rotational-relaxation: 3.8
- name: OH
  composition: {H: 1.0, O: 1.0}
  note: RUS78
  thermo:
    model: NASA7
    temperature-ranges: [200.0, 1000.0, 3500.0]
    data:
    - [3.99201543, -2.40131752e-03, 4.61793841e-06, -3.88113333e-09, 
        1.3641147e-12, 3615.08056, -0.103925458]
    - [3.09288767, 5.48429716e-04, 1.26505228e-07, -8.79461556e-11, 
        1.17412376e-14, 3858.657, 4.4766961]
  transport:
    model: gas
    geometry: linear
    well-depth: 80.0
    diameter: 2.75
    dipole: 0.0
    polarizability: 0.0
    rotational-relaxation: 0.0
- name: H2O
  composition: {H: 2.0, O: 1.0}
  note: L8/89
  thermo:
    model: NASA7
    temperature-ranges: [200.0, 1000.0, 3500.0]
    data:
    - [4.19864056, -2.0364341e-03, 6.52040211e-06, -5.48797062e-09, 
        1.77197817e-12, -3.02937267e+04, -0.849032208]
    - [3.03399249, 2.17691804e-03, -1.64072518e-07, -9.7041987e-11, 
        1.68200992e-14, -3.00042971e+04, 4.9667701]
  transport:
    model: gas
    geometry: nonlinear
    well-depth: 572.4
    diameter: 2.605
    dipole: 1.844
    polarizability: 0.0
    rotational-relaxation: 4.0
- name: HO2
  composition: {H: 1.0, O: 2.0}
  note: L5/89
  thermo:
    model: NASA7
    temperature-ranges: [200.0, 1000.0, 3500.0]
    data:
    - [4.30179801, -4.74912051e-03, 2.11582891e-05, -2.42763894e-08, 
        9.29225124e-12, 294.80804, 3.71666245]
    - [4.0172109, 2.23982013e-03, -6.3365815e-07, 1.1424637e-10, -1.07908535e-14,
      111.856713, 3.78510215]
  transport:
    model: gas
    geometry: nonlinear
    well-depth: 107.4
    diameter: 3.458
    dipole: 0.0
    polarizability: 0.0
    rotational-relaxation: 1.0
- name: H2O2
  composition: {H: 2.0, O: 2.0}
  note: L7/88
  thermo:
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
    rotational-relaxation: 4.0
- name: AR
  composition: {Ar: 1.0}
  note: '120186'
  thermo:
    model: NASA7
    temperature-ranges: [300.0, 1000.0, 5000.0]
    data:
    - [2.5, 0.0, 0.0, 0.0, 0.0, -745.375, 4.366]
    - [2.5, 0.0, 0.0, 0.0, 0.0, -745.375, 4.366]
  transport:
    model: gas
    geometry: atom
    well-depth: 136.5
    diameter: 3.33
    dipole: 0.0
    polarizability: 0.0
    rotational-relaxation: 0.0
- name: C3H7
  composition: {H: 7.0, C: 3.0}
  note: L9/84
  thermo:
    model: NASA7
    temperature-ranges: [300.0, 1000.0, 5000.0]
    data:
    - [1.0515518, 0.02599198, 2.380054e-06, -1.9609569e-08, 9.373247e-12, 
        1.0631863e+04, 21.122559]
    - [7.7026987, 0.016044203, -5.283322e-06, 7.629859e-10, -3.9392284e-14, 
        8298.4336, -15.48018]
  transport:
    model: gas
    geometry: nonlinear
    well-depth: 266.8
    diameter: 4.982
    dipole: 0.0
    polarizability: 0.0
    rotational-relaxation: 1.0
- name: C3H8
  composition: {H: 8.0, C: 3.0}
  note: L4/85
  thermo:
    model: NASA7
    temperature-ranges: [300.0, 1000.0, 5000.0]
    data:
    - [0.93355381, 0.026424579, 6.1059727e-06, -2.1977499e-08, 9.5149253e-12, 
        -1.395852e+04, 19.201691]
    - [7.5341368, 0.018872239, -6.2718491e-06, 9.1475649e-10, -4.7838069e-14, 
        -1.6467516e+04, -17.892349]
  transport:
    model: gas
    geometry: nonlinear
    well-depth: 266.8
    diameter: 4.982
    dipole: 0.0
    polarizability: 0.0
    rotational-relaxation: 1.0
- name: CH2CHO
  composition: {H: 3.0, C: 2.0, O: 1.0}
  note: SAND86
  thermo:
    model: NASA7
    temperature-ranges: [300.0, 1000.0, 5000.0]
    data:
    - [3.409062, 0.010738574, 1.891492e-06, -7.158583e-09, 2.867385e-12, 
        1521.4766, 9.55829]
    - [5.97567, 8.130591e-03, -2.743624e-06, 4.070304e-10, -2.176017e-14, 
        490.3218, -5.045251]
  transport:
    model: gas
    geometry: nonlinear
    well-depth: 436.0
    diameter: 3.97
    dipole: 0.0
    polarizability: 0.0
    rotational-relaxation: 2.0
- name: CH3CHO
  composition: {H: 4.0, C: 2.0, O: 1.0}
  note: L8/88
  thermo:
    model: NASA7
    temperature-ranges: [200.0, 1000.0, 6000.0]
    data:
    - [4.7294595, -3.1932858e-03, 4.7534921e-05, -5.7458611e-08, 2.1931112e-11, 
        -2.1572878e+04, 4.1030159]
    - [5.4041108, 0.011723059, -4.2263137e-06, 6.8372451e-10, -4.0984863e-14, 
        -2.2593122e+04, -3.4807917]
  transport:
    model: gas
    geometry: nonlinear
    well-depth: 436.0
    diameter: 3.97
    dipole: 0.0
    polarizability: 0.0
    rotational-relaxation: 2.0

reactions:
- equation: 2 O + M <=> O2 + M
  type: three-body
  rate-constant: {A: 1.2e+11, b: -1.0, Ea: 0.0 cal/mol}
  efficiencies: {AR: 0.83, C2H6: 3.0, CH4: 2.0, CO: 1.75, CO2: 3.6, H2: 2.4, H2O: 
      15.4}
- equation: O + H + M <=> OH + M
  type: three-body
  rate-constant: {A: 5.0e+11, b: -1.0, Ea: 0.0 cal/mol}
  efficiencies: {AR: 0.7, C2H6: 3.0, CH4: 2.0, CO: 1.5, CO2: 2.0, H2: 2.0, H2O: 
      6.0}
- equation: O + H2 <=> H + OH
  rate-constant: {A: 38.7, b: 2.7, Ea: 6260.0 cal/mol}
- equation: O + HO2 <=> OH + O2
  rate-constant: {A: 2.0e+10, b: 0.0, Ea: 0.0 cal/mol}
- equation: O + H2O2 <=> OH + HO2
  rate-constant: {A: 9630.0, b: 2.0, Ea: 4000.0 cal/mol}
- equation: O + CH <=> H + CO
  rate-constant: {A: 5.7e+10, b: 0.0, Ea: 0.0 cal/mol}
- equation: O + CH2 <=> H + HCO
  rate-constant: {A: 8.0e+10, b: 0.0, Ea: 0.0 cal/mol}
- equation: O + CH2(S) <=> H2 + CO
  rate-constant: {A: 1.5e+10, b: 0.0, Ea: 0.0 cal/mol}
- equation: O + CH2(S) <=> H + HCO
  rate-constant: {A: 1.5e+10, b: 0.0, Ea: 0.0 cal/mol}
- equation: O + CH3 <=> H + CH2O
  rate-constant: {A: 5.06e+10, b: 0.0, Ea: 0.0 cal/mol}
- equation: O + CH4 <=> OH + CH3
  rate-constant: {A: 1.02e+06, b: 1.5, Ea: 8600.0 cal/mol}
- equation: O + CO (+ M) <=> CO2 (+ M)
  type: falloff
  high-P-rate-constant: {A: 1.8e+07, b: 0.0, Ea: 2385.0 cal/mol}
  low-P-rate-constant: {A: 6.02e+08, b: 0.0, Ea: 3000.0 cal/mol}
  efficiencies: {AR: 0.5, C2H6: 3.0, CH4: 2.0, CO: 1.5, CO2: 3.5, H2: 2.0, H2O: 
      6.0, O2: 6.0}
- equation: O + HCO <=> OH + CO
  rate-constant: {A: 3.0e+10, b: 0.0, Ea: 0.0 cal/mol}
- equation: O + HCO <=> H + CO2
  rate-constant: {A: 3.0e+10, b: 0.0, Ea: 0.0 cal/mol}
- equation: O + CH2O <=> OH + HCO
  rate-constant: {A: 3.9e+10, b: 0.0, Ea: 3540.0 cal/mol}
- equation: O + CH2OH <=> OH + CH2O
  rate-constant: {A: 1.0e+10, b: 0.0, Ea: 0.0 cal/mol}
- equation: O + CH3O <=> OH + CH2O
  rate-constant: {A: 1.0e+10, b: 0.0, Ea: 0.0 cal/mol}
- equation: O + CH3OH <=> OH + CH2OH
  rate-constant: {A: 388.0, b: 2.5, Ea: 3100.0 cal/mol}
- equation: O + CH3OH <=> OH + CH3O
  rate-constant: {A: 130.0, b: 2.5, Ea: 5000.0 cal/mol}
- equation: O + C2H <=> CH + CO
  rate-constant: {A: 5.0e+10, b: 0.0, Ea: 0.0 cal/mol}
- equation: O + C2H2 <=> H + HCCO
  rate-constant: {A: 1.35e+04, b: 2.0, Ea: 1900.0 cal/mol}
- equation: O + C2H2 <=> OH + C2H
  rate-constant: {A: 4.6e+16, b: -1.41, Ea: 2.895e+04 cal/mol}
- equation: O + C2H2 <=> CO + CH2
  rate-constant: {A: 6940.0, b: 2.0, Ea: 1900.0 cal/mol}
- equation: O + C2H3 <=> H + CH2CO
  rate-constant: {A: 3.0e+10, b: 0.0, Ea: 0.0 cal/mol}
- equation: O + C2H4 <=> CH3 + HCO
  rate-constant: {A: 1.25e+04, b: 1.83, Ea: 220.0 cal/mol}
- equation: O + C2H5 <=> CH3 + CH2O
  rate-constant: {A: 2.24e+10, b: 0.0, Ea: 0.0 cal/mol}
- equation: O + C2H6 <=> OH + C2H5
  rate-constant: {A: 8.98e+04, b: 1.92, Ea: 5690.0 cal/mol}
- equation: O + HCCO <=> H + 2 CO
  rate-constant: {A: 1.0e+11, b: 0.0, Ea: 0.0 cal/mol}
- equation: O + CH2CO <=> OH + HCCO
  rate-constant: {A: 1.0e+10, b: 0.0, Ea: 8000.0 cal/mol}
- equation: O + CH2CO <=> CH2 + CO2
  rate-constant: {A: 1.75e+09, b: 0.0, Ea: 1350.0 cal/mol}
- equation: O2 + CO <=> O + CO2
  rate-constant: {A: 2.5e+09, b: 0.0, Ea: 4.78e+04 cal/mol}
- equation: O2 + CH2O <=> HO2 + HCO
  rate-constant: {A: 1.0e+11, b: 0.0, Ea: 4.0e+04 cal/mol}
- equation: H + O2 + M <=> HO2 + M
  type: three-body
  rate-constant: {A: 2.8e+12, b: -0.86, Ea: 0.0 cal/mol}
  efficiencies: {AR: 0.0, C2H6: 1.5, CO: 0.75, CO2: 1.5, H2O: 0.0, N2: 0.0, O2: 
      0.0}
- equation: H + 2 O2 <=> HO2 + O2
  rate-constant: {A: 2.08e+13, b: -1.24, Ea: 0.0 cal/mol}
- equation: H + O2 + H2O <=> HO2 + H2O
  rate-constant: {A: 1.126e+13, b: -0.76, Ea: 0.0 cal/mol}
- equation: H + O2 + N2 <=> HO2 + N2
  rate-constant: {A: 2.6e+13, b: -1.24, Ea: 0.0 cal/mol}
- equation: H + O2 + AR <=> HO2 + AR
  rate-constant: {A: 7.0e+11, b: -0.8, Ea: 0.0 cal/mol}
- equation: H + O2 <=> O + OH
  rate-constant: {A: 2.65e+13, b: -0.6707, Ea: 1.7041e+04 cal/mol}
- equation: 2 H + M <=> H2 + M
  type: three-body
  rate-constant: {A: 1.0e+12, b: -1.0, Ea: 0.0 cal/mol}
  efficiencies: {AR: 0.63, C2H6: 3.0, CH4: 2.0, CO2: 0.0, H2: 0.0, H2O: 0.0}
- equation: 2 H + H2 <=> 2 H2
  rate-constant: {A: 9.0e+10, b: -0.6, Ea: 0.0 cal/mol}
- equation: 2 H + H2O <=> H2 + H2O
  rate-constant: {A: 6.0e+13, b: -1.25, Ea: 0.0 cal/mol}
- equation: 2 H + CO2 <=> H2 + CO2
  rate-constant: {A: 5.5e+14, b: -2.0, Ea: 0.0 cal/mol}
- equation: H + OH + M <=> H2O + M
  type: three-body
  rate-constant: {A: 2.2e+16, b: -2.0, Ea: 0.0 cal/mol}
  efficiencies: {AR: 0.38, C2H6: 3.0, CH4: 2.0, H2: 0.73, H2O: 3.65}
- equation: H + HO2 <=> O + H2O
  rate-constant: {A: 3.97e+09, b: 0.0, Ea: 671.0 cal/mol}
- equation: H + HO2 <=> O2 + H2
  rate-constant: {A: 4.48e+10, b: 0.0, Ea: 1068.0 cal/mol}
- equation: H + HO2 <=> 2 OH
  rate-constant: {A: 8.4e+10, b: 0.0, Ea: 635.0 cal/mol}
- equation: H + H2O2 <=> HO2 + H2
  rate-constant: {A: 1.21e+04, b: 2.0, Ea: 5200.0 cal/mol}
- equation: H + H2O2 <=> OH + H2O
  rate-constant: {A: 1.0e+10, b: 0.0, Ea: 3600.0 cal/mol}
- equation: H + CH <=> C + H2
  rate-constant: {A: 1.65e+11, b: 0.0, Ea: 0.0 cal/mol}
- equation: H + CH2 (+ M) <=> CH3 (+ M)
  type: falloff
  high-P-rate-constant: {A: 6.0e+11, b: 0.0, Ea: 0.0 cal/mol}
  low-P-rate-constant: {A: 1.04e+20, b: -2.76, Ea: 1600.0 cal/mol}
  efficiencies: {AR: 0.7, C2H6: 3.0, CH4: 2.0, CO: 1.5, CO2: 2.0, H2: 2.0, H2O: 
      6.0}
  Troe: {A: 0.562, T3: 91.0, T1: 5836.0, T2: 8552.0}
- equation: H + CH2(S) <=> CH + H2
  rate-constant: {A: 3.0e+10, b: 0.0, Ea: 0.0 cal/mol}
- equation: H + CH3 (+ M) <=> CH4 (+ M)
  type: falloff
  high-P-rate-constant: {A: 1.39e+13, b: -0.534, Ea: 536.0 cal/mol}
  low-P-rate-constant: {A: 2.62e+27, b: -4.76, Ea: 2440.0 cal/mol}
  efficiencies: {AR: 0.7, C2H6: 3.0, CH4: 3.0, CO: 1.5, CO2: 2.0, H2: 2.0, H2O: 
      6.0}
  Troe: {A: 0.783, T3: 74.0, T1: 2941.0, T2: 6964.0}
- equation: H + CH4 <=> CH3 + H2
  rate-constant: {A: 6.6e+05, b: 1.62, Ea: 1.084e+04 cal/mol}
- equation: H + HCO (+ M) <=> CH2O (+ M)
  type: falloff
  high-P-rate-constant: {A: 1.09e+09, b: 0.48, Ea: -260.0 cal/mol}
  low-P-rate-constant: {A: 2.47e+18, b: -2.57, Ea: 425.0 cal/mol}
  efficiencies: {AR: 0.7, C2H6: 3.0, CH4: 2.0, CO: 1.5, CO2: 2.0, H2: 2.0, H2O: 
      6.0}
  Troe: {A: 0.7824, T3: 271.0, T1: 2755.0, T2: 6570.0}
- equation: H + HCO <=> H2 + CO
  rate-constant: {A: 7.34e+10, b: 0.0, Ea: 0.0 cal/mol}
- equation: H + CH2O (+ M) <=> CH2OH (+ M)
  type: falloff
  high-P-rate-constant: {A: 5.4e+08, b: 0.454, Ea: 3600.0 cal/mol}
  low-P-rate-constant: {A: 1.27e+26, b: -4.82, Ea: 6530.0 cal/mol}
  efficiencies: {C2H6: 3.0, CH4: 2.0, CO: 1.5, CO2: 2.0, H2: 2.0, H2O: 6.0}
  Troe: {A: 0.7187, T3: 103.0, T1: 1291.0, T2: 4160.0}
- equation: H + CH2O (+ M) <=> CH3O (+ M)
  type: falloff
  high-P-rate-constant: {A: 5.4e+08, b: 0.454, Ea: 2600.0 cal/mol}
  low-P-rate-constant: {A: 2.2e+24, b: -4.8, Ea: 5560.0 cal/mol}
  efficiencies: {C2H6: 3.0, CH4: 2.0, CO: 1.5, CO2: 2.0, H2: 2.0, H2O: 6.0}
  Troe: {A: 0.758, T3: 94.0, T1: 1555.0, T2: 4200.0}
- equation: H + CH2O <=> HCO + H2
  rate-constant: {A: 5.74e+04, b: 1.9, Ea: 2742.0 cal/mol}
- equation: H + CH2OH (+ M) <=> CH3OH (+ M)
  type: falloff
  high-P-rate-constant: {A: 1.055e+09, b: 0.5, Ea: 86.0 cal/mol}
  low-P-rate-constant: {A: 4.36e+25, b: -4.65, Ea: 5080.0 cal/mol}
  efficiencies: {C2H6: 3.0, CH4: 2.0, CO: 1.5, CO2: 2.0, H2: 2.0, H2O: 6.0}
  Troe: {A: 0.6, T3: 100.0, T1: 9.0e+04, T2: 1.0e+04}
- equation: H + CH2OH <=> H2 + CH2O
  rate-constant: {A: 2.0e+10, b: 0.0, Ea: 0.0 cal/mol}
- equation: H + CH2OH <=> OH + CH3
  rate-constant: {A: 1.65e+08, b: 0.65, Ea: -284.0 cal/mol}
- equation: H + CH2OH <=> CH2(S) + H2O
  rate-constant: {A: 3.28e+10, b: -0.09, Ea: 610.0 cal/mol}
- equation: H + CH3O (+ M) <=> CH3OH (+ M)
  type: falloff
  high-P-rate-constant: {A: 2.43e+09, b: 0.515, Ea: 50.0 cal/mol}
  low-P-rate-constant: {A: 4.66e+35, b: -7.44, Ea: 1.408e+04 cal/mol}
  efficiencies: {C2H6: 3.0, CH4: 2.0, CO: 1.5, CO2: 2.0, H2: 2.0, H2O: 6.0}
  Troe: {A: 0.7, T3: 100.0, T1: 9.0e+04, T2: 1.0e+04}
- equation: H + CH3O <=> H + CH2OH
  rate-constant: {A: 4.15e+04, b: 1.63, Ea: 1924.0 cal/mol}
- equation: H + CH3O <=> H2 + CH2O
  rate-constant: {A: 2.0e+10, b: 0.0, Ea: 0.0 cal/mol}
- equation: H + CH3O <=> OH + CH3
  rate-constant: {A: 1.5e+09, b: 0.5, Ea: -110.0 cal/mol}
- equation: H + CH3O <=> CH2(S) + H2O
  rate-constant: {A: 2.62e+11, b: -0.23, Ea: 1070.0 cal/mol}
- equation: H + CH3OH <=> CH2OH + H2
  rate-constant: {A: 1.7e+04, b: 2.1, Ea: 4870.0 cal/mol}
- equation: H + CH3OH <=> CH3O + H2
  rate-constant: {A: 4200.0, b: 2.1, Ea: 4870.0 cal/mol}
- equation: H + C2H (+ M) <=> C2H2 (+ M)
  type: falloff
  high-P-rate-constant: {A: 1.0e+14, b: -1.0, Ea: 0.0 cal/mol}
  low-P-rate-constant: {A: 3.75e+27, b: -4.8, Ea: 1900.0 cal/mol}
  efficiencies: {AR: 0.7, C2H6: 3.0, CH4: 2.0, CO: 1.5, CO2: 2.0, H2: 2.0, H2O: 
      6.0}
  Troe: {A: 0.6464, T3: 132.0, T1: 1315.0, T2: 5566.0}
- equation: H + C2H2 (+ M) <=> C2H3 (+ M)
  type: falloff
  high-P-rate-constant: {A: 5.6e+09, b: 0.0, Ea: 2400.0 cal/mol}
  low-P-rate-constant: {A: 3.8e+34, b: -7.27, Ea: 7220.0 cal/mol}
  efficiencies: {AR: 0.7, C2H6: 3.0, CH4: 2.0, CO: 1.5, CO2: 2.0, H2: 2.0, H2O: 
      6.0}
  Troe: {A: 0.7507, T3: 98.5, T1: 1302.0, T2: 4167.0}
- equation: H + C2H3 (+ M) <=> C2H4 (+ M)
  type: falloff
  high-P-rate-constant: {A: 6.08e+09, b: 0.27, Ea: 280.0 cal/mol}
  low-P-rate-constant: {A: 1.4e+24, b: -3.86, Ea: 3320.0 cal/mol}
  efficiencies: {AR: 0.7, C2H6: 3.0, CH4: 2.0, CO: 1.5, CO2: 2.0, H2: 2.0, H2O: 
      6.0}
  Troe: {A: 0.782, T3: 207.5, T1: 2663.0, T2: 6095.0}
- equation: H + C2H3 <=> H2 + C2H2
  rate-constant: {A: 3.0e+10, b: 0.0, Ea: 0.0 cal/mol}
- equation: H + C2H4 (+ M) <=> C2H5 (+ M)
  type: falloff
  high-P-rate-constant: {A: 5.4e+08, b: 0.454, Ea: 1820.0 cal/mol}
  low-P-rate-constant: {A: 6.0e+35, b: -7.62, Ea: 6970.0 cal/mol}
  efficiencies: {AR: 0.7, C2H6: 3.0, CH4: 2.0, CO: 1.5, CO2: 2.0, H2: 2.0, H2O: 
      6.0}
  Troe: {A: 0.9753, T3: 210.0, T1: 984.0, T2: 4374.0}
- equation: H + C2H4 <=> C2H3 + H2
  rate-constant: {A: 1325.0, b: 2.53, Ea: 1.224e+04 cal/mol}
- equation: H + C2H5 (+ M) <=> C2H6 (+ M)
  type: falloff
  high-P-rate-constant: {A: 5.21e+14, b: -0.99, Ea: 1580.0 cal/mol}
  low-P-rate-constant: {A: 1.99e+35, b: -7.08, Ea: 6685.0 cal/mol}
  efficiencies: {AR: 0.7, C2H6: 3.0, CH4: 2.0, CO: 1.5, CO2: 2.0, H2: 2.0, H2O: 
      6.0}
  Troe: {A: 0.8422, T3: 125.0, T1: 2219.0, T2: 6882.0}
- equation: H + C2H5 <=> H2 + C2H4
  rate-constant: {A: 2.0e+09, b: 0.0, Ea: 0.0 cal/mol}
- equation: H + C2H6 <=> C2H5 + H2
  rate-constant: {A: 1.15e+05, b: 1.9, Ea: 7530.0 cal/mol}
- equation: H + HCCO <=> CH2(S) + CO
  rate-constant: {A: 1.0e+11, b: 0.0, Ea: 0.0 cal/mol}
- equation: H + CH2CO <=> HCCO + H2
  rate-constant: {A: 5.0e+10, b: 0.0, Ea: 8000.0 cal/mol}
- equation: H + CH2CO <=> CH3 + CO
  rate-constant: {A: 1.13e+10, b: 0.0, Ea: 3428.0 cal/mol}
- equation: H + HCCOH <=> H + CH2CO
  rate-constant: {A: 1.0e+10, b: 0.0, Ea: 0.0 cal/mol}
- equation: H2 + CO (+ M) <=> CH2O (+ M)
  type: falloff
  high-P-rate-constant: {A: 4.3e+04, b: 1.5, Ea: 7.96e+04 cal/mol}
  low-P-rate-constant: {A: 5.07e+21, b: -3.42, Ea: 8.435e+04 cal/mol}
  efficiencies: {AR: 0.7, C2H6: 3.0, CH4: 2.0, CO: 1.5, CO2: 2.0, H2: 2.0, H2O: 
      6.0}
  Troe: {A: 0.932, T3: 197.0, T1: 1540.0, T2: 1.03e+04}
- equation: OH + H2 <=> H + H2O
  rate-constant: {A: 2.16e+05, b: 1.51, Ea: 3430.0 cal/mol}
- equation: 2 OH (+ M) <=> H2O2 (+ M)
  type: falloff
  high-P-rate-constant: {A: 7.4e+10, b: -0.37, Ea: 0.0 cal/mol}
  low-P-rate-constant: {A: 2.3e+12, b: -0.9, Ea: -1700.0 cal/mol}
  efficiencies: {AR: 0.7, C2H6: 3.0, CH4: 2.0, CO: 1.5, CO2: 2.0, H2: 2.0, H2O: 
      6.0}
  Troe: {A: 0.7346, T3: 94.0, T1: 1756.0, T2: 5182.0}
- equation: 2 OH <=> O + H2O
  rate-constant: {A: 35.7, b: 2.4, Ea: -2110.0 cal/mol}
- equation: OH + HO2 <=> O2 + H2O
  rate-constant: {A: 1.45e+10, b: 0.0, Ea: -500.0 cal/mol}
  duplicate: true
- equation: OH + H2O2 <=> HO2 + H2O
  rate-constant: {A: 2.0e+09, b: 0.0, Ea: 427.0 cal/mol}
  duplicate: true
- equation: OH + H2O2 <=> HO2 + H2O
  rate-constant: {A: 1.7e+15, b: 0.0, Ea: 2.941e+04 cal/mol}
  duplicate: true
- equation: OH + C <=> H + CO
  rate-constant: {A: 5.0e+10, b: 0.0, Ea: 0.0 cal/mol}
- equation: OH + CH <=> H + HCO
  rate-constant: {A: 3.0e+10, b: 0.0, Ea: 0.0 cal/mol}
- equation: OH + CH2 <=> H + CH2O
  rate-constant: {A: 2.0e+10, b: 0.0, Ea: 0.0 cal/mol}
- equation: OH + CH2 <=> CH + H2O
  rate-constant: {A: 1.13e+04, b: 2.0, Ea: 3000.0 cal/mol}
- equation: OH + CH2(S) <=> H + CH2O
  rate-constant: {A: 3.0e+10, b: 0.0, Ea: 0.0 cal/mol}
- equation: OH + CH3 (+ M) <=> CH3OH (+ M)
  type: falloff
  high-P-rate-constant: {A: 2.79e+15, b: -1.43, Ea: 1330.0 cal/mol}
  low-P-rate-constant: {A: 4.0e+30, b: -5.92, Ea: 3140.0 cal/mol}
  efficiencies: {C2H6: 3.0, CH4: 2.0, CO: 1.5, CO2: 2.0, H2: 2.0, H2O: 6.0}
  Troe: {A: 0.412, T3: 195.0, T1: 5900.0, T2: 6394.0}
- equation: OH + CH3 <=> CH2 + H2O
  rate-constant: {A: 5.6e+04, b: 1.6, Ea: 5420.0 cal/mol}
- equation: OH + CH3 <=> CH2(S) + H2O
  rate-constant: {A: 6.44e+14, b: -1.34, Ea: 1417.0 cal/mol}
- equation: OH + CH4 <=> CH3 + H2O
  rate-constant: {A: 1.0e+05, b: 1.6, Ea: 3120.0 cal/mol}
- equation: OH + CO <=> H + CO2
  rate-constant: {A: 4.76e+04, b: 1.228, Ea: 70.0 cal/mol}
- equation: OH + HCO <=> H2O + CO
  rate-constant: {A: 5.0e+10, b: 0.0, Ea: 0.0 cal/mol}
- equation: OH + CH2O <=> HCO + H2O
  rate-constant: {A: 3.43e+06, b: 1.18, Ea: -447.0 cal/mol}
- equation: OH + CH2OH <=> H2O + CH2O
  rate-constant: {A: 5.0e+09, b: 0.0, Ea: 0.0 cal/mol}
- equation: OH + CH3O <=> H2O + CH2O
  rate-constant: {A: 5.0e+09, b: 0.0, Ea: 0.0 cal/mol}
- equation: OH + CH3OH <=> CH2OH + H2O
  rate-constant: {A: 1440.0, b: 2.0, Ea: -840.0 cal/mol}
- equation: OH + CH3OH <=> CH3O + H2O
  rate-constant: {A: 6300.0, b: 2.0, Ea: 1500.0 cal/mol}
- equation: OH + C2H <=> H + HCCO
  rate-constant: {A: 2.0e+10, b: 0.0, Ea: 0.0 cal/mol}
- equation: OH + C2H2 <=> H + CH2CO
  rate-constant: {A: 2.18e-07, b: 4.5, Ea: -1000.0 cal/mol}
- equation: OH + C2H2 <=> H + HCCOH
  rate-constant: {A: 504.0, b: 2.3, Ea: 1.35e+04 cal/mol}
- equation: OH + C2H2 <=> C2H + H2O
  rate-constant: {A: 3.37e+04, b: 2.0, Ea: 1.4e+04 cal/mol}
- equation: OH + C2H2 <=> CH3 + CO
  rate-constant: {A: 4.83e-07, b: 4.0, Ea: -2000.0 cal/mol}
- equation: OH + C2H3 <=> H2O + C2H2
  rate-constant: {A: 5.0e+09, b: 0.0, Ea: 0.0 cal/mol}
- equation: OH + C2H4 <=> C2H3 + H2O
  rate-constant: {A: 3600.0, b: 2.0, Ea: 2500.0 cal/mol}
- equation: OH + C2H6 <=> C2H5 + H2O
  rate-constant: {A: 3540.0, b: 2.12, Ea: 870.0 cal/mol}
- equation: OH + CH2CO <=> HCCO + H2O
  rate-constant: {A: 7.5e+09, b: 0.0, Ea: 2000.0 cal/mol}
- equation: 2 HO2 <=> O2 + H2O2
  rate-constant: {A: 1.3e+08, b: 0.0, Ea: -1630.0 cal/mol}
  duplicate: true
- equation: 2 HO2 <=> O2 + H2O2
  rate-constant: {A: 4.2e+11, b: 0.0, Ea: 1.2e+04 cal/mol}
  duplicate: true
- equation: HO2 + CH2 <=> OH + CH2O
  rate-constant: {A: 2.0e+10, b: 0.0, Ea: 0.0 cal/mol}
- equation: HO2 + CH3 <=> O2 + CH4
  rate-constant: {A: 1.0e+09, b: 0.0, Ea: 0.0 cal/mol}
- equation: HO2 + CH3 <=> OH + CH3O
  rate-constant: {A: 3.78e+10, b: 0.0, Ea: 0.0 cal/mol}
- equation: HO2 + CO <=> OH + CO2
  rate-constant: {A: 1.5e+11, b: 0.0, Ea: 2.36e+04 cal/mol}
- equation: HO2 + CH2O <=> HCO + H2O2
  rate-constant: {A: 5600.0, b: 2.0, Ea: 1.2e+04 cal/mol}
- equation: C + O2 <=> O + CO
  rate-constant: {A: 5.8e+10, b: 0.0, Ea: 576.0 cal/mol}
- equation: C + CH2 <=> H + C2H
  rate-constant: {A: 5.0e+10, b: 0.0, Ea: 0.0 cal/mol}
- equation: C + CH3 <=> H + C2H2
  rate-constant: {A: 5.0e+10, b: 0.0, Ea: 0.0 cal/mol}
- equation: CH + O2 <=> O + HCO
  rate-constant: {A: 6.71e+10, b: 0.0, Ea: 0.0 cal/mol}
- equation: CH + H2 <=> H + CH2
  rate-constant: {A: 1.08e+11, b: 0.0, Ea: 3110.0 cal/mol}
- equation: CH + H2O <=> H + CH2O
  rate-constant: {A: 5.71e+09, b: 0.0, Ea: -755.0 cal/mol}
- equation: CH + CH2 <=> H + C2H2
  rate-constant: {A: 4.0e+10, b: 0.0, Ea: 0.0 cal/mol}
- equation: CH + CH3 <=> H + C2H3
  rate-constant: {A: 3.0e+10, b: 0.0, Ea: 0.0 cal/mol}
- equation: CH + CH4 <=> H + C2H4
  rate-constant: {A: 6.0e+10, b: 0.0, Ea: 0.0 cal/mol}
- equation: CH + CO (+ M) <=> HCCO (+ M)
  type: falloff
  high-P-rate-constant: {A: 5.0e+10, b: 0.0, Ea: 0.0 cal/mol}
  low-P-rate-constant: {A: 2.69e+22, b: -3.74, Ea: 1936.0 cal/mol}
  efficiencies: {AR: 0.7, C2H6: 3.0, CH4: 2.0, CO: 1.5, CO2: 2.0, H2: 2.0, H2O: 
      6.0}
  Troe: {A: 0.5757, T3: 237.0, T1: 1652.0, T2: 5069.0}
- equation: CH + CO2 <=> HCO + CO
  rate-constant: {A: 1.9e+11, b: 0.0, Ea: 1.5792e+04 cal/mol}
- equation: CH + CH2O <=> H + CH2CO
  rate-constant: {A: 9.46e+10, b: 0.0, Ea: -515.0 cal/mol}
- equation: CH + HCCO <=> CO + C2H2
  rate-constant: {A: 5.0e+10, b: 0.0, Ea: 0.0 cal/mol}
- equation: CH2 + O2 => OH + H + CO
  rate-constant: {A: 5.0e+09, b: 0.0, Ea: 1500.0 cal/mol}
- equation: CH2 + H2 <=> H + CH3
  rate-constant: {A: 500.0, b: 2.0, Ea: 7230.0 cal/mol}
- equation: 2 CH2 <=> H2 + C2H2
  rate-constant: {A: 1.6e+12, b: 0.0, Ea: 1.1944e+04 cal/mol}
- equation: CH2 + CH3 <=> H + C2H4
  rate-constant: {A: 4.0e+10, b: 0.0, Ea: 0.0 cal/mol}
- equation: CH2 + CH4 <=> 2 CH3
  rate-constant: {A: 2460.0, b: 2.0, Ea: 8270.0 cal/mol}
- equation: CH2 + CO (+ M) <=> CH2CO (+ M)
  type: falloff
  high-P-rate-constant: {A: 8.1e+08, b: 0.5, Ea: 4510.0 cal/mol}
  low-P-rate-constant: {A: 2.69e+27, b: -5.11, Ea: 7095.0 cal/mol}
  efficiencies: {AR: 0.7, C2H6: 3.0, CH4: 2.0, CO: 1.5, CO2: 2.0, H2: 2.0, H2O: 
      6.0}
  Troe: {A: 0.5907, T3: 275.0, T1: 1226.0, T2: 5185.0}
- equation: CH2 + HCCO <=> C2H3 + CO
  rate-constant: {A: 3.0e+10, b: 0.0, Ea: 0.0 cal/mol}
- equation: CH2(S) + N2 <=> CH2 + N2
  rate-constant: {A: 1.5e+10, b: 0.0, Ea: 600.0 cal/mol}
- equation: CH2(S) + AR <=> CH2 + AR
  rate-constant: {A: 9.0e+09, b: 0.0, Ea: 600.0 cal/mol}
- equation: CH2(S) + O2 <=> H + OH + CO
  rate-constant: {A: 2.8e+10, b: 0.0, Ea: 0.0 cal/mol}
- equation: CH2(S) + O2 <=> CO + H2O
  rate-constant: {A: 1.2e+10, b: 0.0, Ea: 0.0 cal/mol}
- equation: CH2(S) + H2 <=> CH3 + H
  rate-constant: {A: 7.0e+10, b: 0.0, Ea: 0.0 cal/mol}
- equation: CH2(S) + H2O (+ M) <=> CH3OH (+ M)
  type: falloff
  high-P-rate-constant: {A: 4.82e+14, b: -1.16, Ea: 1145.0 cal/mol}
  low-P-rate-constant: {A: 1.88e+32, b: -6.36, Ea: 5040.0 cal/mol}
  efficiencies: {C2H6: 3.0, CH4: 2.0, CO: 1.5, CO2: 2.0, H2: 2.0, H2O: 6.0}
  Troe: {A: 0.6027, T3: 208.0, T1: 3922.0, T2: 1.018e+04}
- equation: CH2(S) + H2O <=> CH2 + H2O
  rate-constant: {A: 3.0e+10, b: 0.0, Ea: 0.0 cal/mol}
- equation: CH2(S) + CH3 <=> H + C2H4
  rate-constant: {A: 1.2e+10, b: 0.0, Ea: -570.0 cal/mol}
- equation: CH2(S) + CH4 <=> 2 CH3
  rate-constant: {A: 1.6e+10, b: 0.0, Ea: -570.0 cal/mol}
- equation: CH2(S) + CO <=> CH2 + CO
  rate-constant: {A: 9.0e+09, b: 0.0, Ea: 0.0 cal/mol}
- equation: CH2(S) + CO2 <=> CH2 + CO2
  rate-constant: {A: 7.0e+09, b: 0.0, Ea: 0.0 cal/mol}
- equation: CH2(S) + CO2 <=> CO + CH2O
  rate-constant: {A: 1.4e+10, b: 0.0, Ea: 0.0 cal/mol}
- equation: CH2(S) + C2H6 <=> CH3 + C2H5
  rate-constant: {A: 4.0e+10, b: 0.0, Ea: -550.0 cal/mol}
- equation: CH3 + O2 <=> O + CH3O
  rate-constant: {A: 3.56e+10, b: 0.0, Ea: 3.048e+04 cal/mol}
- equation: CH3 + O2 <=> OH + CH2O
  rate-constant: {A: 2.31e+09, b: 0.0, Ea: 2.0315e+04 cal/mol}
- equation: CH3 + H2O2 <=> HO2 + CH4
  rate-constant: {A: 24.5, b: 2.47, Ea: 5180.0 cal/mol}
- equation: 2 CH3 (+ M) <=> C2H6 (+ M)
  type: falloff
  high-P-rate-constant: {A: 6.77e+13, b: -1.18, Ea: 654.0 cal/mol}
  low-P-rate-constant: {A: 3.4e+35, b: -7.03, Ea: 2762.0 cal/mol}
  efficiencies: {AR: 0.7, C2H6: 3.0, CH4: 2.0, CO: 1.5, CO2: 2.0, H2: 2.0, H2O: 
      6.0}
  Troe: {A: 0.619, T3: 73.2, T1: 1180.0, T2: 9999.0}
- equation: 2 CH3 <=> H + C2H5
  rate-constant: {A: 6.84e+09, b: 0.1, Ea: 1.06e+04 cal/mol}
- equation: CH3 + HCO <=> CH4 + CO
  rate-constant: {A: 2.648e+10, b: 0.0, Ea: 0.0 cal/mol}
- equation: CH3 + CH2O <=> HCO + CH4
  rate-constant: {A: 3.32, b: 2.81, Ea: 5860.0 cal/mol}
- equation: CH3 + CH3OH <=> CH2OH + CH4
  rate-constant: {A: 3.0e+04, b: 1.5, Ea: 9940.0 cal/mol}
- equation: CH3 + CH3OH <=> CH3O + CH4
  rate-constant: {A: 1.0e+04, b: 1.5, Ea: 9940.0 cal/mol}
- equation: CH3 + C2H4 <=> C2H3 + CH4
  rate-constant: {A: 227.0, b: 2.0, Ea: 9200.0 cal/mol}
- equation: CH3 + C2H6 <=> C2H5 + CH4
  rate-constant: {A: 6140.0, b: 1.74, Ea: 1.045e+04 cal/mol}
- equation: HCO + H2O <=> H + CO + H2O
  rate-constant: {A: 1.5e+15, b: -1.0, Ea: 1.7e+04 cal/mol}
- equation: HCO + M <=> H + CO + M
  type: three-body
  rate-constant: {A: 1.87e+14, b: -1.0, Ea: 1.7e+04 cal/mol}
  efficiencies: {C2H6: 3.0, CH4: 2.0, CO: 1.5, CO2: 2.0, H2: 2.0, H2O: 0.0}
- equation: HCO + O2 <=> HO2 + CO
  rate-constant: {A: 1.345e+10, b: 0.0, Ea: 400.0 cal/mol}
- equation: CH2OH + O2 <=> HO2 + CH2O
  rate-constant: {A: 1.8e+10, b: 0.0, Ea: 900.0 cal/mol}
- equation: CH3O + O2 <=> HO2 + CH2O
  rate-constant: {A: 4.28e-16, b: 7.6, Ea: -3530.0 cal/mol}
- equation: C2H + O2 <=> HCO + CO
  rate-constant: {A: 1.0e+10, b: 0.0, Ea: -755.0 cal/mol}
- equation: C2H + H2 <=> H + C2H2
  rate-constant: {A: 5.68e+07, b: 0.9, Ea: 1993.0 cal/mol}
- equation: C2H3 + O2 <=> HCO + CH2O
  rate-constant: {A: 4.58e+13, b: -1.39, Ea: 1015.0 cal/mol}
- equation: C2H4 (+ M) <=> H2 + C2H2 (+ M)
  type: falloff
  high-P-rate-constant: {A: 8.0e+12, b: 0.44, Ea: 8.677e+04 cal/mol}
  low-P-rate-constant: {A: 1.58e+48, b: -9.3, Ea: 9.78e+04 cal/mol}
  efficiencies: {AR: 0.7, C2H6: 3.0, CH4: 2.0, CO: 1.5, CO2: 2.0, H2: 2.0, H2O: 
      6.0}
  Troe: {A: 0.7345, T3: 180.0, T1: 1035.0, T2: 5417.0}
- equation: C2H5 + O2 <=> HO2 + C2H4
  rate-constant: {A: 8.4e+08, b: 0.0, Ea: 3875.0 cal/mol}
- equation: HCCO + O2 <=> OH + 2 CO
  rate-constant: {A: 3.2e+09, b: 0.0, Ea: 854.0 cal/mol}
- equation: 2 HCCO <=> 2 CO + C2H2
  rate-constant: {A: 1.0e+10, b: 0.0, Ea: 0.0 cal/mol}
- equation: N + NO <=> N2 + O
  rate-constant: {A: 2.7e+10, b: 0.0, Ea: 355.0 cal/mol}
- equation: N + O2 <=> NO + O
  rate-constant: {A: 9.0e+06, b: 1.0, Ea: 6500.0 cal/mol}
- equation: N + OH <=> NO + H
  rate-constant: {A: 3.36e+10, b: 0.0, Ea: 385.0 cal/mol}
- equation: N2O + O <=> N2 + O2
  rate-constant: {A: 1.4e+09, b: 0.0, Ea: 1.081e+04 cal/mol}
- equation: N2O + O <=> 2 NO
  rate-constant: {A: 2.9e+10, b: 0.0, Ea: 2.315e+04 cal/mol}
- equation: N2O + H <=> N2 + OH
  rate-constant: {A: 3.87e+11, b: 0.0, Ea: 1.888e+04 cal/mol}
- equation: N2O + OH <=> N2 + HO2
  rate-constant: {A: 2.0e+09, b: 0.0, Ea: 2.106e+04 cal/mol}
- equation: N2O (+ M) <=> N2 + O (+ M)
  type: falloff
  high-P-rate-constant: {A: 7.91e+10, b: 0.0, Ea: 5.602e+04 cal/mol}
  low-P-rate-constant: {A: 6.37e+11, b: 0.0, Ea: 5.664e+04 cal/mol}
  efficiencies: {AR: 0.625, C2H6: 3.0, CH4: 2.0, CO: 1.5, CO2: 2.0, H2: 2.0, H2O: 
      6.0}
- equation: HO2 + NO <=> NO2 + OH
  rate-constant: {A: 2.11e+09, b: 0.0, Ea: -480.0 cal/mol}
- equation: NO + O + M <=> NO2 + M
  type: three-body
  rate-constant: {A: 1.06e+14, b: -1.41, Ea: 0.0 cal/mol}
  efficiencies: {AR: 0.7, C2H6: 3.0, CH4: 2.0, CO: 1.5, CO2: 2.0, H2: 2.0, H2O: 
      6.0}
- equation: NO2 + O <=> NO + O2
  rate-constant: {A: 3.9e+09, b: 0.0, Ea: -240.0 cal/mol}
- equation: NO2 + H <=> NO + OH
  rate-constant: {A: 1.32e+11, b: 0.0, Ea: 360.0 cal/mol}
- equation: NH + O <=> NO + H
  rate-constant: {A: 4.0e+10, b: 0.0, Ea: 0.0 cal/mol}
- equation: NH + H <=> N + H2
  rate-constant: {A: 3.2e+10, b: 0.0, Ea: 330.0 cal/mol}
- equation: NH + OH <=> HNO + H
  rate-constant: {A: 2.0e+10, b: 0.0, Ea: 0.0 cal/mol}
- equation: NH + OH <=> N + H2O
  rate-constant: {A: 2.0e+06, b: 1.2, Ea: 0.0 cal/mol}
- equation: NH + O2 <=> HNO + O
  rate-constant: {A: 461.0, b: 2.0, Ea: 6500.0 cal/mol}
- equation: NH + O2 <=> NO + OH
  rate-constant: {A: 1280.0, b: 1.5, Ea: 100.0 cal/mol}
- equation: NH + N <=> N2 + H
  rate-constant: {A: 1.5e+10, b: 0.0, Ea: 0.0 cal/mol}
- equation: NH + H2O <=> HNO + H2
  rate-constant: {A: 2.0e+10, b: 0.0, Ea: 1.385e+04 cal/mol}
- equation: NH + NO <=> N2 + OH
  rate-constant: {A: 2.16e+10, b: -0.23, Ea: 0.0 cal/mol}
- equation: NH + NO <=> N2O + H
  rate-constant: {A: 3.65e+11, b: -0.45, Ea: 0.0 cal/mol}
- equation: NH2 + O <=> OH + NH
  rate-constant: {A: 3.0e+09, b: 0.0, Ea: 0.0 cal/mol}
- equation: NH2 + O <=> H + HNO
  rate-constant: {A: 3.9e+10, b: 0.0, Ea: 0.0 cal/mol}
- equation: NH2 + H <=> NH + H2
  rate-constant: {A: 4.0e+10, b: 0.0, Ea: 3650.0 cal/mol}
- equation: NH2 + OH <=> NH + H2O
  rate-constant: {A: 9.0e+04, b: 1.5, Ea: -460.0 cal/mol}
- equation: NNH <=> N2 + H
  rate-constant: {A: 3.3e+08, b: 0.0, Ea: 0.0 cal/mol}
- equation: NNH + M <=> N2 + H + M
  type: three-body
  rate-constant: {A: 1.3e+11, b: -0.11, Ea: 4980.0 cal/mol}
  efficiencies: {AR: 0.7, C2H6: 3.0, CH4: 2.0, CO: 1.5, CO2: 2.0, H2: 2.0, H2O: 
      6.0}
- equation: NNH + O2 <=> HO2 + N2
  rate-constant: {A: 5.0e+09, b: 0.0, Ea: 0.0 cal/mol}
- equation: NNH + O <=> OH + N2
  rate-constant: {A: 2.5e+10, b: 0.0, Ea: 0.0 cal/mol}
- equation: NNH + O <=> NH + NO
  rate-constant: {A: 7.0e+10, b: 0.0, Ea: 0.0 cal/mol}
- equation: NNH + H <=> H2 + N2
  rate-constant: {A: 5.0e+10, b: 0.0, Ea: 0.0 cal/mol}
- equation: NNH + OH <=> H2O + N2
  rate-constant: {A: 2.0e+10, b: 0.0, Ea: 0.0 cal/mol}
- equation: NNH + CH3 <=> CH4 + N2
  rate-constant: {A: 2.5e+10, b: 0.0, Ea: 0.0 cal/mol}
- equation: H + NO + M <=> HNO + M
  type: three-body
  rate-constant: {A: 4.48e+13, b: -1.32, Ea: 740.0 cal/mol}
  efficiencies: {AR: 0.7, C2H6: 3.0, CH4: 2.0, CO: 1.5, CO2: 2.0, H2: 2.0, H2O: 
      6.0}
- equation: HNO + O <=> NO + OH
  rate-constant: {A: 2.5e+10, b: 0.0, Ea: 0.0 cal/mol}
- equation: HNO + H <=> H2 + NO
  rate-constant: {A: 9.0e+08, b: 0.72, Ea: 660.0 cal/mol}
- equation: HNO + OH <=> NO + H2O
  rate-constant: {A: 1.3e+04, b: 1.9, Ea: -950.0 cal/mol}
- equation: HNO + O2 <=> HO2 + NO
  rate-constant: {A: 1.0e+10, b: 0.0, Ea: 1.3e+04 cal/mol}
- equation: CN + O <=> CO + N
  rate-constant: {A: 7.7e+10, b: 0.0, Ea: 0.0 cal/mol}
- equation: CN + OH <=> NCO + H
  rate-constant: {A: 4.0e+10, b: 0.0, Ea: 0.0 cal/mol}
- equation: CN + H2O <=> HCN + OH
  rate-constant: {A: 8.0e+09, b: 0.0, Ea: 7460.0 cal/mol}
- equation: CN + O2 <=> NCO + O
  rate-constant: {A: 6.14e+09, b: 0.0, Ea: -440.0 cal/mol}
- equation: CN + H2 <=> HCN + H
  rate-constant: {A: 295.0, b: 2.45, Ea: 2240.0 cal/mol}
- equation: NCO + O <=> NO + CO
  rate-constant: {A: 2.35e+10, b: 0.0, Ea: 0.0 cal/mol}
- equation: NCO + H <=> NH + CO
  rate-constant: {A: 5.4e+10, b: 0.0, Ea: 0.0 cal/mol}
- equation: NCO + OH <=> NO + H + CO
  rate-constant: {A: 2.5e+09, b: 0.0, Ea: 0.0 cal/mol}
- equation: NCO + N <=> N2 + CO
  rate-constant: {A: 2.0e+10, b: 0.0, Ea: 0.0 cal/mol}
- equation: NCO + O2 <=> NO + CO2
  rate-constant: {A: 2.0e+09, b: 0.0, Ea: 2.0e+04 cal/mol}
- equation: NCO + M <=> N + CO + M
  type: three-body
  rate-constant: {A: 3.1e+11, b: 0.0, Ea: 5.405e+04 cal/mol}
  efficiencies: {AR: 0.7, C2H6: 3.0, CH4: 2.0, CO: 1.5, CO2: 2.0, H2: 2.0, H2O: 
      6.0}
- equation: NCO + NO <=> N2O + CO
  rate-constant: {A: 1.9e+14, b: -1.52, Ea: 740.0 cal/mol}
- equation: NCO + NO <=> N2 + CO2
  rate-constant: {A: 3.8e+15, b: -2.0, Ea: 800.0 cal/mol}
- equation: HCN + M <=> H + CN + M
  type: three-body
  rate-constant: {A: 1.04e+26, b: -3.3, Ea: 1.266e+05 cal/mol}
  efficiencies: {AR: 0.7, C2H6: 3.0, CH4: 2.0, CO: 1.5, CO2: 2.0, H2: 2.0, H2O: 
      6.0}
- equation: HCN + O <=> NCO + H
  rate-constant: {A: 20.3, b: 2.64, Ea: 4980.0 cal/mol}
- equation: HCN + O <=> NH + CO
  rate-constant: {A: 5.07, b: 2.64, Ea: 4980.0 cal/mol}
- equation: HCN + O <=> CN + OH
  rate-constant: {A: 3.91e+06, b: 1.58, Ea: 2.66e+04 cal/mol}
- equation: HCN + OH <=> HOCN + H
  rate-constant: {A: 1100.0, b: 2.03, Ea: 1.337e+04 cal/mol}
- equation: HCN + OH <=> HNCO + H
  rate-constant: {A: 4.4, b: 2.26, Ea: 6400.0 cal/mol}
- equation: HCN + OH <=> NH2 + CO
  rate-constant: {A: 0.16, b: 2.56, Ea: 9000.0 cal/mol}
- equation: H + HCN (+ M) <=> H2CN (+ M)
  type: falloff
  high-P-rate-constant: {A: 3.3e+10, b: 0.0, Ea: 0.0 cal/mol}
  low-P-rate-constant: {A: 1.4e+20, b: -3.4, Ea: 1900.0 cal/mol}
  efficiencies: {AR: 0.7, C2H6: 3.0, CH4: 2.0, CO: 1.5, CO2: 2.0, H2: 2.0, H2O: 
      6.0}
- equation: H2CN + N <=> N2 + CH2
  rate-constant: {A: 6.0e+10, b: 0.0, Ea: 400.0 cal/mol}
- equation: C + N2 <=> CN + N
  rate-constant: {A: 6.3e+10, b: 0.0, Ea: 4.602e+04 cal/mol}
- equation: CH + N2 <=> HCN + N
  rate-constant: {A: 3.12e+06, b: 0.88, Ea: 2.013e+04 cal/mol}
- equation: CH + N2 (+ M) <=> HCNN (+ M)
  type: falloff
  high-P-rate-constant: {A: 3.1e+09, b: 0.15, Ea: 0.0 cal/mol}
  low-P-rate-constant: {A: 1.3e+19, b: -3.16, Ea: 740.0 cal/mol}
  efficiencies: {AR: 1.0, C2H6: 3.0, CH4: 2.0, CO: 1.5, CO2: 2.0, H2: 2.0, H2O: 
      6.0}
  Troe: {A: 0.667, T3: 235.0, T1: 2117.0, T2: 4536.0}
- equation: CH2 + N2 <=> HCN + NH
  rate-constant: {A: 1.0e+10, b: 0.0, Ea: 7.4e+04 cal/mol}
- equation: CH2(S) + N2 <=> NH + HCN
  rate-constant: {A: 1.0e+08, b: 0.0, Ea: 6.5e+04 cal/mol}
- equation: C + NO <=> CN + O
  rate-constant: {A: 1.9e+10, b: 0.0, Ea: 0.0 cal/mol}
- equation: C + NO <=> CO + N
  rate-constant: {A: 2.9e+10, b: 0.0, Ea: 0.0 cal/mol}
- equation: CH + NO <=> HCN + O
  rate-constant: {A: 4.1e+10, b: 0.0, Ea: 0.0 cal/mol}
- equation: CH + NO <=> H + NCO
  rate-constant: {A: 1.62e+10, b: 0.0, Ea: 0.0 cal/mol}
- equation: CH + NO <=> N + HCO
  rate-constant: {A: 2.46e+10, b: 0.0, Ea: 0.0 cal/mol}
- equation: CH2 + NO <=> H + HNCO
  rate-constant: {A: 3.1e+14, b: -1.38, Ea: 1270.0 cal/mol}
- equation: CH2 + NO <=> OH + HCN
  rate-constant: {A: 2.9e+11, b: -0.69, Ea: 760.0 cal/mol}
- equation: CH2 + NO <=> H + HCNO
  rate-constant: {A: 3.8e+10, b: -0.36, Ea: 580.0 cal/mol}
- equation: CH2(S) + NO <=> H + HNCO
  rate-constant: {A: 3.1e+14, b: -1.38, Ea: 1270.0 cal/mol}
- equation: CH2(S) + NO <=> OH + HCN
  rate-constant: {A: 2.9e+11, b: -0.69, Ea: 760.0 cal/mol}
- equation: CH2(S) + NO <=> H + HCNO
  rate-constant: {A: 3.8e+10, b: -0.36, Ea: 580.0 cal/mol}
- equation: CH3 + NO <=> HCN + H2O
  rate-constant: {A: 9.6e+10, b: 0.0, Ea: 2.88e+04 cal/mol}
- equation: CH3 + NO <=> H2CN + OH
  rate-constant: {A: 1.0e+09, b: 0.0, Ea: 2.175e+04 cal/mol}
- equation: HCNN + O <=> CO + H + N2
  rate-constant: {A: 2.2e+10, b: 0.0, Ea: 0.0 cal/mol}
- equation: HCNN + O <=> HCN + NO
  rate-constant: {A: 2.0e+09, b: 0.0, Ea: 0.0 cal/mol}
- equation: HCNN + O2 <=> O + HCO + N2
  rate-constant: {A: 1.2e+10, b: 0.0, Ea: 0.0 cal/mol}
- equation: HCNN + OH <=> H + HCO + N2
  rate-constant: {A: 1.2e+10, b: 0.0, Ea: 0.0 cal/mol}
- equation: HCNN + H <=> CH2 + N2
  rate-constant: {A: 1.0e+11, b: 0.0, Ea: 0.0 cal/mol}
- equation: HNCO + O <=> NH + CO2
  rate-constant: {A: 9.8e+04, b: 1.41, Ea: 8500.0 cal/mol}
- equation: HNCO + O <=> HNO + CO
  rate-constant: {A: 1.5e+05, b: 1.57, Ea: 4.4e+04 cal/mol}
- equation: HNCO + O <=> NCO + OH
  rate-constant: {A: 2200.0, b: 2.11, Ea: 1.14e+04 cal/mol}
- equation: HNCO + H <=> NH2 + CO
  rate-constant: {A: 2.25e+04, b: 1.7, Ea: 3800.0 cal/mol}
- equation: HNCO + H <=> H2 + NCO
  rate-constant: {A: 105.0, b: 2.5, Ea: 1.33e+04 cal/mol}
- equation: HNCO + OH <=> NCO + H2O
  rate-constant: {A: 3.3e+04, b: 1.5, Ea: 3600.0 cal/mol}
- equation: HNCO + OH <=> NH2 + CO2
  rate-constant: {A: 3300.0, b: 1.5, Ea: 3600.0 cal/mol}
- equation: HNCO + M <=> NH + CO + M
  type: three-body
  rate-constant: {A: 1.18e+13, b: 0.0, Ea: 8.472e+04 cal/mol}
  efficiencies: {AR: 0.7, C2H6: 3.0, CH4: 2.0, CO: 1.5, CO2: 2.0, H2: 2.0, H2O: 
      6.0}
- equation: HCNO + H <=> H + HNCO
  rate-constant: {A: 2.1e+12, b: -0.69, Ea: 2850.0 cal/mol}
- equation: HCNO + H <=> OH + HCN
  rate-constant: {A: 2.7e+08, b: 0.18, Ea: 2120.0 cal/mol}
- equation: HCNO + H <=> NH2 + CO
  rate-constant: {A: 1.7e+11, b: -0.75, Ea: 2890.0 cal/mol}
- equation: HOCN + H <=> H + HNCO
  rate-constant: {A: 2.0e+04, b: 2.0, Ea: 2000.0 cal/mol}
- equation: HCCO + NO <=> HCNO + CO
  rate-constant: {A: 9.0e+09, b: 0.0, Ea: 0.0 cal/mol}
- equation: CH3 + N <=> H2CN + H
  rate-constant: {A: 6.1e+11, b: -0.31, Ea: 290.0 cal/mol}
- equation: CH3 + N <=> HCN + H2
  rate-constant: {A: 3.7e+09, b: 0.15, Ea: -90.0 cal/mol}
- equation: NH3 + H <=> NH2 + H2
  rate-constant: {A: 540.0, b: 2.4, Ea: 9915.0 cal/mol}
- equation: NH3 + OH <=> NH2 + H2O
  rate-constant: {A: 5.0e+04, b: 1.6, Ea: 955.0 cal/mol}
- equation: NH3 + O <=> NH2 + OH
  rate-constant: {A: 9400.0, b: 1.94, Ea: 6460.0 cal/mol}
- equation: NH + CO2 <=> HNO + CO
  rate-constant: {A: 1.0e+10, b: 0.0, Ea: 1.435e+04 cal/mol}
- equation: CN + NO2 <=> NCO + NO
  rate-constant: {A: 6.16e+12, b: -0.752, Ea: 345.0 cal/mol}
- equation: NCO + NO2 <=> N2O + CO2
  rate-constant: {A: 3.25e+09, b: 0.0, Ea: -705.0 cal/mol}
- equation: N + CO2 <=> NO + CO
  rate-constant: {A: 3.0e+09, b: 0.0, Ea: 1.13e+04 cal/mol}
- equation: O + CH3 => H + H2 + CO
  rate-constant: {A: 3.37e+10, b: 0.0, Ea: 0.0 cal/mol}
- equation: O + C2H4 <=> H + CH2CHO
  rate-constant: {A: 6700.0, b: 1.83, Ea: 220.0 cal/mol}
- equation: O + C2H5 <=> H + CH3CHO
  rate-constant: {A: 1.096e+11, b: 0.0, Ea: 0.0 cal/mol}
- equation: OH + HO2 <=> O2 + H2O
  rate-constant: {A: 5.0e+12, b: 0.0, Ea: 1.733e+04 cal/mol}
  duplicate: true
- equation: OH + CH3 => H2 + CH2O
  rate-constant: {A: 8.0e+06, b: 0.5, Ea: -1755.0 cal/mol}
- equation: CH + H2 (+ M) <=> CH3 (+ M)
  type: falloff
  high-P-rate-constant: {A: 1.97e+09, b: 0.43, Ea: -370.0 cal/mol}
  low-P-rate-constant: {A: 4.82e+19, b: -2.8, Ea: 590.0 cal/mol}
  efficiencies: {AR: 0.7, C2H6: 3.0, CH4: 2.0, CO: 1.5, CO2: 2.0, H2: 2.0, H2O: 
      6.0}
  Troe: {A: 0.578, T3: 122.0, T1: 2535.0, T2: 9365.0}
- equation: CH2 + O2 => 2 H + CO2
  rate-constant: {A: 5.8e+09, b: 0.0, Ea: 1500.0 cal/mol}
- equation: CH2 + O2 <=> O + CH2O
  rate-constant: {A: 2.4e+09, b: 0.0, Ea: 1500.0 cal/mol}
- equation: CH2 + CH2 => 2 H + C2H2
  rate-constant: {A: 2.0e+11, b: 0.0, Ea: 1.0989e+04 cal/mol}
- equation: CH2(S) + H2O => H2 + CH2O
  rate-constant: {A: 6.82e+07, b: 0.25, Ea: -935.0 cal/mol}
- equation: C2H3 + O2 <=> O + CH2CHO
  rate-constant: {A: 3.03e+08, b: 0.29, Ea: 11.0 cal/mol}
- equation: C2H3 + O2 <=> HO2 + C2H2
  rate-constant: {A: 1337.0, b: 1.61, Ea: -384.0 cal/mol}
- equation: O + CH3CHO <=> OH + CH2CHO
  rate-constant: {A: 2.92e+09, b: 0.0, Ea: 1808.0 cal/mol}
- equation: O + CH3CHO => OH + CH3 + CO
  rate-constant: {A: 2.92e+09, b: 0.0, Ea: 1808.0 cal/mol}
- equation: O2 + CH3CHO => HO2 + CH3 + CO
  rate-constant: {A: 3.01e+10, b: 0.0, Ea: 3.915e+04 cal/mol}
- equation: H + CH3CHO <=> CH2CHO + H2
  rate-constant: {A: 2.05e+06, b: 1.16, Ea: 2405.0 cal/mol}
- equation: H + CH3CHO => CH3 + H2 + CO
  rate-constant: {A: 2.05e+06, b: 1.16, Ea: 2405.0 cal/mol}
- equation: OH + CH3CHO => CH3 + H2O + CO
  rate-constant: {A: 2.343e+07, b: 0.73, Ea: -1113.0 cal/mol}
- equation: HO2 + CH3CHO => CH3 + H2O2 + CO
  rate-constant: {A: 3.01e+09, b: 0.0, Ea: 1.1923e+04 cal/mol}
- equation: CH3 + CH3CHO => CH3 + CH4 + CO
  rate-constant: {A: 2720.0, b: 1.77, Ea: 5920.0 cal/mol}
- equation: H + CH2CO (+ M) <=> CH2CHO (+ M)
  type: falloff
  high-P-rate-constant: {A: 4.865e+08, b: 0.422, Ea: -1755.0 cal/mol}
  low-P-rate-constant: {A: 1.012e+36, b: -7.63, Ea: 3854.0 cal/mol}
  efficiencies: {AR: 0.7, C2H6: 3.0, CH4: 2.0, CO: 1.5, CO2: 2.0, H2: 2.0, H2O: 
      6.0}
  Troe: {A: 0.465, T3: 201.0, T1: 1773.0, T2: 5333.0}
- equation: O + CH2CHO => H + CH2 + CO2
  rate-constant: {A: 1.5e+11, b: 0.0, Ea: 0.0 cal/mol}
- equation: O2 + CH2CHO => OH + CO + CH2O
  rate-constant: {A: 1.81e+07, b: 0.0, Ea: 0.0 cal/mol}
- equation: O2 + CH2CHO => OH + 2 HCO
  rate-constant: {A: 2.35e+07, b: 0.0, Ea: 0.0 cal/mol}
- equation: H + CH2CHO <=> CH3 + HCO
  rate-constant: {A: 2.2e+10, b: 0.0, Ea: 0.0 cal/mol}
- equation: H + CH2CHO <=> CH2CO + H2
  rate-constant: {A: 1.1e+10, b: 0.0, Ea: 0.0 cal/mol}
- equation: OH + CH2CHO <=> H2O + CH2CO
  rate-constant: {A: 1.2e+10, b: 0.0, Ea: 0.0 cal/mol}
- equation: OH + CH2CHO <=> HCO + CH2OH
  rate-constant: {A: 3.01e+10, b: 0.0, Ea: 0.0 cal/mol}
- equation: CH3 + C2H5 (+ M) <=> C3H8 (+ M)
  type: falloff
  high-P-rate-constant: {A: 9.43e+09, b: 0.0, Ea: 0.0 cal/mol}
  low-P-rate-constant: {A: 2.71e+68, b: -16.82, Ea: 1.3065e+04 cal/mol}
  efficiencies: {AR: 0.7, C2H6: 3.0, CH4: 2.0, CO: 1.5, CO2: 2.0, H2: 2.0, H2O: 
      6.0}
  Troe: {A: 0.1527, T3: 291.0, T1: 2742.0, T2: 7748.0}
- equation: O + C3H8 <=> OH + C3H7
  rate-constant: {A: 193.0, b: 2.68, Ea: 3716.0 cal/mol}
- equation: H + C3H8 <=> C3H7 + H2
  rate-constant: {A: 1320.0, b: 2.54, Ea: 6756.0 cal/mol}
- equation: OH + C3H8 <=> C3H7 + H2O
  rate-constant: {A: 3.16e+04, b: 1.8, Ea: 934.0 cal/mol}
- equation: C3H7 + H2O2 <=> HO2 + C3H8
  rate-constant: {A: 0.378, b: 2.72, Ea: 1500.0 cal/mol}
- equation: CH3 + C3H8 <=> C3H7 + CH4
  rate-constant: {A: 9.03e-04, b: 3.65, Ea: 7154.0 cal/mol}
- equation: CH3 + C2H4 (+ M) <=> C3H7 (+ M)
  type: falloff
  high-P-rate-constant: {A: 2550.0, b: 1.6, Ea: 5700.0 cal/mol}
  low-P-rate-constant: {A: 3.0e+57, b: -14.6, Ea: 1.817e+04 cal/mol}
  efficiencies: {AR: 0.7, C2H6: 3.0, CH4: 2.0, CO: 1.5, CO2: 2.0, H2: 2.0, H2O: 
      6.0}
  Troe: {A: 0.1894, T3: 277.0, T1: 8748.0, T2: 7891.0}
- equation: O + C3H7 <=> C2H5 + CH2O
  rate-constant: {A: 9.64e+10, b: 0.0, Ea: 0.0 cal/mol}
- equation: H + C3H7 (+ M) <=> C3H8 (+ M)
  type: falloff
  high-P-rate-constant: {A: 3.613e+10, b: 0.0, Ea: 0.0 cal/mol}
  low-P-rate-constant: {A: 4.42e+55, b: -13.545, Ea: 1.1357e+04 cal/mol}
  efficiencies: {AR: 0.7, C2H6: 3.0, CH4: 2.0, CO: 1.5, CO2: 2.0, H2: 2.0, H2O: 
      6.0}
  Troe: {A: 0.315, T3: 369.0, T1: 3285.0, T2: 6667.0}
- equation: H + C3H7 <=> CH3 + C2H5
  rate-constant: {A: 4060.0, b: 2.19, Ea: 890.0 cal/mol}
- equation: OH + C3H7 <=> C2H5 + CH2OH
  rate-constant: {A: 2.41e+10, b: 0.0, Ea: 0.0 cal/mol}
- equation: HO2 + C3H7 <=> O2 + C3H8
  rate-constant: {A: 2.55e+07, b: 0.255, Ea: -943.0 cal/mol}
- equation: HO2 + C3H7 => OH + C2H5 + CH2O
  rate-constant: {A: 2.41e+10, b: 0.0, Ea: 0.0 cal/mol}
- equation: CH3 + C3H7 <=> 2 C2H5
  rate-constant: {A: 1.927e+10, b: -0.32, Ea: 0.0 cal/mol}
