PURPL-Purdue/Turbopump/Pump Assembly/Final_Assembly_Parameters.txt

"shaft_diameter"= 17mm'main diameter of the shaft (determined by bearing inner diameter)
