PURPL-Purdue/Turbopump/MARLIN V2/Tenkara/4 - Subteams/TCA/Inputs/setpoint_params.yaml

### TCA Setpoints ###
### THIS YAML FILE CONTAINS THE ARRAYS WHITCH ARE CALLED IN SETPOINT.PY ###
### THESE VALUES ARE PRELIMINARY - THE FINAL VALUES ARE FOUND IN TCA_PARAMS.YAML ###

output_directory: Outputs/designs.csv                                                # Output directory for designs.csv

propellants:
  fuel:
    name: "IPA(L)"                                  # Liquid IPA — not in thermo.lib, so built as a custom card.
    formula: {C: 3.0, H: 8.0, O: 1.0}
    molecular_weight: 60.096                        # g/mol
    enthalpy: -318.1                                 # kJ/mol, liquid, 298.15 K
    enthalpy_units: "kJ/mol"                         # matches the documented cea.Reactant example exactly
    temperature: 298.15
  oxidizer: O2(L)                                    # LOx

reactant_T:                                                                          # Reactant Temperatures (K)
  fuel: 298.15
  oxidizer: 90.17

Thrust_array :                                                                       #Target Thrust Array (lbf)
  Min: 1000
  Max: 2500
  Step: 100

Chamber_pressure_array:                                                               #Pressure Array (psi)
  Min: 300
  Max: 700
  Step: 20

# https://usaindustries.com/piping-isolation-testing-products/pipe-schedule-chart/ 
Chamber_diameters_in: [2.900,4.026,5.047,4.813,4.563,4.313,4.063,5.761,5.501,5.189,4.897,3.826]         #Chamber diameters (in)
Chamber_thicknesses_in: [0.3,.237,.258,.375,.500,.625,.750,.432,.562,.719,.864,.337]                #Chamber thicknesses (in)

exit_pressure: 18                                                                     # Exit pressure (psi)
cstar_efficiency: 0.875                                                               # C* efficiency
cf_efficiency: 0.875                                                                  # Cf efficiency
L_star: 1                                                                             # Characteristic length (m)
alpha_divergence: 45.0                                                                # Divergence half-angle (degrees)
of_ratio: 1                                                                         # O/F ratio 

max_L : 0.5                                                                           # Maximum length (m)
min_L : 0.3                                                                           # Minimum length (m)
max_D : 0.5                                                                           # Maximum diameter (m)
