PURPL-Purdue/Turbopump/MARLIN V2/Tenkara/4 - Subteams/Pumps/Inputs/InputsNEW.yaml

N_shaft: [35000, 'rpm']
    
LOX:
  feed_pressure: [100, 'psi']
  mass_flow: [2.03, 'kg/s']
  discharge_pressure: [43.41, 'bar']

IPA:
  feed_pressure: [100, 'psi']
  mass_flow: [2.15, 'kg/s']
  discharge_pressure: [54.97, 'bar']
