PURPL-Purdue/Turbopump/(commit log)

2024-09-22 Create Cold gas nozzle.mlx
2024-09-25 Accomodate changes to Cold gas nozzle equation script
2024-09-29 Update Cold Gas Nozzle Calculations
    Equations to generate cross sectional area data from mach number
2024-10-01 Newest Cold Gas Nozzle code
    This is the newest most polished most refurbished most coolest. The goal is to be able to plot cross sectional area as a function of distance along the nozzle using mach number calculations.
2024-10-03 Rename 9281K575_Mechanical Pump Shaft Seal with Extended Spring.SLDPRT to Test1_Shaft_Seal.SLDPRT
    [Test1_Shaft_Seal.SLDPRT]
2024-10-03 CAD models of GG chamber
    [GasGeneratorChamberV1.SLDPRT, GasGeneratorChamberV2.SLDPRT]
2024-10-04 GG Chamber V3 Model
    has some parametric modelling stuff now
    [GasGeneratorChamberV3.SLDPRT]
2024-10-04 Cold Gas Nozzle Software
    This should be the last iteration, it calculates dimensions of our nozzle based on parameters (Only for conical nozzle of 15 degrees).
2024-10-04 Delete Turbine Assembly/Rotor And Stator/Software/Cold gas nozzle.mlx
    I am getting rid of the extra files I uploaded
2024-10-04 Create GasGeneratorChamberV5.SLDPRT
    GG Chamber V5 has 45 degree angled turbulence ring
    [GasGeneratorChamberV5.SLDPRT]
2024-10-05 Create Test Nozzle v1.0.SLDPRT
    [Test Nozzle v1.0.SLDPRT]
2024-10-13 Added pump team files and organized
    [10.10 LOX pump test stand impeller (unshrouded).STEP, 10.3 LOX pump test stand_Co1.stp, 10.3 LOX pump test stand_Co2.stp, 10.3 kerosene test stand2_Co1.stp, 10.3 kerosene test stand2_Co2.stp, Test1_Seal_CasingV2.SLDPRT, Test1_Shaft_Seal.SLDPRT, casing_mk3.SLDPRT]
2024-10-13 Create GasGenerator_Injector_V1.SLDPRT
    added gas gen injector cad
    [GasGenerator_Injector_V1.SLDPRT]
2024-10-13 Reorganized pumps folders
    [10.10 LOX pump test stand impeller (unshrouded).STEP, 10.3 LOX pump test stand_Co1.stp, 10.3 LOX pump test stand_Co2.stp, 10.3 kerosene test stand2_Co1.stp, 10.3 kerosene test stand2_Co2.stp, Test1_Seal_CasingV2.SLDPRT, Test1_Shaft_Seal.SLDPRT, casing_mk3.SLDPRT]
2024-10-13 Added pumps global params
    [global_parameters.txt]
2024-10-13 Started naming convention
    [full_assembly.SLDASM]
2024-10-13 added Test1_Shaft file
    [Test1_ShaftV3.SLDPRT]
2024-10-13 changed some names
    [Final_Assembly_Parameters.txt, Full_Final_Assembly.SLDASM]
2024-10-13 Update GasGenerator_Injector_V1.SLDPRT
    updated injector cad
    [GasGenerator_Injector_V1.SLDPRT]
2024-10-13 did some renaming and getting right files there
    [6661K44_Ball Bearing.SLDPRT, Test1_Pump_Casing(old).SLDPRT, Test1_Seal_Casing.SLDPRT, Test1_Seal_CasingV2.SLDPRT, fake_shaft.SLDPRT, test_assembly.SLDASM]
2024-10-13 Kerosene pump outlet volute negative
    [Kerosene_Test_Stand_Outlet_Volute.stp]
2024-10-13 lox outlet volute negative
    [LOX_Pump_Test_Stand_Outlet_Volute.stp]
2024-10-13 update test1_shaft design
    [Test1_ShaftV3.SLDPRT]
2024-10-13 made an assembly for casings
    [Test1_Casing_Assembly.SLDASM, Test1_ShaftV3.SLDPRT]
2024-10-13 Update GasGenerator_Injector_V1.SLDPRT
    updated gas gen injector cad
    [GasGenerator_Injector_V1.SLDPRT]
2024-10-13 Impeller of lox pump
    [LOX_Pump_Test_Stand_Impeller.stp, LOX_Pump_Test_Stand_Inducer.stp]
2024-10-13 made some changes to parts and a
    [GasGenerator_Injector_V1.SLDPRT, LOX_Pump_Test_Stand_Impeller.stp, LOX_Pump_Test_Stand_Inducer.stp]
2024-10-13 Kerosene inducer and impeller positive negative exports
    [Kerosene_Test_Stand_Impeller_Negative.stp, Kerosene_Test_Stand_Impeller_Positive.stp, Kerosene_Test_Stand_Inducer_Negative.stp, Kerosene_Test_Stand_Inducer_Positive.stp]
2024-10-13 Cleaned out old files
    [10.3 LOX pump test stand_impeller_negative.stp, 10.3 LOX pump test stand_inducer_negative.stp, 10.3 kerosene test stand2_Co1.stp, 10.3 kerosene test stand2_Co2.stp]
2024-10-13 fixed names
    [LOX_Pump_Test_Stand_Impeller_Negative.stp, LOX_Pump_Test_Stand_Inducer_Negative.stp]
2024-10-13 did some changes to cad
    [Test1_Casing_Assembly.SLDASM, Test1_Seal_Casing.SLDPRT]
2024-10-13 made some seal casing changes
    [10series_8020.SLDPRT, Test1_Casing_Assembly.SLDASM, Test1_Seal_Casing.SLDPRT]
2024-10-13 Finished Kerosene casing block
    [Kerosene_Casing_Test_Stand.SLDPRT]
2024-10-13 Updated Kerosene casing block
    [Kerosene_Casing_Test_Stand.SLDPRT]
2024-10-13 Added pump reference to kerosene casing
    [Kerosene_Casing_Test_Stand.SLDPRT]
2024-10-13 Create TestStandCAD.SLDASM
    CAD of electric motor test stand.
    [TestStandCAD.SLDASM]
2024-10-13 New FIles
    File organization
    [TestStandCAD.SLDASM]
2024-10-13 Adjusted thicknesses
    [Kerosene_Casing_Test_Stand.SLDPRT]
2024-10-13 added taper and keyway
    [Kerosene_Test_Stand_Impeller_Positive.stp.SLDPRT, Kerosene_Test_Stand_Inducer_Positive.SLDPRT]
2024-10-14 Added positive outlet volute geometry
    [Kerosene_Test_Stand_Outlet_Volute_Negative.stp, Kerosene_Test_Stand_Outlet_Volute_Positive.stp]
2024-10-14 kerosene test casing inlet/outlets added
    [Kerosene_Casing_Test_Stand.SLDPRT]
2024-10-14 Created low rpm test casing assembly
    [Kerosene_Casing_Test_Stand.SLDPRT, Low_RPM_Test_Casing_Assembly.SLDASM]
2024-10-14 not much
    [Test1_Casing_Assembly.SLDASM, Test1_Full_Assembly.SLDASM]
2024-10-14 increased tolerances
    [Kerosene_Casing_Test_Stand.SLDPRT]
2024-10-14 made flanges for the pump casing
    [Kerosene_Casing_Test_Stand.SLDPRT, Low_RPM_Test_Casing_Assembly.SLDASM, Low_RPM_parameters.txt, Test1_Full_Assembly.SLDASM, Test1_Seal_Casing.SLDPRT]
2024-10-15 Create GasGenerator_Injector_V2.SLDPRT
    version 2 of gas gen injector
    [GasGenerator_Injector_V2.SLDPRT]
2024-10-16 Added individual parts used in the test stand CAD assembly.
    [1515 Corner Bracket.SLDPRT, 8020-1515 X 12.SLDPRT, 8020-1515 X 24.SLDPRT, Motor Plate.SLDPRT, TestStandCAD.SLDASM]
2024-10-16 Update Kerosene_Casing_Test_Stand.SLDPRT
    changes flange size
    [Kerosene_Casing_Test_Stand.SLDPRT]
2024-10-16 Cold gas nozzle and mount
    Cold gas thruster and mount for small scale testing
    [TRBP_X0_ColdGasNozzle.SLDPRT, TRBP_X0_ColdGasNozzleMount.SLDPRT]
2024-10-17 added 1/2 npt to assembly
    [0.5 in MPT Steel Pipe Nipple.SLDPRT, Kerosene_Casing_Test_Stand.SLDPRT, Low_RPM_Test_Casing_Assembly.SLDASM]
2024-10-17 Chamber & test nozzle CAD
    MC 10/17 12:55 am
    [GasGeneratorChamberV6.SLDPRT, GasGeneratorChamberV7 10-17.SLDPRT, Test nozzle 10-17.SLDPRT]
2024-10-17 More stand CAD
    Finished motor mounting plate. Integrated plate and motor CAD onto full test stand assembly CAD.
    [Motor Plate.SLDPRT, TestStandCAD.SLDASM, me1117.SLDPRT]
2024-10-17 Added STL file version of motor mount
    [Motor Plate (STL).STL]
2024-10-17 Modified motor plate
    [Motor Plate.SLDPRT]
2024-10-17 Create motor plate step file
    [Motor Plate (STEP).STEP]
2024-10-17 Made changes
    [Kerosene_Casing_Test_Stand.SLDPRT]
2024-10-17 Gas gen v7 chamber
2024-10-18 Added outlet volute fitting area
    [Kerosene_Casing_Test_Stand.SLDPRT, Low_RPM_Test_Casing_Assembly.SLDASM, Test1_Seal_Casing.SLDPRT]
2024-10-18 made some tapers for the pump casing
    [4830K221_Standard-Wall 304 304L Stainless Steel Pipe Nipple.SLDPRT, Kerosene_Casing_Test_Stand.SLDPRT, Low_RPM_Test_Casing_Assembly.SLDASM, Test1_Casing_Assembly.SLDASM, Test1_Seal_Casing.SLDPRT]
2024-10-18 Create GasGenerator_Injector_V5.SLDPRT
    updated gas generator injector cad
    [GasGenerator_Injector_V5.SLDPRT]
2024-10-18 changed names and split the pump casing
    [Kero_Test_Case.SLDPRT, Kero_Test_Case_Female1.SLDPRT, Kero_Test_Case_Male1.SLDPRT, Kerosene_Casing_Test_Stand.SLDPRT]
2024-10-18 made o-ring grooves and assembly
    [-040 O-Ring.SLDPRT, Kero_Test_Case.SLDPRT, Kero_Test_Case_Female1.SLDPRT, Kero_Test_Case_Male1.SLDPRT, Low_RPM_Test_Casing_Assembly.SLDASM, Low_RPM_parameters.txt, Test1_Seal_Casing.SLDPRT]
2024-10-18 made 1/8 in mpt plug in main area
    [1-8in MPT Nipple.SLDPRT, Kero_Test_Case.SLDPRT, Kero_Test_Case_Female1.SLDPRT, Kero_Test_Case_Male1.SLDPRT]
2024-10-18 changed pt hole in casing to be in right spot
    [Kero_Test_Case.SLDPRT, Kero_Test_Case_Female1.SLDPRT, Kero_Test_Case_Male1.SLDPRT]
2024-10-18 moved some files and exported inducer
    [10.10 LOX pump test stand impeller (unshrouded).STEP, Kero_Test1_impeller.stp, Kero_Test1_inducer_thickblades.stp, Kerosene_Test_Stand_Impeller_Negative.stp, Kerosene_Test_Stand_Impeller_Positive.stp, Kerosene_Test_Stand_Inducer_Positive.stp, Kerosene_Test_Stand_Outlet_Volute_Negative.stp, Kerosene_Test_Stand_Outlet_Volute_Positive.stp]
2024-10-18 New Test Stand
    Changes test stand to 3030 series aluminum. Changed motor mount to match those dimensions. Rebuilt TestStandCAD with those parts. Added .stp file of motor plate for manufacturing.
    [1515 Corner Bracket.SLDPRT, 3030 X 12in.SLDPRT, 3030 X 24in.SLDPRT, 8020-1515 X 12.SLDPRT, 8020-1515 X 24.SLDPRT, 8020-30-3030 X 3000.sldprt, 8020-30-4302-BLACK.sldprt, ME1917 Mounting Plate.SLDPRT]
2024-10-19 made some final changes for 3d printing
    [0.25 - 20 x 1.5 screw.SLDPRT, 8020-30-3030 X 300.SLDPRT, Kero_Test_Case.SLDPRT, Kero_Test_Case_Female1.SLDPRT, Kero_Test_Case_Male1.SLDPRT, Test1_Seal_Casing.SLDPRT]
2024-10-19 exported cad to 3mf
    [Kero_Test_Case_Female1.3mf, Kero_Test_Case_Female1.STEP, Kero_Test_Case_Male1.STEP, Test1_Seal_Casing.STEP]
2024-10-19 Exported thickened impeller/inducer combined
    [Kerosene_Test_Stand_impeller_thick_base.stp, Kerosene_Test_Stand_inducer_thick_blades.stp, combined_inducer_impeller.STL, combined_inducer_impeller_solidworks.SLDPRT]
2024-10-19 Fixed impeller base thickness for casing tolerances
    [Kerosene_Test_Stand_Combined.SLDPRT, Kerosene_Test_Stand_impeller_thick_base.stp, Kerosene_Test_Stand_inducer_thick_blades.stp, combined_inducer_impeller.STL, combined_inducer_impeller_solidworks.SLDPRT, kerosene-combined_pump.STEP]
2024-10-20 updated GG cad
    [GasGeneratorChamberV7 10-17.SLDPRT, Test nozzle 10-17.SLDPRT]
2024-10-20 Fixed bearing tolerance
    [Test1_Seal_Casing.SLDPRT]
2024-10-20 Increased impeller gap inside casing
    [Kero_Test_Case.SLDPRT, Kero_Test_Case_Male1.SLDPRT]
2024-10-20 updated cold gas nozzle
    [TRBP_X0_ColdGasNozzle.SLDPRT, TRBP_X0_ColdGasNozzleMount.SLDPRT]
2024-10-20 GG chamber
    [GasGeneratorChamberV7 10-17.SLDPRT]
2024-10-20 Updated Turbine Blade Geometry Code [TODO: Integration with cold gas nozzle]
2024-10-20 Code for Cold Gas Nozzle Geometry
2024-10-20 Turbine Test Stand
    Assembly for turbine test stand
    Changes to cold gas thruster mount
    bearing block for test stand shaft
    [3030 X 12in.SLDPRT, 6661K44_Ball Bearing.SLDPRT, 8020-1515 X 12.SLDPRT, TRBP_X0_ColdGasNozzleMount.SLDPRT, TRBP_X0_TestStandBearingBlock.SLDPRT, TurbineTestStand.SLDASM]
2024-10-21 gg cad
    [GasGeneratorChamberV7 10-20.SLDPRT]
2024-10-22 Create GasGeneratorChamberV7 10-21.SLDPRT
    [GasGeneratorChamberV7 10-21.SLDPRT]
2024-10-22 made a mockup of the final shaft design (WIP)
    [Final_Shaft_Mockup.SLDPRT]
2024-10-23 Test Turbine Hub, Updated Turbine Test Assembly
    Additional minor changes to nozzle mount
    [TRBP_X0_ColdGasNozzleMount.SLDPRT, TRBP_X0_TestTurbineHub.SLDPRT, Test1_Shaft.SLDPRT, TurbineTestStand.SLDASM]
2024-10-23 Added pump thrust calcs
2024-10-25 GG CAD assembly w/ countersunk holes
    [GasGenAssembly.SLDASM, GasGeneratorChamberV7 10-20.SLDPRT, GasGeneratorChamberV7 10-21.SLDPRT, GasGeneratorChamberV8.SLDPRT]
2024-10-25 Chamber and Test nozzle
    [GasGeneratorChamberV7 10-17.SLDPRT, GasGeneratorChamberV7 10-25.SLDPRT, Test nozzle 10-17.SLDPRT]
2024-10-25 gas generator injector v8 created, sizing finalized, co-ordinated with chamber sizing. fitting sizing finalized, threading complete
    [GasGenAssembly 1.SLDASM, GasGenAssembly 2.SLDASM, GasGeneratorChamberV7 10-21.SLDPRT, GasGenerator_Injector_Fittings.SLDASM, GasGenerator_Injector_V8.SLDPRT]
2024-10-25 GG Hole Punch CAD
    [GasGenerator Torch to Chamber Mount.SLDPRT]
2024-10-25 GG Chamber CAD and Torch to Chamber CAD
    [GG Countersunk Bolt Tool 0.25 inch.SLDPRT, GasGenAssembly 1.SLDASM, GasGenerator Torch to Chamber Mount.SLDPRT, GasGeneratorChamberV8 with Countersink.SLDPRT, GasGeneratorChamberV8.SLDPRT]
2024-10-27 injector v9
    [GasGenerator_Injector_V9.SLDPRT]
2024-10-27 gg injector cad v9 updated
    [GasGenAssembly 2.SLDASM, GasGenerator_Injector_V9.SLDPRT]
2024-10-27 injector v9 updated
    [GasGenerator_Injector_V9.SLDPRT]
2024-10-27 Chamber 10-27, alignment pin, gasket
    [98105A079_Undersized Dowel Pin.SLDPRT, GasGeneratorChamberV7 10-25.SLDPRT, GasGeneratorChamberV7 10-27.SLDPRT, Grafoil gasket 10-27.SLDPRT]
2024-10-27 Final kerosene pump for PDR
2024-10-27 Finalized LOX pump for PDR
2024-10-27 alignment pin & chamber
    [98105A079_Undersized Dowel Pin.SLDPRT, 98105A203_Undersized Dowel Pin eighth inch.SLDPRT, GasGeneratorChamberV7 10-27.SLDPRT]
2024-10-28 GG assembly and organization
    [98105A203_Undersized Dowel Pin eighth inch.SLDPRT, GasGenAssembly 1.SLDASM, GasGeneratorChamberV1.SLDPRT, GasGeneratorChamberV2.SLDPRT, GasGeneratorChamberV3.SLDPRT, GasGeneratorChamberV4.SLDPRT, GasGeneratorChamberV5.SLDPRT, GasGeneratorChamberV6.SLDPRT]
2024-10-29 Final Shaft Design Update
    [Final_Shaft_Mockup.SLDPRT]
2024-10-30 Fixed PDR LOX pump
2024-10-30 Exported lox pdr inducer/impeller
    [lox_PDR_impeller_material.stp, lox_PDR_inducer_material.stp]
2024-10-30 Exported Kerosene PDR
    [kerosene_PDR_impeller_material.stp, kerosene_PDR_inducer_material.stp]
2024-10-30 injector v10
    [GasGenerator_Injector_V10.SLDPRT, GasGenerator_Injector_V9.SLDPRT]
2024-10-30 Created MiniTorch
    Started a couple of features for the Gas Generator's Minitorch
    [MiniTorch.SLDPRT]
2024-11-01 Updated Assembly and test nozzle
    10-31(spooky) Miles Cohen
    [92423A536_High-Strength A286 Stainless Steel Socket Head Screw.SLDPRT, 94804A029_Super-Corrosion-Resistant 316 Stainless Steel Hex Nut.SLDPRT, GasGenAssembly 1.SLDASM, GasGeneratorChamberV7 10-27.SLDPRT, GasGenerator_Injector_V10.SLDPRT, Grafoil gasket 10-27.SLDPRT, Test nozzle 10-17.SLDPRT]
2024-11-01 CAD GG
    [GasGenAssembly 1.SLDASM, GasGeneratorChamberV7 10-27.SLDPRT]
2024-11-03 Lox PDR export
    [lox_PDR_impeller_material.stp, lox_PDR_inducer_material.stp]
2024-11-03 updated injector cad and chamber cad
    [GasGeneratorChamberV7 10-27.SLDPRT, GasGenerator_Injector_V10.SLDPRT]
2024-11-03 test nozzle
    [Test nozzle 10-17.SLDPRT]
2024-11-03 Added parameters
    [High_RPM_parameters.txt, lox_PDR_impeller_material.stp, lox_PDR_inducer_material.stp]
2024-11-03 Update Test nozzle 10-17.SLDPRT
    [Test nozzle 10-17.SLDPRT]
2024-11-03 GG chamber and gasket
    [GasGeneratorChamberV7 10-27.SLDPRT, Grafoil gasket 10-27.SLDPRT]
2024-11-03 cold gas test stand with protective shielding
    [TRBP_X0_ColdGasNozzleMount.SLDPRT, TRBP_X0_TestStandBearingBlock.SLDPRT, TRBP_X0_TestStandShield_Side.SLDPRT, teststandv2.SLDASM]
2024-11-03 made vane thickness smaller
    [High_RPM_parameters.txt]
2024-11-03 Fixed lox pump export names
    [kerosene_PDR_impeller_material.stp, kerosene_PDR_inducer_material.stp]
2024-11-03 Added back vanes on lox PDR impeller
    [LOX_PDR_solidpart.SLDPRT]
2024-11-03 Added back vanes on kerosine PDR impeller
    [kerosene_PDR_solid_part.SLDPRT]
2024-11-03 Exported all pump geometries
    [Kero_Test1_impeller.stp, Kero_Test1_inducer_thickblades.stp, Kerosene_PDR_impeller_flow.stp, Kerosene_PDR_inducer_flow.stp, Kerosene_PDR_outlet_volute_flow.stp, Kerosene_PDR_outlet_volute_material.stp, Kerosene_Test_Stand_Combined.SLDPRT, Kerosene_Test_Stand_Impeller_Positive.stp.SLDPRT]
2024-11-03 GG Assembly
    [GasGenAssembly 1.SLDASM, GasGeneratorChamberV7 10-27.SLDPRT, Test nozzle 10-17.SLDPRT]
2024-11-03 fixed kerosene back vanes
    [High_RPM_parameters.txt, kerosene_PDR_solid_part.SLDPRT]
2024-11-03 fixed back vanes on lox pdr impeller
    [LOX_PDR_solidpart.SLDPRT]
2024-11-03 Created shaft integrated backups
    [LOX_PDR_shaft_integrated.SLDPRT, kerosene_PDR_shaft_integrated.SLDPRT]
2024-11-03 exported unintegrated pump components
    [LOX_PDR_impeller_unintegrated_print.STEP, LOX_PDR_inducer_unintegrated_print.STEP, kerosene_PDR_impeller_unintegrated_print.STEP, kerosene_PDR_inducer_unintegrated_print.STEP]
2024-11-03 Shaft integration for Inconel printed pumps
    [LOX_PDR_impeller_integrated.STEP, LOX_PDR_inducer_integrated.STEP, LOX_PDR_shaft_integrated.SLDPRT, kerosene_PDR_impeller_integrated.STEP, kerosene_PDR_inducer_integrated.STEP, kerosene_PDR_shaft_integrated.SLDPRT]
2024-11-06 gg injector
    [GasGenerator_Injector_V10.SLDPRT]
2024-11-06 made a file for sizing things around the shaft for different temperatures
2024-11-06 made a shaft for seal laby seal testing
    [Test1_Shaft.SLDPRT, seal_test_shaft.SLDPRT]
2024-11-08 added some seal testing cad
    [31thou5toothSeal.SLDPRT, SealTestAssembly.SLDASM, seal_test_shaft.SLDPRT]
2024-11-08 updated some stuff (pressure mach distribution)
2024-11-09 Updated MiniTorch
    Added flange and injector orifices
    [MiniTorch.SLDPRT]
2024-11-09 made some more stuff for seal testing
    [-019 O-Ring.SLDPRT, 31thou5toothSeal.SLDPRT, Lip_seal.SLDPRT, SealTestAssembly.SLDASM, Testing_Casing.SLDPRT, seal_test_shaft.SLDPRT]
2024-11-10 made the seal test cad a bit better
    [31thou5toothSeal.SLDPRT, SealTestAssembly.SLDASM, Test_Casing_Inlet.SLDPRT, Testing_Casing.SLDPRT, seal_test_shaft.SLDPRT]
2024-11-10 added drawio for seal assembly
2024-11-10 new injector, with face design
    [GasGenerator_Injector_V11.SLDPRT]
2024-11-15 shaft integration
    [LOX Shaft Integration Example.SLDASM, LOX_PDR_shaft_integrated.SLDPRT, PDR_Shaft_Mockup.SLDPRT]
2024-11-17 Moved shaft files to separate folder, added integrated shaft assembly
    [3x3x14_Machine Key.SLDPRT, Integrated Assembly.SLDASM, LOX Shaft Integration Example.SLDASM, LOX_PDR_shaft_integrated.SLDPRT, LOx Bearing.SLDASM, PDR_Shaft.SLDPRT, PDR_Shaft_Mockup.SLDPRT, PDR_Shaft_Sleeve.SLDPRT]
2024-11-17 turbine test stand version 2
    [8020-30-4302-BLACK.sldprt, ME1917 Mounting Plate.SLDPRT, TRBP_X0_TestTurbineHub.SLDPRT, TurbineTestStand.SLDASM]
2024-11-17 made some seal testing CAD and solme calculations for leakage rate
    [31thou5toothSeal.SLDPRT, SealTestAssembly.SLDASM, SealTestAssembly2.SLDASM, Test_Casing_Inlet.SLDPRT, Testing_Casing.SLDPRT, outside insert.SLDPRT, seal_on_shaft.SLDPRT, seal_test_shaft.SLDPRT]
2024-11-17 Created low speed stand model assembly .
    [Kero_Test_Case_Female1.SLDPRT, Kero_Test_Case_Male1.SLDPRT, ME1917 Mounting Plate Drawing.SLDDRW, ME1917 Mounting Plate.SLDPRT, Test1_Seal_Casing.SLDPRT, TestStandCAD.SLDASM, kerosene_PDR_solid_part.SLDPRT]
2024-11-17 GG chamber and nozzle
    [GasGeneratorChamberV7 10-27.SLDPRT, Test nozzle 10-17.SLDPRT]
2024-11-17 Update GasGenAssembly 1.SLDASM
    [GasGenAssembly 1.SLDASM]
2024-11-17 injector cad update
    [GasGenerator_Injector_V11.SLDPRT]
2024-11-17 GG CAD Assembly Mate
    [GasGenAssembly 1.SLDASM]
2024-11-17 GG Chamber Washer CAD
    [Washer 0.27 ID 0.38 OD.SLDPRT]
2024-11-17 Update Washer 0.27 ID 0.38 OD.SLDPRT
    [Washer 0.27 ID 0.38 OD.SLDPRT]
2024-11-17 GG CAD Update
2024-11-17 fix rotor geometry
2024-11-18 Washers too
    [Test nozzle 10-17.SLDPRT, Washer 0.27 ID 0.38 OD (Bolt).SLDPRT, Washer 0.44 OD 0.27 ID (Nut).SLDPRT]
2024-11-18 made cad for ips and laby leakage calcs
    got some code for leakage calcs and made into a function, so it could still be usefull
    [IPS_Casing.SLDPRT, IPS_assembly.SLDASM, Seal_insert.SLDPRT, shaft_seal_section.SLDPRT]
2024-11-18 update hotfire and cold gas code with tables
    [ColdGas-gas_values.csv, ColdGas-nozzle_values.csv, ColdGas-structure_values.csv, ColdGas-turbine_values.csv, HotGas-gas_values.csv, HotGas-nozzle_values.csv, HotGas-structure_values.csv, HotGas-turbine_values.csv]
2024-11-18 GG chamber and washers
    [GasGeneratorChamberV7 10-27.SLDPRT, Washer 0.27 ID 0.38 OD (Bolt).SLDPRT, Washer 0.44 OD 0.27 ID (Nut).SLDPRT]
2024-11-18 Washer GG CAD
    [Washer 0.27 ID 0.44 OD (Nut).SLDPRT]
2024-11-18 made some cad changes for the ip seal
    [-019 O-Ring.SLDPRT, 31thou5toothSeal.SLDPRT, IPS_Casing.SLDPRT, IPS_assembly.SLDASM, Lip_seal.SLDPRT, SealTestAssembly.SLDASM, SealTestAssembly2.SLDASM, Seal_insert.SLDPRT]
2024-11-18 added spline
    [Integrated Assembly.SLDASM, LOX_PDR_shaft_integrated.SLDPRT, PDR_Shaft.SLDPRT, PDR_Shaft_Sleeve.SLDPRT, kerosene_PDR_shaft_integrated.SLDPRT]
2024-11-19 smaller bolt holes, added clearance
    [PDR_Shaft_Sleeve.SLDPRT]
2024-11-19 Changed Test stand assembly
    [Full Pump assembly with casing.SLDASM, Full_Final_Assembly.SLDASM, Integrated Assembly.SLDASM, LOX_PDR_shaft_integrated.SLDPRT, kerosene_PDR_shaft_integrated.SLDPRT]
2024-11-19 changed dimensions
    [PDR_Shaft_Sleeve.SLDPRT]
2024-11-19 Created the full power turbine
    Added the hot gas turbine that will run the pump. Just a sample for now since the values have to be finalized.
    [TRBP_FullPowerRotor.SLDPRT]
2024-11-19 added cad for seal testing
    [IPS_Casing_test.SLDPRT, Seal_insert_test.SLDPRT, Seal_test_shaft.SLDPRT, TRBP_X0_TurbineLabySeal.SLDPRT, Test_Casing_Inlet.SLDPRT, Test_assembly.SLDASM]
2024-11-19 update some code to fix table generation
    [ColdGas-turbine_values.csv, HotGas-turbine_values.csv]
2024-11-19 changed some cad and got rid of temporary files
    [IPS_Casing.SLDPRT, IPS_assembly.SLDASM]
2024-11-19 cad for tubine leakage
    [TRBP_X0_TurbineLabySeal.SLDPRT]
2024-11-20 Revert "injector"
    This reverts commit b83f58a5300065b4460cfab0285713fe9bb91f25.
    [GasGenerator_Injector_V10.SLDPRT]
2024-11-20 Reapply "injector"
    This reverts commit 123e0d240655ebf25fe9284d990b8f8bfb5fd9aa.
    [GasGenerator_Injector_V10.SLDPRT]
2024-11-20 Updated turbine rotor interface
    Added an alignment feature, added bolt holes
    [TRBP_FullPowerRotor.SLDPRT]
2024-11-20 slight code change
    [shaft_seal_section.SLDPRT]
2024-11-20 Added blades to turbine
    Final turbine version for PDR
    [TRBP_FullPowerRotor.SLDPRT]
2024-11-20 added turbine integration
    [92620A406_Zinc Yellow-Chromate Plated Hex Head Screw.SLDPRT, LOX_PDR_shaft_integrated.SLDPRT, PDR_Shaft.SLDPRT, PDR_Shaft_Sleeve.SLDPRT, kerosene_PDR_shaft_integrated.SLDPRT]
2024-11-20 updated manifold prototype
    [manifoldprototype.SLDPRT]
2024-11-21 made inlet for ox side/testing
    [50715K836_37 Degree Flared Fitting for Stainless Steel Tubing.SLDPRT, AN_fitting_inlet.SLDPRT]
2024-11-30 Exported Post PDR Pump Geometries
    [Kerosene_PDR_impeller_flow.stp, Kerosene_PDR_inducer_flow.stp, Kerosene_PDR_outlet_volute_flow.stp, Kerosene_PDR_outlet_volute_material.stp, LOX_PDR_shaft_integrated.SLDPRT, LOX_PDR_solidpart.SLDPRT, kero_postPDR_impeller_material.stp, kero_postPDR_inducer_material.stp]
2024-12-02 added kerosene impeller back vanes
    [kero_postPDR_combined_pump.SLDPRT]
2024-12-02 added lox impeller back vanes
    [lox_postPDR_combined_pump.SLDPRT]
2024-12-18 aomw things ig
    [AN-4 fitting.SLDPRT, IPS_Casing.SLDPRT, IPS_assembly.SLDASM, Seal_insert.SLDPRT]
2024-12-19 Prototype volute cad
    [Kero_Outlet_Volute.SLDPRT]
2024-12-19 Edited IPS casing
    made ed
    [IPS_Casing.SLDPRT, IPS_assembly.SLDASM, Seal_insert.SLDPRT, shaft_seal_section.SLDPRT]
2024-12-20 some cad changes
    [IPS_assembly.SLDASM, Seal_insert.SLDPRT, cfd_sketch.SLDPRT, shaft_seal_section.SLDPRT]
2024-12-22 updated ips casing
    [IPS_Casing.SLDPRT, IPS_Casing2.SLDPRT, IPS_assembly.SLDASM, Seal_insert.SLDPRT, orb to -4an fitting.SLDPRT, shaft_seal_section.SLDPRT]
2024-12-27 machined stator and turbine shroud models
    [TRBP_X0_Stator.SLDPRT, TRBP_X0_TurbineShroud.SLDPRT]
2024-12-28 minor modifications to stator
    [TRBP_X0_Stator.SLDPRT]
2024-12-31 added o-rings to seal inset
    [IPS_assembly.SLDASM, Seal_insert.SLDPRT, shaft_seal_section.SLDPRT]
2025-01-04 created a sketch for cfd
    [cfd_sketch2.SLDPRT]
2025-01-10 cfd stuff
    added a CFD report for loxpump, and modified a sketch for leakage rates
    [Half_casing.SLDPRT, StaticSealTestCasing.SLDPRT, cfd_sketch2.SLDPRT]
2025-01-18 updated seal test components
    [Seal_Test_insert.SLDPRT, Static_test_assembly.SLDASM, Test_Casing_Inlet.SLDPRT, shaft_seal_section.SLDPRT]
2025-01-19 Added nx versions
    [nx_kero_casing.prt, nx_lox_casing.prt]
2025-01-21 started transitioning cad to nx
    [1918_ir.prt, 1918_or.prt, 1918_roller.prt, AN_fitting_inlet.x_t, Pumps-1_IPS_assembly.prt, Pumps_0_LabyIPS_Section.prt, Seal_Test_insert.SLDPRT, Static_test_assembly.SLDASM]
2025-01-21 Models moved to NX
    [TRBP_TurbineLabSeal.prt, TRBP_TurbineShroud.prt, TRBP_TurbineStator.prt]
2025-01-21 Turbine Manifold Seals
    [TRBP_ManifoldGasket.prt, TRBP_StatorSeal.prt]
2025-01-22 added injector test piece cad
    [GasGenerator_Injector_Test.SLDPRT]
2025-01-22 made seal insert cad in nx
    [Pumps-1_IPS_assembly.prt, Pumps_0_LabyIPS_Section.prt, Pumps_0_SealInsert.prt, Pumps_2_LoxBearing.prt, UseThisOne.prt]
2025-01-27 test manifold and turbine assembly
    [TRBP_ManifoldGasket.prt, TRBP_StatorSeal.prt, TRBP_TurbineLabSeal.prt, TRBP_TurbineShroud.prt, TRBP_TurbineStator.prt, TRBP_testassembly.prt, TRBP_testmanifold.prt]
2025-01-27 getting better nx cad for ips
    [IPS_assembly.SLDASM, Pumps-1_IPS_assembly.prt, Pumps_0_IPScasing.prt, Pumps_0_SealInsert.prt]
2025-01-28 Full power rotor V2
    New rotor with larger diameter, improved hub geometry and parametrized blades in NX
    [TRBP_FullPowerRotor.prt]
2025-01-28 NX version of shaft with seals WIP
    [Seal Integration Test Shaft.prt]
2025-01-28 dimension update to turbine assembly
    [TRBP_FullPowerRotor.prt, TRBP_StatorSeal.prt, TRBP_TurbineLabSeal.prt, TRBP_TurbineShroud.prt, TRBP_TurbineStator.prt, TRBP_testassembly.prt, TRBP_testmanifold.prt]
2025-01-29 added gasgen inlet to test manifold
    still require parametrization
    [TRBP_StatorSeal.prt, TRBP_TurbineLabSeal.prt, TRBP_TurbineShroud.prt, TRBP_TurbineStator.prt, TRBP_testassembly.prt, TRBP_testmanifold.prt]
2025-01-29 some changes to nx assembly
    [IPS_assembly.SLDASM, Pumps-1_IPS_assembly.prt, Pumps_0_SealInsert.prt]
2025-01-30 added ports to the nx version of the ips casing
    [1918_ir.prt, 1918_or.prt, 1918_roller.prt, Pumps-1_IPS_assembly.prt, Pumps_0_IPScasing.prt, Pumps_0_LabyIPS_Section.prt, Pumps_0_SealInsert.prt, Pumps_2_.25inchAN_fitting.STEP]
2025-01-31 old files
    [LOx_Nut.STEP, Seal Integration Test Shaft.prt, full_assembly_wip.prt]
2025-01-31 Delete Turbine Assembly/Rotor And Stator/Software/Cold_gas_nozzle_V2.mlx
    waste of space
2025-01-31 Delete Turbine Assembly/Rotor And Stator/Software/Cold_gas_nozzle_V3.mlx
    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
2025-02-01 Test nozzle and chamber
    [GasGenAssembly 1.SLDASM, GasGeneratorChamberV7 10-27.SLDPRT, Test nozzle 10-17.SLDPRT]
2025-02-01 Grafoil gasket
    [GasGeneratorChamberV7 10-27.SLDPRT, Grafoil gasket 10-27.SLDPRT]
2025-02-01 Adding Step File
    [TRBP_FullPowerRotor.stp]
2025-02-02 New Rotor Design
    Changes to rotor design hopefully usable
    [TRBP_FullPowerRotorModified.prt]
2025-02-03 STEP file for CAM
    [Seal Integrated Shaft.prt, Shaft_MachiningTest_Feb3.stp]
2025-02-04 Added fillets with temporary dimensioning
    [TRBP_FullPowerRotorModified.prt]
2025-02-05 gasgen cad update
    [GasGenerator Injector 02-04.SLDPRT, GasGenerator_Injector_V10.SLDPRT, GasGenerator_Injector_Visual.SLDPRT]
2025-02-05 renaming parts
    [1918_ir.prt, 1918_or.prt, 1918_roller.prt, 2300_ir.prt, 2300_or.prt, 2300_roller.prt, SKF_7003 CDGA_HCP4A.prt, SKF_7201 CDGA_HCP4A.prt]
2025-02-08 rotor assembly
    [3554N14_Carbon Steel Bearing Retaining Nut.STEP, 3554N14_Carbon Steel Bearing Retaining Nut_step.prt, SKF_7201 CDGA_HCP4A.prt, Shaft_Assembly_2-4-2025.prt, Shaft_LoxSpacer_1-30-2025.prt, Shaft_Shaft_2-3-2025.prt, Shaft_Sleeve_2-4-2025.prt, TRBP_FullPowerRotorModified.prt]
2025-02-08 some minor changes to cad and naming
    [Pumps-1_IPS_assembly.prt, Pumps_0_IPScasing.prt, Pumps_0_SealInsert.prt, Pumps_IPScasing_2-3-2025.prt, Pumps_LabyIPSsection_1-29-2025.prt, Pumps_SealInsert_2-2-2025.prt, cfd_3d section.SLDPRT]
2025-02-09 Added new dimensions and shape
    [TRBP_FullPowerRotorModified.prt]
2025-02-09 Added new dimensions to turbine
    [TRBP_FullPowerRotorModified.prt]
2025-02-09 Added 8020 extrusion CATIAV5 files
    [8020-1010 X 12.CATPART, 8020-1010 X 24.CATPART, 8020-1010 X 36.CATPART, 8020-1010 X 48.CATPART, 8020-1010 X 6.CATPART]
2025-02-09 Added motor and pump placeholder CAD
    [3030 X 12in.SLDPRT, 3030 X 24in.SLDPRT, 8020-1515 X 12.SLDPRT, 8020-30-3030 X 3000.sldprt, 8020-30-4302-BLACK.sldprt, Full Pump assembly with casing.SLDASM, ME1917 Mounting Plate Drawing.SLDDRW, ME1917 Mounting Plate.SLDPRT]
2025-02-10 some minor cad changes
    [Pumps-1_IPS_assembly.prt, Pumps_2_LoxBearing.prt, Pumps_IPScasing_2-3-2025.prt, Shaft_Assembly_2-4-2025.prt, cfd_3d section.SLDPRT]
2025-02-11 Added testing assembly
    [8020-1010 X 36_catpart.prt, assembly1.prt]
2025-02-11 Added k bottles and fluids panel
    [4AN to 6AN Fitting v1.prt, 5154T116_OIL-RESISTANT SHAFT SEAL v1.prt, 91290A113_Black-Oxide Alloy Steel Socket Head Scr.prt, 91290A168_BLACK-OXIDE CLASS 12.9 SOCKET HEAD CAP SCREW v1(Mirror).prt, 91290A168_BLACK-OXIDE CLASS 12.9 SOCKET HEAD CAP SCREW v1.prt, Casing.prt, Component4.prt, F020 80 Shaft - C003.prt]
2025-02-11 stator with modified gemetry and added flange to lox casing
    [TRBP_LOX_Casing_v2.prt, TRBP_TurbineStatorV2.prt]
2025-02-12 Changed geometry of Rotor
    Added linear section of the rotor cross section and added nonlinear merge to tangent for connection and proper max yeild.
    [TRBP_FullPowerRotorModified.prt]
2025-02-12 integrated pumps
    [kero_impeller_integrated_2-11-2025.prt, kero_inducer_integrated_2-11-2025.prt]
2025-02-12 pump integration
    [lox_impeller_integrated_2-11-2025.prt, lox_inducer_integrated_2-11-2025.prt]
2025-02-12 Test stand assembly updates
    [2in_Drum Plug Dust Cap.IGS, 2in_Drum Plug Dust Cap.SLDPRT, 2in_Drum Plug Dust Cap.STEP, 4AN to 6AN Fitting v1.prt, 5154T116_OIL-RESISTANT SHAFT SEAL v1.prt, 55 Gal Closed Top Plastic Drum.IGS, 55 Gal Closed Top Plastic Drum.x_t, 8020-1010 X 12_catpart.prt]
2025-02-15 New shroud and updated stator
    [TBRP_ShroudV2.prt, TRBP_TurbineStatorV2.prt]
2025-02-15 Stator Blade Geometry
    [Stator_Blade_Geometry.dxf, TBRP_ShroudV2.prt, TRBP_StatorSeal.prt, TRBP_TurbineStatorV2.prt]
2025-02-15 File Reorganization
    [92423A536_High-Strength A286 Stainless Steel Socket Head Screw.SLDPRT, 94804A029_Super-Corrosion-Resistant 316 Stainless Steel Hex Nut.SLDPRT, GasGenerator Injector 02-04.SLDPRT, GasGeneratorChamberV7.SLDPRT, Grafoil gasket.SLDPRT]
2025-02-15 moving files
    [KeroBearing_2-15-2025.prt, LOxBearing_2-15-2025.prt, LOxNut_2-7-2025.prt, Shaft_2-8-2025.prt, Sleeve_2-8-2025.prt]
2025-02-15 Stator assembly and blade geometry
    [StatorBlade_V2.dxf, TBRP_ShroudV2.prt, TBRP_StatorAssembly.prt, TRBP_TurbineStatorV2.prt]
2025-02-15 Modified stator parameters
    [TBRP_StatorAssembly.prt, TRBP_TurbineStatorV2.prt]
2025-02-15 Turbine hub dimensions
    [Sleeve_2-8-2025.prt]
2025-02-17 updated casing cad
    [Pumps_IPS_-4_fitting.prt, Pumps_IPSassembly_2-17-2025.prt, Pumps_IPScasing_2-17-2025.prt]
2025-02-17 some final cad updates
    [Pumps_IPSassembly_2-17-2025.prt, Pumps_IPScasing_2-17-2025.prt]
2025-02-19 more cad changes!
    [Pumps_IPScasing_2-18-2025.prt]
2025-02-22 Added RP-1 Inlet Flange NXprt flie
    Not sure what the naming convention is. Dimensions are not final but should be easy to change via user expressions/parameters.
    [RP1_Inlet_Flange.prt]
2025-02-22 integration features
    [Rotor_Shaft_2-8-2025.prt]
2025-02-22 file moving
    [Rotor_LOxNut_2-22-2025.STEP, Rotor_LOxNut_2-22-2025_step.prt, kero_impeller_integrated_2-11-2025.prt, kero_inducer_integrated_2-11-2025.prt, lox_impeller_integrated_2-11-2025.prt]
2025-02-22 Updated hub dimensions
    [TRBP_FullPowerRotorModified.prt]
2025-02-22 Updated bolt holes
    [TRBP_FullPowerRotorModified.prt]
2025-02-22 Delete Full Assembly/RP1 Casing Subassembly/RP1_Inlet_Flange.prt
    File was made in NX 2306 and is incompatible. NX 2027 version of the model has already been created.
    [RP1_Inlet_Flange.prt]
2025-02-22 Added NX 2027 version of RP1 Inlet Flange
    Replaced NX 2306 version
    [RP1_Inlet_Flange.prt]
2025-02-22 gas generator .prt added
    [GasGenerator Injector 02-04.SLDPRT, GasGeneratorInjector_02-22.STEP, GasGeneratorInjector_02-22.prt]
2025-02-22 Added and foldered relevant files for RP1 Inlet
    [RP1_Inlet_Flange.prt, [AN-16]nut_reference.STEP, [AN-16_MALE_FITTING].STEP, [AN-16_MALE_FITTING].prt, [SIZE 6 SCREW]92185A151_Super-Corrosion-Resistant 316 Stainless Steel Socket Head Screw.STEP]
2025-02-22 Updated RP1 Inlet Flange
    Added and parameterized O-Ring groove feature on the flange disk. O-Ring dimensions are not finalized.
    [RP1_Inlet_Flange.prt]
2025-02-22 added rotor assembly
    [Rotor_Assembly_2-22-2025.prt, Rotor_Shaft_2-8-2025.prt]
2025-02-22 updated ips geometry
    [Pumps_IPScasing_2-22-2025.prt]
2025-02-23 ips changes
    [Pumps_IPScasing_2-22-2025.prt]
2025-02-24 gas gen injector update
    [GasGenerator Injector 02-04.SLDPRT, GasGeneratorInjector_02-24.SLDPRT]
2025-02-24 fixing constraints
    [Rotor_Assembly_2-22-2025.prt]
2025-02-24 Added PBF preparation
    [kero_impeller.prt, kero_impeller_forPBF.stp]
2025-02-24 Added Full Assembly
    [FullAssembly_RevA.prt, Pumps_IPSassembly_2-17-2025.prt, Pumps_IPScasing_2-18-2025.prt, Pumps_IPScasing_2-21-2025.prt, Pumps_IPScasing_2-22-2025.prt, Rotor_Assembly_2-22-2025.prt, Rotor_Shaft_2-8-2025.prt, TBRP_StatorAssembly.prt]
2025-02-25 Revert "Added Full Assembly"
    This reverts commit cc3c5639675d04813d16bd25317600f03a00c4f1.
    [FullAssembly_RevA.prt, Pumps_IPSassembly_2-17-2025.prt, Pumps_IPScasing_2-18-2025.prt, Pumps_IPScasing_2-21-2025.prt, Pumps_IPScasing_2-22-2025.prt, Rotor_Assembly_2-22-2025.prt, Rotor_Shaft_2-8-2025.prt, TBRP_StatorAssembly.prt]
2025-02-25 Added New Assemblies
    [FullAssembly_RevA.prt, FullAssembly_RevB.prt, kero_casing_2_24_2025 (1).prt, lox_casing.prt]
2025-02-25 Update FullAssembly_RevB.prt
    Put all of the casings on the assembly
    [FullAssembly_RevB.prt]
2025-02-25 Summary
    Added new turbine parts from archive to the turbine assembly folder
    [FullAssembly_RevB.prt, TBRP_ShroudV2.prt, TBRP_StatorAssembly.prt, TRBP_StatorSeal.prt, TRBP_TurbineStatorV2.prt]
2025-02-25 Summary
    Changed dimensions in LOX, RP1, and IPS casing to accommodate the full assembly
    [FullAssembly_RevB.prt, Pumps_IPScasing_2-22-2025.prt, kero_casing_2_24_2025 (1).prt, lox_casing.prt]
2025-02-25 Fixing integration
    [Rotor_Assembly_2-22-2025.prt, Rotor_Shaft_2-8-2025.prt, Rotor_Sleeve_2-15-2025.prt]
2025-02-25 Summary
    Added Bolt Holes to Both the Ox and RP1 casings
    [FullAssembly_RevB.prt, Pumps_IPScasing_2-22-2025.prt, kero_casing_2_24_2025 (1).prt, lox_casing.prt]
2025-02-25 Summary
    Changed Kero Part
    [FullAssembly_RevB.prt, kero_casing_2_24_2025 (1).prt]
2025-02-25 update ips casing a little
    [Pumps_IPScasing_2-22-2025.prt]
2025-02-25 made newer ips casing
    [Pumps_IPScasing_2-25-2025.prt]
2025-02-25 Revert "update ips casing a little"
    This reverts commit 3390d1c37992dea29b8c251729b580767f2971a4.
    [Pumps_IPScasing_2-22-2025.prt]
2025-02-26 Summary
    Changing RP1 casing to not interfere with rotor
    [FullAssembly_RevB.prt, kero_casing_2_24_2025 (1).prt, kero_inducer_integrated_2-11-2025.prt]
2025-02-26 moved turbine rotor to final location
    [TRBP_FullPowerRotor.prt]
2025-02-26 Summary
    Adjusting IPS 0225 and lox casing
    [FullAssembly_RevB.prt, Pumps_IPScasing_2-25-2025.prt, lox_casing.prt]
2025-02-26 Summary
    Changed a lot of dimensions on the kerocasing. I used synchronous modeling to get through changes quickly. Will probably need to remake part with updated sketches
    [FullAssembly_RevB.prt, Pumps_IPScasing_2-25-2025.prt, Rotor_Assembly_2-22-2025.prt, TBRP_StatorAssembly.prt, kero_casing_2_24_2025 (1).prt, lox_casing.prt]
2025-02-26 keyway dimension
    [lox_inducer_integrated_2-11-2025.prt]
2025-02-27 Back vane geometry (wip)
    [lox_impeller_integrated_2-11-2025.prt]
2025-02-27 minor ips changes
    [FullAssembly_RevB.prt, Pumps_IPScasing_2-25-2025.prt]
2025-02-27 gg injector update, step file added to full assembly
    [GasGeneratorInjector_02-22.STEP, GasGeneratorInjector_02-22.prt, GasGeneratorInjector_02-24.SLDPRT, GasGeneratorInjector_02-27.SLDPRT, GasGeneratorInjector_02-27.STEP]
2025-02-27 Updated turbine stator and lox casing
    [Pumps_LOXcasing_2-27-2025.prt, Turbine_stator_2-27-2025.prt]
2025-02-28 New Gas Gen
    [92423A536_High-Strength A286 Stainless Steel Socket Head Screw.SLDPRT, 94804A029_Super-Corrosion-Resistant 316 Stainless Steel Hex Nut.SLDPRT, GasGeneratorChamberV7.SLDPRT, Grafoil gasket.SLDPRT, TRBP_GasGenerator_Chamber.prt, TRBP_GasGenerator_Chamber_AN.prt, TRBP_Grafoil_gasket.prt]
2025-02-28 Updating integration features
    [lox_impeller_integrated_2-11-2025.prt, lox_inducer_integrated_2-11-2025.prt]
2025-02-28 port modifications
    [FullAssembly_RevB.prt, Pumps_IPScasing_2-25-2025.prt, Stainless Steel Socket Head Screw 10-32.STEP, Stainless Steel Socket Head Screw 10-32_step.prt]
2025-02-28 made some more ips changes
    NOTE: I changed the shaft in the seal section, it should be the same length, but the labyrinth geometry should stay how it is.
    [FullAssembly_RevB.prt, Pumps_IPScasing_2-25-2025.prt, Rotor_Assembly_2-22-2025.prt, Rotor_Shaft_2-8-2025.prt]
2025-02-28 a couple changes to ips
    [FullAssembly_RevB.prt, Pumps_IPScasing_2-25-2025.prt, Rotor_Shaft_2-8-2025.prt]
2025-03-04 Summary
    Created new assembly CAD RevC. A lot of discrepancies with LOX casing, and what we need for tolerances. Going to bed though
    [FullAssembly_RevC_20250303.prt, Pumps_IPScasing_2-25-2025.prt, Rotor_Assembly_2-22-2025.prt, TBRP_StatorAssembly.prt, TRBP_FullPowerRotor.prt, kero_impeller_integrated_2-11-2025.prt]
2025-03-04 for 3d print
2025-03-04 new lox casing and stator
    [Pumps_LOXcasing_2-27-2025.prt, Pumps_LOXcasing_3-4-2025.prt, Turbine_stator_3-4-2025.prt]
2025-03-04 Summary
    Continued to change 3rd assembly and Kero casing
    [FullAssembly_RevC_20250303.prt, TBRP_StatorAssembly.prt, Turbine_stator_3-4-2025.prt, kero_casing_2_24_2025 (1).prt]
2025-03-04 some small changes ig
    [FullAssembly_RevA.prt, FullAssembly_RevB.prt, Pumps_IPScasing_2-25-2025.prt, Pumps_IPScasing_3-1-2025.prt, Rotor_Assembly_2-22-2025.prt]
2025-03-04 some ips casing changes
    [Pumps_IPScasing_2-25-2025.prt, Pumps_IPScasing_3-1-2025.prt, Pumps_IPScasing_3-4-2025.prt]
2025-03-05 Summary
    Updated IPS casing to accommodate LOX casing, changed geometry of RP1 casing as well
    [FullAssembly_RevC_20250303.prt, Pumps_IPScasing_2-25-2025.prt, Pumps_LOXcasing_3-4-2025.prt, Turbine_stator_2-27-2025.prt, kero_casing_2_24_2025 (1).prt]
2025-03-05 gg update
    [GasGeneratorInjector_02-27.SLDPRT, GasGeneratorInjector_03-04.SLDPRT, TRBP_GasGenerator_Injector_step.prt]
2025-03-05 gg update, archive and assembly
    [GasGeneratorInjector_02-27.SLDPRT, GasGeneratorInjector_02-27.STEP, GasGeneratorInjector_03-04.SLDPRT, GasGeneratorInjector_03-04.STEP, GasGeneratorInjector_03-04_step.prt, TRBP_GasGenerator_ GrafoilGasket.prt, TRBP_GasGenerator_Injector.STEP, TRBP_GasGenerator_Injector.prt]
2025-03-05 updated shaft diameter to match a drill size
    [FullAssembly_RevB.prt, Pumps_IPScasing_3-4-2025.prt, Rotor_Assembly_2-22-2025.prt, Rotor_Shaft_2-8-2025.prt, kero_inducer_integrated_2-11-2025.prt, orb_fitting_feature.prt]
2025-03-05 Updated length
    [Rotor_Shaft_2-8-2025.prt]
2025-03-06 Updated dimensions
    [Rotor_Shaft_2-8-2025.prt]
2025-03-06 ips updates
    [Pumps_IPScasing_3-1-2025.prt, Pumps_IPScasing_3-4-2025.prt, Pumps_IPScasing_3-5-2025.prt]
2025-03-06 Assembly updates
    [Rotor_3-18SleeveNut_3-6-2-2025.prt, Rotor_Assembly_2-22-2025.prt, Rotor_Shaft_2-8-2025.prt, Rotor_Sleeve_2-15-2025.prt, TRBP_FullPowerRotor.prt, kero_impeller_integrated_2-11-2025.prt, lox_impeller_integrated_2-11-2025.prt]
2025-03-07 some changes ig
    [FullAssembly_RevB.prt, FullAssembly_RevC_20250303.prt, Pumps_IPScasing_2-25-2025.prt]
2025-03-07 Summary
    Update Kerocasing and RevC assembly
    [FullAssembly_RevC_20250303.prt, kero_casing_2_24_2025 (1).prt]
2025-03-08 gas generator overhaul
    [GasGeneratorInjector_03-04 - Save.SLDPRT, GasGeneratorInjector_03-04.SLDPRT, GasGeneratorInjector_03-04.STEP, GasGeneratorInjector_03-04_step.prt, GasGenerator_Injector_Test.SLDPRT, GasGenerator_Injector_Visual.SLDPRT, TRBP_GasGenerator_Injector_V4.prt]
2025-03-08 Summary
    New Assembly
    [2447K29_Easy-Adapt Clevis Rod End_step.prt, 5000lbf_engine_temp_3_7_2025.prt, 6071K31_Clevis Rod End_step.prt, FullAssembly_RevD_20250307.prt, Pumps_IPScasing_3-5-2025.prt, Rotor_Assembly_2-22-2025.prt, TBRP_StatorAssembly.prt, kero_casing_2_24_2025 (1).prt]
2025-03-08 Update RP1_Inlet_Flange.prt
    Switched to female fitting
    [RP1_Inlet_Flange.prt]
2025-03-09 added kero casing
    [Pumps_LOXcasing_3-8-2025_10;40PM.prt, kero_casing_3_8_2025.prt]
2025-03-09 Summary
    Added faces for pre printing and made new assembly
    [FullAssembly_RevE_20250309.prt, Pumps_IPScasing_3-5-2025.prt, Pumps_LOXcasing_3-8-2025.prt, Rotor_Assembly_2-22-2025.prt, TBRP_StatorAssembly.prt, kero_casing_3_8_2025.prt]
2025-03-10 some ips changes, 3-10 i smost recent
    [FullAssembly_RevE_20250309.prt, Pumps_IPScasing_3-10-2025.prt, Pumps_IPScasing_3-5-2025.prt]
2025-03-10 Added LoxInlet, Removed RP1_Inlet
    [LoxInlet.prt, REFERENCE_50715K265_37 Degree Flared Fitting for Stainless Steel Tubing.prt, RP1_Inlet_Flange.prt, [AN-16]nut_reference.STEP, [AN-16_MALE_FITTING].STEP, [AN-16_MALE_FITTING].prt, [SIZE 6 SCREW]92185A151_Super-Corrosion-Resistant 316 Stainless Steel Socket Head Screw.STEP]
2025-03-11 Summary
    Made parameterized flange and added all pt ports
    [FullAssembly_RevE_20250309.prt, Pumps_IPScasing_3-5-2025.prt, Rotor_Assembly_2-22-2025.prt]
2025-03-11 moved file
    [Pumps_IPScasing_3-10-2025.prt]
2025-03-11 some cad stuffs
    [Pumps_IPScasing_3-10-2025.prt, Pumps_LoxSidePressureCap_3-11-2025.prt, Pumps_SealTestAssembly_3-11-2025.prt, Rotor_Assembly_2-22-2025.prt]
2025-03-12 Summary
    Changed R1 Casing
    [FullAssembly_RevE_20250309.prt, Turbine_stator_3-4-2025.prt]
2025-03-14 Update LoxInlet.prt
    Matched flange with LOX Casing
    [LoxInlet.prt]
2025-03-29 Impellers ready for PBF export
    [kero_impeller_forPBF.stp, lox_impeller_forPBF.stp]
2025-03-29 pbf export nx files too
    [kero_impeller.prt, kero_impeller_PBFpart.prt, lox_impeller_PBFpart.prt]
2025-03-31 seal test parts
    [Pumps_FuelSidePressureCap_3-11-2025.prt, Pumps_SealTestAssembly_3-11-2025.prt]
2025-04-01 ips testing
    ips testing parts made
    [91251A245_Black-Oxide Alloy Steel Socket Head Screw.STEP, 91251A245_Black-Oxide Alloy Steel Socket Head Screw_step.prt, Pumps_FuelSidePressureCap_3-11-2025.prt, Pumps_IPSassembly_2-17-2025.prt, Pumps_IPScasing_3-10-2025.prt, Pumps_LoxSidePressureCap_3-11-2025.prt, Pumps_O-ringCap_3-31-2025.prt]
2025-04-04 updated casings for printing
2025-04-08 ips insert
    [FullAssembly_RevE_20250309.prt, TBRP_StatorAssembly.prt]
2025-04-12 Updated LOX Inlet
    Applied O-ring dimensions based on McMaster-Carr 9559K154
    [LoxInlet.prt]
2025-04-12 New assembly revision, miscellaneous casings edits
    [91841A011_18-8 Stainless Steel Hex Nut_sldprt.prt, FullAssembly_RevF_20250309.prt]
2025-04-12 Updated LOX Inlet
    [LoxInlet.prt, REFERENCE_50715K265_37 Degree Flared Fitting for Stainless Steel Tubing.prt]
2025-04-14 redid ips ports and made a sub assembly for ips
    [An_-4_nut.STEP, An_-4_nut_step.prt, FullAssembly_RevF_20250309.prt, IPS_subassembly.prt, Pumps_IPScasing_3-5-2025.prt, Pumps_IPScasing_4-12-2025.prt, Pumps_IPScasing_4-8-2025.prt]
2025-04-14 minor changes
    [FullAssembly_RevF_20250309.prt]
2025-04-17 new assembly revision
    [FullAssembly_RevF_20250309.prt, FullAssembly_RevG_20250417.prt, TBRP_StatorAssembly.prt]
2025-04-18 casings update
    [FullAssembly_RevG_20250417.prt]
2025-04-18 Update Flange
    [TBRP_Shroud_4_15.prt]
2025-04-19 small copy
    [Pumps_IPScasing_4-12-2025 - Copy.prt]
2025-04-19 Updated Lox Inlet
    AS 5202 port -> SAE J1926 port
    [LoxInlet.prt, ORB_fitting_50695K76.prt]
2025-04-20 Suppressed reference ORB fitting
    [LoxInlet.prt]
2025-04-26 Updates to casing, new assembly revision
    [FullAssembly_RevH_20250425.prt, Rotor_Assembly_2-22-2025.prt]
2025-04-28 Updated loxInlet PMI
    Also added imported O-ring part as reference (suppressed)
    [LoxInlet.prt]
2025-04-28 LoxInlet -> NX2077 instead of NX2306
    [9559K154_Ultra-Chemical-Resistant Rigid PTFE O-Ring.prt, LoxInlet.prt, ORB_fitting_50695K76.prt, REFERENCE_50715K265_37 Degree Flared Fitting for Stainless Steel Tubing.prt]
2025-05-01 reference models for ports, new fuel casing revision
    [dash12_reference.prt, dash16_reference.prt, dash20_reference.prt, dash4_reference.prt]
2025-06-01 as printed features
2025-06-08 minor integration fixes to ips
    [FullAssembly_RevG_20250417.prt, FullAssembly_RevH_20250606.prt, Pumps_Clocking_Assembly_4-19-2025.prt, Pumps_IPScasing_4-19-2025.prt]
2025-06-08 Casing Updates
    [FullAssembly_RevH_20250425.prt, FullAssembly_RevH_20250606.prt, Rotor_Assembly_2-22-2025.prt, dash2_reference.prt, dash4_reference.prt]
2025-06-08 as printed casings
2025-06-18 Updated velocity triangles on hardware
    [TRBP_FullPowerRotor.prt, Turbine_stator_3-4-2025.prt]
2025-06-21 minor changes to prevent errors when switching between as printed and as machined
2025-06-21 Updated Turbine stator to 1.25lb mdot
    [Turbine_stator_3-4-2025.prt]
2025-06-21 Assembly changes
    [FullAssembly_RevH_20250606.prt, Rotor_Assembly_2-22-2025.prt, TBRP_StatorAssembly.prt]
2025-06-22 added nut holder
2025-06-25 increased size of gg inlet, improve nut fixtures
2025-06-27 updated nut retainment
2025-07-04 PreCDR changes to the power assembly
    [90152A150_Stainless Steel Wire-Lockable Socket Head Screws.prt, 90152A233_Stainless Steel Wire-Lockable Socket Head Screws.prt, 90152A234_Stainless Steel Wire-Lockable Socket Head Screws.prt, 92141A222_18-8 Stainless Steel Washer.prt, FullAssembly_RevH_20250606.prt, Rotor_Assembly_2-22-2025.prt, TBRP_Shroud_4_15.prt, TBRP_StatorAssembly.prt]
2025-09-07 Added Seals Reference Assembly
    For seals documentation; check README file.
    [FullAssembly_RevH_20250606.prt, SealsRefAssembly.prt]
2025-09-07 Reorganized LOX Casing
    Put old revisions into an archive folder, and added LOX inlet to the casing subassembly (previously missing).
    [Pumps_LOXcasing_2-27-2025.prt, Pumps_LOXcasing_3-4-2025.prt]
2025-09-07 Hid LOX inlet WCS, Updated Seals Ref
    [LoxInlet.prt, SealsRefAssembly.prt]
2025-09-07 Update FullAssembly_RevH_20250606.prt
    Replaced LOX Casing subassembly, updated to newest version
    [FullAssembly_RevH_20250606.prt]
2025-09-14 Updated SealsRefAssembly
    [LoxInlet.prt, SealsRefAssembly.prt]
2025-09-24 slightly changed a full assembly file
    [FullAssembly_RevH_20250606.prt]
2025-10-01 reorganization of CAD files
    [2447K29_Easy-Adapt Clevis Rod End_step.prt, 5000lbf_engine_temp_3_7_2025.prt, 6071K31_Clevis Rod End_step.prt, 90152A150_Stainless Steel Wire-Lockable Socket Head Screws.prt, 90152A233_Stainless Steel Wire-Lockable Socket Head Screws.prt, 90152A234_Stainless Steel Wire-Lockable Socket Head Screws.prt, 91251A245_Black-Oxide Alloy Steel Socket Head Screw.STEP, 91251A245_Black-Oxide Alloy Steel Sock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]
2025-10-10 Added ANSYS Named Selections
    Created named selection instances (integration with ANSYS). Does not affect geometry.
    [Rotor_Shaft_2-8-2025.prt, SealsRefAssembly.prt]
2025-10-19 Mockups Of Inducers And Impellers
    This is a mockup of the inducers and impellers. The thickness should be good, but they can be changed. I just made up some numbers.
    [LOxInducerImpellerCombined.prt, LOxInducerImpellerMockup.prt, keroimpellermockup.prt]
2025-10-19 For loxinducerimpeller
    huh
    [lox_2.6.25_Co2_stp.prt, lox_2.6.25_Co3_stp.prt]
2025-10-21 Added measurements
    I need it for doing simulations
    [Rotor_Shaft_2-8-2025.prt]
2025-10-21 Single Section Laby test Rig
    [91251A245_Black-Oxide Alloy Steel Socket Head Screw.STEP, 91251A245_Black-Oxide Alloy Steel Socket Head Screw_step.prt, An_-4_nut.STEP, An_-4_nut_step.prt, Fuel_O-ring.STEP, Fuel_O-ring_step.prt, IPS_subassembly.prt, Inlet_casing.prt]
2025-10-22 Rotor measurements
    [Rotor_Assembly_2-22-2025.prt, Rotor_LOXBearingNut_3-8-2025.prt, TRBP_FullPowerRotor.prt]
2025-10-25 Updated Rotor Assembly
    [Rotor_3-18SleeveNut_3-6-2-2025.prt, Rotor_Assembly_2-22-2025.prt, Rotor_KeroBearingNut_4-8-2025.prt, Rotor_KeroBearing_2-15-2025.prt, Rotor_LOXBearingNut_3-8-2025.prt, Rotor_LOxBearing_2-15-2025.prt, Rotor_LOxNut_2-7-2025.prt, Rotor_Shaft_2-8-2025.prt]
2025-10-30 Create Pump Rotor Components
2025-10-30 some cad stuff ig
    [Inlet_casing.prt, Outlet_Casing.prt, Pumps_IPS_-4_fitting.prt, Single_section_Shaft.prt, Single_section_test_assembly.prt, socket_screw_0.25_20x1_sldprt.prt]
2025-10-31 Create KeroWearRing_10.9.25.prt
    2 wear rings
    [KeroWearRing_10.9.25.prt, Kero_wear_ring_next_to_IPS.prt]
2025-10-31 Initial LOX impeller blank
    LOX impeller created and added to assembly
    [FullAssembly_RevH_20250606.prt, LOx_Impeller_Integration.prt, Rotor_Assembly_2-22-2025.prt]
2025-10-31 Created Kero impeller
    Added impeller to assembly
    [FullAssembly_RevH_20250606.prt, KERO_Impeller_Integration.prt, Rotor_Assembly_2-22-2025.prt]
2025-11-02 Rotorshaft Split Face
    [Rotor_KeroBearing_2-15-2025.prt, Rotor_Shaft_2-8-2025.prt]
2025-11-02 LOX Pump CFD Volumes
    - CFTurbo must export the flow domain
    - Actual volute Flow Domain Provided in seperate file
2025-11-02 Split Face Shaft
    [Rotor_Assembly_2-22-2025.prt, Rotor_KeroBearing_2-15-2025.prt, Rotor_LOxBearing_2-15-2025.prt]
2025-11-02 LOx Blank w/ Lab Seals
    Updated LOx Blank to include lab seals
    [LOx_Impeller_Integration.prt]
2025-11-02 Updated Kero Impeller
    Added Labby Seals
    [KERO_Impeller_Integration.prt]
2025-11-02 Fix impeller position
    Fix the position of the shaft assembly
    [KERO_Impeller_Integration.prt, Rotor_Assembly_2-22-2025.prt]
2025-11-03 Wear Ring Parametrized
    As in the title
    [KeroWearRing.prt, KeroWearRingsIPS.prt, loxwearring.prt, loxwearringips.prt]
2025-11-03 ips_test section cad
    [Inlet_Casing2.prt, Outlet_Casing.prt, Single_section_test_assembly.prt, Test_assembly_with_insert.prt, Test_section_insert.prt]
2025-11-04 slapped o-rings on insert
    [Test_section_insert.prt]
2025-11-04 Kero Impeller Fluid Volume Integration
    Created an assembly to integrate the fluid volume and subtract it from the blank. Need to add holes for the shaft/shroud and adjust alignment with labys.
    [KERO_Impeller_Integration.prt, fluid_volume_kero_impeller.prt, kero_impeller_assembly_fluid_integration.prt]
2025-11-05 low fidelity v2 casing
    [casing_v2.prt, volute.stp, volute_stp.prt]
2025-11-05 LOx Blank w/ Fluid Volume Subtracted
    LOx Blank w/ Fluid volume subtracted
    [LOx_Impeller_Integration.prt, assembly1.prt, lox_2025_feb1_Co2_stp.prt]
2025-11-05 LOx Impeller Wrapped up CAD
    CAD Done
    [LOx_Impeller_Integration.prt]
2025-11-05 saved lox impeller to be safe
    [LOx_Impeller_Integration.prt]
2025-11-05 Kero Impeller final
    subtracted the fluid volume and cut out key holes and shaft
    [KERO_Impeller_Integration.prt, kero_impeller_assembly_fluid_integration.prt]
2025-11-07 Wear Ring Change and Full Assembly Update
    As it says, revert the full assembly if it fucked
    [FullAssembly_RevH_20250606.prt, KeroWearRing.prt, KeroWearRing_10.9.25.prt, KeroWearRingsIPS.prt, loxwearring.prt, loxwearringips.prt]
2025-11-07 KERO_Impeller_Blade_Edge_Blend
    Added edge blend to blades
    [KERO_Impeller_Integration.prt]
2025-11-07 Added fillets on impeller roots and tips
    Added fillets on impeller roots and tips
    [LOx_Impeller_Integration.prt]
2025-11-09 Updated pump YAML error
    Max and Min tank pressures were input wrong
2025-11-12 MAKE SURE EVERYTHING ELSE IS UPDATED CHAT
    MAKE SURE EVERYTHING ELSE IS UPDATED CHAT
    Updated stuff for wear ring stuff
    [KeroWearRing.prt, KeroWearRingsIPS.prt, Pumps_IPScasing_4-19-2025.prt, loxwearring.prt, loxwearringips.prt]
2025-11-13 Whatever The Fuck
    [FullAssembly_RevH_20250606.prt, KeroWearRing.prt, KeroWearRingsIPS.prt, kero_inducer_integrated_2-11-2025.prt, loxwearring.prt, loxwearringips.prt]
2025-11-13 Kero and LOx inducer clearance and fillets
    Subtracted material from inducer blades to match clearances in notion, added 25 thou fillets to kero inducer
    [FullAssembly_RevH_20250606.prt, Rotor_Assembly_2-22-2025.prt, SealsRefAssembly.prt, kero_inducer_integrated_2-11-2025.prt, lox_inducer_integrated_2-11-2025.prt]
2025-11-14 gas generator cad file update
    [TRBP_GasGenerator_Injector_V1.5.prt, TRBP_GasGenerator_Injector_V2.0.prt]
2025-11-16 bolt calcs
    [Test_assembly_with_insert.prt, Test_section_insert.prt]
2025-11-16 Sai Schange
    Blah
    [KeroWearRing.prt, KeroWearRingsIPS.prt, Pumps_IPScasing_4-19-2025.prt, loxwearring.prt, loxwearringips.prt]
2025-11-16 gas gen injector cad update
    [TRBP_GasGenerator_Injector_V1.5.prt, TRBP_GasGenerator_Injector_V2.0.prt, TRBP_GasGenerator_Injector_V2.0_TEST.prt]
2025-11-16 New Wear Ring thickness
    [loxwearring.prt]
2025-11-19 Updated Contour DXF Export
    [combined_curve.dxf, nozzle_contour.csv]
2025-11-19 KERO_Impeller_Unfinished_Draft
    Unfinished CAD Drawing
    [KERO_Impeller_Integration.prt]
2025-11-19 Moved files around TCA file
    [combined_curve.dxf, nozzle_contour.csv]
2025-11-19 Updated dxf to mm not m
    [combined_curve.dxf, nozzle_contour.csv]
2025-11-19 Adjusted export path of csv,dxf
    [combined_curve.dxf, nozzle_contour.csv]
2025-11-19 changing from m to mm
    [combined_curve_update.dxf]
2025-11-19 updating L*
    [combined_curve_update.dxf, nozzle_contour.csv]
2025-11-19 Updated Bearings
    [Rotor_KeroBearing_2-15-2025.prt, Rotor_LOxBearing_2-15-2025.prt]
2025-11-21 Suppressed Old Kero-Impeller
    [Rotor_Assembly_2-22-2025.prt]
2025-11-21 Partitioned Shaft Based on Bearings
    [Rotor_Assembly_2-22-2025.prt, Rotor_Shaft_2-8-2025.prt]
2025-11-21 Updated RotorAssembly
    [KERO_Impeller_Integration.prt, LOx_Impeller_Integration.prt, Rotor_3-18SleeveNut_3-6-2-2025.prt, Rotor_Assembly_2-22-2025.prt, Rotor_KeroBearingNut_4-8-2025.prt, Rotor_KeroBearing_2-15-2025.prt, Rotor_LOXBearingNut_3-8-2025.prt, Rotor_LOxBearing_2-15-2025.prt]
2025-11-23 Updating Contour and Dimension Exports
    [combined_curve_update.dxf, dimensions.csv, nozzle_contour.csv, nozzle_contour.dxf]
2025-11-24 Deleted Measurement Features in Rotor Assembly
    It was too cluttered
    [Rotor_Assembly_2-22-2025.prt, Rotor_Shaft_2-8-2025.prt]
2025-11-26 rerun of dimension script
    [nozzle_contour.dxf]
2025-11-26 added annotated contour plot, in inches
    [nozzle_contour.dxf]
2025-11-29 change
    change
    [TCA\Countour Exports\nozzle_contour.csv, TCA\Countour Exports\nozzle_contour.dxf]
2025-11-29 update l* and cr
    [dimensions.csv]
2025-11-29 updated inches contour plot
    [nozzle_contour.csv, nozzle_contour.dxf]
2025-11-29 updating fonts on graph
    [nozzle_contour.dxf]
2025-11-29 updating graph
    [nozzle_contour.dxf]
2025-12-01 adding angles to plot
    [nozzle_contour.dxf]
2025-12-01 updating radii on contour graph
    [nozzle_contour.dxf]
2025-12-05 bartz stuff
    [barts_values.csv]
2025-12-06 Small error in the pumps mdot calculation fix
2025-12-07 updating dxf to spline
    [nozzle_contour.dxf]
2025-12-13 Contraction ratio 4.5
    [TCA\Countour Exports\nozzle_contour.csv, TCA\Countour Exports\nozzle_contour.dxf, TCA\Dimensions CSV\dimensions.csv]
2025-12-27 Update fmt.Println message from 'Hello' to 'Goodbye'
2025-12-28 Update print statement from 'Hello' to 'Goodbye'
2026-02-01 Replace impinge_fraction with impinge_distance
    [TCA_params.yaml]
2026-02-01 Adding OF ratio range test for Thrust
2026-02-15 adding path switching
2026-02-15 rerun contour
    [nozzle_contour.csv, nozzle_contour_new.dxf]
2026-02-15 5.189" CC diam cont
    [nozzle_contour.csv, nozzle_contour_new.dxf]
2026-03-05 March 26 test campaign generational lock in pump curves
2026-03-05 Add Horsepower Surface vs+ python visual script
    Note, only the one called turbine_readable_horsepower_surface.csv has units because the other 3 are data files to help with the visualization
    [turbine_hp_surface.csv, turbine_off_design_mdot_range.csv, turbine_off_design_rpm_range.csv, turbine_readable_horsepower_surface.csv]
2026-03-05 Fix units of mass flow in post analysis plot to lbm/s
    Convert mass flow rate from kg/s to lbm/s.
2026-04-01 VR sensor RPM measurement algorithm
2026-04-13 GG Torch Pressure Code
    [turbine_hp_surface.csv, turbine_off_design_mdot_range.csv, turbine_off_design_rpm_range.csv, turbine_readable_horsepower_surface.csv]
2026-04-15 rerun ipa contour
    [nozzle_contour.csv, nozzle_contour.dxf]
2026-04-22 Pump performance curves for setpoint analysis
    CSVs and codes for obtaining setpoint values
    [Kero_jetA_20000_60000_combo.csv, Kero_water_combo.csv, LOx_LN2_25000_55000_combo.csv]
2026-05-25 The Great Turbopump Restructuring of Summer 2026 (colorized)
    [-019 O-Ring.SLDPRT, -040 O-Ring.SLDPRT, 0.25 - 20 x 1.5 screw.SLDPRT, 0.5 in MPT Steel Pipe Nipple.SLDPRT, 1-8in MPT Nipple.SLDPRT, 10.10 LOX pump test stand impeller (unshrouded).STEP, 10series_8020.SLDPRT, 1918_ir.prt]
2026-05-25 Adding Torch feed pressure mapping scripts
2026-05-31 Updated Heatmap Codes
2026-06-02 added cons F on Tc map, updated heatmap funcs
    changed heatmap functions to take Pexit instead of Pratio, now one can pass in the exit pressure and get a performance map for a non-ideal expansion engine
2026-08-18 Reorganized the whole workflow
    no pepe this time :(
    Included all the final scripts as well as the yamls and the outputs in each corresponding folder. That way as you work in the TCA folder, you can execute each script separately and the files will be red and written from the corresponding folder.
    [Contour_CFD.iges, contour.csv, contour.dxf, designs.csv, designs.xlsx, mass_fractions.xlsx, nozzle_contour2600-600psi.csv, properties.csv]
2026-08-19 Bartz
    Updated some yamls, and then written some codes to generate thermal propreties that will be used in the thermal analysis
    [contour.csv, contour.dxf, hg_profile.csv, positions.csv, properties.csv, turbopump_poly_coeffs.csv]
2026-08-24 Cooling Codes Setup
    [pyvenv.cfg]
2026-08-25 New update Dani
    [ansys_input.csv, ansys_input2.csv, contour.csv, contour.dxf, designs.csv, hg_profile.csv, positions.csv, properties.csv]
2026-08-27 new stuff
    [designs.csv]
2026-08-29 more tca stuff
    [ansys_input2.csv, contour.csv, contour.dxf, properties.csv]
2026-08-31 Adding MIE Refactored code from Luis
    [_vs_OF.csv, vs_OF.csv]
2026-09-01 Flange Sizing Code and Bolt Refprop
2026-09-01 Removed redundant gpio output pin
    Removed the second gpio I was not using
2026-09-07 Added 5k Torch Archive for new member reference
    [PT_COTS-FIT_02X02-F5OX-SS.step, SP_COTS-MISC_SparkPlug.step, TCA_Igniter_dims.csv, TCA_NEW_IGNITER.step, TCA_Torch_Chamber.f3d, TCA_Torch_Igniter.f3d, TC_COTS_FIT_SS-200-1-2ST.step, Torch BOM.xlsx]
2026-09-07 Flange Sizing Script Update, IPA Propellant Change
    [contour.csv, contour.dxf, designs.csv]
2026-09-07 ADC bootcamp milestone
    Wired potentiometer to ADC to turn on GPIO LED based on voltage threshold read by ADC.
2026-09-09 rerun of torch sizing
    [vs_OF.csv]
2026-09-09 PWM output bootcamp project
    PWM output to an LED based on ADC input from a potentiometer, experimented with ARR & Prescalar values to see the frequency (flickering vs static LED) change visually.
2026-09-09 Bug fixes
    [ansys_input2.csv, contour.csv, contour.dxf, properties.csv]
2026-09-10 new cea into torch sizing
    [TCA_Igniter_dims.csv]
2026-09-10 running torch sizing
    [TCA_Igniter_dims.csv]
2026-09-12 Injector Sizing
    [injector_parameters.csv]
2026-09-13 Pump performance initial commit
2026-09-14 Added output print
2026-09-18 Velocity Triangles
2026-09-19 adapted for liquid IPA cea card
    [contour.csv, contour.dxf, designs.csv]
2026-09-19 Abstracting pump specific work
2026-09-19 Power consumption calc
2026-09-19 Changed geometry parameters
    Blade angle and shaft RPM
2026-09-20 final flange sizing, transient thermal data added and plotted
    [ansys_input2.csv, ansys_input_zeros.csv, contour.dxf, contour_dxf.prt, properties.csv]
2026-09-21 Added inlet velocities
    No preswirl assumption
2026-09-21 Implement IPA pump and adjust inlet diameter calc
2026-09-22 Create Marlin V1 Secondary Flow.gfssp
2026-09-23 Adding GGIE script
    [GG_hardware_definition.yaml, _vs_OF.csv, vs_OF.csv]
2026-09-23 Adding GG torch sizing code
    [GG_hardware_definition.yaml, _vs_OF.csv, vs_OF.csv]
2026-09-23 Started film cooling script
    [GG_hardware_definition.yaml]
2026-09-24 added inlet velocity triangle -inducer -(working on outlet)
2026-09-25 Added python-converted transient function and the required .csv file
    [hp_surface_n2.csv]
2026-09-27 Fixed film cooling code
    [GG_hardware_definition.yaml, vs_OF.csv]
2026-09-27 New GG definition values
    [GG_hardware_definition.yaml]
2026-09-28 Updated GG hardware Definition
    [GG_hardware_definition.yaml]
2026-09-30 HELP ME
    [ansys_input2.csv]
2026-09-30 torch shiii
    [ansys_input_torch.csv, ansys_input_torch_zeros.csv, properties_torch.csv]
2026-10-01 rerun torch
    [TCA_Igniter_dims.csv, ansys_input_torch.csv, ansys_input_torch_zeros.csv, properties_torch.csv]
2026-10-02 inducer velocity triangle param pull from inducer.py
2026-10-02 DONE TORCH STUFF - FIXED ERRORS
    [ANSYS_jet_h.csv, TCA_Igniter_dims.csv, properties.csv, properties_torch.csv]
2026-10-02 sizing code adjust
    [TCA_Igniter_dims.csv]
2026-10-04 Added functionality to water testing NPSHr script
    Added mdot calculation and atmospheric pressure point
2026-10-09 Added CSTAR efficiency to evap sim
    [GG_hardware_definition.yaml, vs_OF.csv]
2026-10-12 Average meridional velocity distribution
2026-10-12 Meridional Potential Flow FEM
2026-10-13 Removed passage area and average velocity subplot
2026-10-14 Leading Edge Velocity Triangle
2026-10-14 Updated Velocity Triangle Plotting
2026-10-14 Initial Velocity Triangle Sweep
2026-10-15 Velocity API Refactor
2026-10-18 duc - velocity triangles inducer
    velocity triangles - meanline geometry
2026-10-19 Removing prints
2026-10-19 Added radial thrust calc function for single volute
2026-10-20 Print removal
2026-10-23 Inlet Velocity Triangles with Blockage
2026-10-23 Diffuser length and static pressure out functions
2026-10-23 Velocity triangle plotting refactor
2026-10-23 Pump specific speeds
2026-10-24 Updated velocity triangle incidence
2026-10-25 Pump 1D bug fix
    Changed fixed mass flow to mass flow calculated based on given volumetric flow rate
2026-10-27 Added meridional 'SubCurve'
    For ease of cropping streamlines. Especially since streamlines span the whole FEM domain (beyond the impeller alone). The subcurve representing the impeller flow can be created by cropping the full domain streamline with the leading and trailing edge curve (intersections are computed internally).
2026-10-28 gg test matrix calculator update, added orifice insert CdAs to hardware definition
2026-10-28 Adjust film cooling script to acount for insert orifice CdAs from hardware definition
2026-11-01 Inducer blade edge CAD
2026-11-01 Working assembly
2026-11-01 Created common CAD helper
2026-11-02 heat transfer gui stuff
2026-11-03 Saved impeller CAD files
2026-11-07 Added temperature rise calculation
2026-11-07 Calc volute pressure gradients
2026-11-07 print velocity out of diffuser
2026-11-09 Suction and pressure side init cad
2026-11-09 Working CAD, suction and pressure surfaces
2026-11-09 Finite thickness blade CAD
2026-11-09 CAD export single part
2026-11-14 Better impeller CAD export
