PURPL-Purdue/Turbopump/(notices)

Notices in the files:
MARLIN V2/MARLIN ECU/Software/Embedded bootcamp/ADCreading/adc_single_single/ADC-singleconversion-singlechannel/Core/Src/main.c:
Copyright (c) 2026 STMicroelectronics.
All rights reserved.
This software is licensed under terms that can be found in the LICENSE file
